bismarx-v1/GPS-Compass/_media/renders/GPS-Compass_assembly_plexi2.png

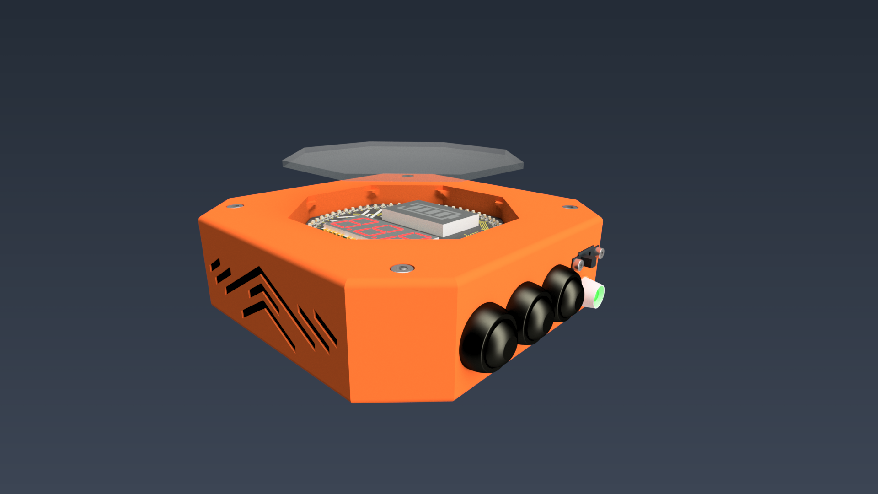
_media/renders/GPS-Compass_assembly_plexi2.png
