bismarx-v1/GPS-Compass/README.md

# GPS Compass
this compass points to a specific locations a user defines, it has two pointers, one for distance and another one for the specified locations
