bismarx-v1/GPS-Compass/_DMP/DMP - Popov.pptx

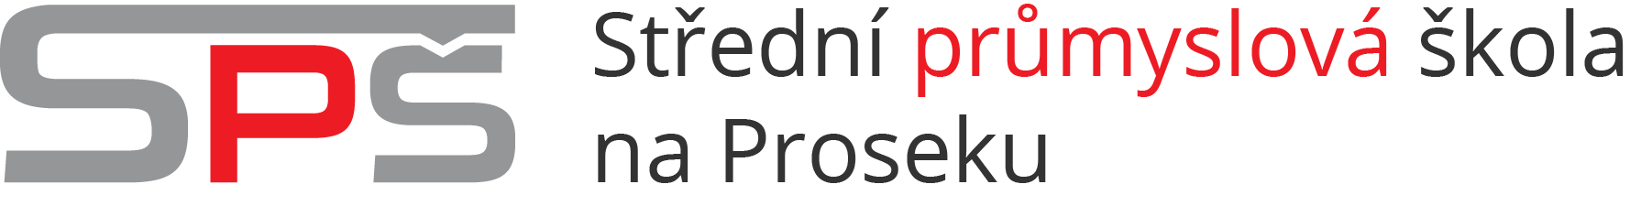
[picture p3: figure]
Obsah obrázku text, Písmo, snímek obrazovky, symbol Obsah vygenerovaný umělou inteligencí může být nesprávný.

NÁVRHY DLOUHODOBÉ MATURITNÍ PRÁCE

Savva Popov

## SEZNAM NÁVRHŮ

1. FINCA - Flight Integration and Navigation Control Architecture
2. GPS Tracker
3. Bearing pointer - Bound compasses
4. The Desire compass
5. SPGA – Self Playing Guitar and Amplifier
6. Protogen Visor
7. LIDAR Scanner

## 1. FINCA - Flight Integration and Navigation Control Architecture

- Flight Control Computer - letový řídicí počítač (Rozpracovaný návrh)
- Hlavní funkce:
- Stabilizace letu: Měření dát z gyroskopu, akcelerometru a podle toho upravuje výstupný signál na motorech
- Zpracovaní dat od pilota (Remote control)
- Komunikace s pilotem/ground station, posílání dát zpět – telemetrie

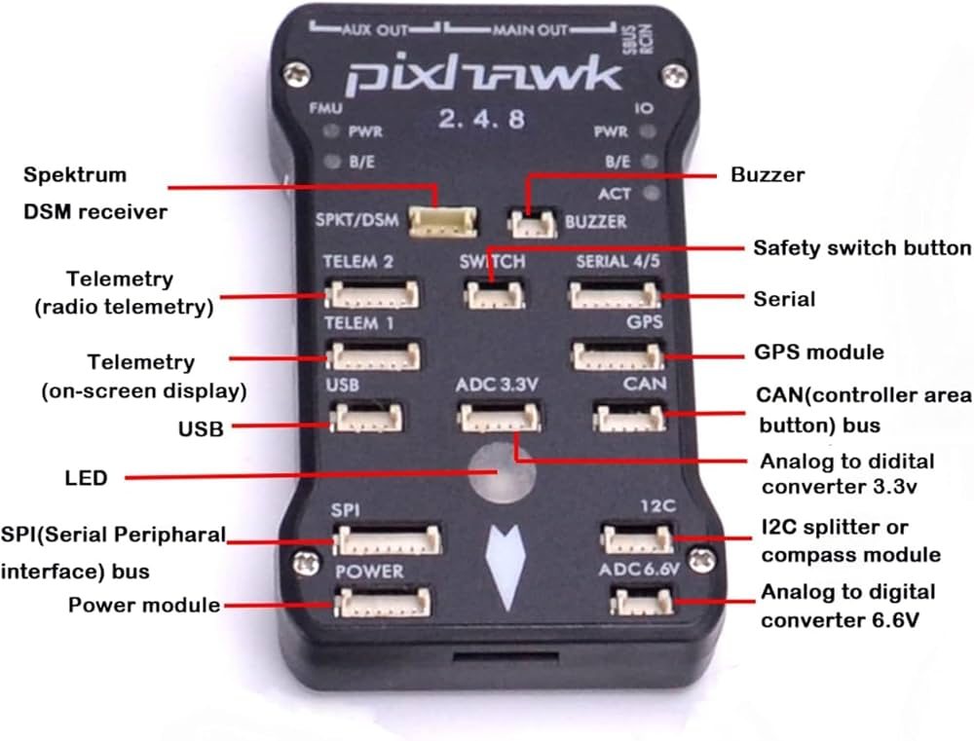
[picture p4: figure]
Technotrade Pixhawk 2.4.8 Drone Flight Controller PX4 32 Bit Autopilot Flight Control Board : Amazon.in: Industrial & Scientific
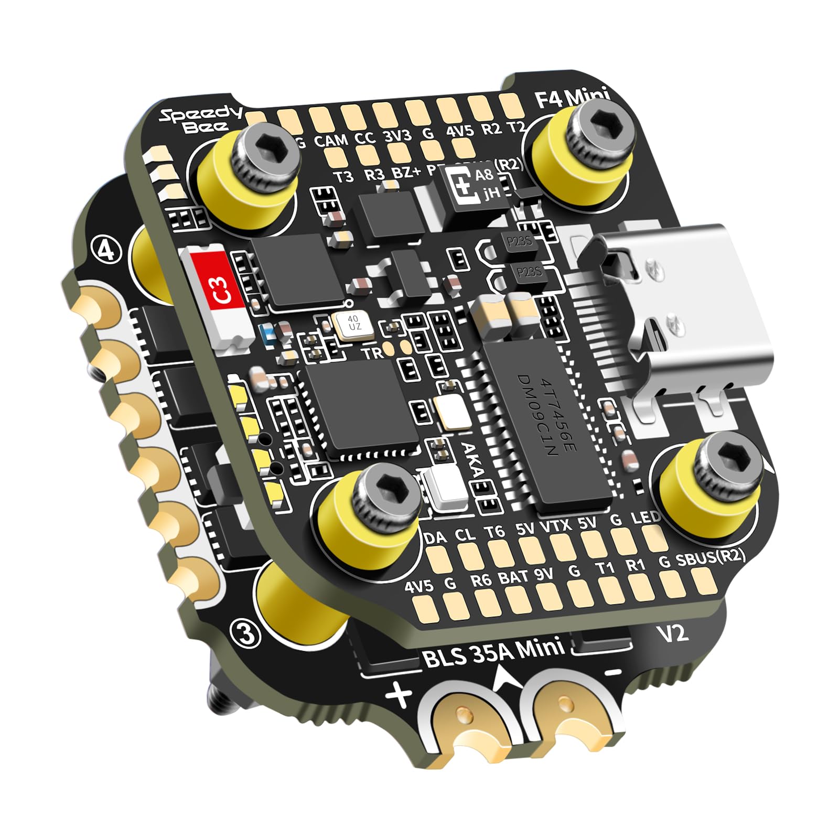
[picture p5: figure]
SpeedyBee F405 Mini Flight Controller Stack, 20x20mm, APP Control, Bluetooth Built-in, 35A 4-in-1 BLHeliS ESC Board, Compatible with DJI Air Unit FPV ...

Obtížnost:

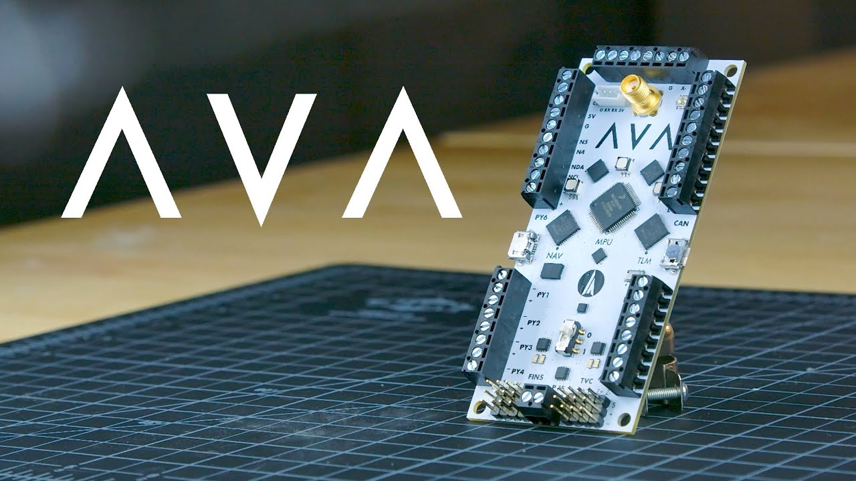
[picture p6: figure]
The AVA Flight Computer

## 2. GPS Tracker

- GPS Mapový sledovač
- Hlavní funkce:
- Živy output dát, zobrazení aktuální polohy na mapě
- Low power (vysoka výdržnost baterie)
- Voděodolnost a robustní krytí pro použiti ve venkovním prostředí
- Další možné funkce: Notifikace při opuštění oblasti, záznam trasy pohybu

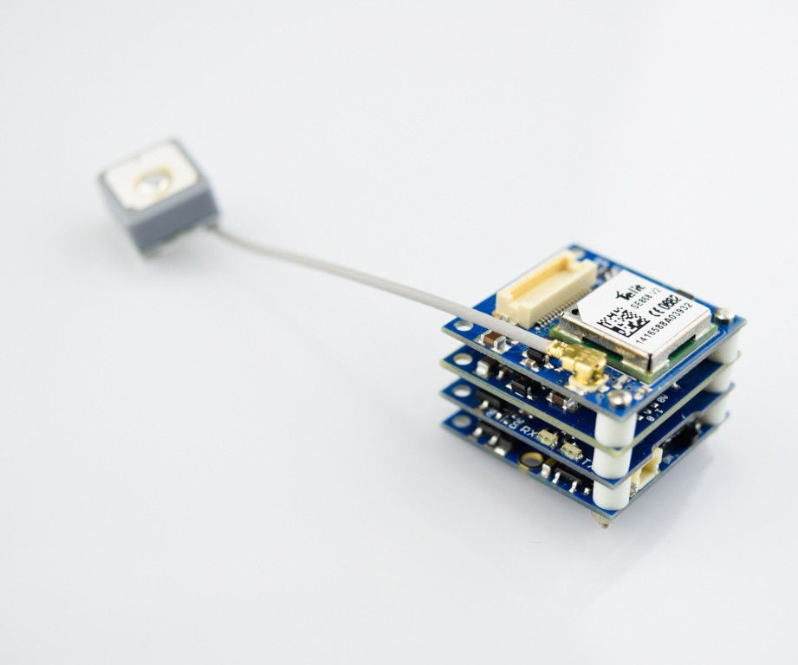
[picture p7: figure]
Tiny GPS Tracker : 8 Steps - Instructables
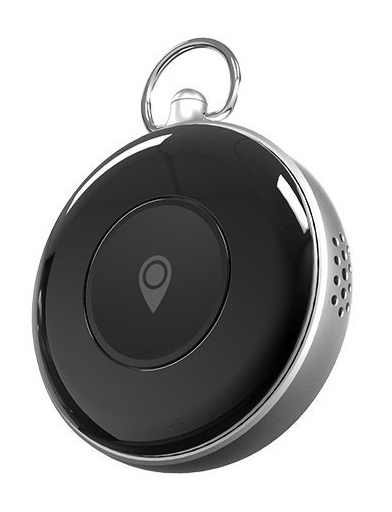
[picture p8: figure]
GPS Tracker S02 Black - sledovací zařízení mobilní | VARNET
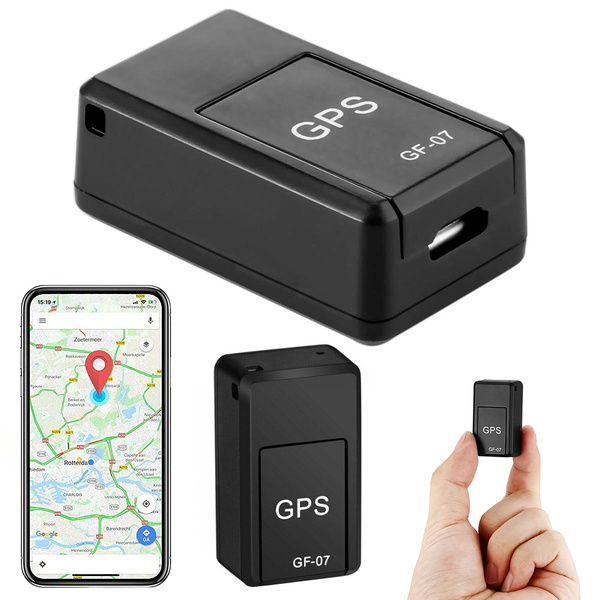
[picture p9: figure]
Mini locator gps tracker eavesdropping hidden sim | CATEGORIES \ Automotive \ Others | verk.store

Obtížnost:

## 3. Bearing pointer – Bound compasses

- Dvojice kompasu s GPS, které ukazují směr k sobě navzájem.
- Hlavní funkce:
- Low power
- Směrová navigace mezi dvěma body - GPS
- Možnosti komunikace: Cellular, Long-Range Radio, Internet connection

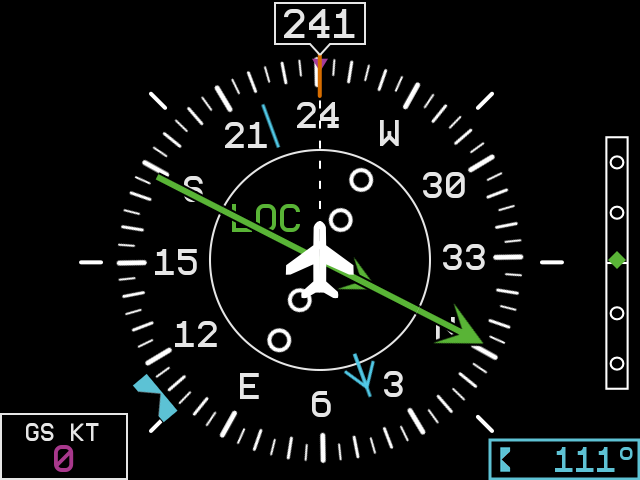
[picture p10: figure]
G5 User Guide (Archive) – AFM Simulation
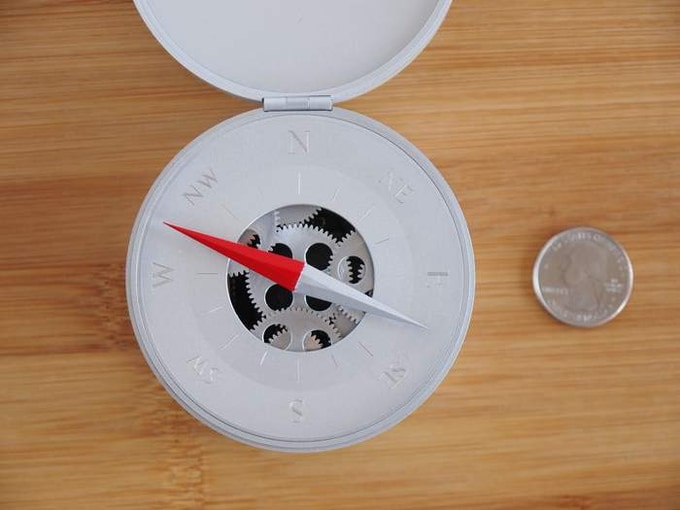
[picture p11: figure]

Obtížnost:

## 4. Pivní kompas - Desire Compass

- Kompas který ukazuje na to co chcete nejvíc
- Hlavní funkce:
- Low power
- GPS navigace
- Robustní konstrukce pro venkovní použiti
- Možnost přidáni databází „bodů“ např: Pražské hospody
- Vedlejší funkce: možnost mít propojeni s API online map – živé aktualizovaní a zadávání bodů

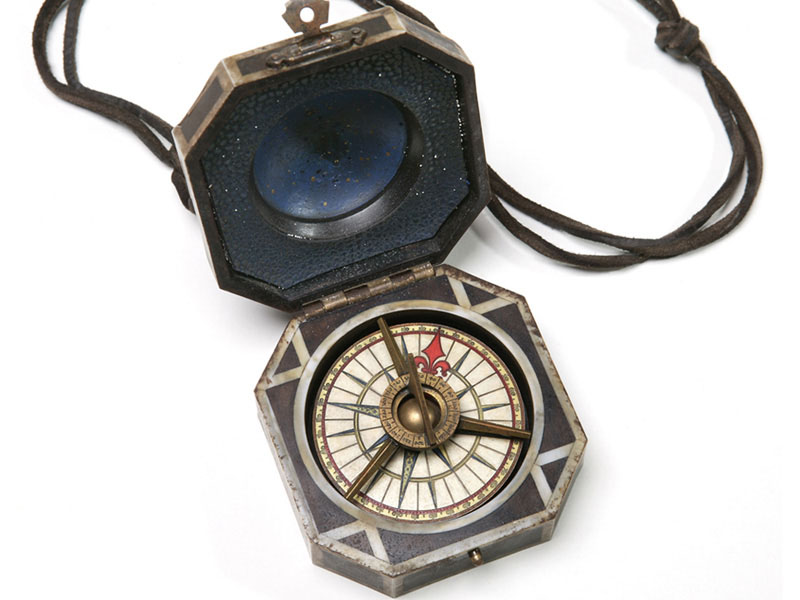
[picture p12: figure]
Jack Sparrow's compass | Pirates of the Caribbean Wiki | Fandom
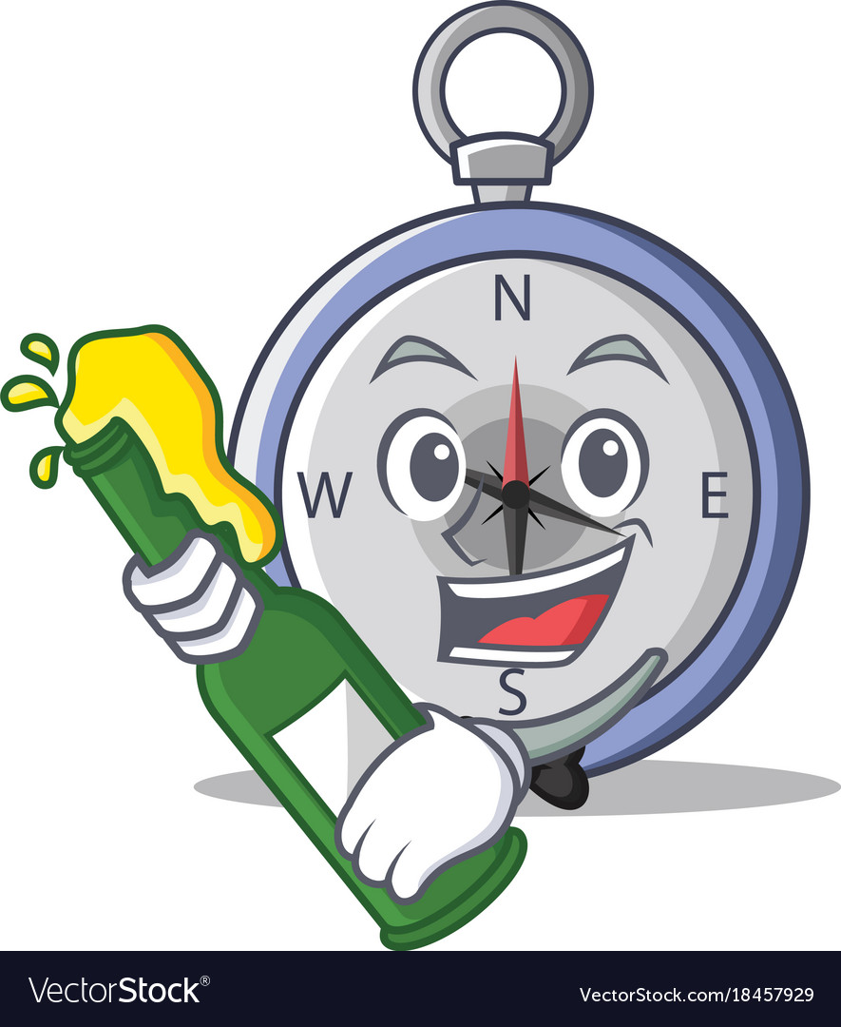
[picture p13: figure]
With beer compass character cartoon style Vector Image

Obtížnost:

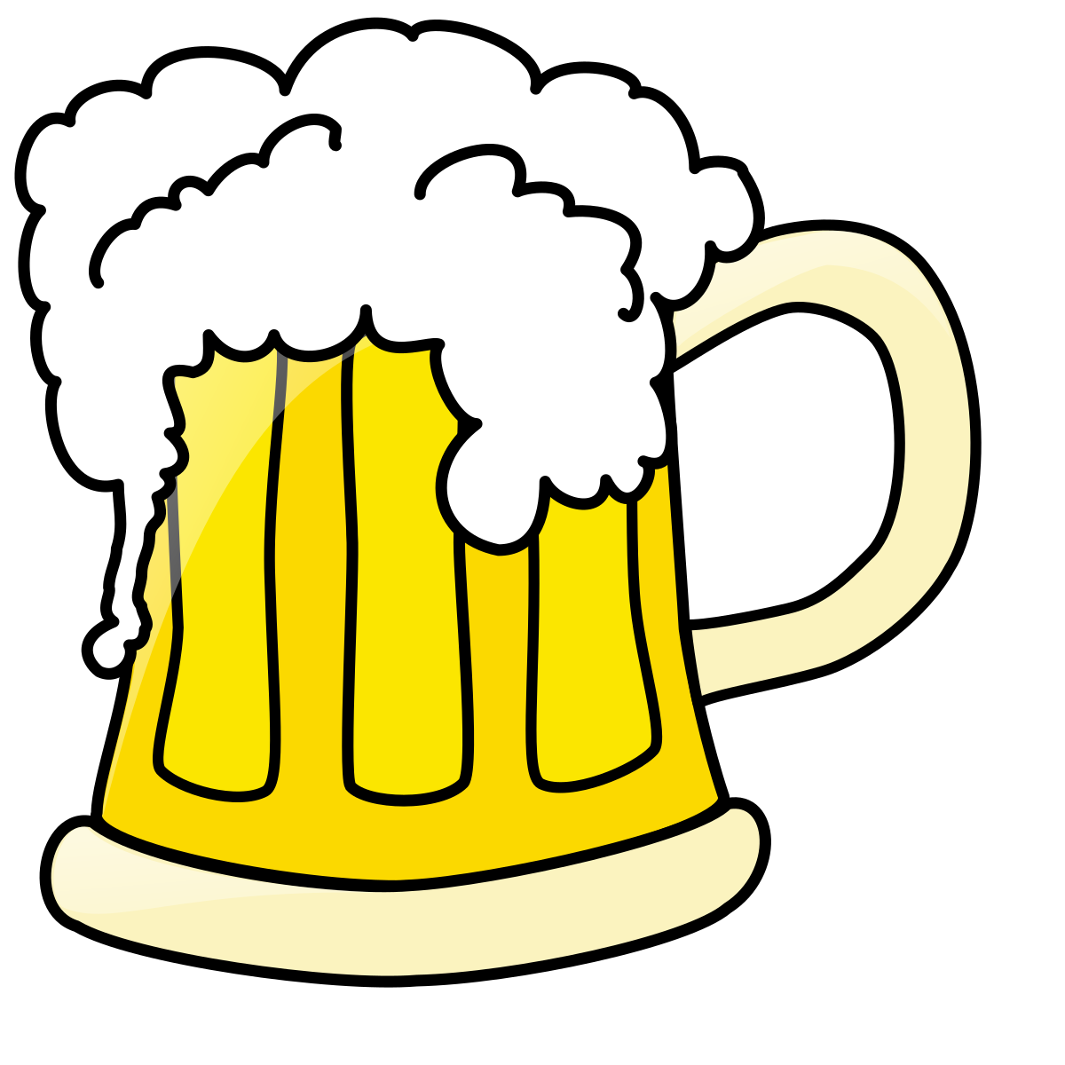
[picture p14: figure]
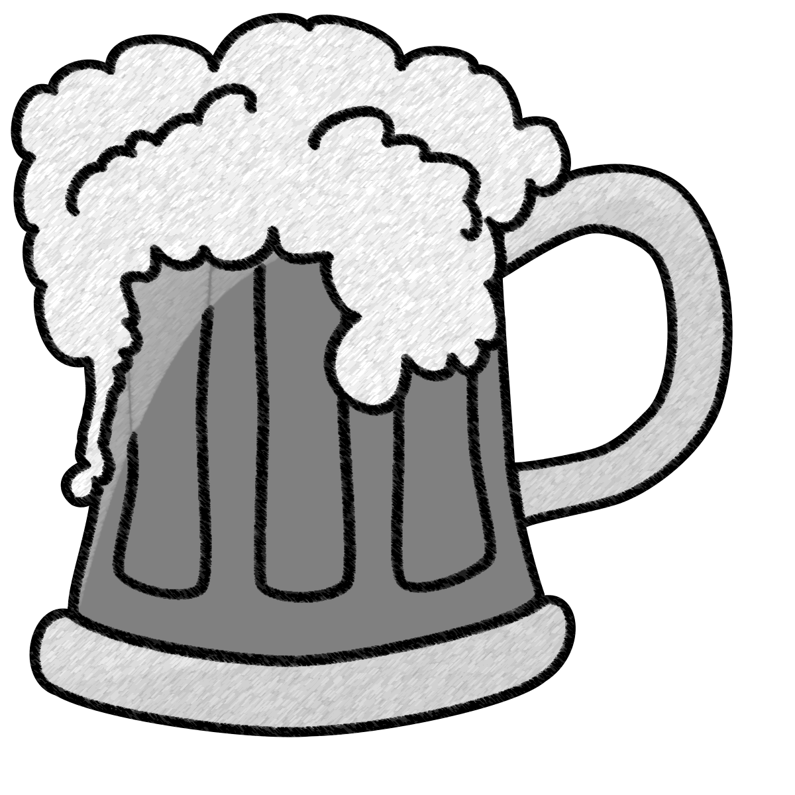
[picture p15: figure]

## 5. SPGA / SPG

- Samo hrající kytara (rozpracovaný návrh)
- Hlavní funkce:
- Ovládání 18ti pražců a 6ti strun
- Přehrávaní MIDI souborů
- Pražce: solenoidy, struny: servo-motory
- Zesilovač je vedlejší funkce která se může nacházet v stejné krabičce

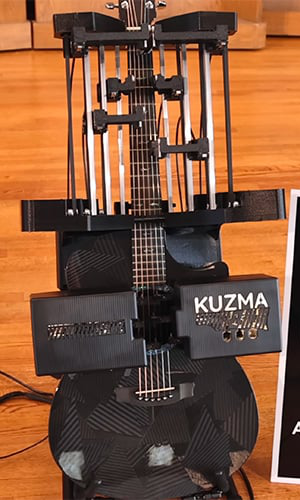
[picture p16: figure]
This Self-playing Guitar Proves Robots Will Never Replace Human Musicians
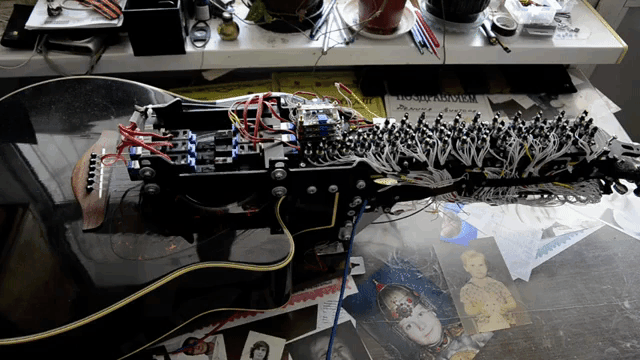
[picture p17: figure]
An Incredible Acoustic Guitar Self-Playing Robot

Obtížnost:

## 6. Protogen visor

- Dekorativní visor pro cosplay
- Hlavní funkce:
- Ovládaní několika RGB displejů
- Konstrukce s poloviční průhlednosti
- Vnitřní větrání
- Estetika je důležitým faktorem

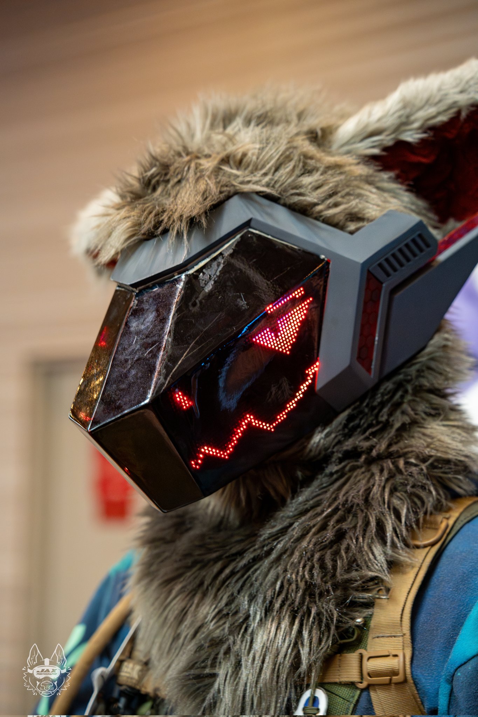
[picture p18: figure]
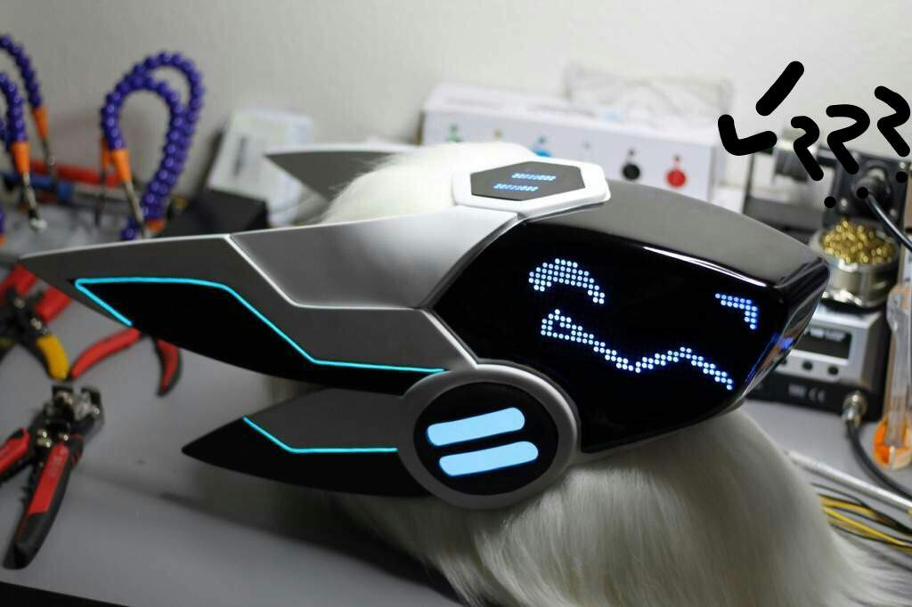
[picture p19: figure]
protogen fursuit visor - Hi Tech Services
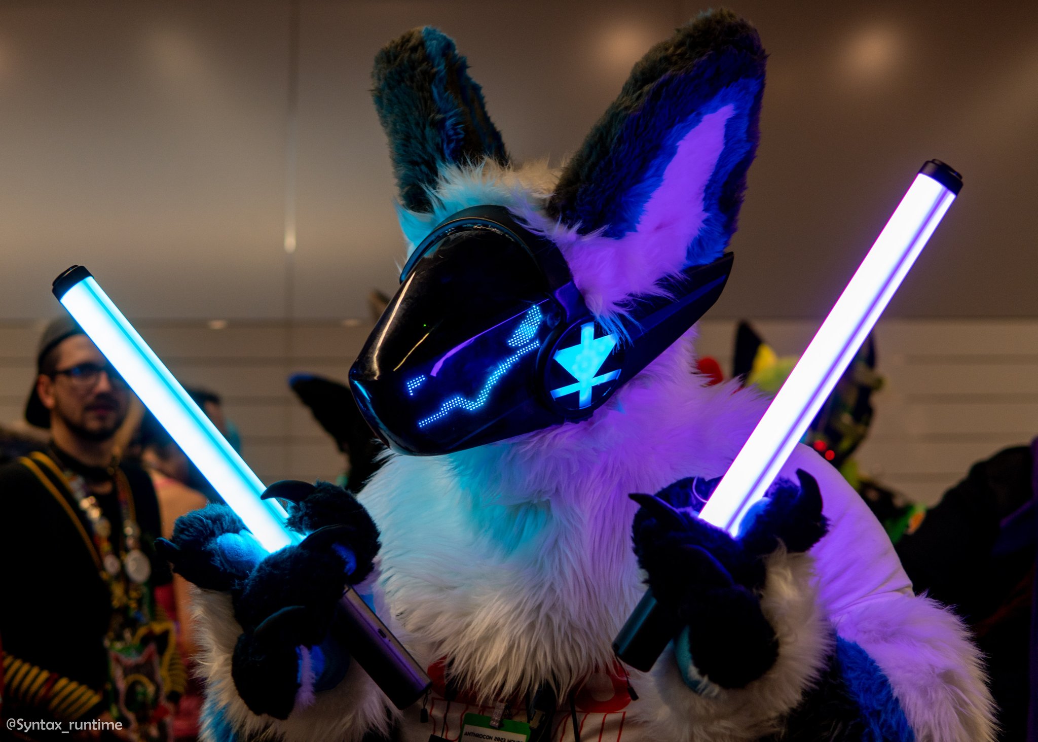
[picture p20: figure]

Obtížnost:

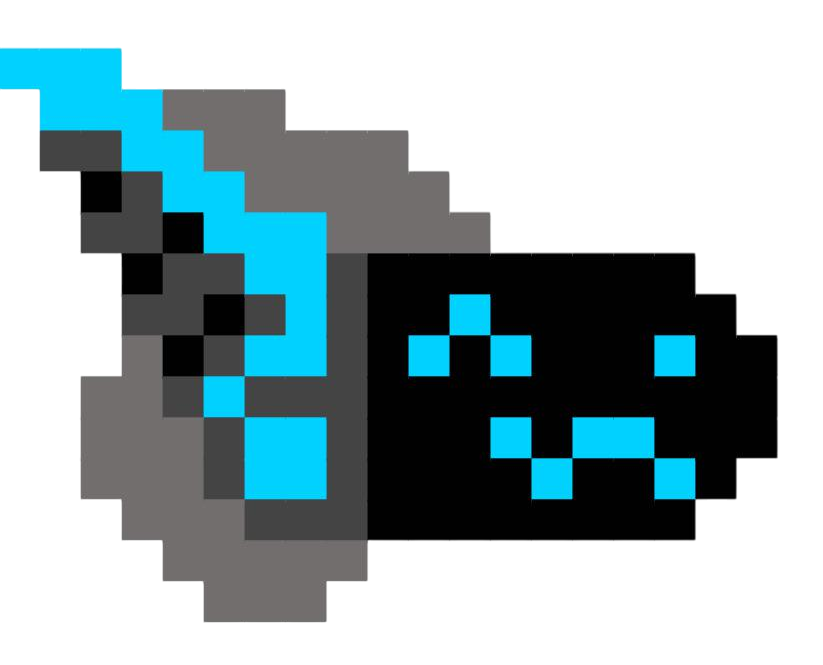
[picture p21: figure]
Obsah obrázku pixel, snímek obrazovky, Grafika Obsah generovaný pomocí AI může být nesprávný.
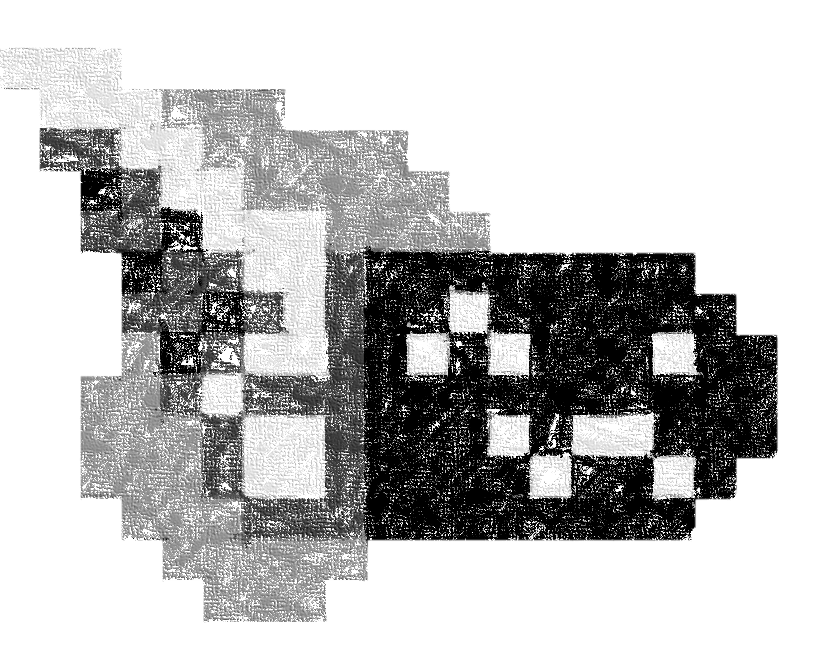
[picture p22: figure]
Obsah obrázku pixel, snímek obrazovky, Grafika Obsah generovaný pomocí AI může být nesprávný.

## 7. LIDAR

- Jednoduchý prostorový "skener" na principu LIDAR
- Hlavní funkce:
- Rotující laserový senzor
- Output dat v I2C formátů
- Vykreslení bodů

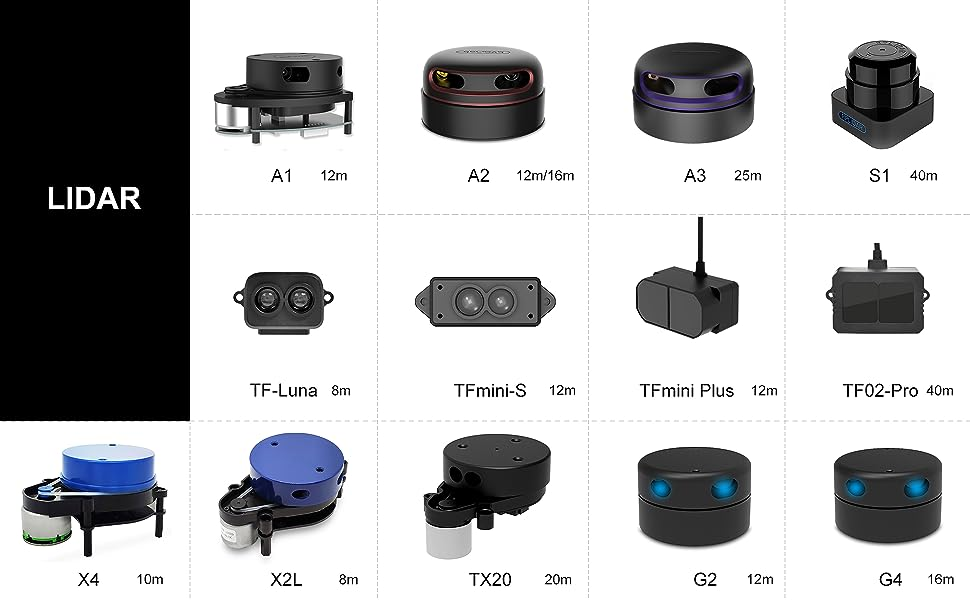
[picture p23: figure]
TF-Luna ToF LiDAR Module - 8 Meters Distance Sensor
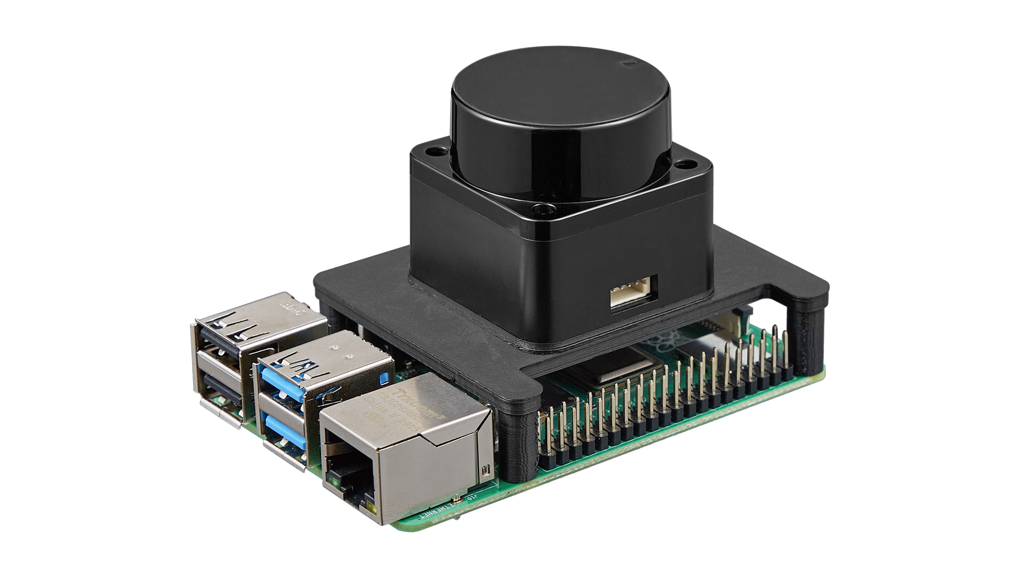
[picture p24: figure]
klasifikace: Vývojová sada for LiDAR_LD06, pro použití s: Raspberry Pi SBC Lidar Module with Bracket 54.010012, Okdo

Obtížnost:
