bismarx-v1/GPS-Compass/_DMP/DPS_dokumentace.docx

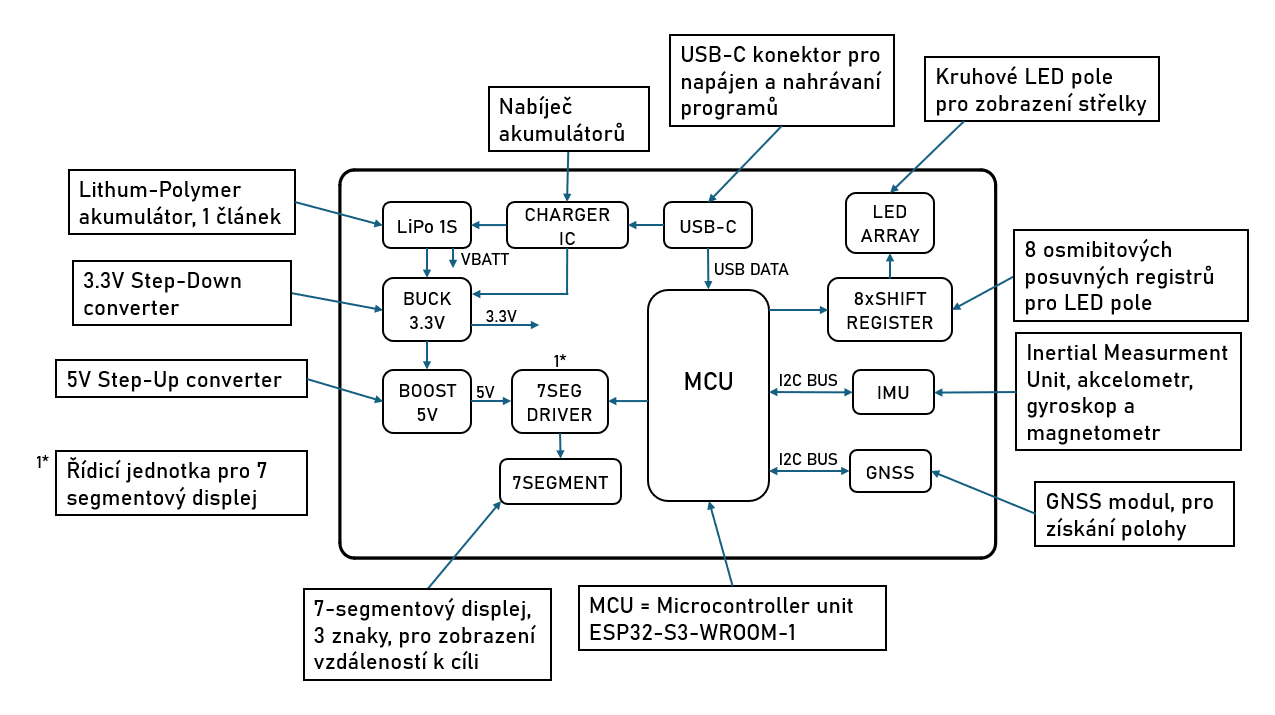
[picture p25: figure]
Obsah obrázku text, diagram, Plán, Písmo Obsah generovaný pomocí AI může být nesprávný.

GPS Compass

GPS Compass obsahuje 4 PCB, dělí se na: hlavní ovládací PCB, PCB s GNSS modul,
