bismarx-v1/GPS-Compass/_DMP/popovsa22_dmp_rev2.pptx

Obsah obrázku text, Písmo, snímek obrazovky, symbol Obsah vygenerovaný umělou inteligencí může být nesprávný.
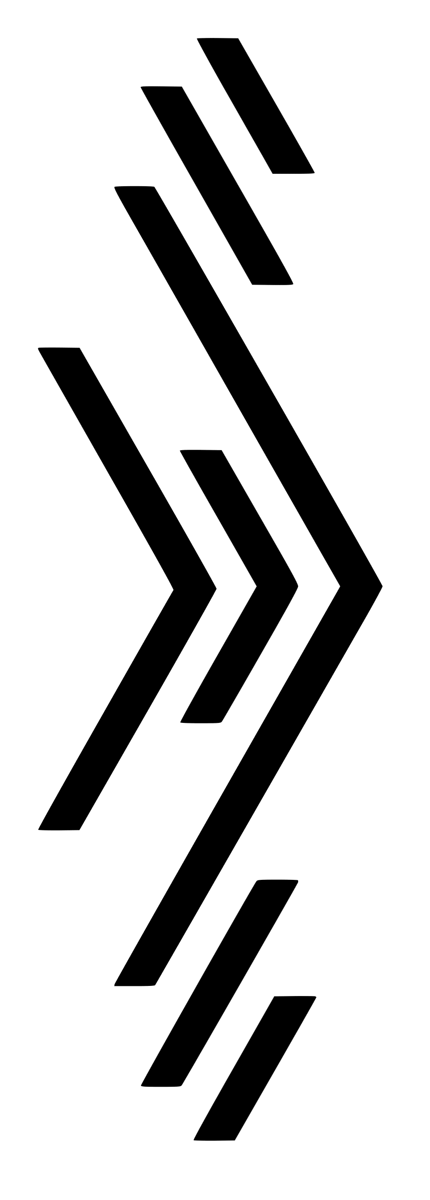
[picture p26: figure]

Souřadnicový Kompas
Průběžná realizace

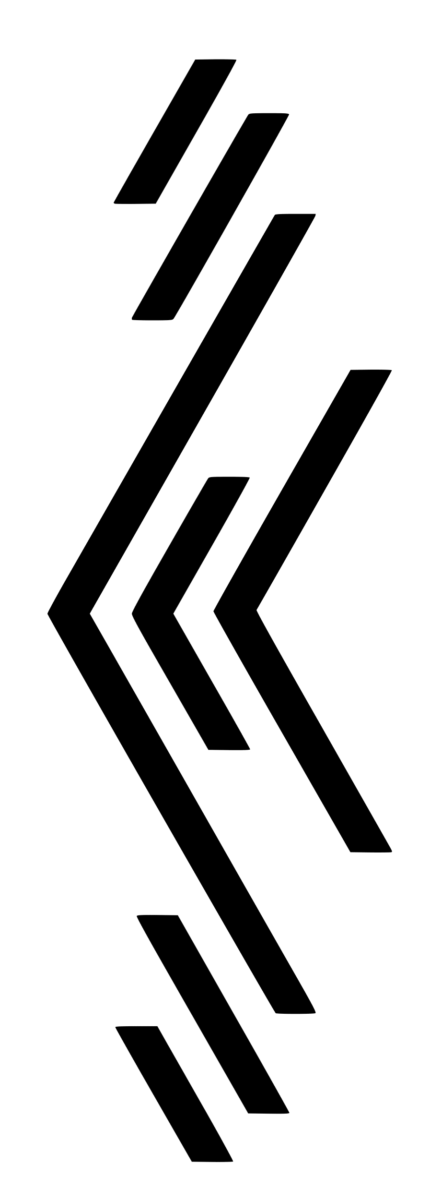
[picture p27: figure]
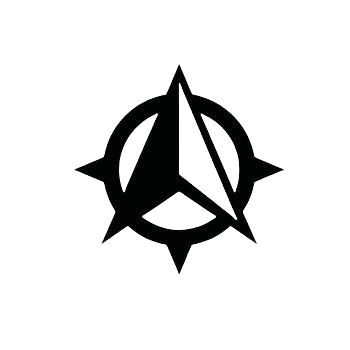
[picture p28: figure]
Obsah obrázku kresba, skica, umění, hvězda Obsah generovaný pomocí AI může být nesprávný.

Savva Popov
Vedoucí práce: Ing. Jaroslav Bušek Ph.D.

## KONSTRUKCE - REALIZACE

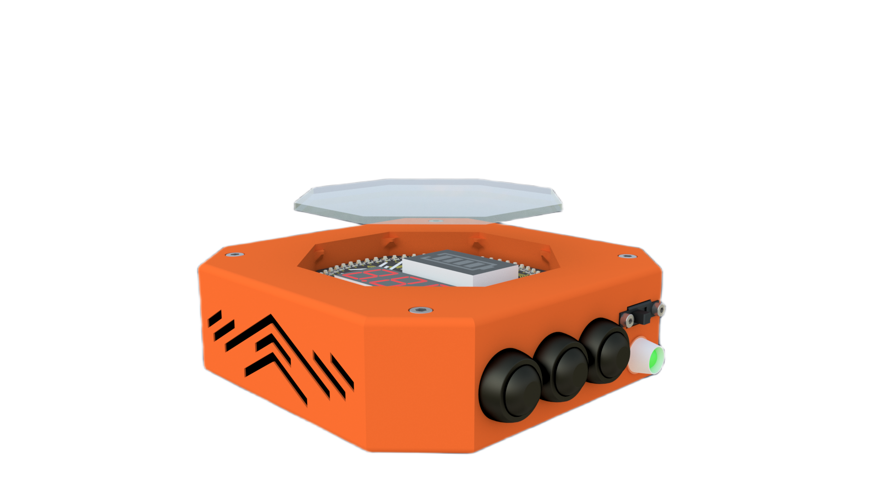
[picture p29: figure]
Obsah obrázku auto, oranžová Obsah generovaný pomocí AI může být nesprávný.

1

- Hotový 3D model
- Připravený filament
- Připravené venkovní materiály: USB-C záklopka, tlačítka, spínač, kontrolky
- Připravený spojovací materiál

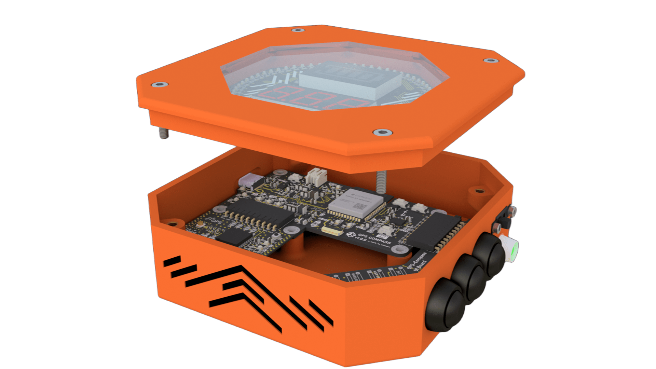
[picture p30: figure]
Obsah obrázku Autodíly, kolo, hračka, Autíčka/letadýlka Obsah generovaný pomocí AI může být nesprávný.
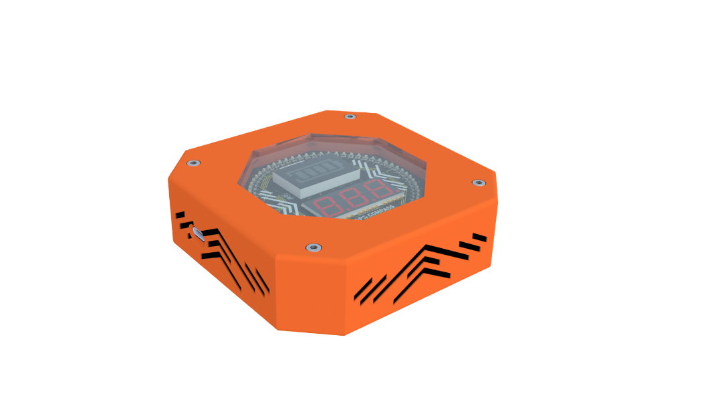
[picture p31: figure]
Obsah obrázku oranžová Obsah generovaný pomocí AI může být nesprávný.

## KONSTRUKCE - REALIZACE

2

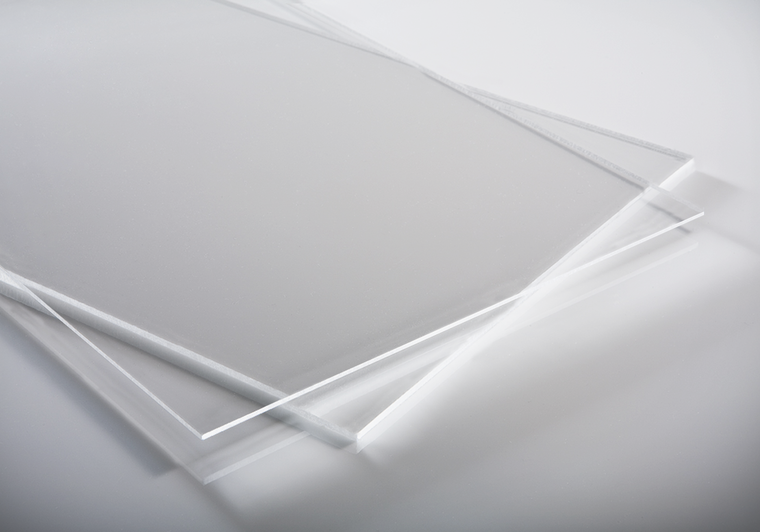
[picture p32: figure]
Plexisklo čiré 2 mm PLEXIGLAS® XT

JE POTŘEBA:
1. Objednat plexisklo
2. Vytisknout finální model
3. Zakomponovat QR kód na Webserver
4. Zjistit zda-li všechno sedí

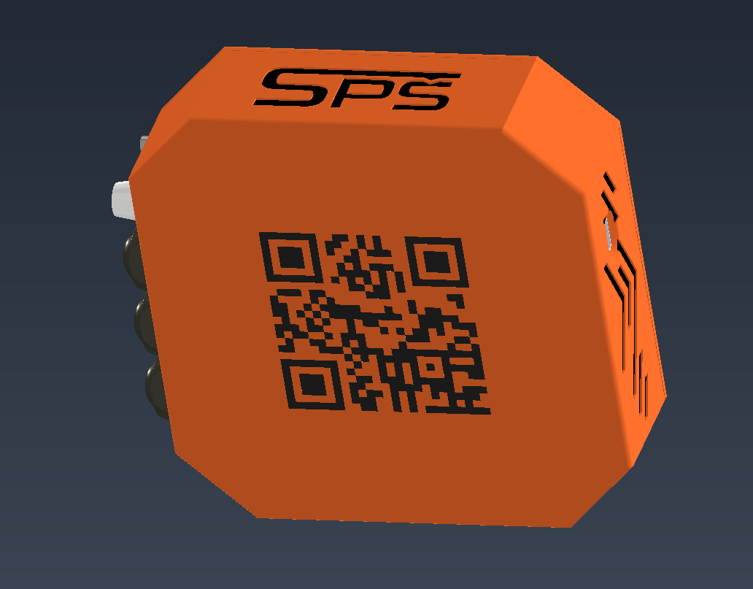
[picture p33: figure]
Obsah obrázku text, design Obsah generovaný pomocí AI může být nesprávný.

## PCB - REALIZACE

- Osazeny hlavní PCB (kromě IMU)
- Nabíjení funguje
- DC-DC zdroje jsou funkční (až na jednu výjimku)
- Blink na ESP funguje
- Osazeny UI PCB a Střelka PCB je v procesu osazení
- Všechny součástky dorazili (skoro)

3

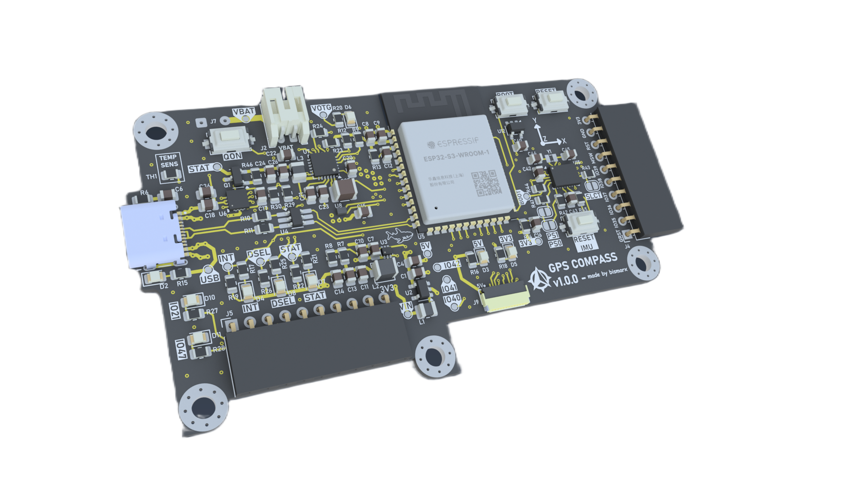
[picture p34: figure]
Obsah obrázku Elektronická součástka, Elektronické inženýrství, Obvodoví součástka, elektronika Obsah generovaný pomocí AI může být nesprávný.

## PCB - REALIZACE

PROBLÉMY:
1. DC-DC 3v3 zdroj brown-out
2. IMU a LNA na LCSC
3. Nejistota osazených součástek BGA/QFN pouzdra
4. Chyby v potisku
5. Akumulátor má konektor JST-XH

4

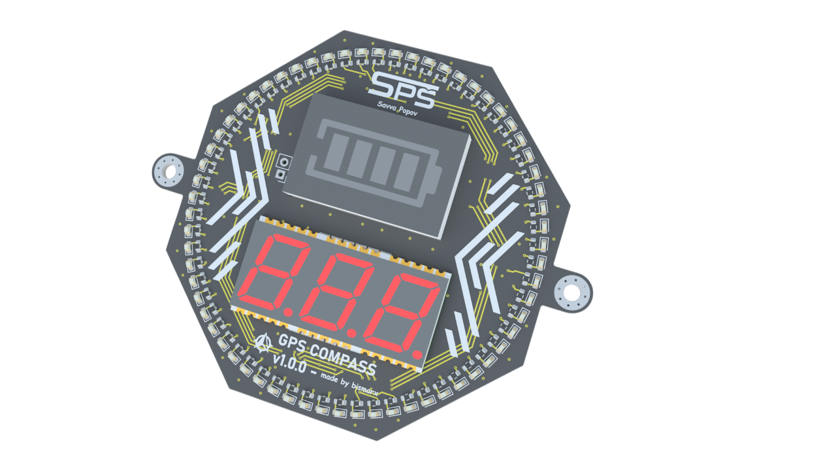
[picture p35: figure]
Obsah obrázku kruh, logo, emblém, Obchodní značka Obsah generovaný pomocí AI může být nesprávný.
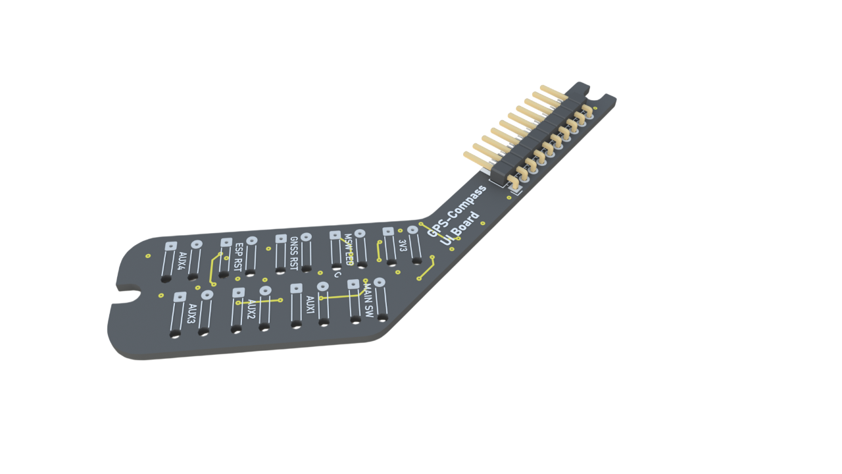
[picture p36: figure]
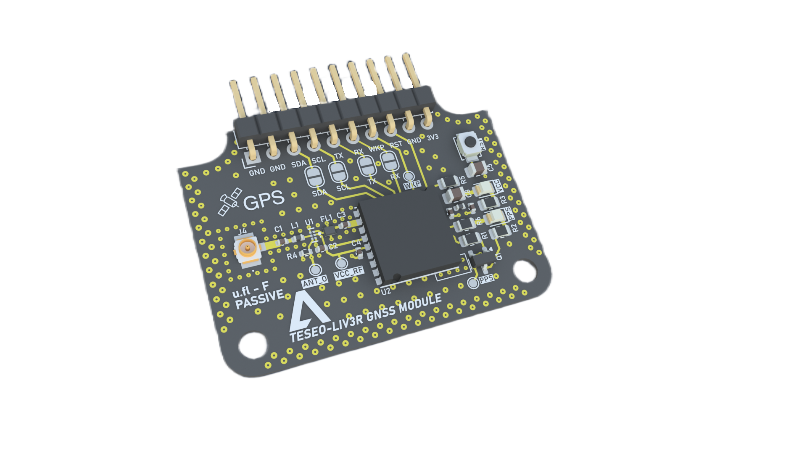
[picture p37: figure]
Obsah obrázku Elektronická součástka, Obvodoví součástka, Elektronické inženýrství, elektronika Obsah generovaný pomocí AI může být nesprávný.

## PROGRAM - REALIZACE

- Hotová web stránka
- Program pro kalkulace vzdáleností a úhlu natočení
- 7 funkční zobrazení vzdálenosti
POTŘEBA DODĚLAT:
1. Spoustu věcí
SSID: GPS-Compass
Pass: bismarx123

5

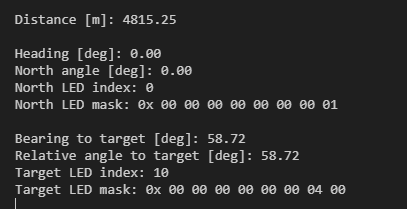
[picture p38: figure]
Obsah obrázku text, snímek obrazovky, Písmo Obsah generovaný pomocí AI může být nesprávný.
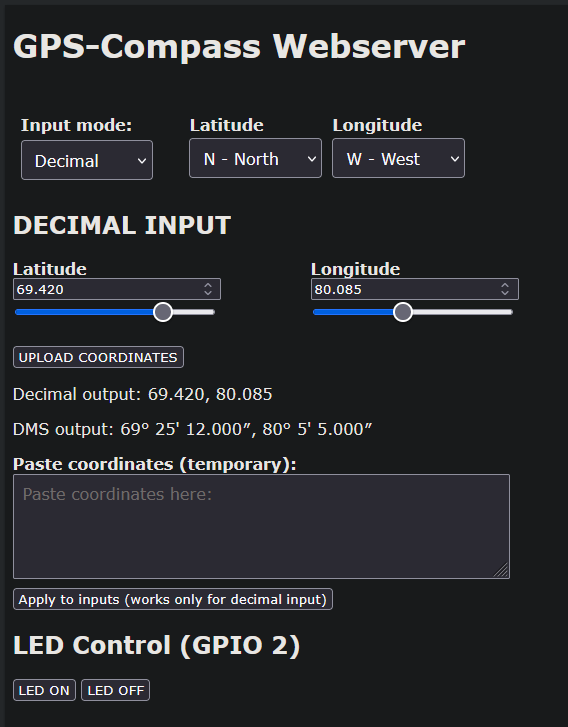
[picture p39: figure]
Obsah obrázku text, snímek obrazovky, software, Písmo Obsah generovaný pomocí AI může být nesprávný.
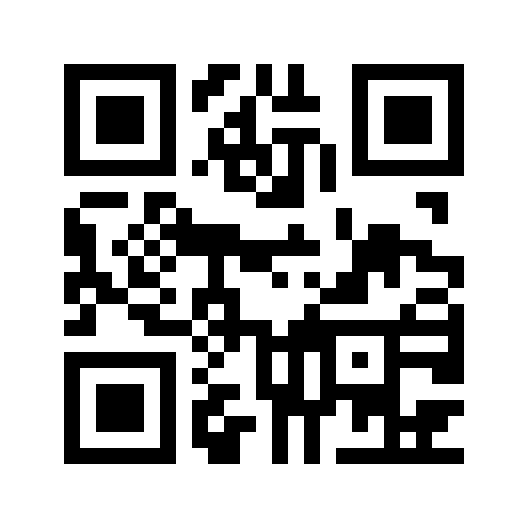
[picture p40: figure]
