bismarx-v1/GPS-Compass/docs/TESEO_docs/Teseo-Suite_SW_configuration.pdf

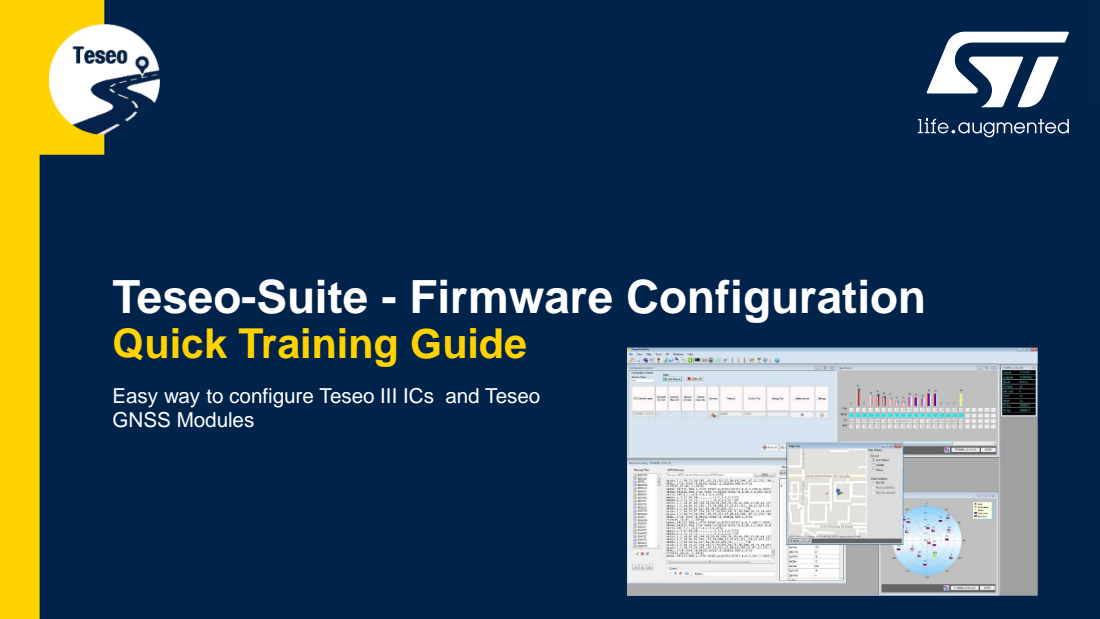
[picture p99: page 1]

Teseo-Suite - Firmware Configuration
Quick Training Guide

Easy way to configure Teseo III ICs and Teseo
GNSS Modules

# Contents

Introduction

Configuration Wizards

Advanced Configuration

Documents & related resources

1

4

3

2

# Contents

Introduction

Configuration Wizards

Advanced Configuration

Documents & related resources

1

4

3

2

### - Teseo-Suite is a powerful PC tool designed to manage, configure and evaluate the

performance of all features and functions ST's Teseo GNSS solutions.

### - Its configuration panel lets developers configure and evaluate all parameters of Teseo ICs and modules

### - Configuration panels can work on

- Connected devices during runtime using NMEA commands
- Off-line on a binary file stored on the PC

# Introduction

### - Each Teseo binary image or module firmware has a unique binary-ID (SW binary version); for each SW binary version, a specific xml-file-firmware-datamodel is available in Teseo-Suite

### - The Firmware-DataModel guarantees the correct view and field descriptions for each Teseo firmware solution (ICs and Modules)

# Firmware data-model

# Contents

Introduction

Configuration Wizards

Advanced Configuration

Documents & related resources

1

4

3

2

# Using the FW configuration wizards

### In the Teseo-Suite menu, select:

- Tools
- FW Configuration
- Wizards

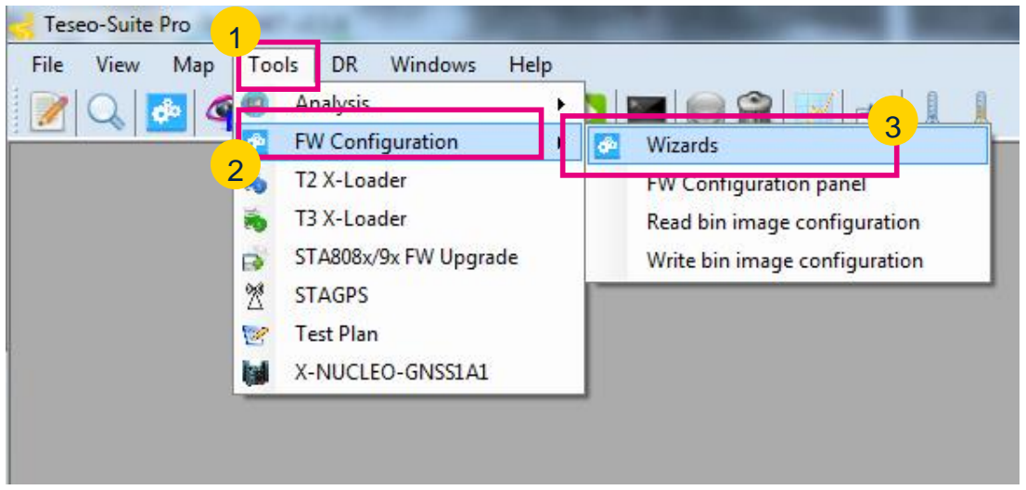
[picture p100: figure]

- When opening the Wizards, Teseo-Suite detects the connected device to load the SW binary version used to match the specific firmware-datamodel:
- If the SW binary version matches, all the device-configuration is read from the device and decoded to fill in all the parameter’s value
- If the SW binary version doesn’t match the xml file, an error message is displayed and the user must manually select an xml-file from the database

1

2

3

# FW wizard overview

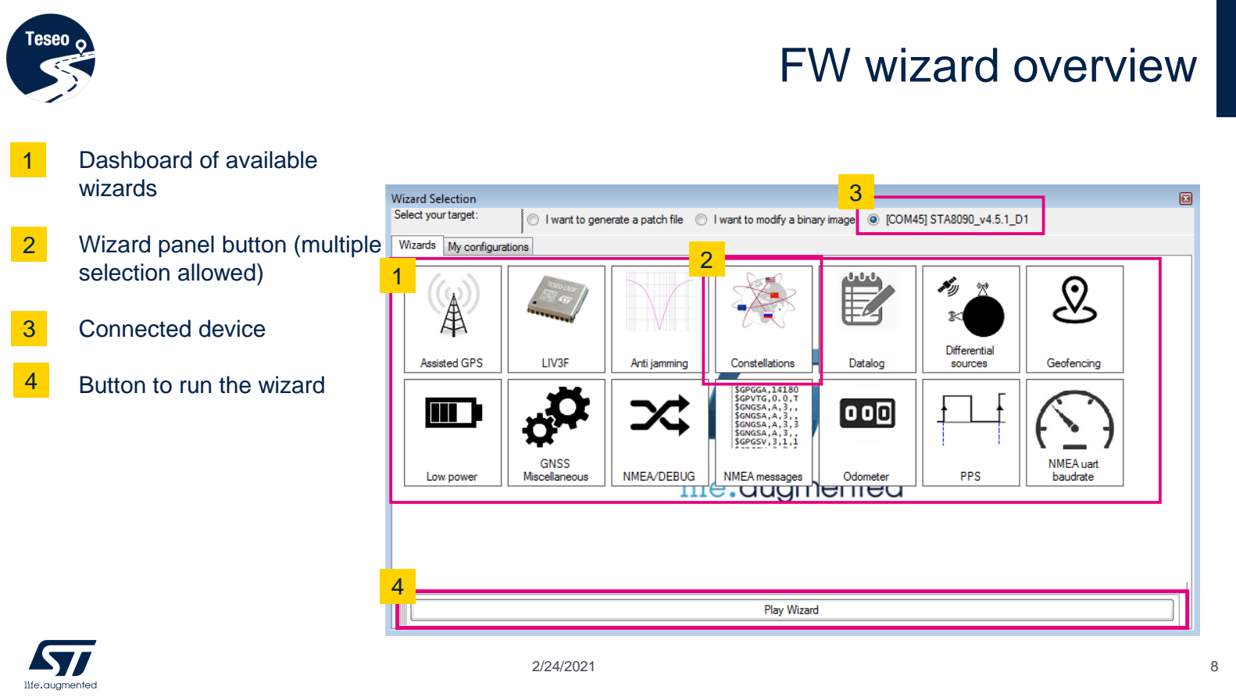
[picture p101: page 8]

Dashboard of available
wizards

Wizard panel button (multiple selection allowed)

Connected device

Button to run the wizard

2/24/2021 | 8

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
# FW wizard panels

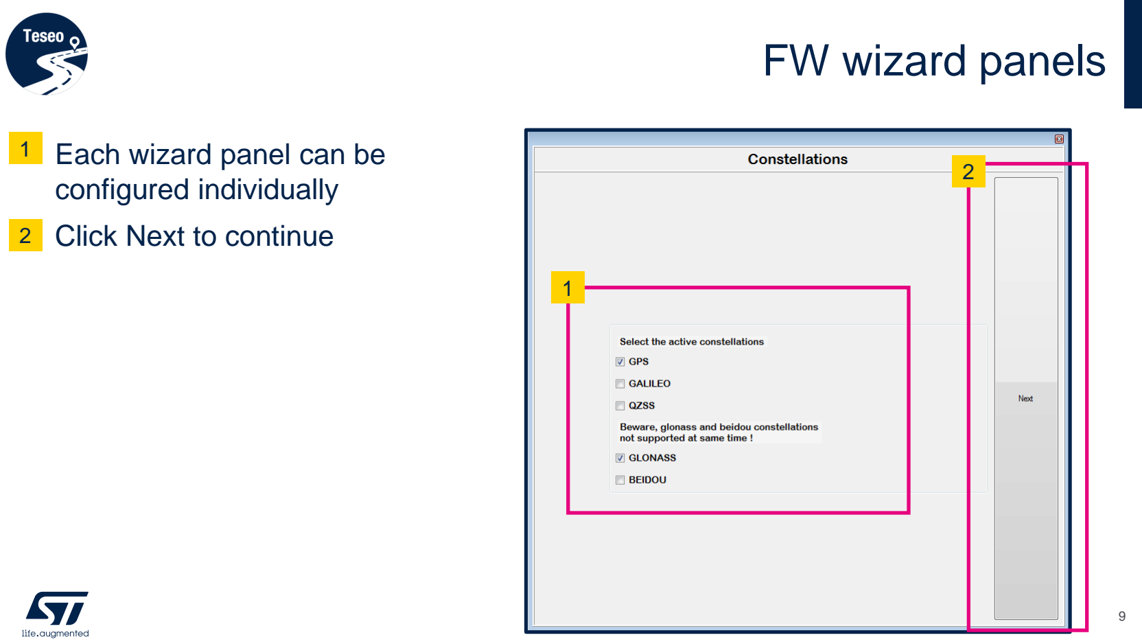
[picture p102: page 9]

### - Each wizard panel can be configured individually

### - Click Next to continue

1

2

1

2

# FW wizard configuration

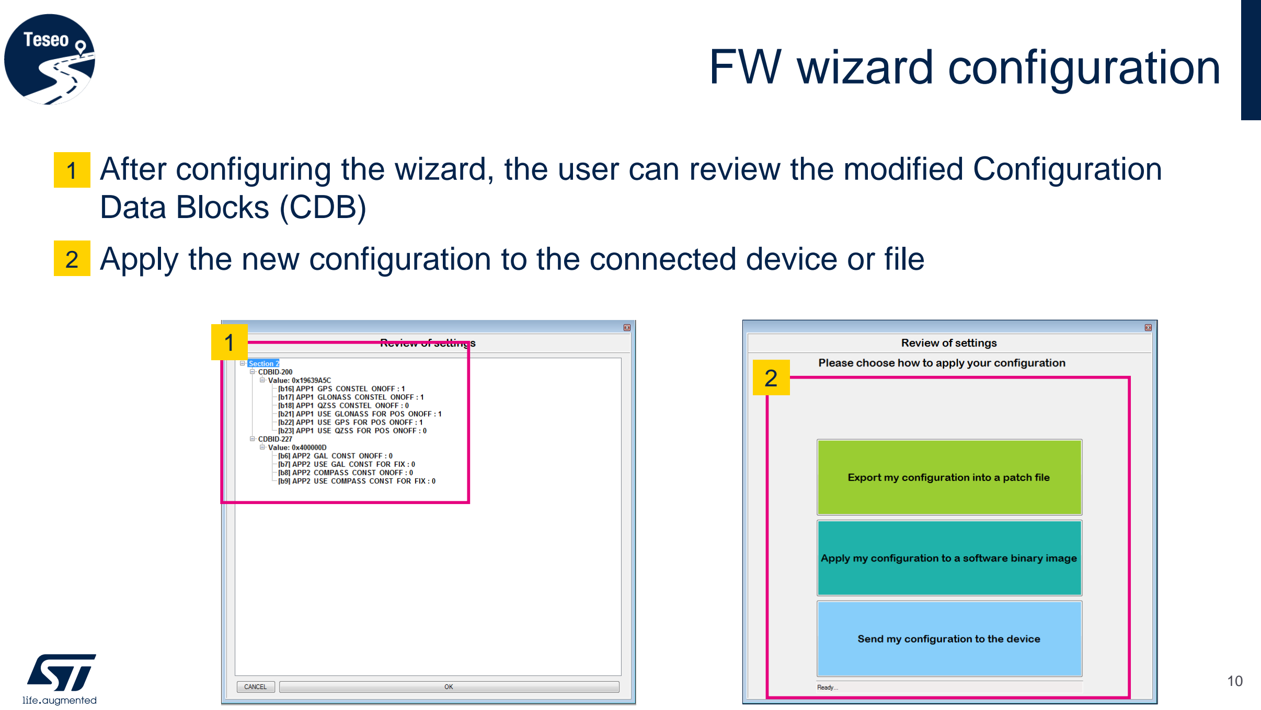
[picture p103: page 10]

### - After configuring the wizard, the user can review the modified Configuration Data Blocks (CDB)

### - Apply the new configuration to the connected device or file

1

2

1
2

# Contents

Introduction

Configuration Wizards

Advanced Configuration

Documents & related resources

1

4

3

2

# Using the FW configuration panel

### In the Teseo-Suite menu, select:

- Tools
- FW Configuration
- FW Configuration panel

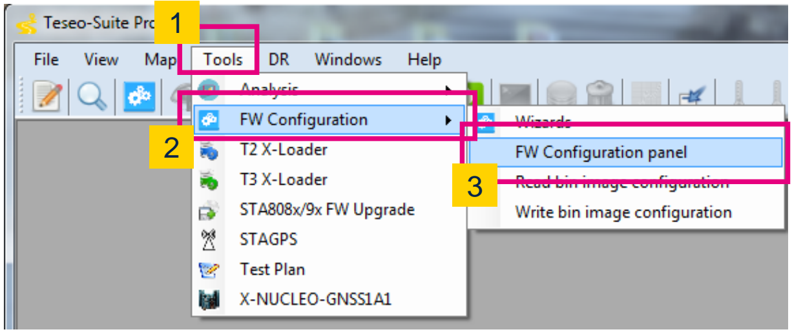
[picture p104: figure]

- When opening the FW Configuration panel, Teseo-Suite detects the connected device to load the SW binary version used to match the specific firmware-datamodel:
- If the SW binary version matches, all the device-configuration is read from the device and decoded to fill in all the parameter’s value
- If the SW binary version doesn’t match the xml file, an error message is displayed and the user must manually select an xml-file from the database

1

2

3

# FW configuration panel overview

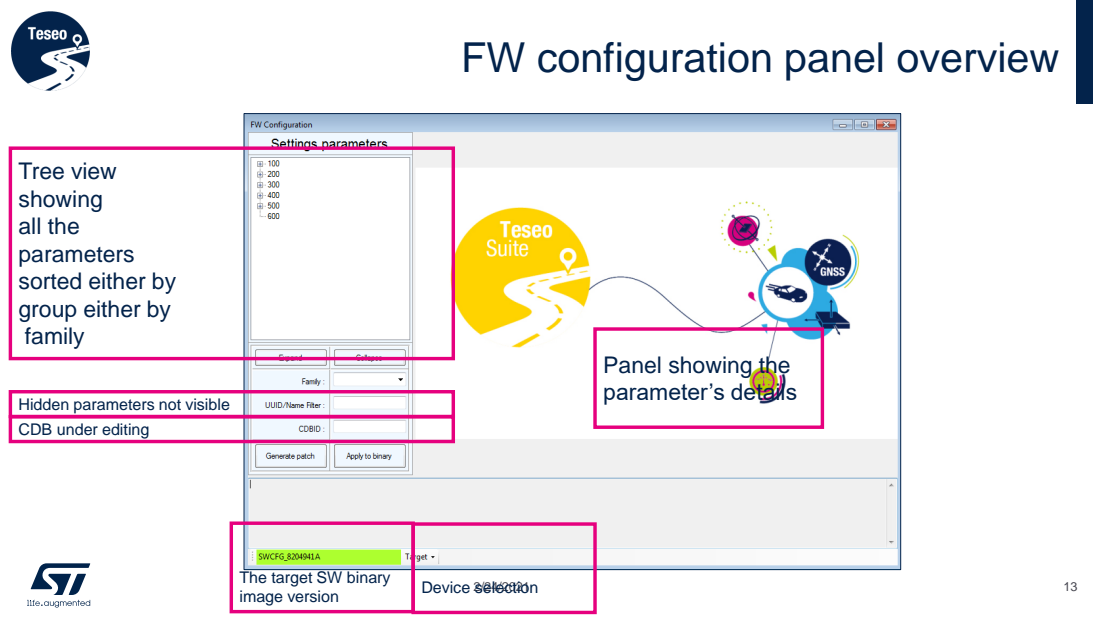
[picture p105: page 13]
image version; Device selection

Tree view
showing
all the
parameters
sorted either by
group either by
family

Panel showing the
parameter’s details

Hidden parameters not visible
CDB under editing

The target SW binary

# Modify the configuration [1/2]

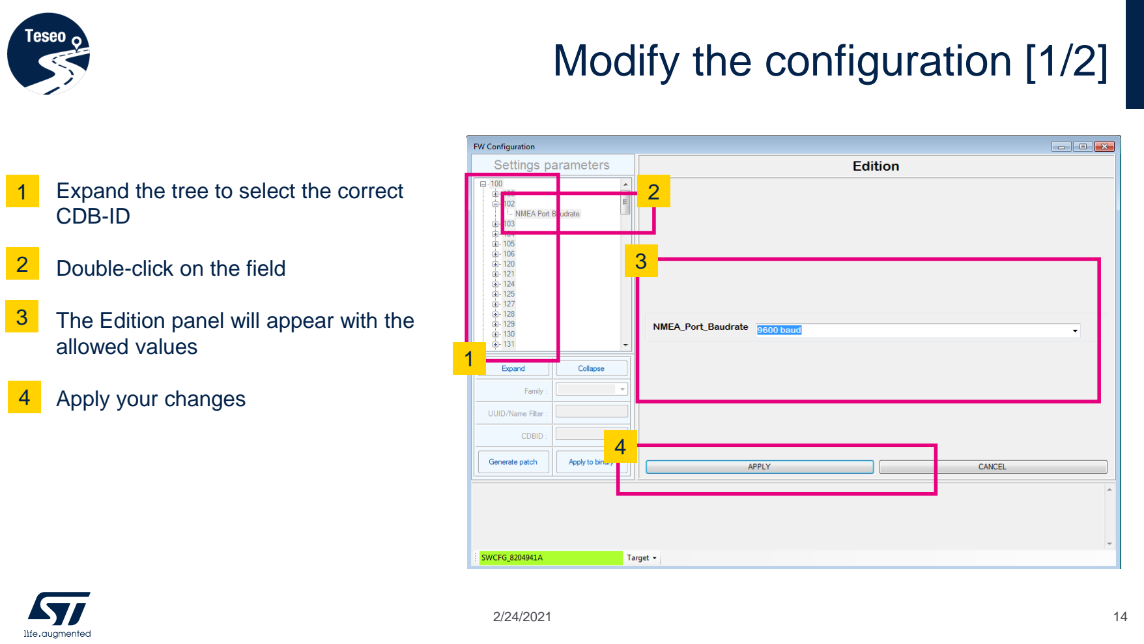
[picture p106: page 14]

Expand the tree to select the correct CDB-ID

Double-click on the field

The Edition panel will appear with the allowed values

Apply your changes

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
# Modify the configuration [2/2]

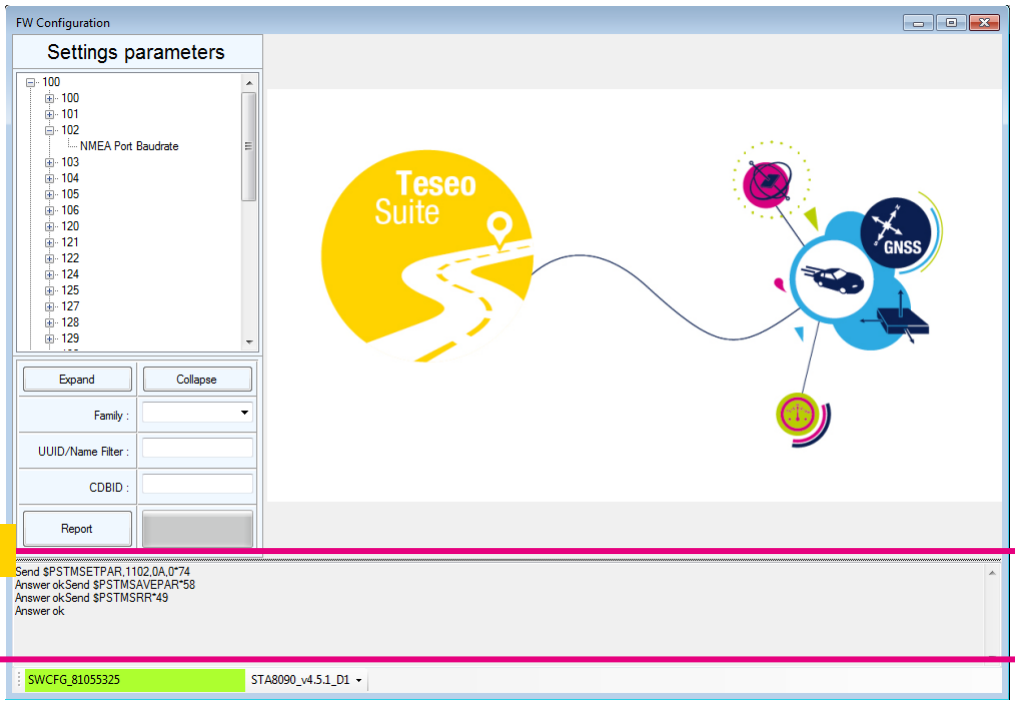
[picture p107: figure]

In the log panel, you can highlight the NMEA replies to the Teseo commands to modify the
configuration

1

1

# Contents

Introduction

Configuration Wizards

Advanced Configuration

Documents & related resources

1

4

3

2

- Teseo ICs: Webpage (http://www.st.com/content/st_com/en/products/positioning/gnss-ics.html?querycriteria=productId=SC2194)
- Product datasheets
- Teseo Modules: Webpage (https://www.st.com/content/st_com/en/products/positioning/gnss-modules.html)
- Product datasheets
- Teseo-Suite: Webpage (http://www.st.com/content/st_com/en/products/embedded-software/automotive-infotainment-and-telematics-software/teseo-suite.html)

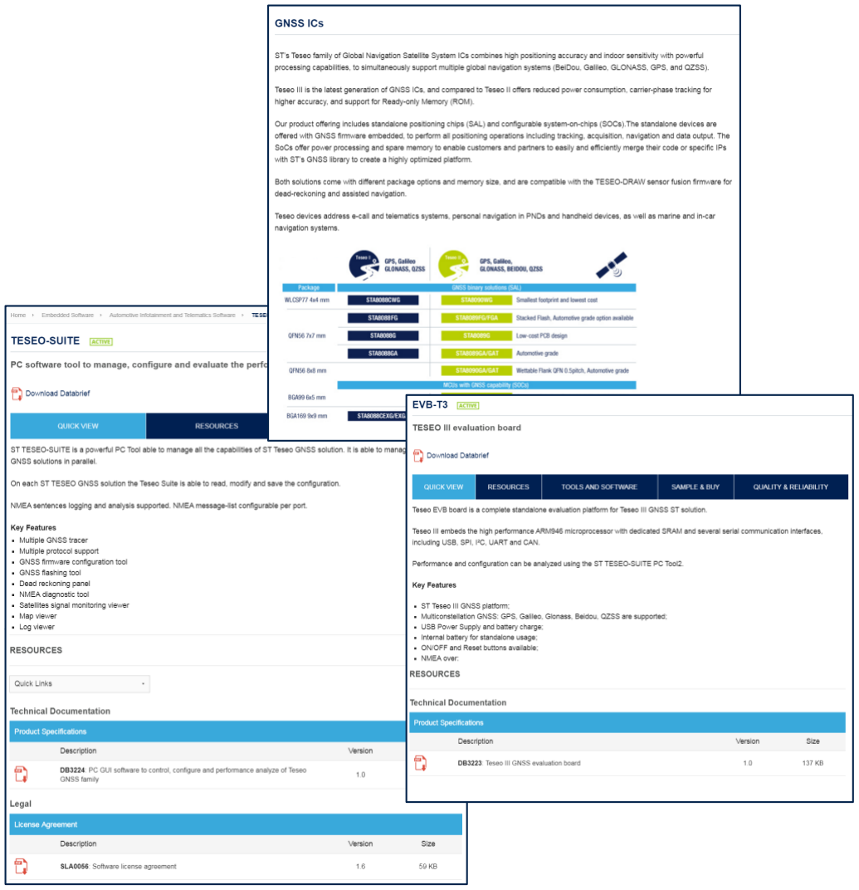
[picture p108: figure]

- Datasheet, user manual and training materials
- Install program
- Video training

# Documents & related resources

All documents are available on: www.st.com

# Join the ST GNSS community

### - Get involved in the ST GNSS community (https://community.st.com/community/gnss)

### - Share ideas

### - Ask questions

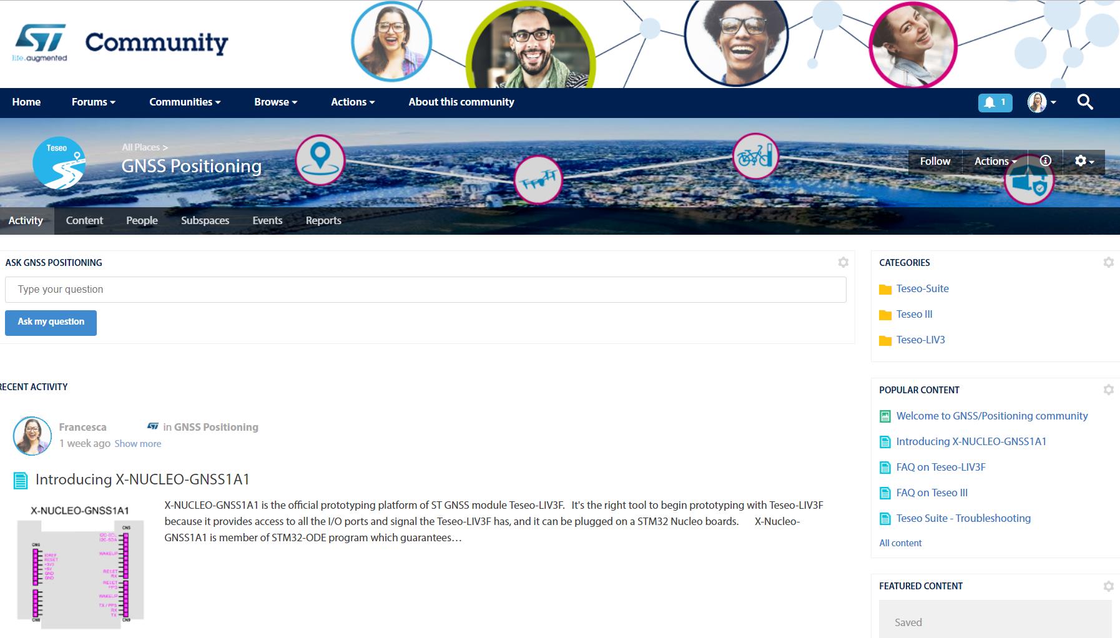
[picture p109: figure]

https://community.st.com/community/gnss
