bismarx-v1/GPS-Compass/docs/TESEO_docs/Teseo-Suite_SW_STM32.pdf

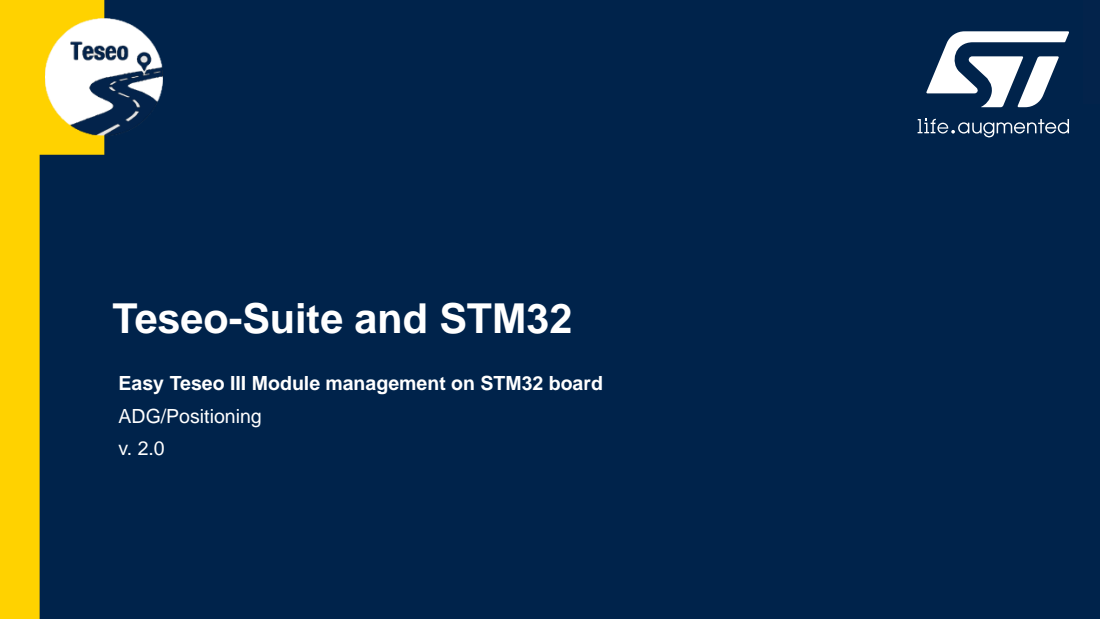
[picture p110: page 1]

Teseo-Suite and STM32

Easy Teseo III Module management on STM32 board
ADG/Positioning

### - Since version 5.2.3.3, Teseo-Suite fully manages the Teseo III module family through STM32F4 MCU (NUCLEO-F401RE)

### - Teseo-Suite contains STM32F4’s firmware to program STM32 device to:

- Stream NMEA coming from Teseo III module
- Upgrade the firmware on Teseo III module

# Teseo-Suite and STM32

# X-NUCLEO on Teseo-Suite

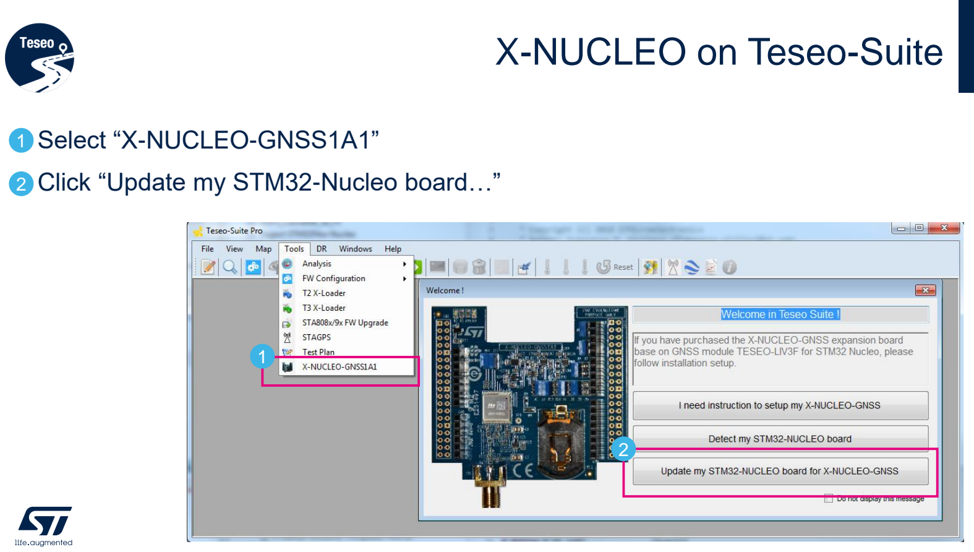
[picture p111: page 3]

### - Select “X-NUCLEO-GNSS1A1”

### - Click “Update my STM32-Nucleo board…”

1

2

1

2

### - Select the required STM32 firmware:

- xxx_FirmwareUpdateUART.bin: to perform a firmware update on Teseo III Module via the STM32.UART port
- xxx_FirmwareUpdateI2C.bin: to perform a firmware update on Teseo III Module via the STM32.I2C port
- xxx_I2CBridge.bin: to perform NMEA streaming coming from Teseo III Module via the STM32.I2C port
- xxx_UARTBridge.bin: to perform NMEA streaming coming from Teseo III Module via the STM32.UART port

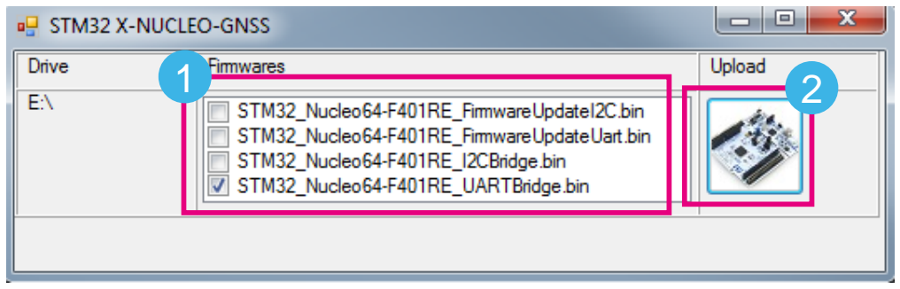
[picture p112: figure]

### - Install the STM32 firmware

# Select STM32 firmware

1

2

# Add a new device

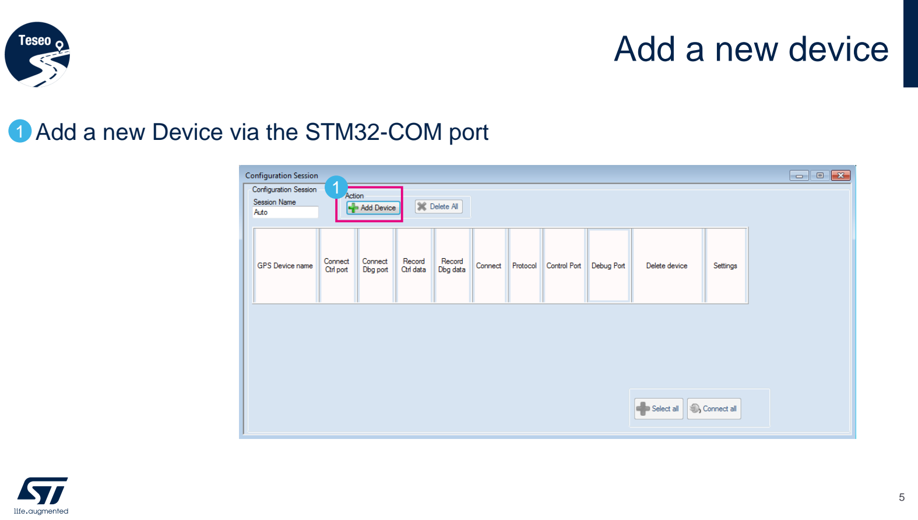
[picture p113: page 5]

### - Add a new Device via the STM32-COM port

1

1

# Configure the STM32-COM port

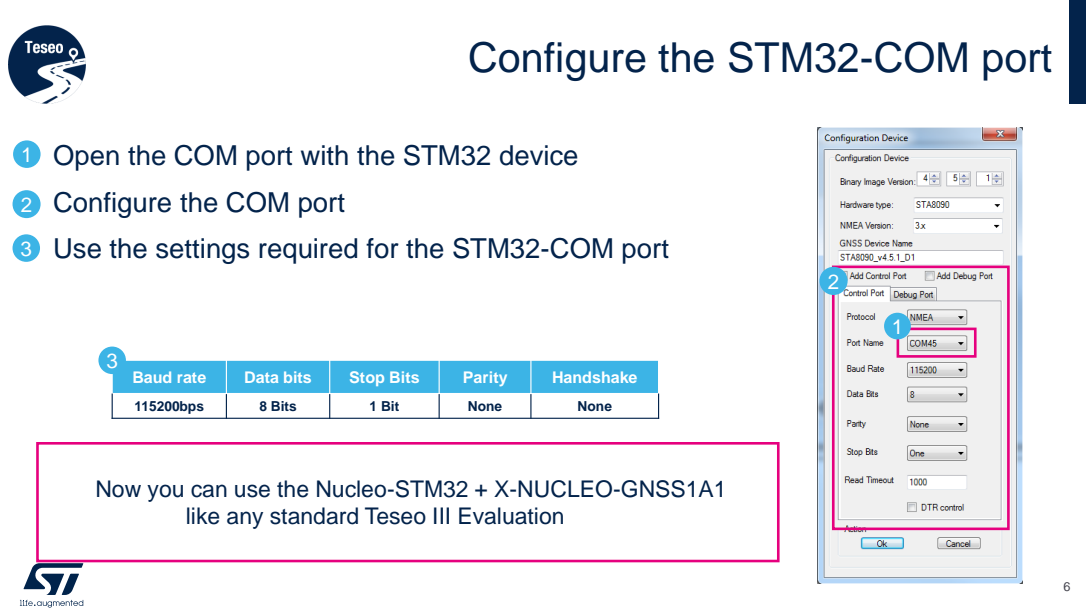
[picture p114: page 6]

• Open the COM port with the STM32 device
• Configure the COM port
• Use the settings required for the STM32-COM port

Baud rate | Data bits | Stop Bits | Parity | Handshake

115200bps | 8 Bits | 1 Bit | None | None

Now you can use the Nucleo-STM32 + X-NUCLEO-GNSS1A1

like any standard Teseo III Evaluation board

- Teseo-LIV3F: Webpage (http://www.st.com/content/st_com/en/products/positioning/gnss-modules/teseo-liv3f.html)
- Datasheet
- User Manuals
- X-Nucleo-GNSS1A1: Webpage (https://www.st.com/content/st_com/en/products/ecosystems/stm32-open-development-environment/stm32-nucleo-expansion-boards/stm32-ode-connect-hw/x-nucleo-gnss1a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)
- Datasheet
- Teseo-Suite: Webpage (http://www.st.com/content/st_com/en/products/embedded-software/automotive-infotainment-and-telematics-software/teseo-suite.html)
- Datasheet
- Install program

# Documents & related resources

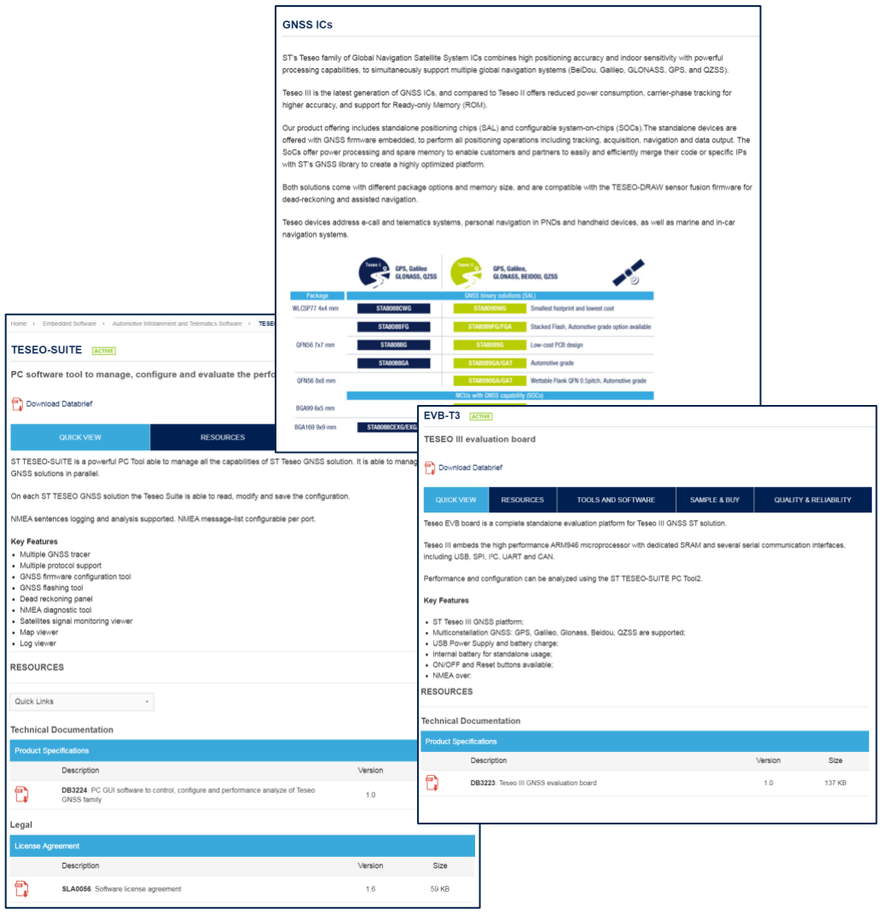
[picture p115: figure]

5/7/2020 | 7

All documents are available on: www.st.com
