bismarx-v1/GPS-Compass/docs/TESEO_docs/Teseo-Suite_SW_assisted_GNSS_tech.pdf

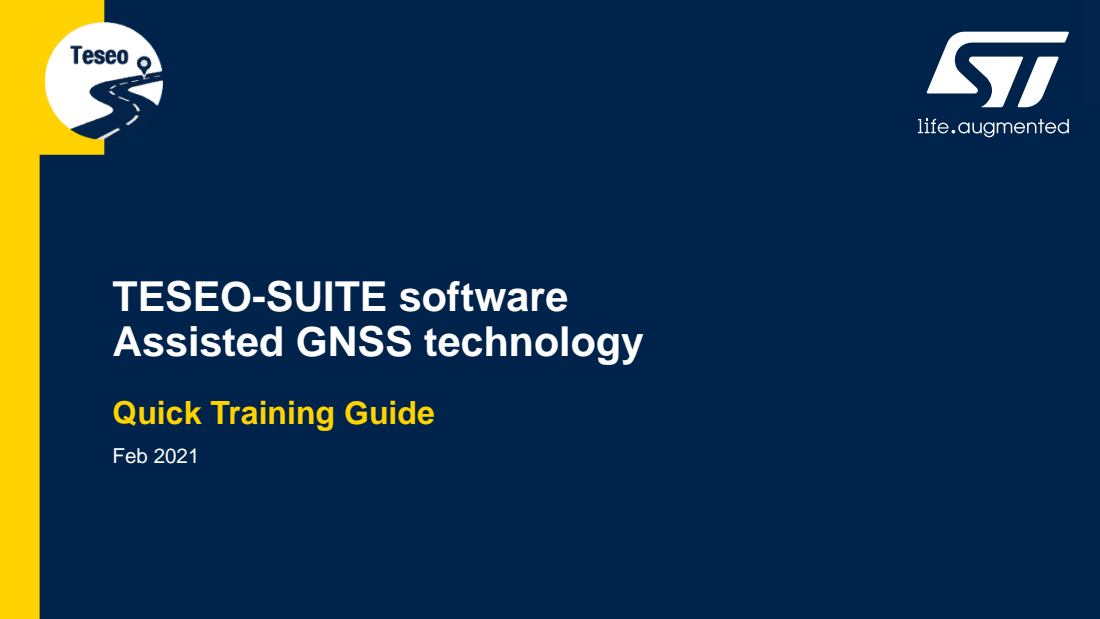
[picture p179: page 1]
Feb 2021

TESEO-SUITE software
Assisted GNSS technology

Quick Training Guide

# Contents

ST-AGNSS panel

Predictive AGNSS panel

Real-Time AGNSS panel

Documents & related resources

2

5

4

3

1 Introduction

# Contents

ST-AGNSS panel

Predictive AGNSS panel

Real-Time AGNSS panel

Documents & related resources

2

5

4

3

1 Introduction

### - Standard GNSS receivers only use data from satellites and require 30 to 32 seconds to evaluate the first position from the moment power is turned on (Time

To First Fix – TTFF).

### - Assisted-GNSS (AGNSS) is a technology which speeds-up the TTFF, thanks to extra data provided to the GNSS

### - Teseo III and Teseo modules support three Assisted GNSS technologies:

- Self-Trained Assisted GNSS
- Predictive Assisted GNSS
- Real-Time Assisted GNSS

# Introduction

# Assisted GNSS technology

Self-trained | Predicted | Real-time
ST-AGNSS predicts satellite data based on previous observation of satellite broadcasted data. | P-AGNSS predicts satellite data based on data downloaded by an assistance server | RT-AGNSS uses real-time satellite data downloaded by an assistance server
No internet connection needed | Internet connection NEEDED (10 ~ 16 KB data for every download based on constellations) | Internet connection NEEDED (16 KB data for every 4 hours based on constellations)
5 to 6 days prediction | 14-day prediction | Continuous /Real Time
TF ~ 1 - 4 s | TF ~ 1 - 4s | TF: 1 s

Management over proprietary NMEA commands Subject to agreement on service-level

# Contents

ST-AGNSS panel

Predictive AGNSS panel

Real-Time AGNSS panel

Documents & related resources

2

5

4

3

1 Introduction

# ST-AGNSS panel

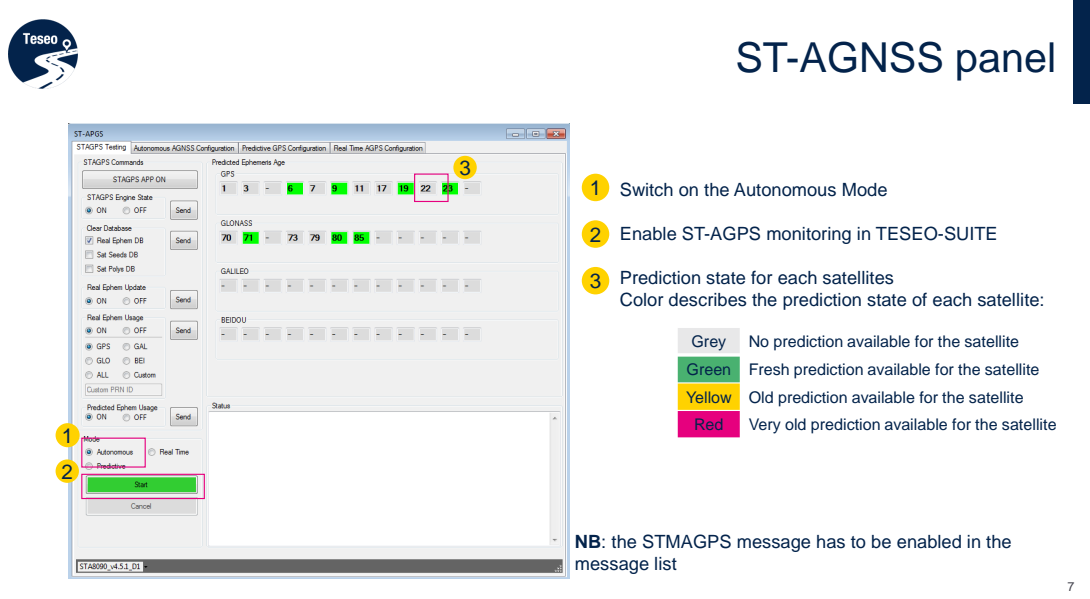
[picture p180: page 7]

1 Switch on the Autonomous Mode

Enable ST-AGPS monitoring in TESEO-SUITE

Prediction state for each satellites
Color describes the prediction state of each satellite:

Grey | No prediction available for the satellite
Green | Fresh prediction available for the satellite
Yellow | Old prediction available for the satellite
Red | Very old prediction available for the satellite

NB: the STMAGPS message has to be enabled in the
message list

# Contents

ST-AGNSS panel

Predictive AGNSS panel

Real-Time AGNSS panel

Documents & related resources

2

5

4

3

1 Introduction

# Predictive AGNSS configuration

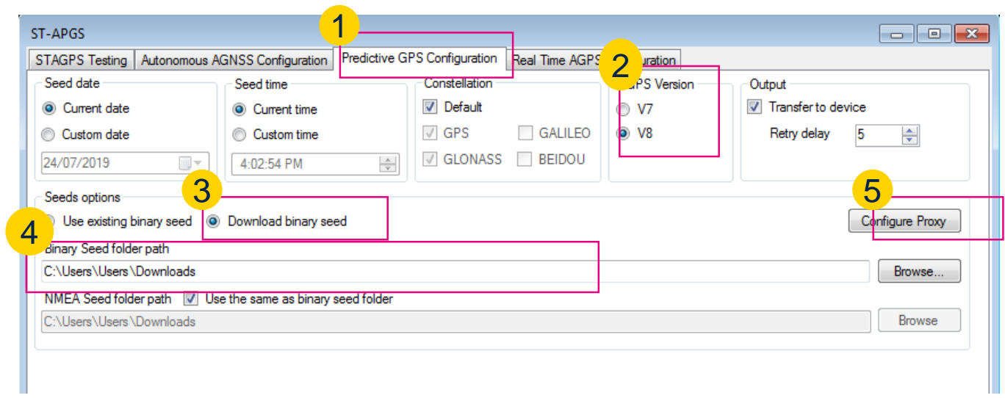
[picture p181: figure]

1 | Go to the Predictive Tab
| Switch on Version V8
| Switch on ‘Download binary seed’
| Define where to save the seed-file
| Configure the http-proxy if needed

2

3

4

5

# Predictive AGNSS running

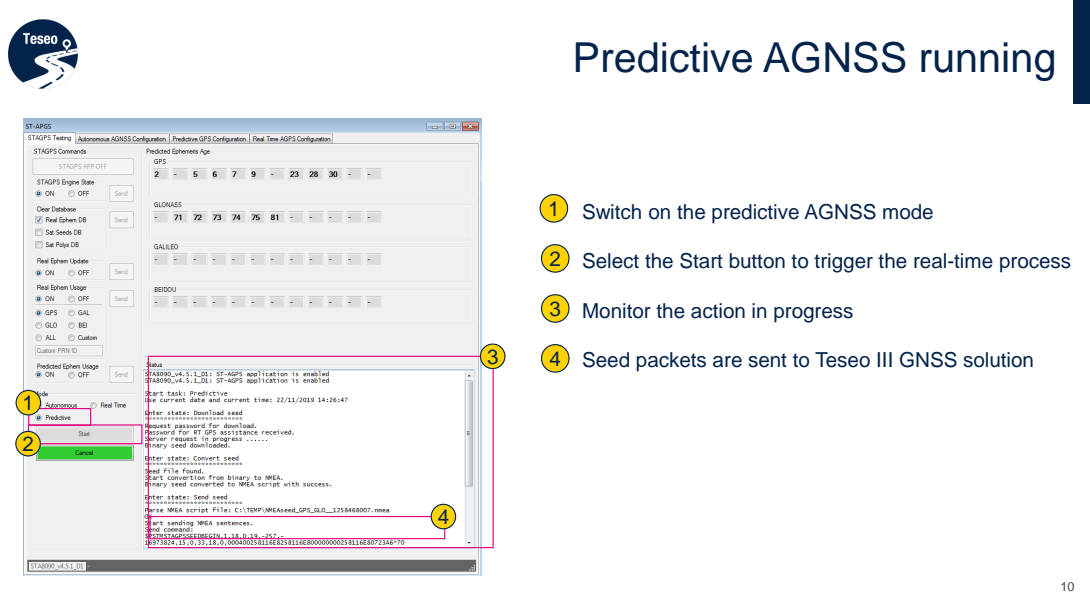
[picture p182: page 10]

1 Switch on the predictive AGNSS mode

Select the Start button to trigger the real-time process

Monitor the action in progress

Seed packets are sent to Teseo III GNSS solution

# Contents

ST-AGNSS panel

Predictive AGNSS panel

Real-Time AGNSS panel

Documents & related resources

2

5

4

3

1 Introduction

# Real-time AGNSS configuration

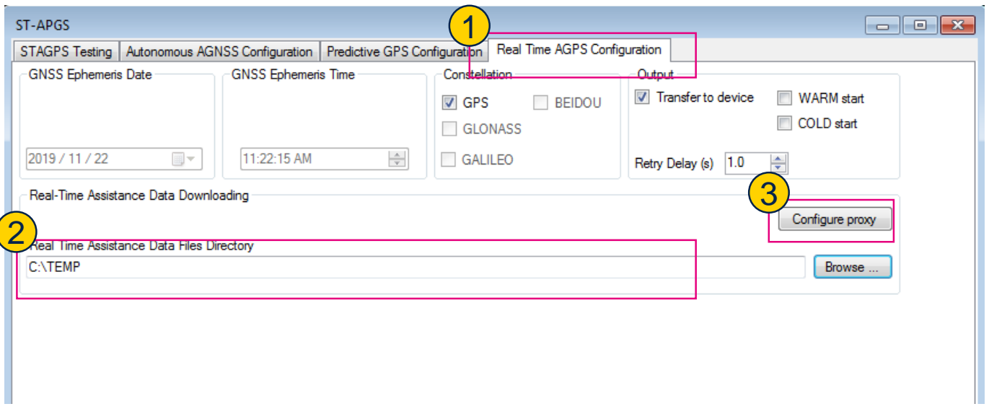
[picture p183: figure]

1 | Go to the Real-Time Tab
| Define where to save the RT-file
| Configure the http-proxy if needed

2

3

# Real-time AGNSS running

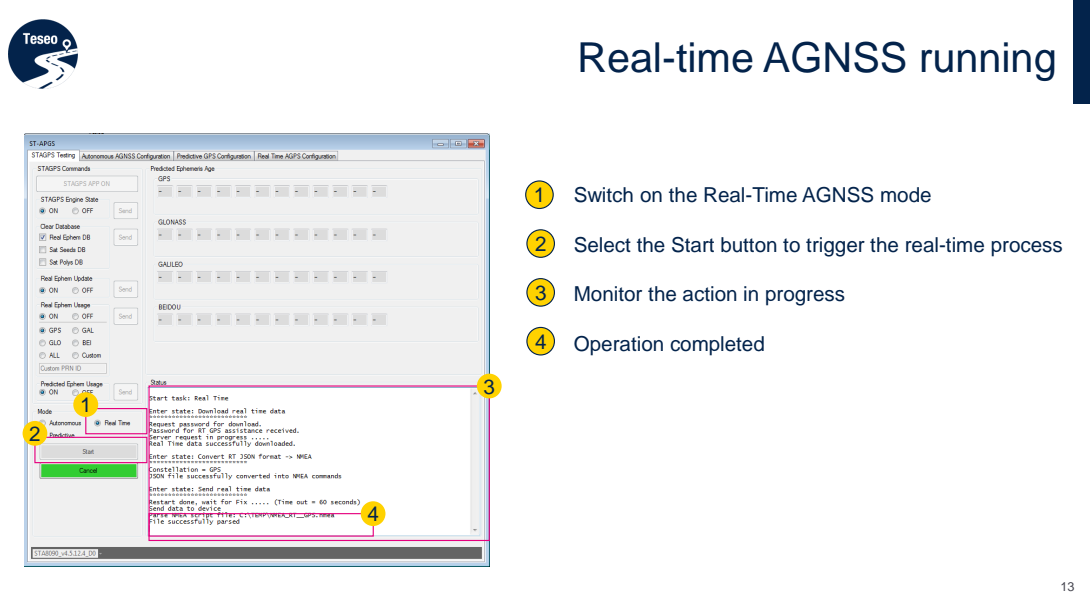
[picture p184: page 13]
Switch on the Real-Time AGNSS mode; Operation completed

Select the Start button to trigger the real-time process

Monitor the action in progress

# Contents

ST-AGNSS panel

Predictive AGNSS panel

Real-Time AGNSS panel

Documents & related resources

2

5

4

3

1 Introduction

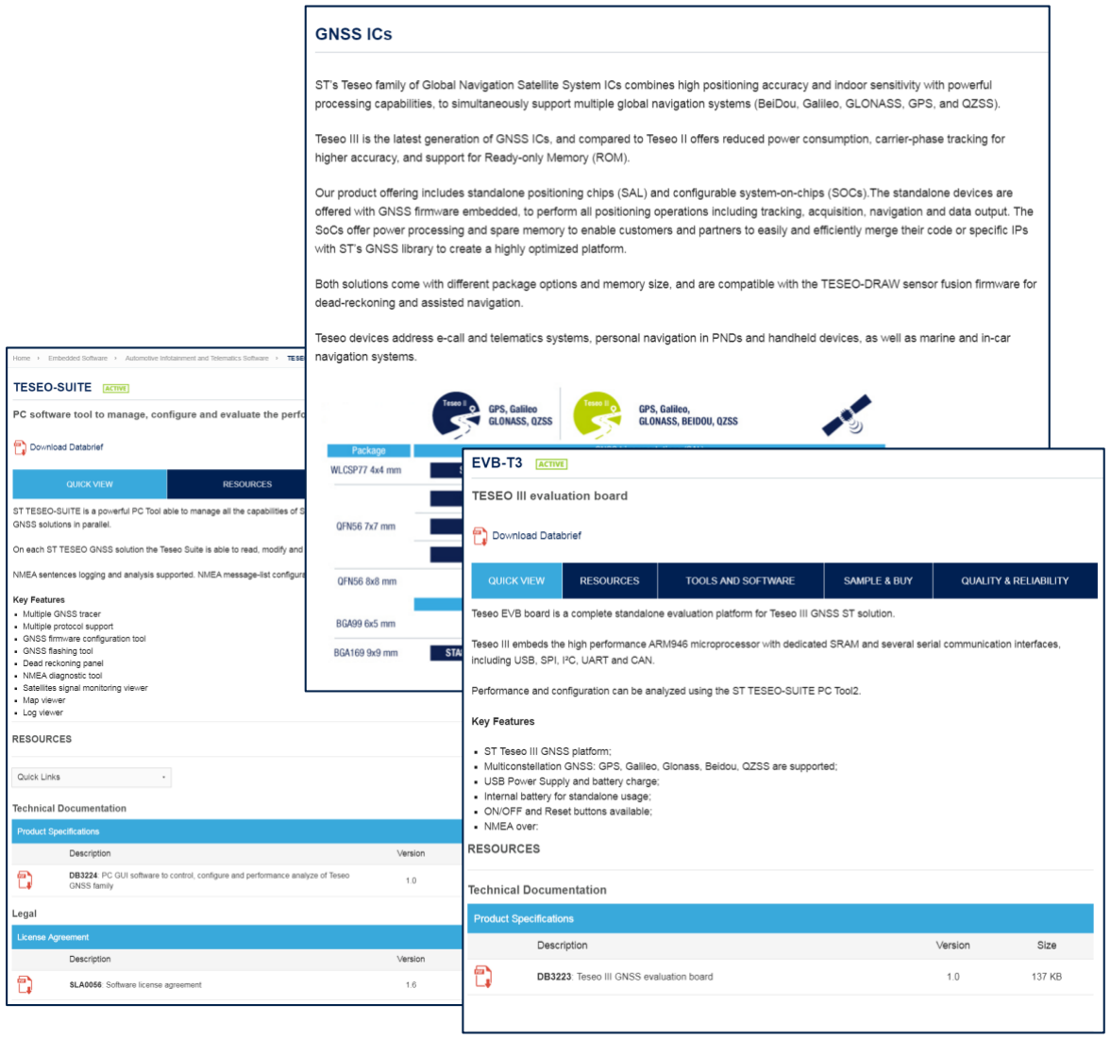
[picture p185: figure]

- Teseo III: Webpage (http://www.st.com/content/st_com/en/products/positioning/gnss-ics.html?querycriteria=productId=SC2194)
- Data-sheet of all PNs

### - Teseo Modules: Webpage (http://www.st.com/gnss-modules)

- Data-sheet of all PNs
- Teseo Suite: Webpage (http://www.st.com/content/st_com/en/products/embedded-software/automotive-infotainment-and-telematics-software/teseo-suite.html)
- Datasheet
- Install program

# Documents & related resources available on st.com

# Teseo suite – extra features

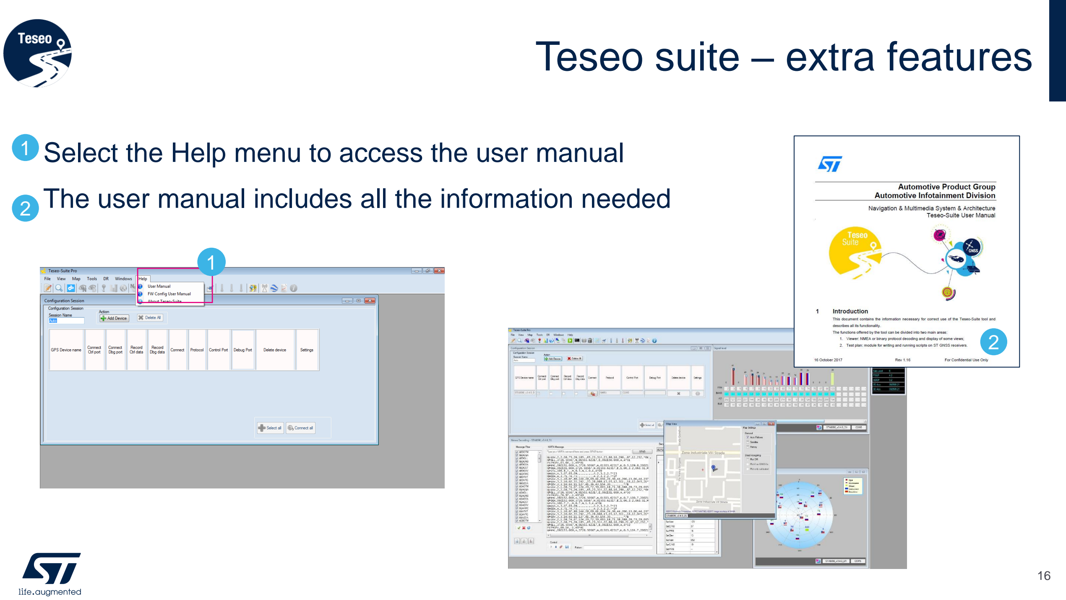
[picture p186: page 16]

### - Select the Help menu to access the user manual

### - The user manual includes all the information needed

1

2

2

1

### - Get started on your GNSS solution with ST’s Teseo III and Teseo Module using

TESEO-SUITE software to explore all the available features.

# GNSS solution development TESEO-SUITE

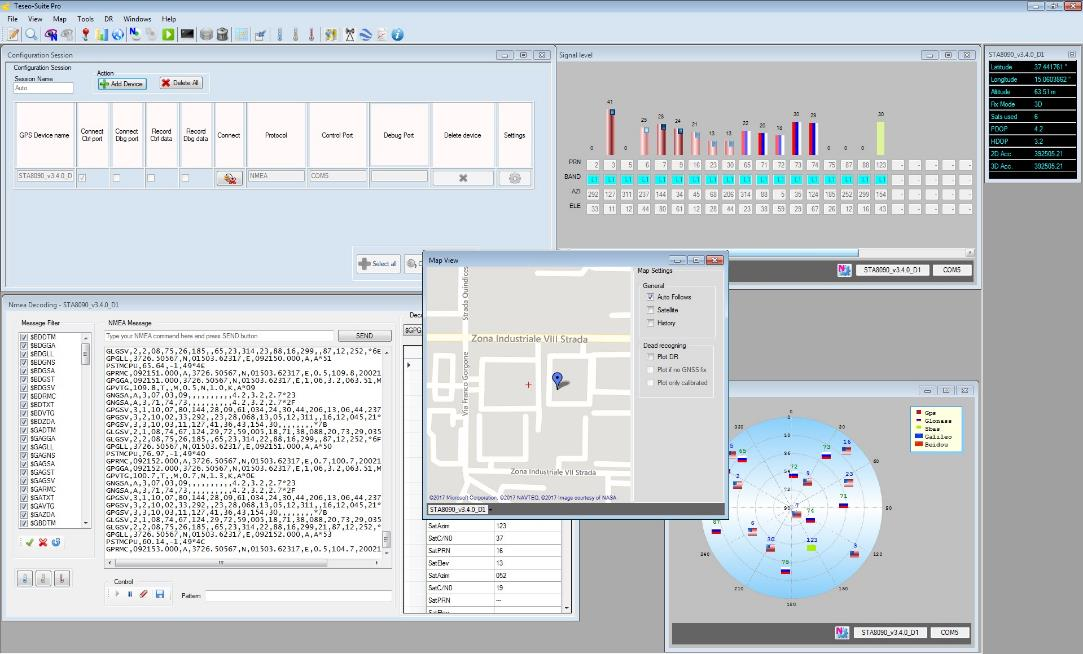
[picture p187: figure]
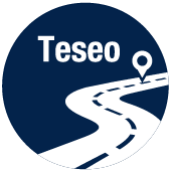
[picture p188: figure]

Teseo III ICs Teseo Modules
