bismarx-v1/GPS-Compass/docs/TESEO_docs/Teseo-Suite_SW_secret_features.pdf

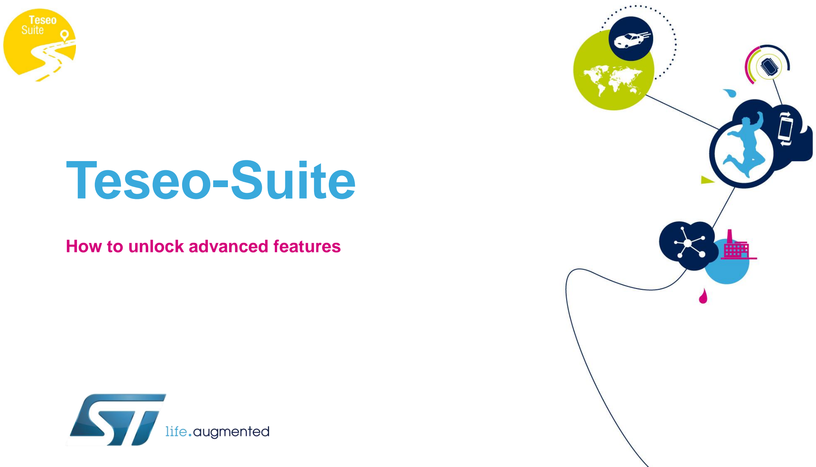
[picture p189: page 1]

# Teseo-Suite

How to unlock advanced features

# Introduction

- Teseo-Suite (https://www.st.com/content/st_com/en/products/embedded-software/automotive-infotainment-and-telematics-software/teseo-suite.html) (v. 5.2.3 and later) is provided as a single executable file (no more Light and Pro versions)
- Certain advanced features are locked
- To unlock the advanced features, send an email requesting the activation key to st-teseo-suite-support@st.com

2

1

# st step: Request full version 3

Go to the Help menu

Select the Activate Teseo-Suite Pro

Select Request full version

1

2

3

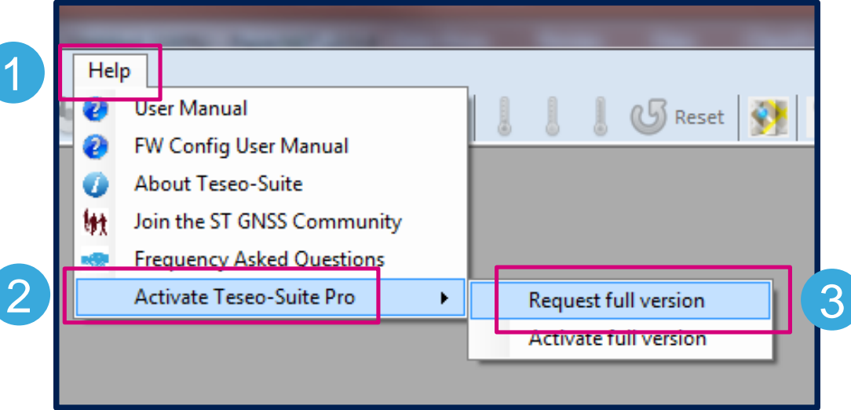
[picture p190: figure]

1

2

# nd step: Fill in the form 4

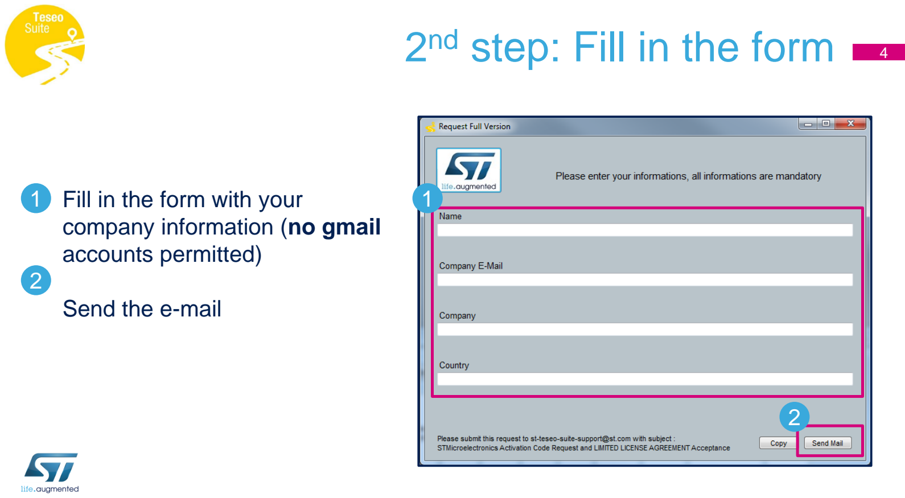
[picture p191: page 4]

Fill in the form with your company information (no gmail accounts permitted)

Send the e-mail

1

2

1

2

3

# rd step: Enter the key 5

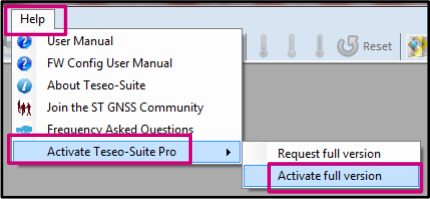
[picture p192: figure]

Go to the Help menu

Select the Activate Teseo-Suite Pro

Select Activate full version

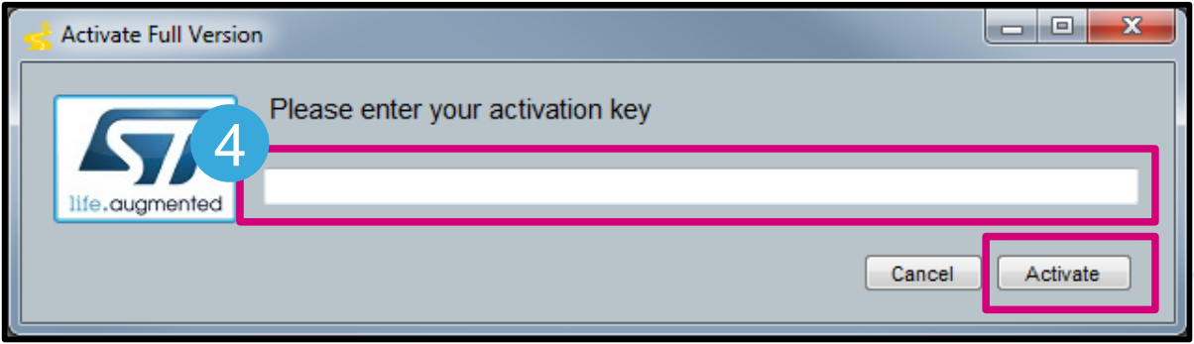
[picture p193: figure]

Enter the activation key

Click the Activate button

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
# Documents & related resources 6

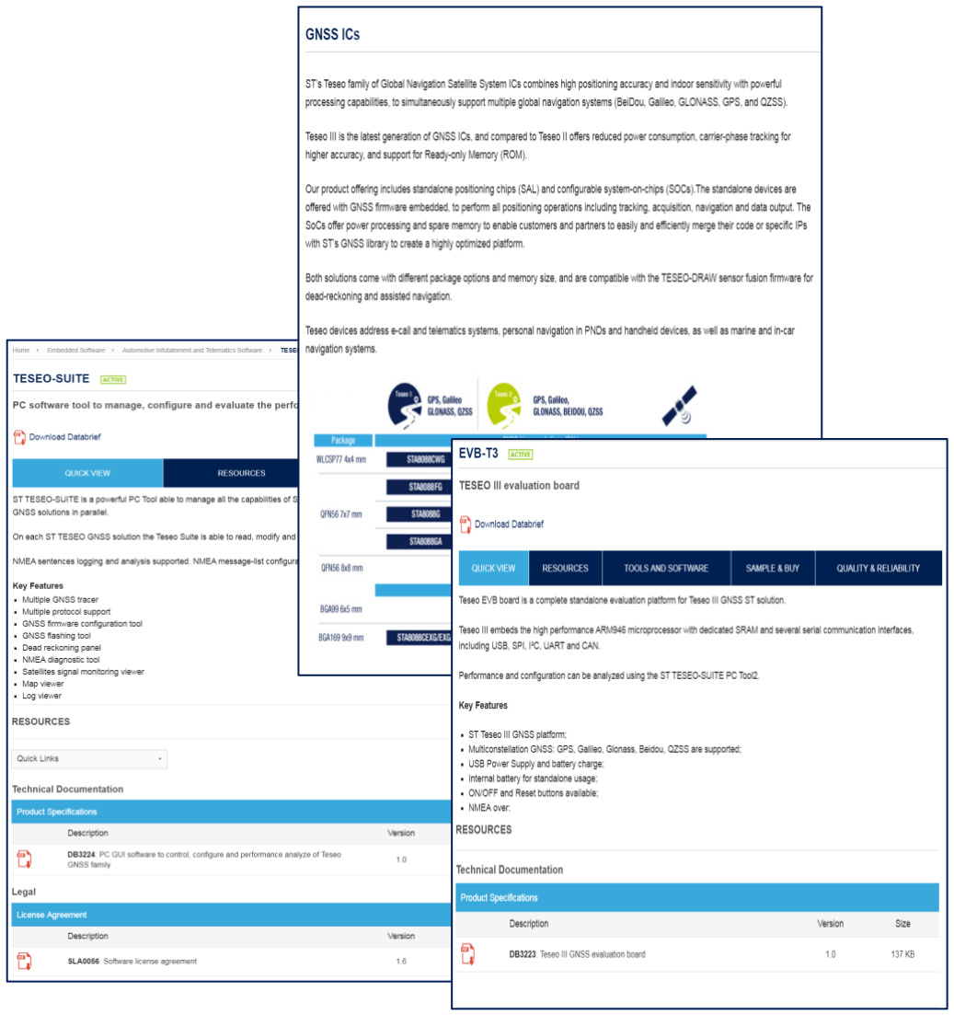
[picture p194: figure]

- Teseo II: Webpage (http://www.st.com/content/st_com/en/products/positioning/gnss-ics.html?querycriteria=productId=SC2194)
- Datasheets for all products
- Teseo III: Webpage (http://www.st.com/content/st_com/en/products/positioning/gnss-ics.html?querycriteria=productId=SC2194)
- Datasheets for all products
- Teseo Suite: Webpage (http://www.st.com/content/st_com/en/products/embedded-software/automotive-infotainment-and-telematics-software/teseo-suite.html)
- Datasheet
- Install program

All documents are available on: www.st.com
