bismarx-v1/GPS-Compass/_media/PCB_Renders/arrow_PCB_render.png

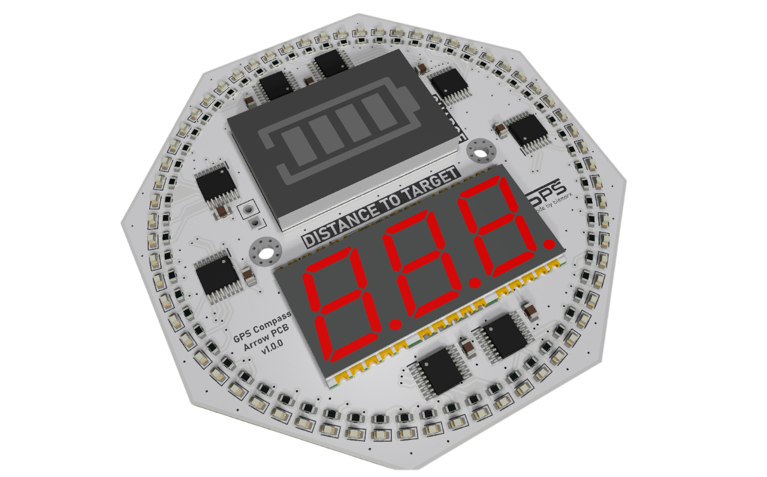
_media/PCB_Renders/arrow_PCB_render.png
