bismarx-v1/GPS-Compass/_media/PCB_Renders/GNSS_PCB_render.png

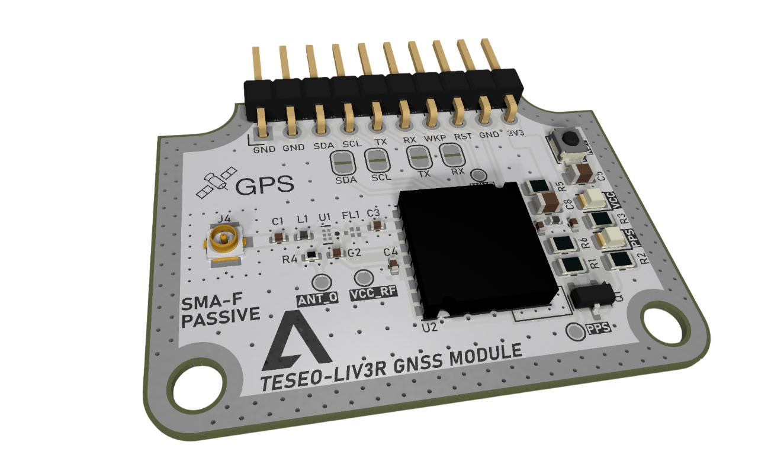
_media/PCB_Renders/GNSS_PCB_render.png
