bismarx-v1/GPS-Compass/_media/PCB_Renders/main_PCB_render.png

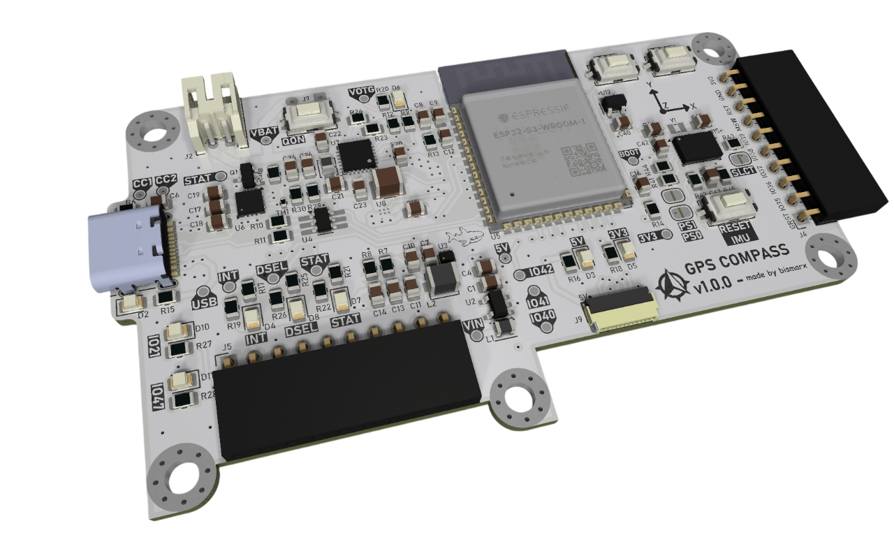
_media/PCB_Renders/main_PCB_render.png
