bismarx-v1/GPS-Compass/_media/PCB_Renders/UI_board_render.png

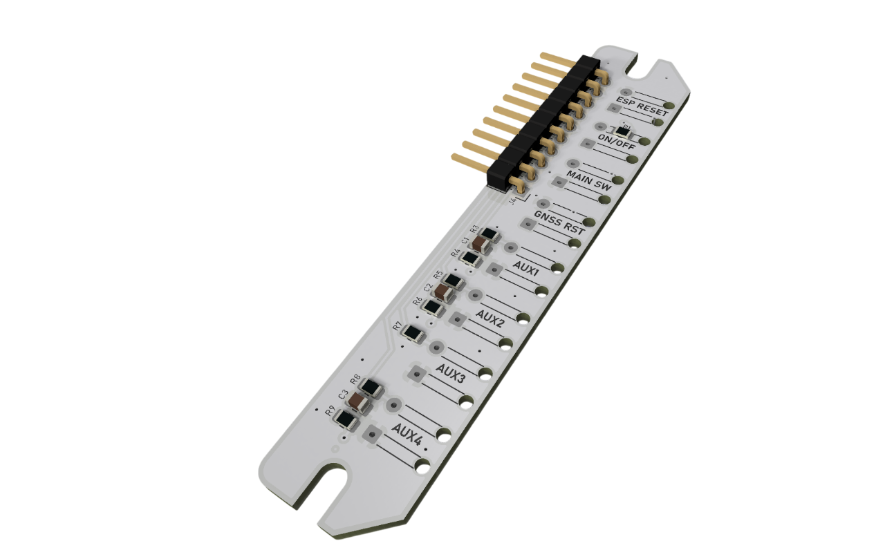
_media/PCB_Renders/UI_board_render.png
