bismarx-v1/GPS-Compass/_media/renders/arrow_pcb.png

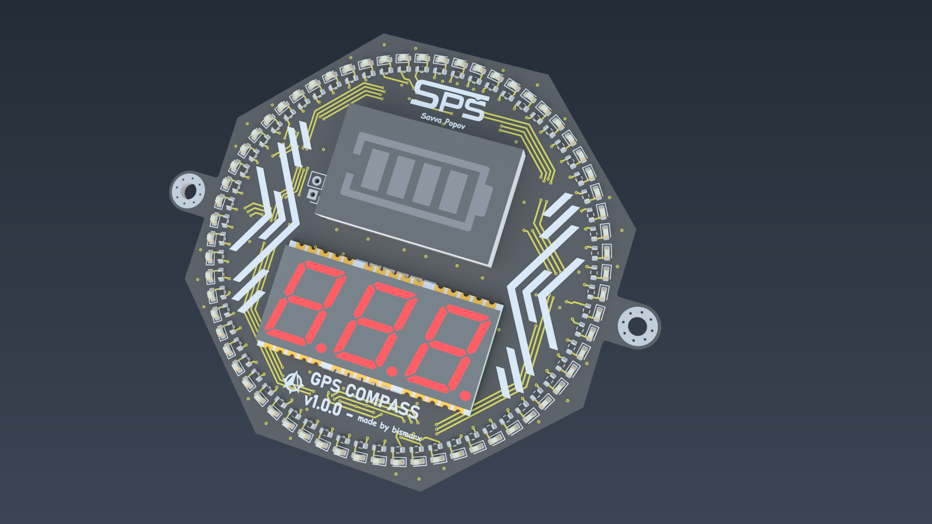
_media/renders/arrow_pcb.png
