bismarx-v1/GPS-Compass/_media/renders/GNSS_PCB.png

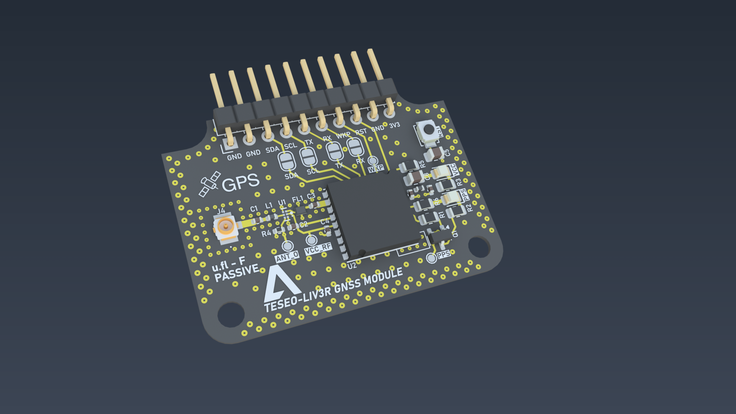
_media/renders/GNSS_PCB.png
