bismarx-v1/GPS-Compass/_media/renders/GPS-Compass_assemb_inner_sps_nobg.png

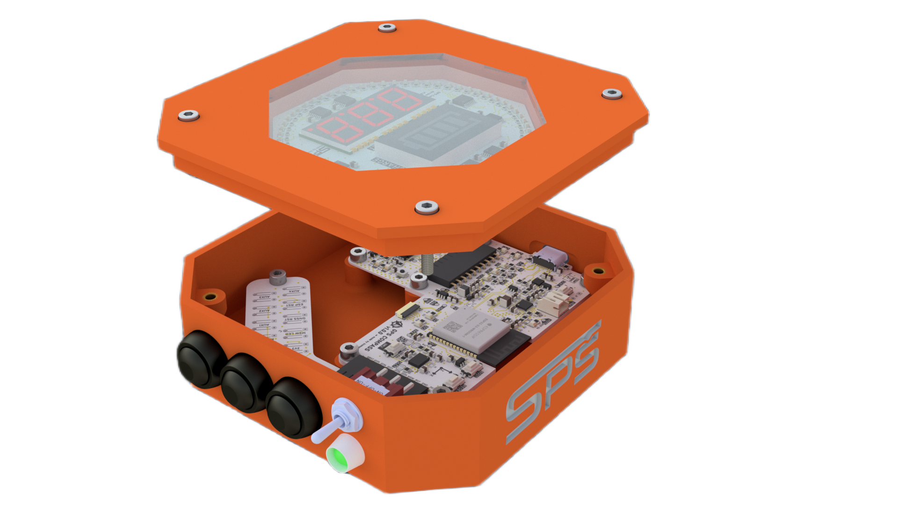
_media/renders/GPS-Compass_assemb_inner_sps_nobg.png
