bismarx-v1/GPS-Compass/_media/renders/GPS-Compass_main_pcbpng.png

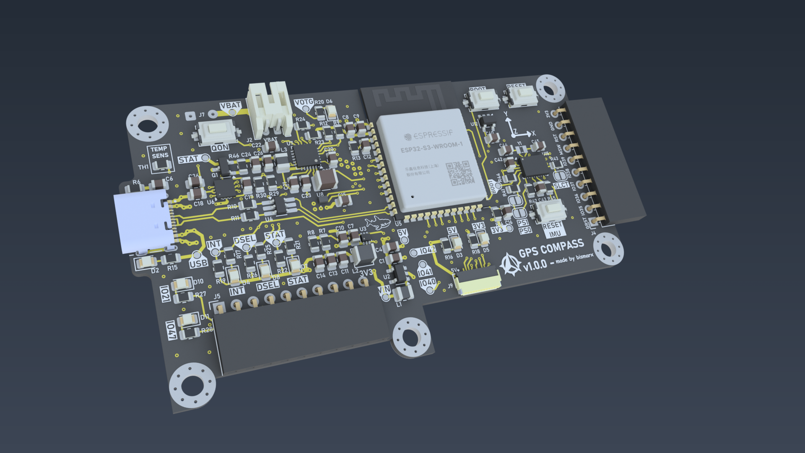
_media/renders/GPS-Compass_main_pcbpng.png
