bismarx-v1/GPS-Compass/_media/renders/GPS-Compass_navod.png

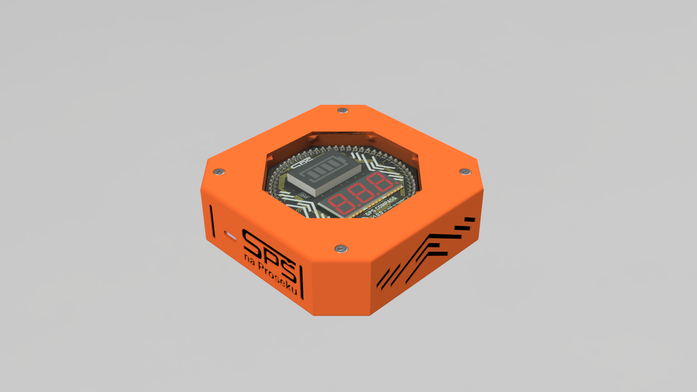
_media/renders/GPS-Compass_navod.png
