bismarx-v1/GPS-Compass/_media/renders/GPS-Compass_PCB_all.png

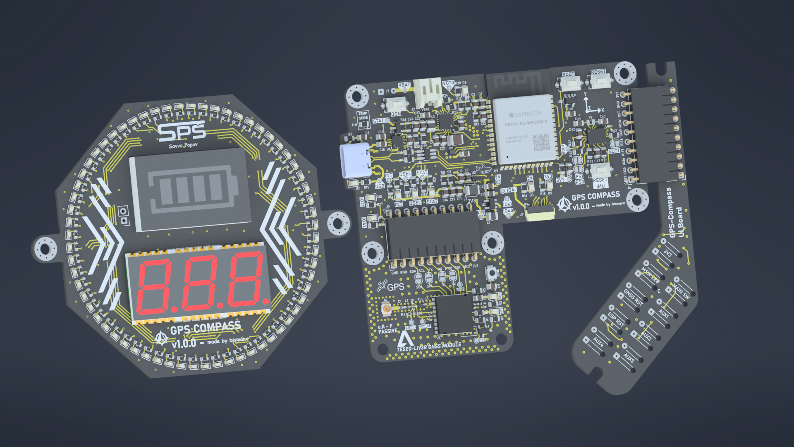
_media/renders/GPS-Compass_PCB_all.png
