bismarx-v1/GPS-Compass/_media/renders/GPS-Compass_PCB_all_nobg.png

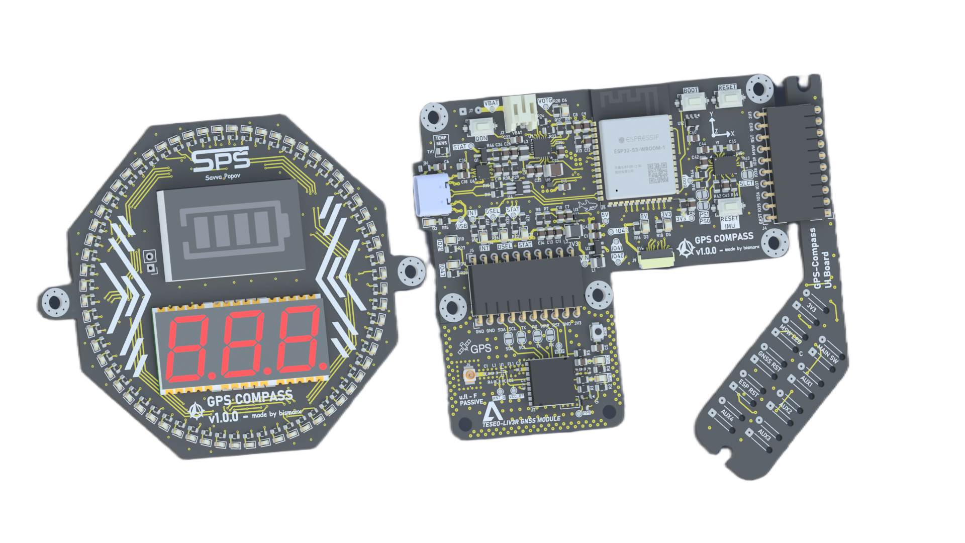
_media/renders/GPS-Compass_PCB_all_nobg.png
