bismarx-v1/GPS-Compass/_media/renders/GPS-Compass_UI.png

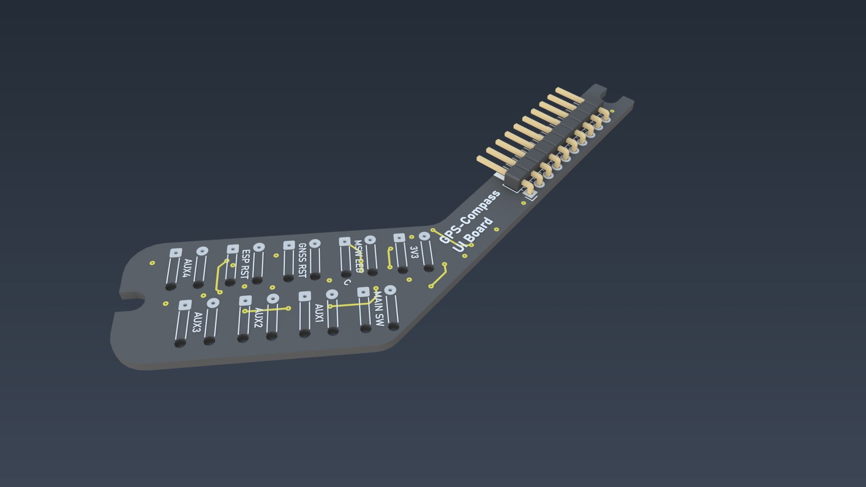
_media/renders/GPS-Compass_UI.png
