bismarx-v1/GPS-Compass/_media/renders/inside.png

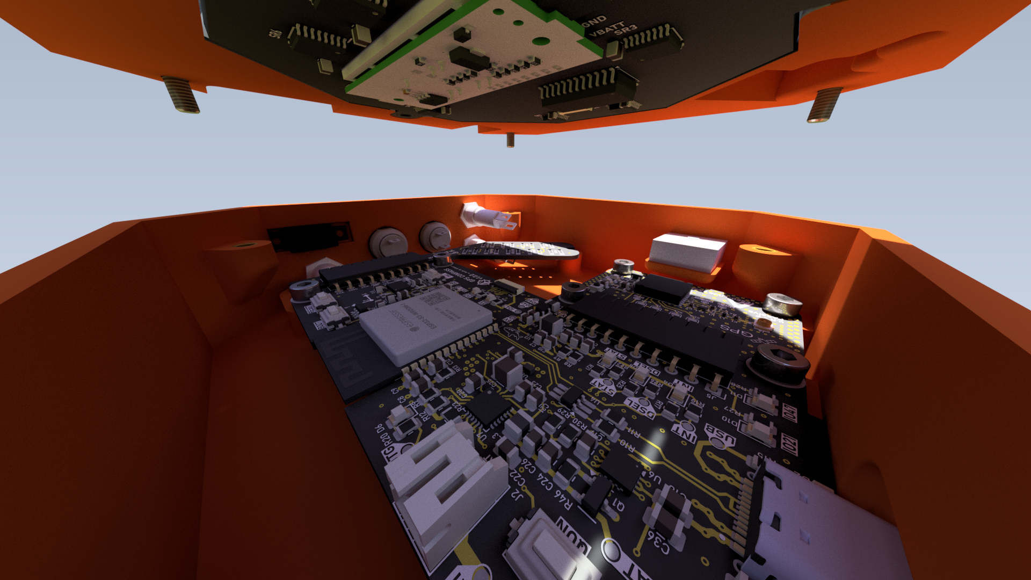
_media/renders/inside.png
