bismarx-v1/GPS-Compass/_media/renders/PCB_otherside.png

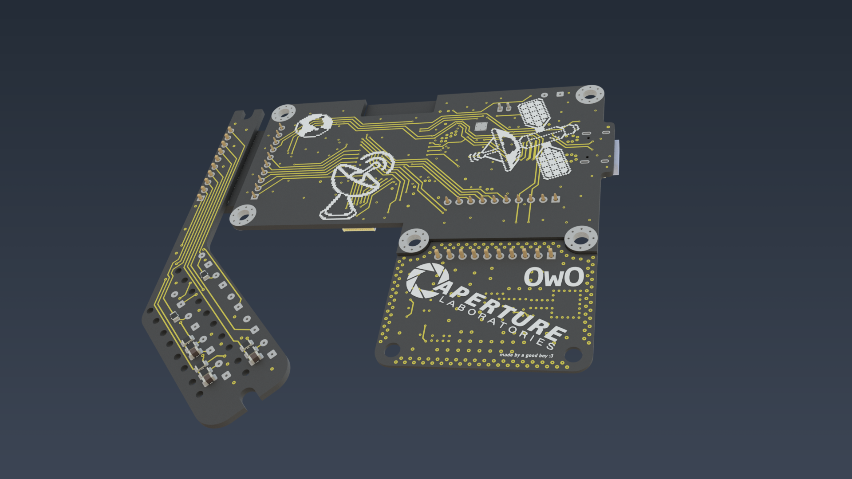
_media/renders/PCB_otherside.png
