bismarx-v1/GPS-Compass/_media/renders/PCBs.png

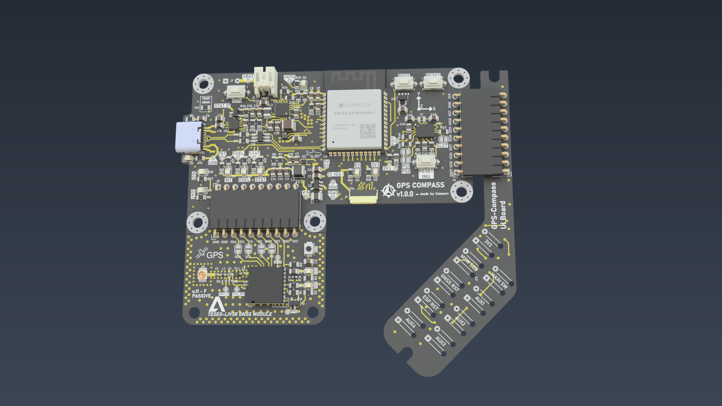
_media/renders/PCBs.png
