bismarx-v1/GPS-Compass/docs/teseo_docs/nmea_types.png

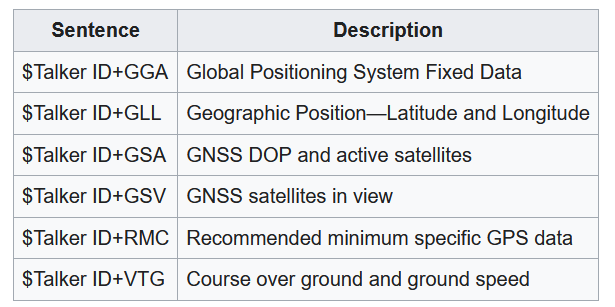
docs/teseo_docs/nmea_types.png
