bismarx-v1/GPS-Compass/docs/bom/GPS-Compass_GNSS_BOM.xlsx

Id | Designator | Footprint | Qty | Value | Link | Reserve
 | AE1 |  | 1 | Antenna | GNSS antenna (https://cz.mouser.com/ProductDetail/Quectel/YCGO005AA?qs=7D1LtPJG0i2jU0GyBGV%252BDQ%3D%3D)
 | C1,C3 | C_0402_1005Metric | 2 | 120p | 120pF, 100V, 0402, ceramic (https://cz.mouser.com/ProductDetail/Murata-Electronics/GCM1555C2A121JE02D?qs=ZcfC38r4Posmjmarb1xIkw%3D%3D)
 | C2 | C_0402_1005Metric | 1 | 1n | 1nF, 100V, 0402, ceramic (https://cz.mouser.com/ProductDetail/Murata-Electronics/GRM1555C2A102JE01J?qs=d0WKAl%252BL4KaQ0kf9CfZNPg%3D%3D)
 | C4,C6 | C_0402_1005Metric | 2 | 56n | 56nF, 16V, 0402, ceramic (https://cz.mouser.com/ProductDetail/Murata-Electronics/GRM155R71C563JA88D?qs=IPQhFcwEUOhUUKpBBiLlZQ%3D%3D)
 | C5,C8 | C_0805_2012Metric | 2 | 100n | 100nF, 16V, 0805, ceramic (https://cz.mouser.com/ProductDetail/YAGEO/AC0805KRX7R7BB104)
 | C7 | C_0402_1005Metric | 1 | 10n | 10nF, 50V, 0402, ceramic (https://cz.mouser.com/ProductDetail/TDK/CGA2B3X7R1H103K050BE?qs=nQSIdc08i%252BdRFt1oFHRWEA%3D%3D)
 | D1 | LED_0805_2012Metric | 1 | BLUE
 | D2 | LED_0805_2012Metric | 1 | GREEN
 | FL1 | FIL_B39162B4327P810 | 1 | B39162B4327P810 | SAW Filter (https://cz.mouser.com/ProductDetail/RF360/B39162B4327P810?qs=lGUynpphgXxwtn5A8O%2FIyg%3D%3D)
 | J3 | PinHeader_2.54mm:PinHeader_1x10_P2.54mm | 1 | 01x10 | TME
 | J4 | gps-compass_brd:636101112001 | 1 | 636101112001 | u.FL RF Conn (https://cz.mouser.com/ProductDetail/Wurth-Elektronik/636101112001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)
 | L1 | Inductor_SMD:L_0402_1005Metric | 1 | 5.6n | 5.6nH, 0402 (https://cz.mouser.com/ProductDetail/TDK/MLG1005S5N6ST000?qs=BanKw8U3RZanzbQ3uYkDLw%3D%3D)
 | L2 | Inductor_SMD:L_0402_1005Metric | 1 | 27nH | 27nH, 0402 (https://cz.mouser.com/ProductDetail/Murata-Electronics/LQG15HS27NJ02D?qs=ctz47l0uL1AbPpSO0oLF1A%3D%3D)
 | Q1 | Package_TO_SOT_SMD:SOT-23 | 1 | MMBT3904 | BJT NPN, 40V, 200mA (https://cz.mouser.com/ProductDetail/Diotec-Semiconductor/MMBT3904?qs=OlC7AqGiEDkK1MwiyUU6mg%3D%3D)
 | R1,R2,R3 | Resistor_SMD:R_0805_2012Metric | 3 | 1k | 1k. 0805 (https://cz.mouser.com/ProductDetail/YAGEO/RC0805FR-101KL?qs=g6xwsc4j%252B%2FpwhJCEiUGSOw%3D%3D)
 | R4 | Resistor_SMD:R_0402_1005Metric | 1 | 10k | 10k, 0402 (https://cz.mouser.com/ProductDetail/YAGEO/RT0402FRE1310KL?qs=8%252Br4Hz5Xir%2FZUB0dNArFaA%3D%3D)
 | R5,R6 | Resistor_SMD:R_0805_2012Metric | 2 | 10k | not needed
 | SW1 | Button_Switch_SMD:SW_SPST_B3U-1000P | 1 | GNSS_RST | shit tactile button
 | U1 | :AMP_BGA725L6E6327FTSA1 | 1 | BGA725L6E6327FTSA1 | LNA RF (https://cz.mouser.com/ProductDetail/Infineon-Technologies/BGA725L6E6327FTSA1?qs=4MqXaUMeF57lT69yR2PUGQ%3D%3D)
 | U2 | :ARRAY_LIV3R_STM | 1 | TESEO-LIV3R | TESEO-LIV3R, GNSS Module (https://cz.mouser.com/ProductDetail/STMicroelectronics/TESEO-LIV3R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)
