bismarx-v1/GPS-Compass/docs/bom/GPS-Compass_Main_BOM.xlsx

Id | Designator | Footprint | Qty | Value | Link | Reserve
1 | D5,D2,D4,D3,D6,D8,D7,D11,D10 | LED_0805_2012Metric | 9 | LED | LED
2 | C10,C4,C14,C13 | C_0805_2012Metric | 4 | 22u | 22uF, 16V, 0805, ceramic (https://cz.mouser.com/ProductDetail/Murata-Electronics/GRM21BR61C226ME44L?qs=H45D%252BQBid9ZSEksDj3jAIw%3D%3D)
3 | C20,C43 | C_0805_2012Metric | 2 | 1u | 1uF, 25V, 0805, ceramic (https://cz.mouser.com/ProductDetail/Samsung-Electro-Mechanics/CL21B105KAFNFNE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)
4 | C21 | C_0805_2012Metric | 1 | 47n | 47nF, 100V, 0805, ceramic (https://cz.mouser.com/ProductDetail/KEMET/C0805C473K1RAC7210?qs=Eba5AOZj%252BtuK8jL1PHDTHw%3D%3D)
5 | C23 | C_0805_2012Metric | 1 | 4.7u | 4.7uF, 16V, 0805, ceramic (https://cz.mouser.com/ProductDetail/Murata-Electronics/GRM21BR71C475KE51K?qs=GtmDRopnxzr%2F5bkS0ZUcHw%3D%3D)
6 | C25 | C_1210_3225Metric | 1 | 47u | 47uF, 10V, 1210, ceramic (https://cz.mouser.com/ProductDetail/Samsung-Electro-Mechanics/CL32B476MPJNNNE)
7 | C42,C6,C16,C9,C7,C40,C12,C18,C17,C15,C11,C1 | C_0805_2012Metric | 12 | 100n | 100nF, 16V, 0805, ceramic (https://cz.mouser.com/ProductDetail/YAGEO/AC0805KRX7R7BB104)
8 | C45,C44 | C_0805_2012Metric | 2 | 18p | 18pF, 50V, 0805, ceramic (https://cz.mouser.com/ProductDetail/Walsin/0805N180J500CT)
9 | C8,C22,C24,C26,C36 | C_0805_2012Metric | 5 | 10u | 10u, 16V, 0805, ceramic (https://cz.mouser.com/ProductDetail/Murata-Electronics/GRM21BZ71C106KE15K?qs=Ey7%2FXF42M3eyALzw2AAzwA%3D%3D)
10 | J2 | JST_PH_S2B-PH-K_1x02_P2.00mm_Horizontal | 1 | Conn_01x02_Pin | JST-PH, 2pin, TME (https://www.tme.eu/cz/details/s2b-ph-k-s/signalove-konektory-raster-2-00mm/jst/s2b-ph-k-s-lf-sn/)
11 | J4, J5 | PinSocket_1x10_P2.54mm_Horizontal | 2 | 01x10 | TME
12 | J6 | HRO_TYPE-C-31-M-12 | 1 | USB_TypeC | USB-C Conn (https://eu.mouser.com/ProductDetail/GCT/USB4105-GF-A-060?qs=QNEnbhJQKvY2mocwNJzgfA%3D%3D)
13 | J9 | GCT_FFC2B28-12-G | 1 | FFC2B28-12-G | FFC Conn (https://cz.mouser.com/ProductDetail/GCT/FFC2B28-12-G?qs=KUoIvG%2F9Ilb3Lmj8zxhxfA%3D%3D)
14 | L1,L3 | CM8V32768TA020125 | 2 | 2.2u | 2.2uH, 2.3A, 0907 (https://cz.mouser.com/ProductDetail/ABRACON/AOTA-B252010S2R2MT?qs=1Kr7Jg1SGW8H59B6i%252B4XUg%3D%3D)
15 | L2 | L_Vishay_IHLP-1212 | 1 | 1.5u | 1.5uH, 4.7A, 1212 (https://cz.mouser.com/ProductDetail/Vishay-Dale/IHLP1212BZEV1R5M5A?qs=BJlw7L4Cy7%2FLPKyjRWwgFw%3D%3D)
16 | Q1 | SOT-23-3 | 1 | SI2393DS | PMOS, 30V, 7.5A (https://cz.mouser.com/ProductDetail/Vishay-Semiconductors/SI2393DS-T1-GE3?qs=BJlw7L4Cy7%2FUF13oxTStOQ%3D%3D)
17 | R11,R10 | R_0805_2012Metric | 2 | 15R | 15R, 100mW, 0805 panasonic (https://cz.mouser.com/ProductDetail/Panasonic/ERJ-6RED15R0V?qs=KTDjhDDUMAl6Ra4%2FZLG24g%3D%3D)
18 | R14,R43,R19,R12,R9,R26,R44,R41,R45,R8,R42,R23,R46,R22,R13 | R_0805_2012Metric | 15 | 10k | 10k, 250mW, 0805, vishay (https://cz.mouser.com/ProductDetail/Vishay-Dale/RCC080510K0FKEA?qs=GedFDFLaBXGY93oge9hajw%3D%3D)
19 | R16,R15,R25,R21,R18,R20,R17 | R_0805_2012Metric | 7 | 2.2k | 2.2k, 125mW, 0805 (https://cz.mouser.com/ProductDetail/Panasonic/ERA-6AED222V?qs=MNPzkKEzRtSATzFNi%252BEAWg%3D%3D)
20 | R24 | R_0805_2012Metric | 1 | RLIM | 120R, 125mW, 0805 (https://cz.mouser.com/ProductDetail/Vishay-Draloric/RCA0805120RFKEA?qs=u16ybLDytRatdHAOvqt02A%3D%3D)
21 | R28,R27 | R_0805_2012Metric | 2 | 220R | 220R, 250mW, 0805 vishay (https://cz.mouser.com/ProductDetail/Vishay/RCC0805220RFKEA?qs=Imq1NPwxi74d31j49YrAMA%3D%3D)
22 | R29 | R_0805_2012Metric | 1 | 5.23k | 5.23k, 125mW, 0805 (https://cz.mouser.com/ProductDetail/Panasonic/ERA-6AEB5231V)
23 | R30 | R_0805_2012Metric | 1 | 30.1k | 30.1k, 100mW, 0805 (https://cz.mouser.com/ProductDetail/Vishay/CRCW060330K1FKEAC?qs=E3Y5ESvWgWOoj84V07u0VQ%3D%3D)
24 | R6 | R_0805_2012Metric | 1 | 100k | 100k, 250mW, 0805, vishay (https://cz.mouser.com/ProductDetail/Vishay-Dale/RCC0805100KFKEA?qs=GedFDFLaBXFnw%2FnoDVfk4A%3D%3D)
25 | R7 | R_0805_2012Metric | 1 | 45k | 45.3k, 125mW, 0805 vishay (https://cz.mouser.com/ProductDetail/Vishay-Dale/CRCW080545K3FKEA?qs=H9nSDuxQXAEd3s8xju4H0w%3D%3D)
26 | SW1,SW2,SW3,SW5 | SW_SPST_EVQPE1 | 4 | SPST | Push button (https://cz.mouser.com/ProductDetail/Panasonic/EVQ-PE104K?qs=wX5mvoJE4NGLiYsCBZAptQ%3D%3D)
27 | TH1 | R_0402_1005Metric | 1 | 10k NTC | NTC 10k, 0805 (https://cz.mouser.com/ProductDetail/Ohmite/TX08F103F3435ER?qs=vEM7xhTegWiti1BXKGM%2B2A%3D%3D)
28 | U12 | SOT-23-5 | 1 | 24CW1280T-I/OT | 24CW1280T-I/OT EEPROM (https://cz.mouser.com/ProductDetail/Microchip-Technology/24CW1280T-I-OT?qs=qSfuJ%2Bfl%2Fd6lIWZGGRvkYA%3D%3D)
29 | U15 | LGA-28_5.2x3.8mm_P0.5mm | 1 | BNO055 | BNO055, IMU (https://cz.mouser.com/ProductDetail/Bosch-Sensortec/BNO055?qs=QhAb4EtQfbV8Z2YmISucWw%3D%3D)
30 | U2 | SOT-23-5 | 1 | TPS613222ADBV | TPS613222ADBV, DC-DC 5V, BOOST (https://cz.mouser.com/ProductDetail/Texas-Instruments/TPS613222ADBVR?qs=W0yvOO0ixfE4d69WXsn8NQ%3D%3D)
31 | U3 | SOT-563 | 1 | TPS565242DRLR | TPS565242DRLR, DC-DC 3.3V (https://cz.mouser.com/ProductDetail/Texas-Instruments/TPS565242DRLR?qs=tlsG%2FOw5FFgHUuabKshykA%3D%3D)
32 | U4 | TSOT-23-6_HandSoldering | 1 | USBLC6-2SC6 | ESD PROT
33 | U5 | ESP32-S3-WROOM-1 | 1 | ESP32-S3-WROOM-1 | ESP32-WROOM-1-S3-N8 (https://cz.mouser.com/ProductDetail/Espressif-Systems/ESP32-S3-WROOM-1-N8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)
34 | U6 | WQFN-14-1EP_2.5x2.5mm_P0.5mm_EP1.45x1.45mm | 1 | FUSB302B11MPX | FUSB302B11MPX, USB-C configurator (https://cz.mouser.com/ProductDetail/onsemi-Fairchild/FUSB302B11MPX?qs=jFK2DQXLaBwFFZq6iARIyw%3D%3D)
35 | U7 | Texas_RTW_WQFN-24-1EP_4x4mm_P0.5mm_EP2.7x2.7mm_ThermalVias | 1 | BQ25895RTW | BQ25895MRTWR, 1-LiPo, charger (https://cz.mouser.com/ProductDetail/Texas-Instruments/BQ25895MRTWR?qs=uNh9J9Y3wTe%2F%252BmcQbu7CLA%3D%3D)
36 | U8 | KTS1605EUB1TR | 1 | KTS1605EUB-1-TR | LOAD switch (https://cz.mouser.com/ProductDetail/Kinetic-Technologies/KTS1605EUB-1-TR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)
37 | Y1 | CM8V32768TA020125 | 1 | 32.768k | Crystal oscillator, 32.768kHz (https://cz.mouser.com/ProductDetail/Micro-Crystal/CM8V-T1A-32.768kHz-12.5pF-20PPM-TA-QC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)
