bismarx-v1/GPS-Compass/docs/bom/GPS-Compass_Arrow_BOM.xlsx

Id | Designator | Footprint | Qty | Value | Link | Reserve
1 | C1,C2,C3,C4,C5,C6,C7,C8,C10 | C_0805_2012Metric | 9 | 100n | 100nF, 16V, 0805, ceramic (https://cz.mouser.com/ProductDetail/YAGEO/AC0805KRX7R7BB104)
2 | C9 | C_0805_2012Metric | 1 | 10u | 10u, 16V, 0805, ceramic (https://cz.mouser.com/ProductDetail/Murata-Electronics/GRM21BZ71C106KE15K?qs=Ey7%2FXF42M3eyALzw2AAzwA%3D%3D)
3 | D1,D2,D3,D4,D5,D6,D7,D8,D9,D10,D11,D12,D13,D14,D15,D16,D17,D18,D19,D20,D21,D22,D23,D24,D25,D26,D27,D28,D29,D30,D31,D32,D33,D34,D35,D36,D37,D38,D39,D40,D41,D42,D43,D44,D45,D46,D47,D48,D49,D50,D51,D52,D53,D54,D55,D56,D57,D58,D59,D60,D61,D62,D63,D64 | LED_0603_1608Metric | 64 | LED_Small | TME
4 | IC1,IC2,IC3,IC4,IC5,IC6,IC7,IC8 | SOP65P640X120-16N | 8 | 74VHC9595FT | 74VHC9595FT,Shift-Register (https://cz.mouser.com/ProductDetail/Toshiba/74VHC9595FT?qs=u16ybLDytRbzC5Ojd9v%252B6Q%3D%3D)
5 | J1 | R_0805_2012Metric | 1 | FFC2B28-12-G | FFC Conn, 12-Pin (https://cz.mouser.com/ProductDetail/GCT/FFC2B28-12-G?qs=KUoIvG%2F9Ilb3Lmj8zxhxfA%3D%3D)
6 | J2 | R_0805_2012Metric | 1 | INDICATOR | LASKAKIT/DRATEK
7 | R1,R2,R3,R4,R5,R6,R7,R8,R9,R10,R11,R12,R13,R14,R15,R16,R17,R18,R19,R20,R21,R22,R23,R24,R25,R26,R27,R28,R29,R30,R31,R32,R33,R34,R35,R36,R37,R38,R39,R40,R41,R42,R43,R44,R45,R46,R47,R48,R49,R50,R51,R52,R53,R54,R55,R56,R57,R58,R59,R60,R61,R62,R63,R64 | R_0603_1608Metric | 64 | 220R | TME
8 | R65 | R_0805_2012Metric | 1 | 10k | 10k, 250mW, 0805, vishay (https://cz.mouser.com/ProductDetail/Vishay-Dale/RCC080510K0FKEA?qs=GedFDFLaBXGY93oge9hajw%3D%3D)
9 | U1 | OSK3056A-LR | 1 | OSK3056A-LR | 3 digit, display (https://www.tme.eu/cz/en/details/osk3056a-lr/7-segment-led-displays/optosupply)
10 | U2 | SOP-24_7.5x15.4mm_P1.27mm | 1 | MAX7219 | LASKAKIT/DRATEK
 |  |  |  |  |  |  | ~
