bismarx-v1/GPS-Compass/docs/bom/GPS-Compass_Arrow_MOUSER.xls

Mfr Part Number (Input) | Manufacturer Part Number | Mouser Part Number | Manufacturer Name | Description | Quantity 1 | Unit Price 1 | Quantity 2 | Unit Price 2 | Quantity 3 | Unit Price 3 | Quantity 4 | Unit Price 4 | Quantity 5 | Unit Price 5 | Order Quantity | Order Unit Price | Min./Mult. | Availability | Lead Time in Days | Lifecycle | NCNR | RoHS | Pb Free | Package Type | Datasheet URL | Product Image | Design Risk
 |  | 757-74VHC9595FT |  |  | 15
