bismarx-v1/GPS-Compass/docs/bom/GPS-Compass_GNSS_MOUSER.xls

Mfr Part Number (Input) | Manufacturer Part Number | Mouser Part Number | Manufacturer Name | Description | Quantity 1 | Unit Price 1 | Quantity 2 | Unit Price 2 | Quantity 3 | Unit Price 3 | Quantity 4 | Unit Price 4 | Quantity 5 | Unit Price 5 | Order Quantity | Order Unit Price | Min./Mult. | Availability | Lead Time in Days | Lifecycle | NCNR | RoHS | Pb Free | Package Type | Datasheet URL | Product Image | Design Risk
 |  | 277-YCGO005AA |  |  | 1
 |  | 81-GCM1555C2A121JE2D |  |  | 10
 |  | 81-GRM1555C2A102JE1J |  |  | 10
 |  | 81-GRM155R71C563JA8D |  |  | 10
 |  | 810-CGA2B3X7R1H103KB |  |  | 10
 |  | 871-B39162B4327P810 |  |  | 4
 |  | 710-636101112001 |  |  | 5
 |  | 810-MLG1005S5N6ST000 |  |  | 10
 |  | 81-LQG15HS27NJ02D |  |  | 10
 |  | 637-MMBT3904 |  |  | 10
 |  | 603-RC0805FR-101KL |  |  | 10
 |  | 603-RT0402FRE1310KL |  |  | 10
 |  | 726-BGA725L6E6327FTS |  |  | 5
