bismarx-v1/GPS-Compass/docs/bom/GPS-Compass_Main_MOUSER.xls

Mfr Part Number (Input) | Manufacturer Part Number | Mouser Part Number | Manufacturer Name | Description | Quantity 1 | Unit Price 1 | Quantity 2 | Unit Price 2 | Quantity 3 | Unit Price 3 | Quantity 4 | Unit Price 4 | Quantity 5 | Unit Price 5 | Order Quantity | Order Unit Price | Min./Mult. | Availability | Lead Time in Days | Lifecycle | NCNR | RoHS | Pb Free | Package Type | Datasheet URL | Product Image | Design Risk
 |  | 81-GRM21BR61C226ME4L |  |  | 10
 |  | 187-CL21B105KAFNFNE |  |  | 10
 |  | 80-C0805C473K1RACLR |  |  | 10
 |  | 81-GRM21BR71C475KE1K |  |  | 10
 |  | 187-CL32B476MPJNNNE |  |  | 10
 |  | 603-AC805KRX7R7BB104 |  |  | 100
 |  | 791-0805N180J500CT |  |  | 10
 |  | 81-GRM21BZ71C106KE5K |  |  | 10
 |  | 640-FFC2B28-12-G |  |  | 10
 |  | 815-AOTB252010S2R2MT |  |  | 10
 |  | 667-ERJ-6RED15R0V |  |  | 10
 |  | 71-CRCW0805-10K-E3 |  |  | 100
 |  | 667-ERA-6AED222V |  |  | 20
 |  | 594-RCA0805120RFKEA |  |  | 10
 |  | 71-CRCW0805-220-E3 |  |  | 100
 |  | 667-ERA-6AEB5231V |  |  | 10
 |  | 71-CRCW060330K1FKEAC |  |  | 10
 |  | 71-RCC0805100KFKEA |  |  | 10
 |  | 71-CRCW0805-45.3K-E3 |  |  | 10
 |  | 588-TX08F103F3435ER |  |  | 10
 |  | 595-TPS613222ADBVR |  |  | 10
 |  | 512-FUSB302B11MPX |  |  | 3
 |  | 595-BQ25895MRTWR |  |  | 3
 |  | 389-KTS1605EUB1TR |  |  | 10
 |  | 428-201494-MC01 |  |  | 5
