bismarx-v1/GPS-Compass/(list of files, cad)

Other CAD files:
_mechanical/GPS-Compass_assembly/drawings/GPS-Compass_manual_usb.dwg
_mechanical/GPS-Compass_assembly/drawings/GPS-Compass_manual_buttons.dwg
_mechanical/GPS-Compass_assembly/drawings/GPS-Compass_manua_exportl.dwg
_mechanical/GPS-Compass_assembly/drawings/GPS-Compass_plexi.dwg
_mechanical/GPS-Compass_assembly/GPS-Compass_top.ipt
_mechanical/GPS-Compass_assembly/OldVersions/GPS-Compass_top.0028.ipt
_mechanical/GPS-Compass_assembly/parts/Copper Shell LED Indicator Light KL0624/Copper Shell LED Indicator Light KL0624/Copper Shell LED Indicator Light KL0624.ipt
_mechanical/GPS-Compass_assembly/parts/Copper Shell LED Indicator Light KL0624/Copper Shell LED Indicator Light KL0624/OldVersions/Copper Shell LED Indicator Light KL0624.0002.ipt
_mechanical/GPS-Compass_assembly/parts/OldVersions/led_part.0002.ipt
_mechanical/GPS-Compass_assembly/parts/OldVersions/led_part_blue.0003.ipt
_mechanical/GPS-Compass_assembly/parts/antena/antena/OldVersions/antena.0002.ipt
_mechanical/GPS-Compass_assembly/parts/antena/antena/antena.ipt
_mechanical/GPS-Compass_assembly/parts/ic184-thread/ic184-thread/OldVersions/button_white.0002.ipt
_mechanical/GPS-Compass_assembly/parts/ic184-thread/ic184-thread/OldVersions/ic184-thread.0003.ipt
_mechanical/GPS-Compass_assembly/parts/ic184-thread/ic184-thread/button_white.ipt
_mechanical/GPS-Compass_assembly/parts/ic184-thread/ic184-thread/ic184-thread.ipt
_mechanical/GPS-Compass_assembly/parts/led_part.ipt
_mechanical/GPS-Compass_assembly/parts/led_part_blue.ipt
