bismarx-v1/GPS-Compass/docs/TESEO_docs/Teseo-Suite_SW_guide.pdf

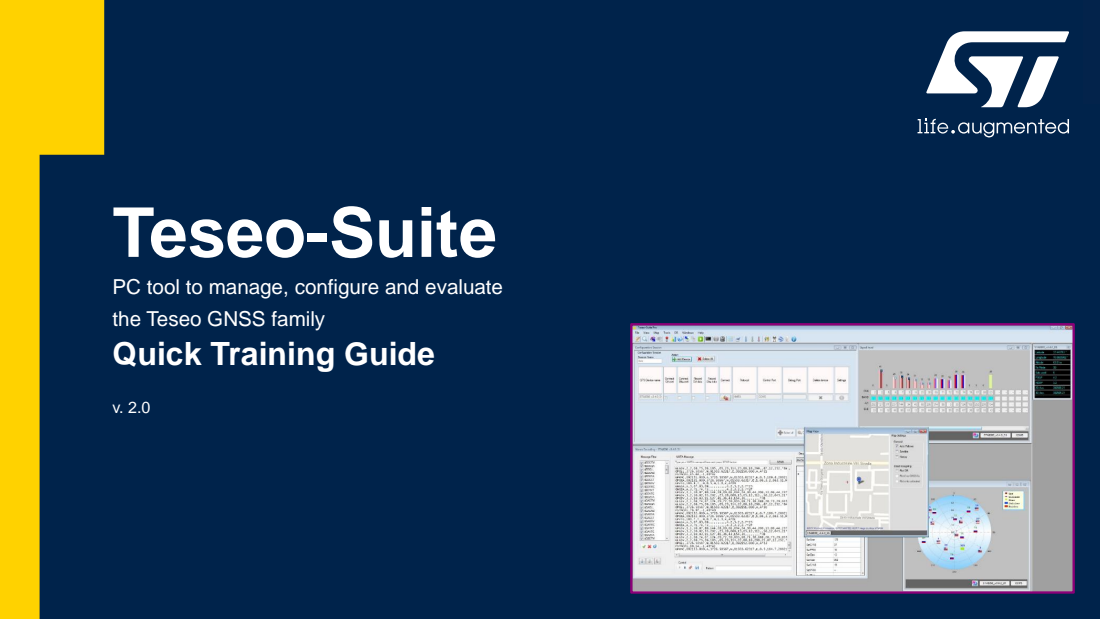
[picture p219: page 1]
Teseo-Suite

PC tool to manage, configure and evaluate
the Teseo GNSS family
Quick Training Guide

# Quick start guide - Contents

Introduction

Basic commands

Advanced features

Documents & related resources

1

4

3

2

# Quick start guide - Introduction

1 Introduction

2

3

4

Basic commands

Advanced features

Documents & related resources

# Install Teseo Suite

### Teseo-Suite is a powerful PC Tool able to manage the ST Teseo II and Teseo III

GNSS solutions.

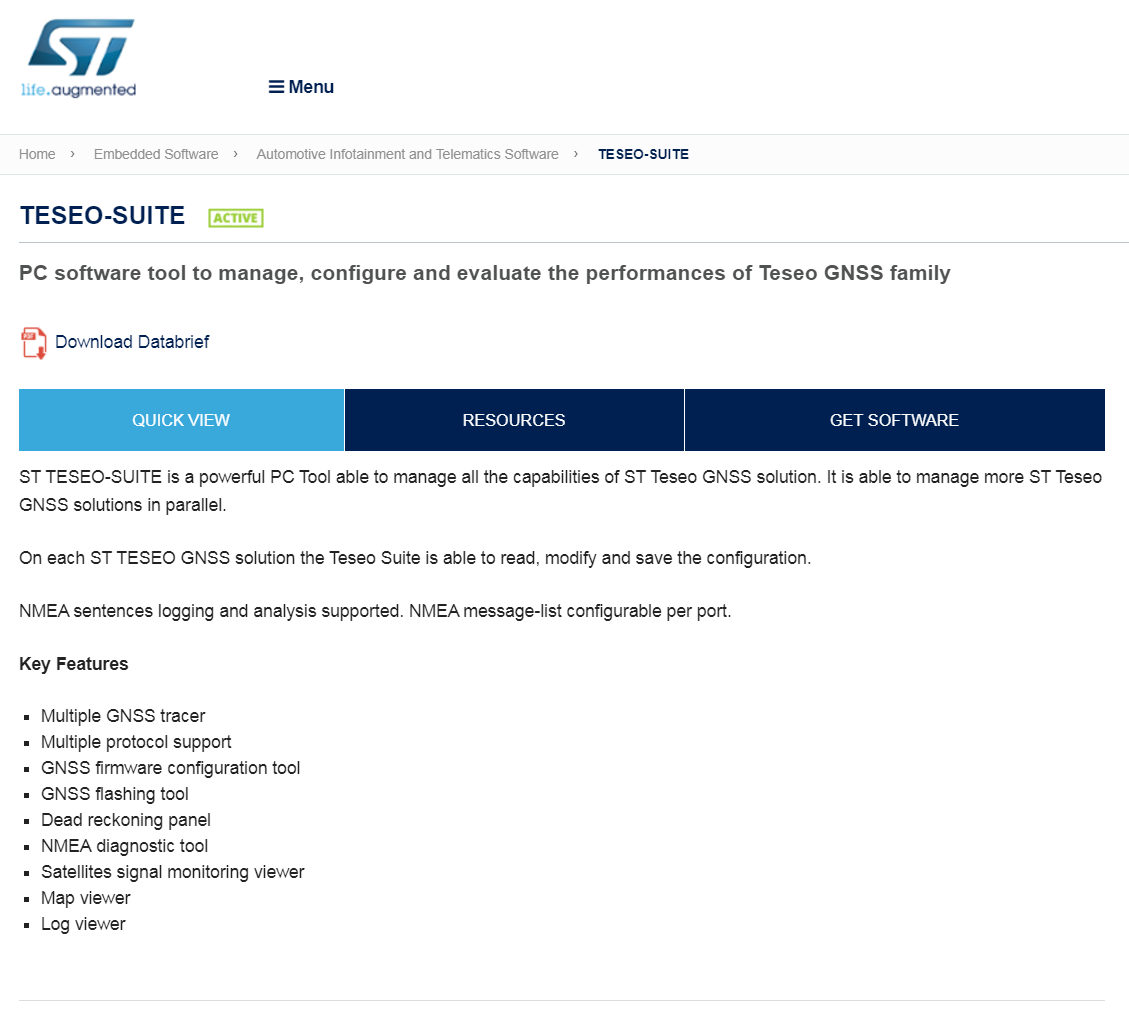
[picture p220: figure]

### Download and install the Teseo Suite

Teseo Suite is provided on www.st.com with locked-features.

Unlock-key can be requested to st-teseo-suite-support@st.com

### ST’s Teseo III, Teseo Module and Teseo V GNSS solutions can be connected to a PC using the USB port through the USB-To-UART bridge

### You need to install the VCP Driver. It can be downloaded here:

- SiliconLabs www.silabs.com

or

- FTDIChip www.fdtichip.com

# Install VCP driver

# Start application

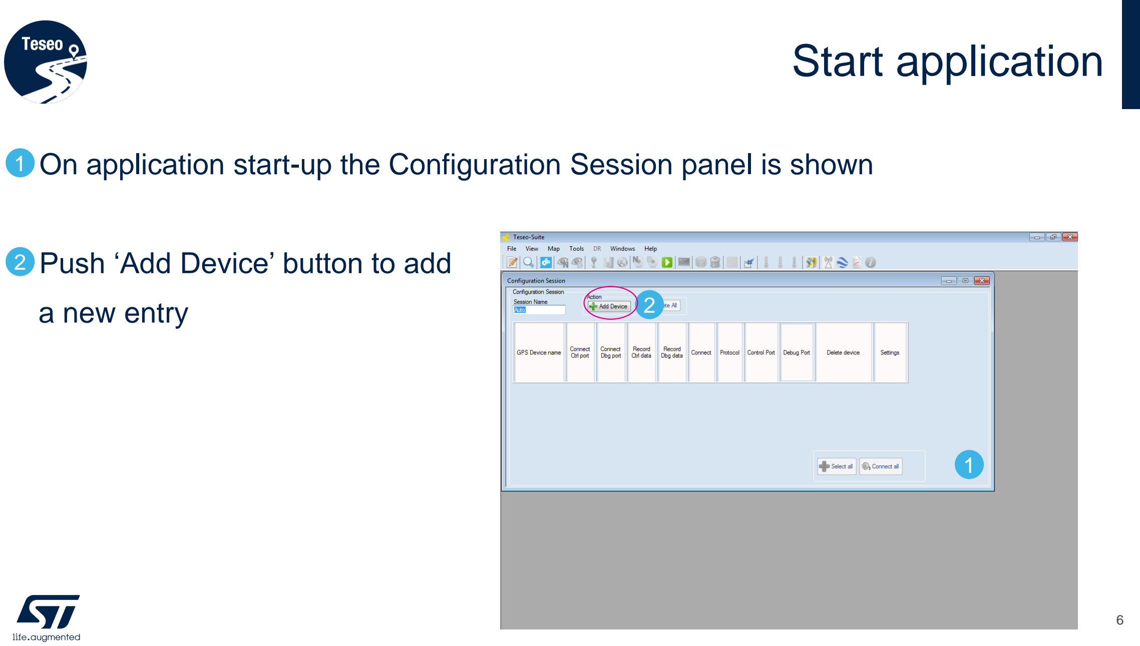
[picture p221: page 6]

### - On application start-up the Configuration Session panel is shown

### - Push ‘Add Device’ button to add

### a new entry

1

1

2

2

# Configuration device

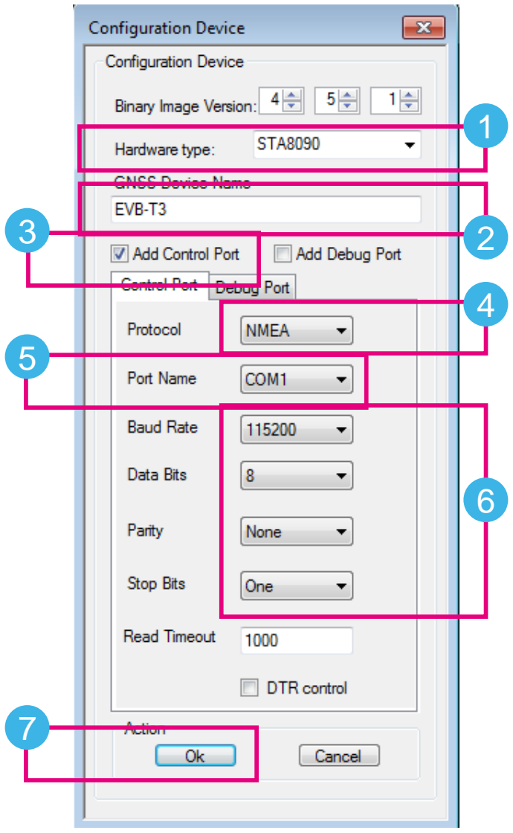
[picture p222: figure]

1

2

3

4

5

6

Set the Hardware type: STA8090

Set the GNSS Device Name: EVB-T3

Enable Add Control Port

Set the Protocol: NMEA

Set the Port Name: according to the discovered on the PC

Configure the port as following table:

Click-on the Ok button

Baud rate | Data Bits | Stop Bits | Parity | Handshake
115200 bps | 8 Bits | 1 Bit | none | none

7

### - In the Configuration Session panel a new entry (row) is shown

### - Enable Connect Ctrl port

### - Click-on the Connect all button

# Connect the device

1

2

3

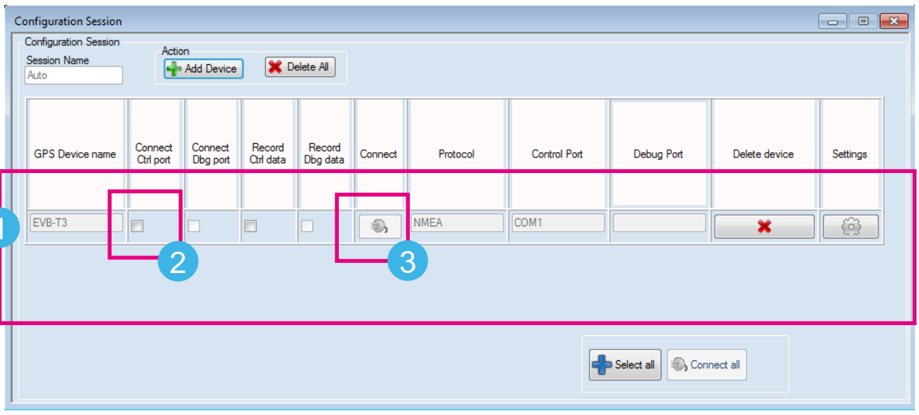
[picture p223: figure]

1

# Inspect device

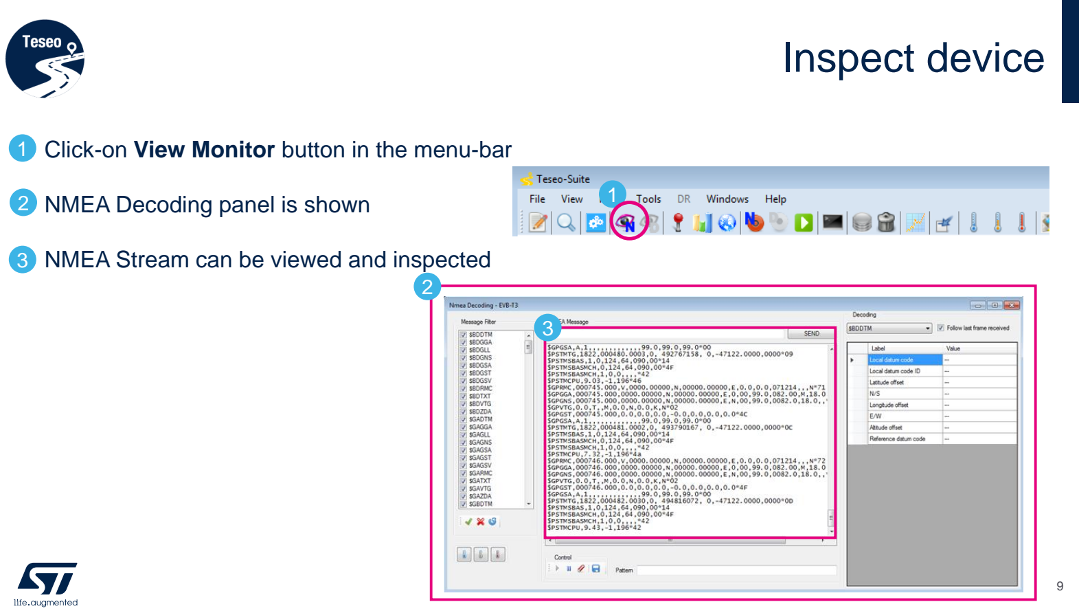
[picture p224: page 9]

2

3

Click-on View Monitor button in the menu-bar

NMEA Decoding panel is shown

NMEA Stream can be viewed and inspected

1

1

2

3

### - In the Configuration Session panel entry (row)

### - Click-on the Disconnect button

# Disconnect the device

1

2

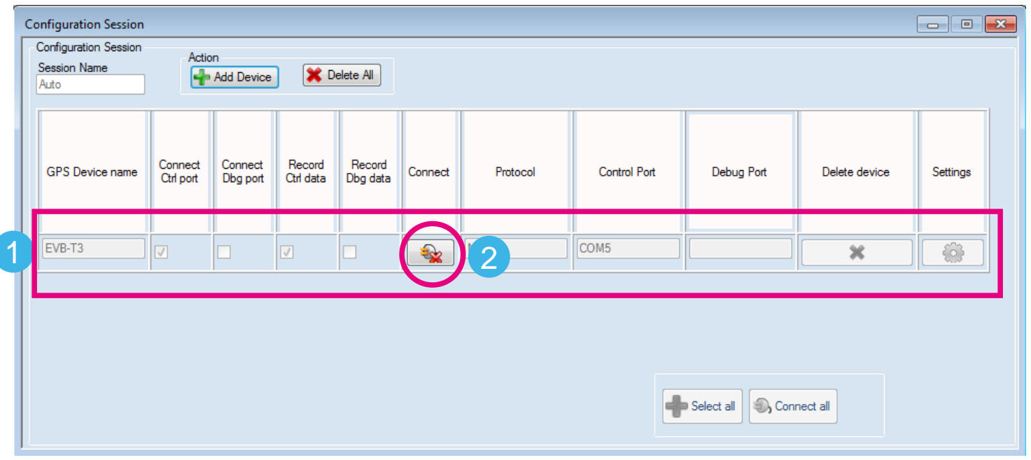
[picture p225: figure]

# Quick start guide - Contents

Basic commands

1

2

3
4 Documents & related resources Advanced features

Introduction

# Basic commands - Contents

1

2

3

4

Send Commands

Map View

Signal Level

Filter the message list

5

6

Recod a NMEA Log

Play a NMEA Log

# Send commands

2

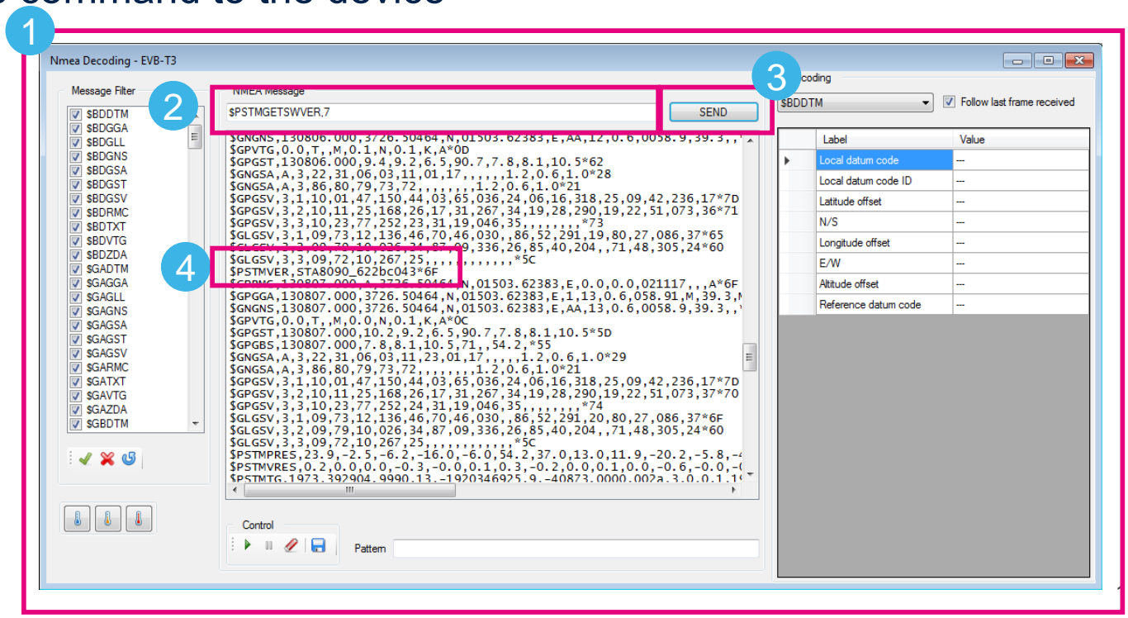
[picture p226: figure]

3

4

1 In the ‘Nmea Decoding’ panel

Write the ‘command’ in the text-edit entry

Click-on the ‘Send’ button to raise the command to the device

Inspect the replay message in the

NMEA Stream

# Filter the message list

1 In the ‘Nmea Decoding’ panel

Select the messages you want

Refresh the new message-list into the device

2

3

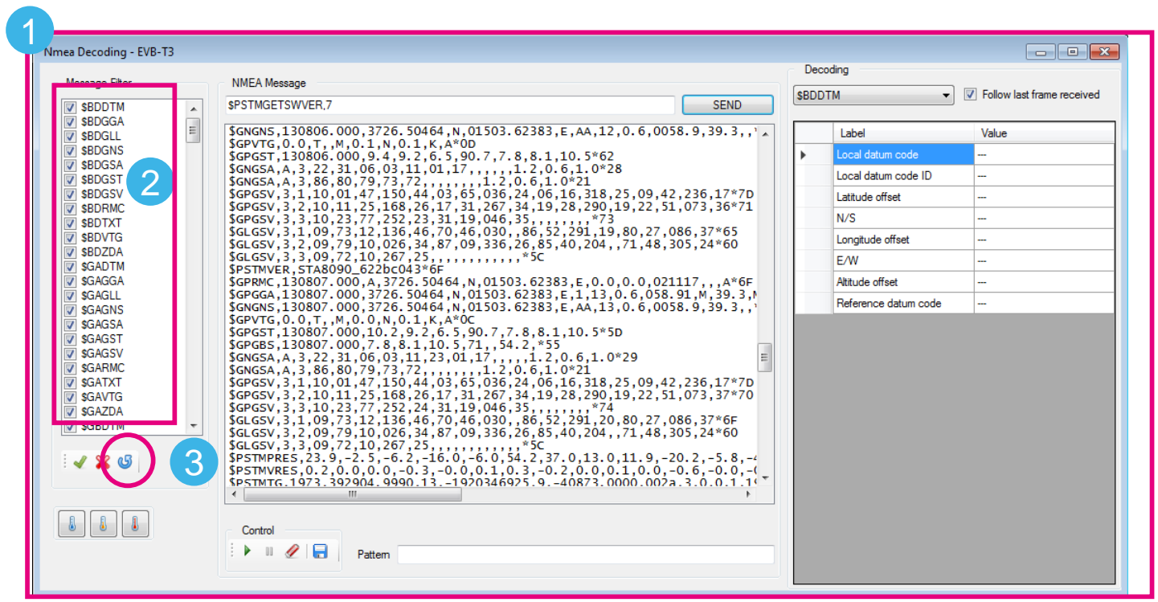
[picture p227: figure]

# Map view

1 Click-on ‘Map View’ button in the menu

2 Inspect the position in the ‘Map View’ panel

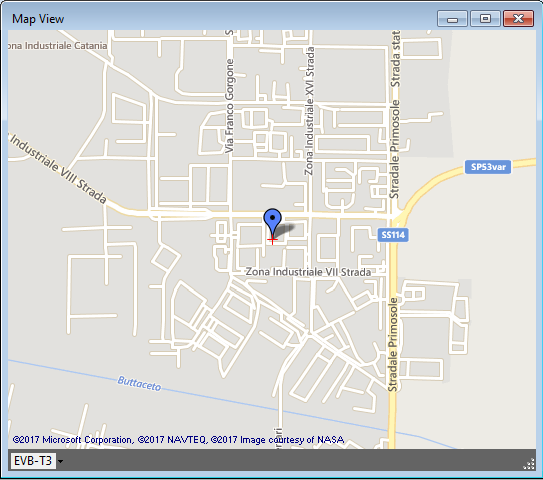
[picture p228: figure]

2

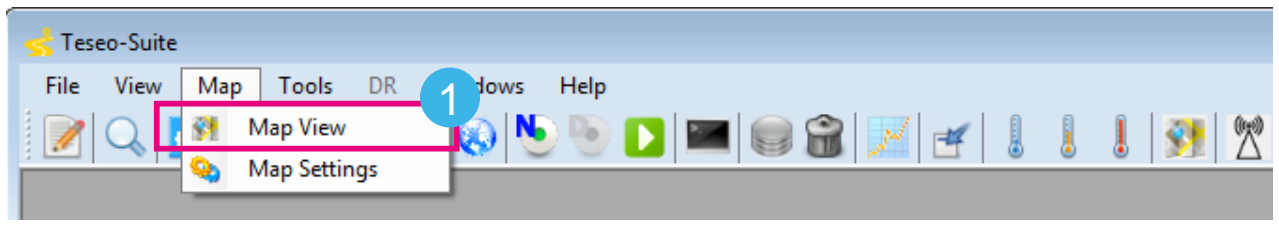
[picture p229: figure]

# Signal levels

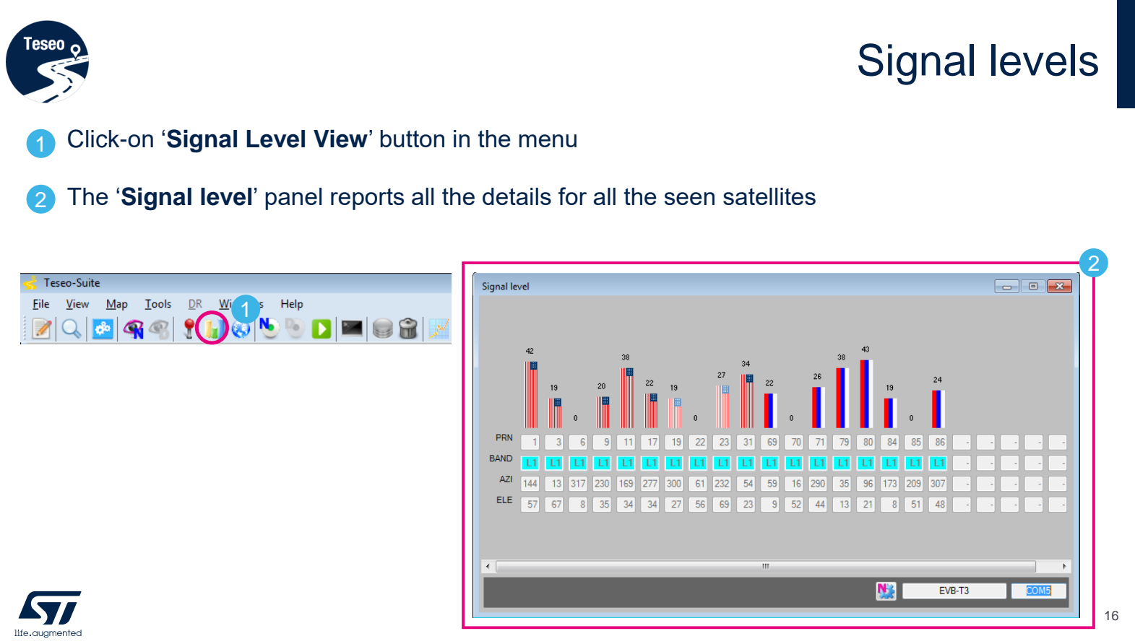
[picture p230: page 16]

1 Click-on ‘Signal Level View’ button in the menu

The ‘Signal level’ panel reports all the details for all the seen satellites

1

2

2

# Record a NMEA log session

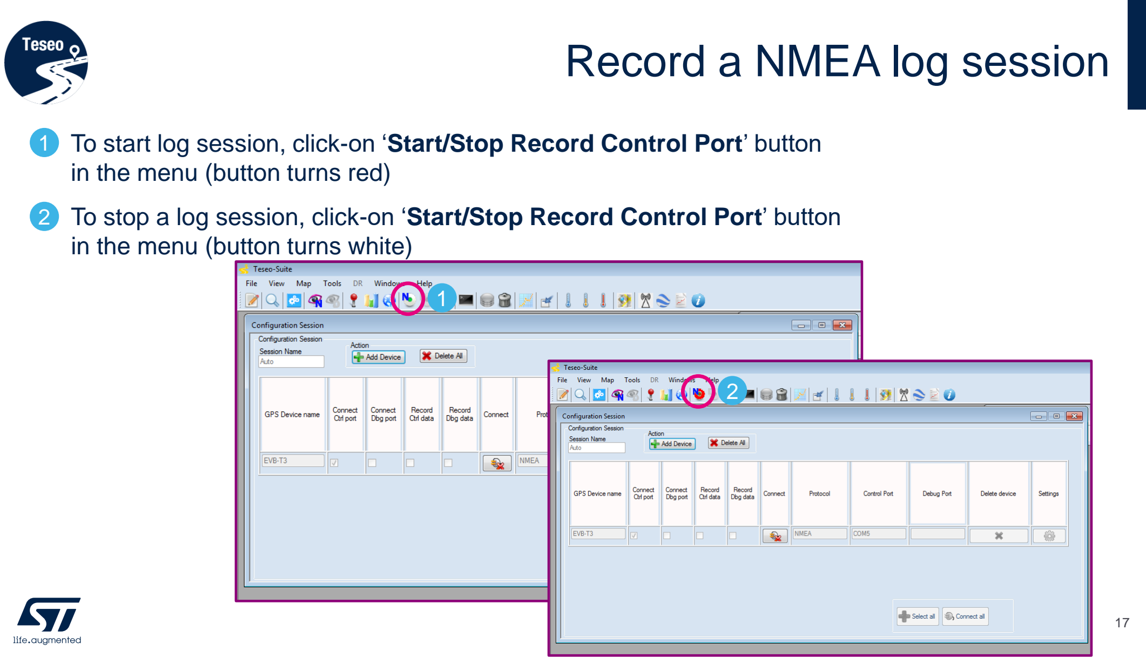
[picture p231: page 17]

1 To start log session, click-on ‘Start/Stop Record Control Port’ button in the menu (button turns red)

2 To stop a log session, click-on ‘Start/Stop Record Control Port’ button in the menu (button turns white)

1

2

# Play a NMEA log session [1/4]

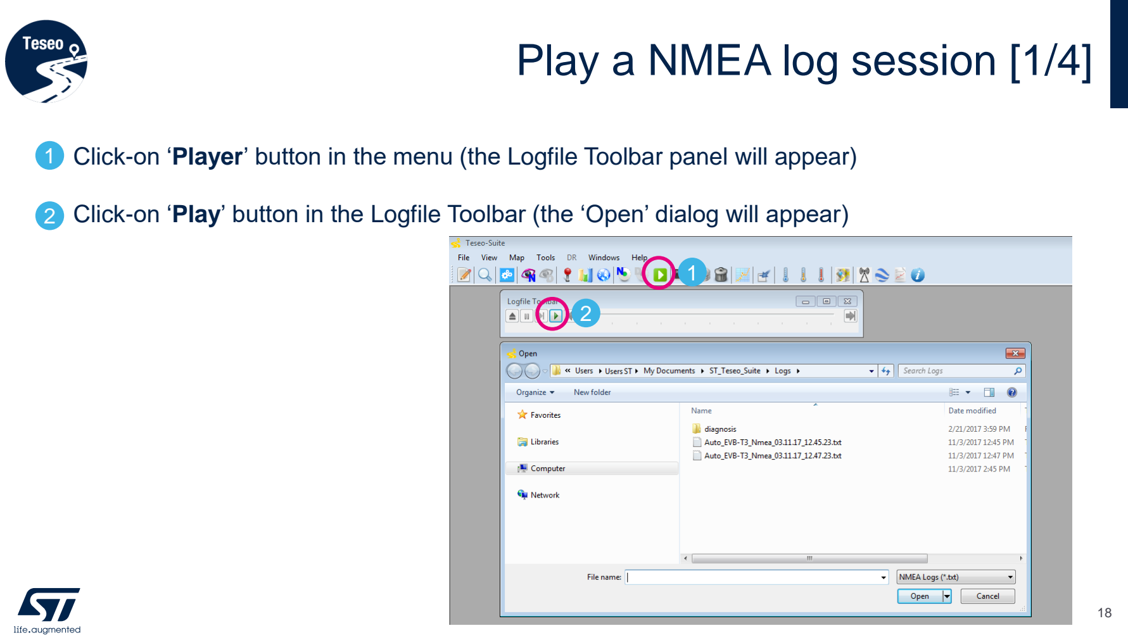
[picture p232: page 18]

1 Click-on ‘Player’ button in the menu (the Logfile Toolbar panel will appear)

2 Click-on ‘Play’ button in the Logfile Toolbar (the ‘Open’ dialog will appear)

1

2

# Play a NMEA log session [2/4]

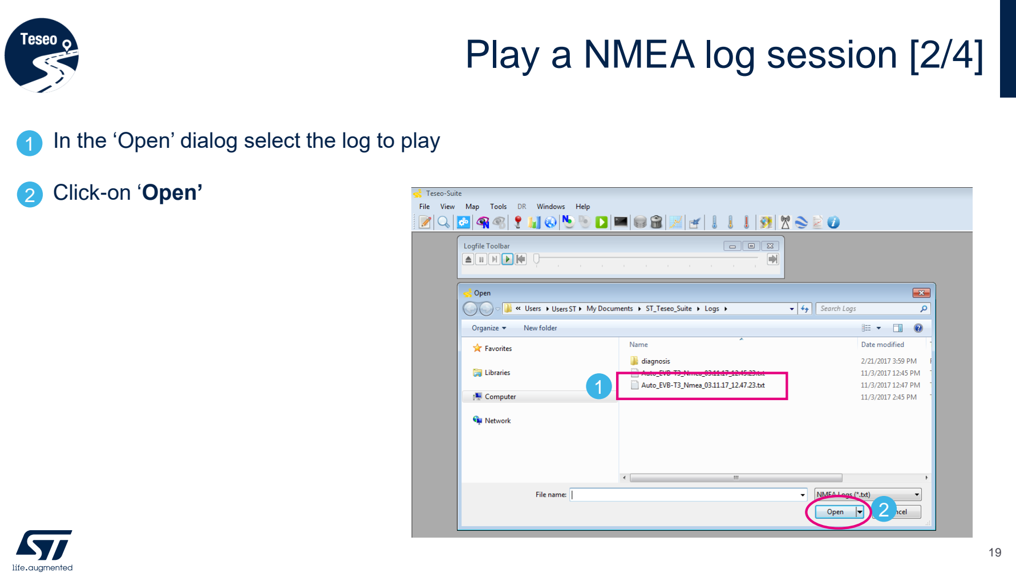
[picture p233: page 19]

1 In the ‘Open’ dialog select the log to play

2 Click-on ‘Open’

1

2

# Play a NMEA log session [3/4]

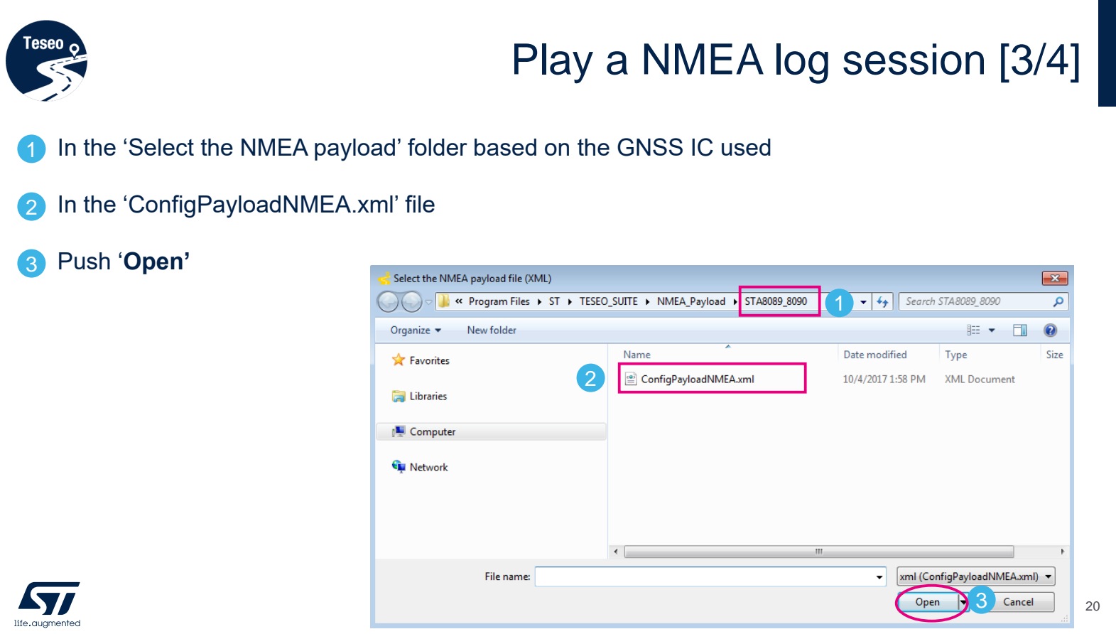
[picture p234: page 20]

2

3

2

1

1 In the ‘Select the NMEA payload’ folder based on the GNSS IC used

In the ‘ConfigPayloadNMEA.xml’ file

Push ‘Open’

# Play a NMEA log session [4/4]

1 In the Logfile Toolbar panel all the buttons are enabled and you can start, stop, rewind the log as a standard tape

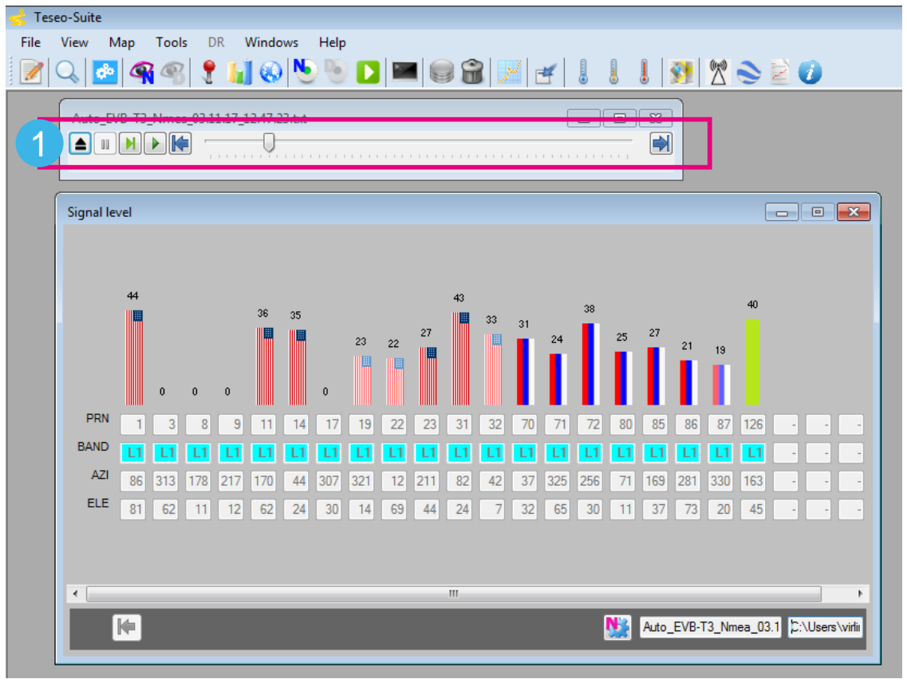
[picture p235: figure]

# Quick start guide - Contents

Advanced Features

Introduction

Basic commands

Documents & related resources

1

3

2

4

# Advanced features - Contents

1 | Update Boot and GNSSLib
2 | Update GNSSLib only
3 | Firmware configuration

# Update bootloader and gnsslib

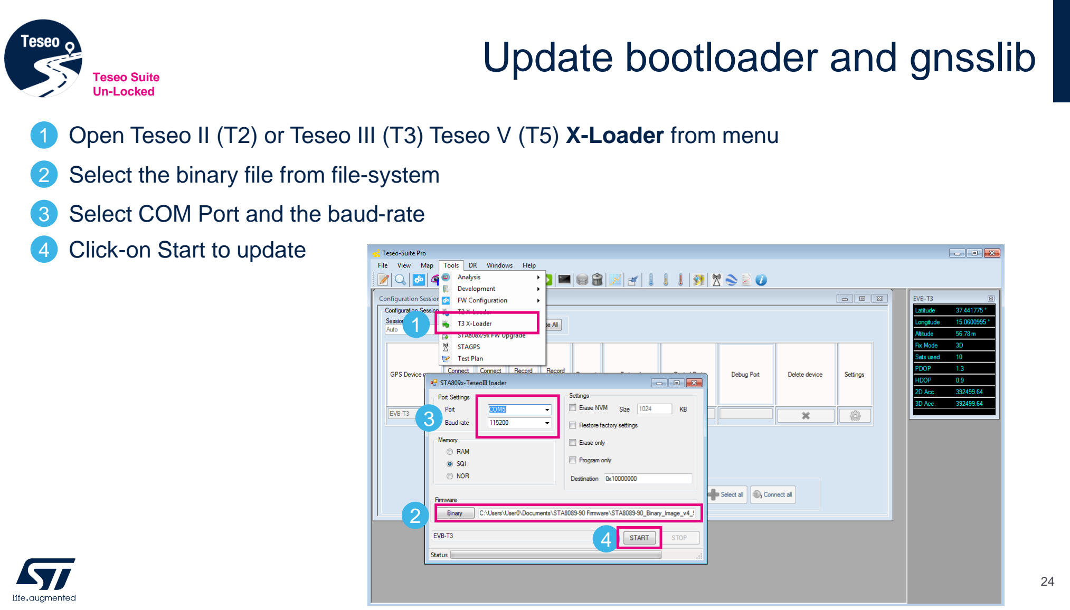
[picture p236: page 24]

Teseo Suite
Un-Locked

1

1 Open Teseo II (T2) or Teseo III (T3) Teseo V (T5) X-Loader from menu

2 Select the binary file from file-system

2

3 Select COM Port and the baud-rate

3

4 Click-on Start to update

4

# Update gnss-lib

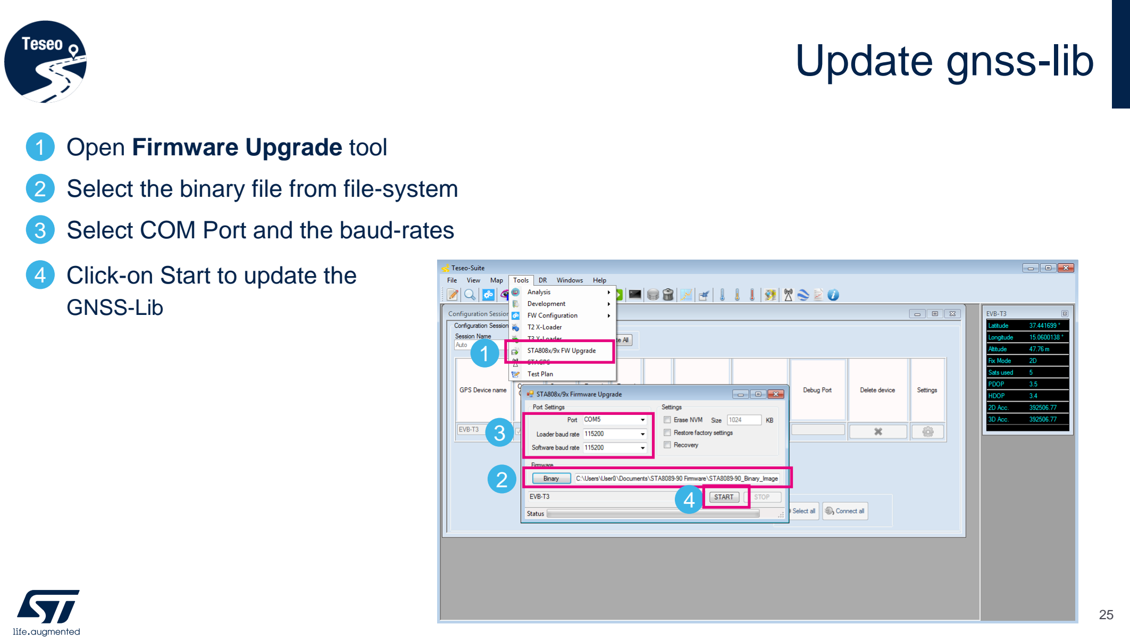
[picture p237: page 25]

1

1 Open Firmware Upgrade tool

2 Select the binary file from file-system

2

3 Select COM Port and the baud-rates

3

4 Click-on Start to update the

4

GNSS-Lib

# Firmware configuration [1/2]

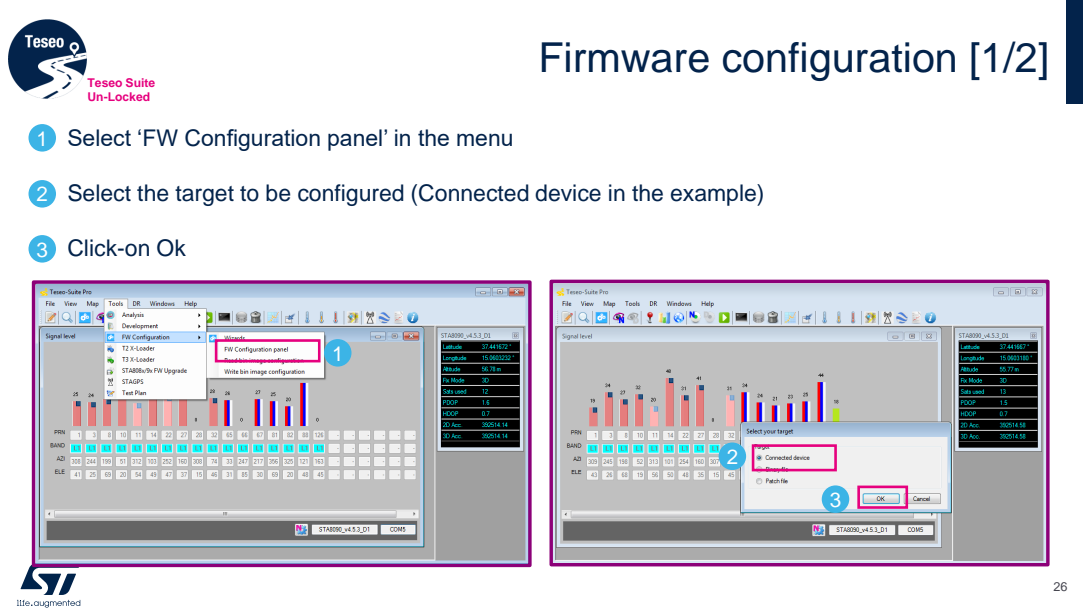
[picture p238: page 26]

Teseo Suite
Un-Locked
1 Select ‘FW Configuration panel’ in the menu

Select the target to be configured (Connected device in the example)

Click-on Ok

# Firmware configuration [2/2]

1 Expand the CDB-ID number under configuration

2 Select the specified field under configuration

3 Enable the field and/or set the right value (Galileo constellation is enabled in the example)
4 Apply the change to the device

Teseo Suite
Un-Locked

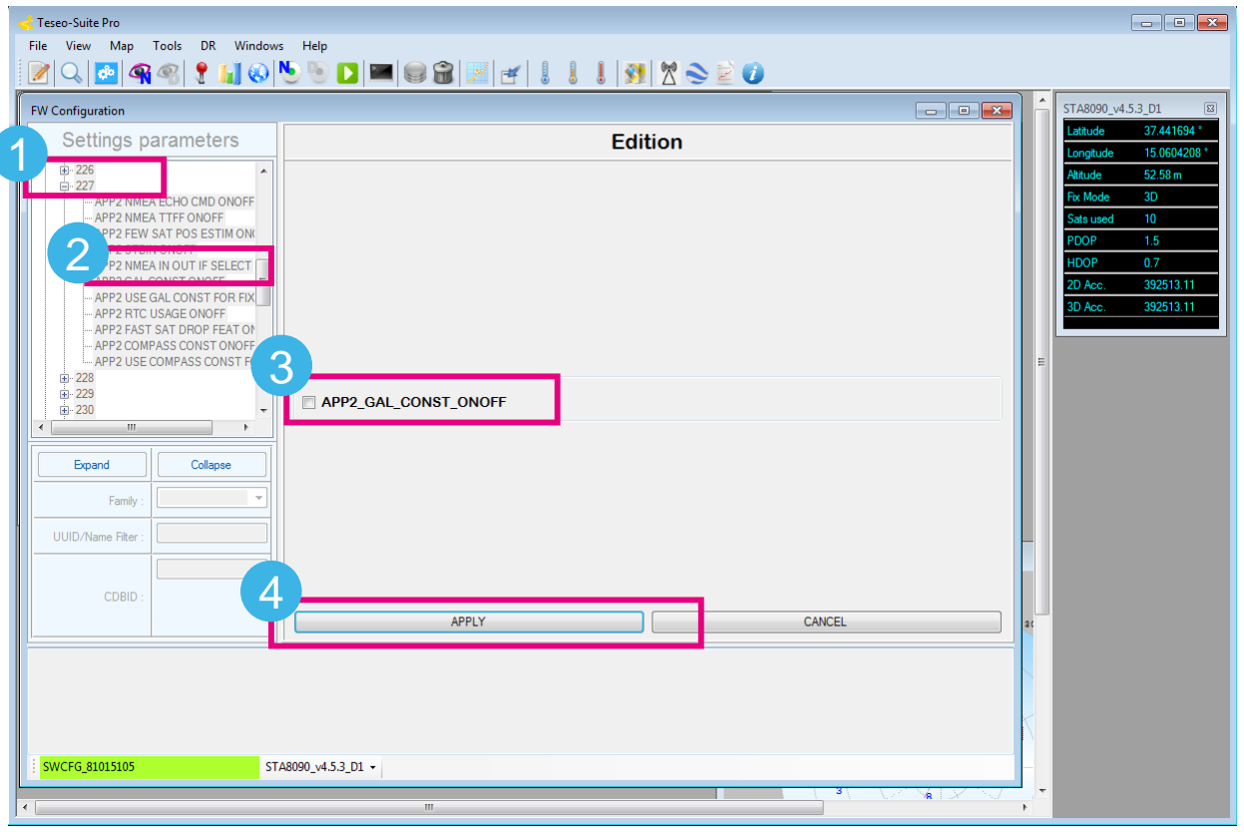
[picture p239: figure]

# Quick start guide - Contents

Documents & related resources

1 | Introduction
2 | Basic commands
3 | Advanced features

4

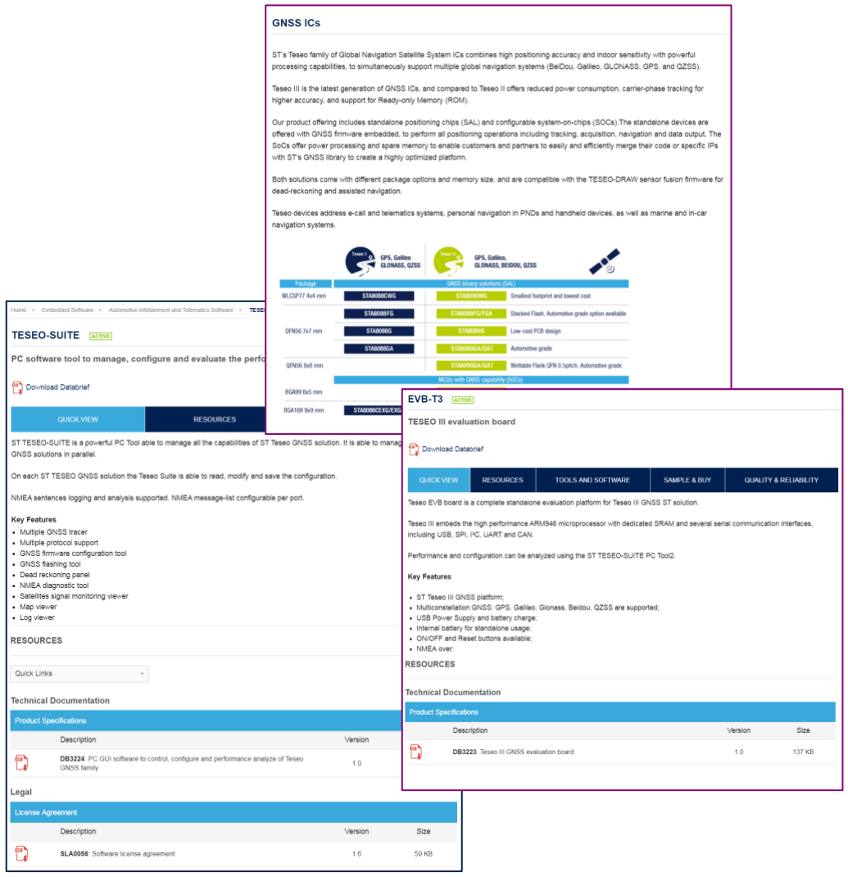
[picture p240: figure]

### - Teseo Modules: Webpage (https://www.st.com/gnssmodules)

- Data-sheet of all PNs;
- Teseo III: Webpage (http://www.st.com/content/st_com/en/products/positioning/gnss-ics.html?querycriteria=productId=SC2194)
- Data-sheet of all PNs;
- Teseo Suite: Webpage (http://www.st.com/content/st_com/en/products/embedded-software/automotive-infotainment-and-telematics-software/teseo-suite.html)
- Datasheet
- Install program

# Documents & related resources

All documents are available on: www.st.com

# Teseo Suite – Extra features

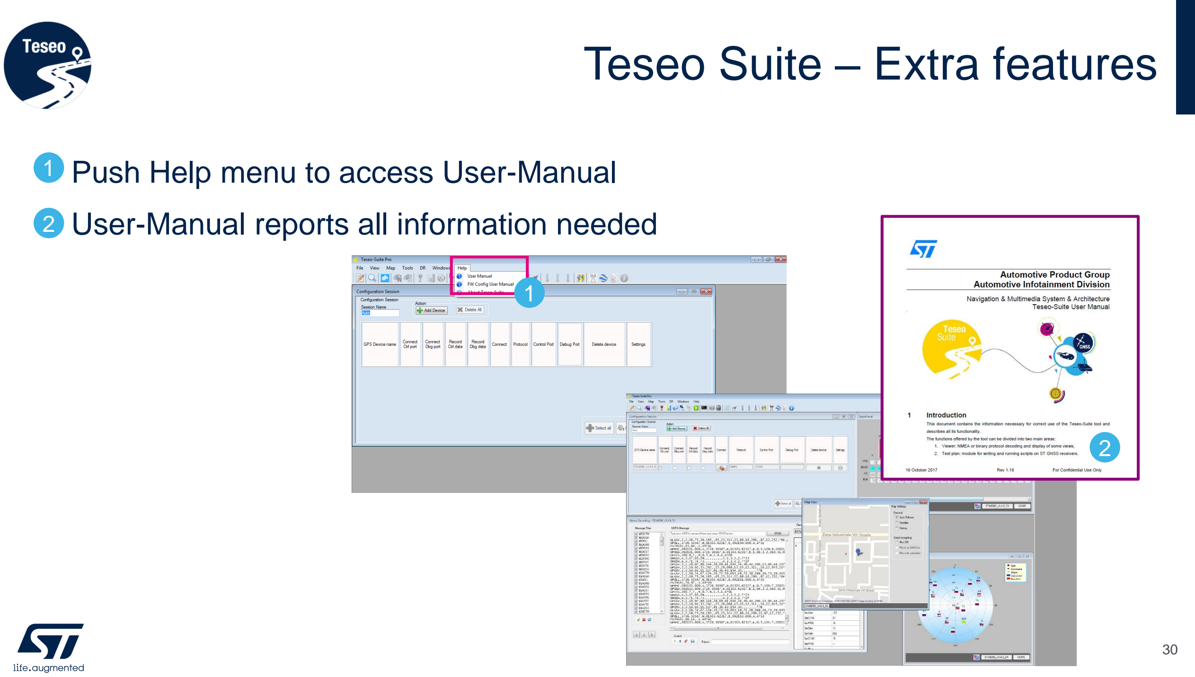
[picture p241: page 30]

### - Push Help menu to access User-Manual

### - User-Manual reports all information needed

1

2

2

1

### - Now you can develop your GNSS solution with ST Teseo III, ST Teseo Module and ST Teseo V using Teseo-Suite to explore all the available features

# Enjoy GNSS solution development with Teseo-Suite

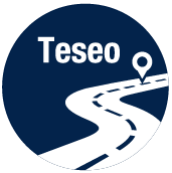
[picture p242: figure]
