bismarx-v1/GPS-Compass/docs/TESEO_docs/Teseo-Suite_SW_test_guide.pdf

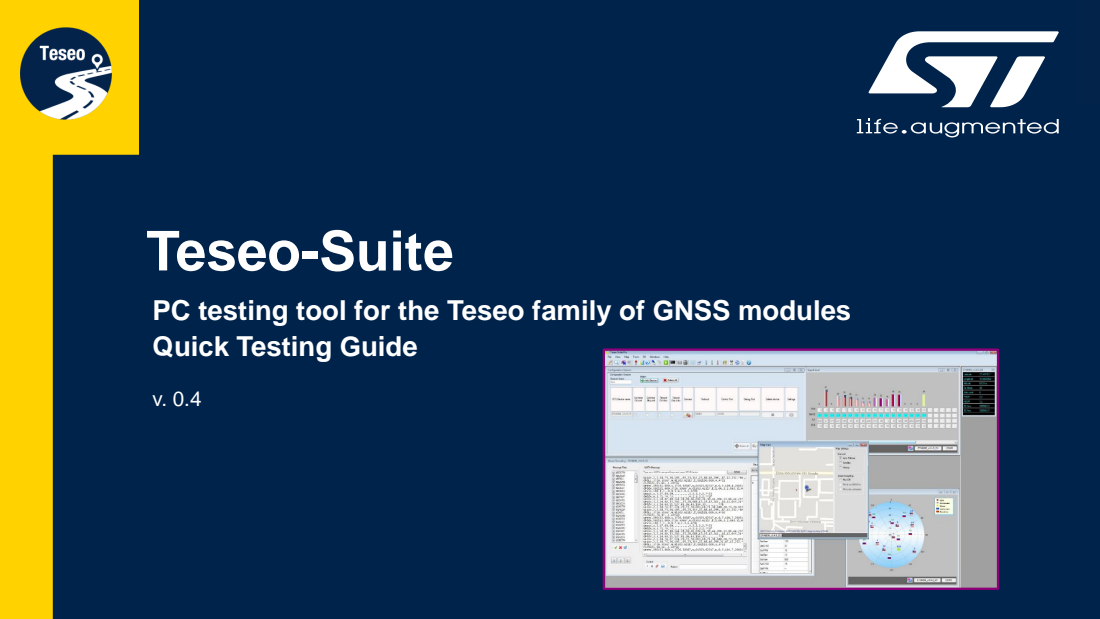
[picture p243: page 1]
Teseo-Suite

PC testing tool for the Teseo family of GNSS modules
Quick Testing Guide

## Quick testing guide - contents

Introduction

A quick test script – step by step

Advanced scripts

Documents & related resources

1

4

3

2

## Quick testing guide - introduction

Introduction

A quick test script – step by step

Advanced scripts

Documents & related resources

1

4

3

2

- Teseo-Suite is a valuable tool to test and evaluate the features of Teseo GNSS modules
- It has an internal scripting language which allows automatizing test scripts for Teseo GNSS receivers
- Let’s see how it can help evaluate Teseo GNSS solutions

## Teseo Suite as test program

- Connects your Teseo platform (see more) (http://www.st.com/resource/en/product_presentation/teseosuite-presentation.pdf)

## Connects the Teseo platform

1

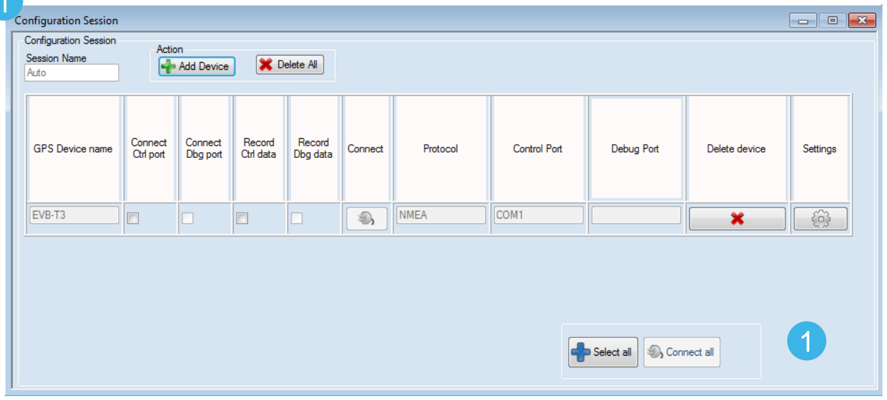
[picture p244: figure]

1

## Open test plan panel

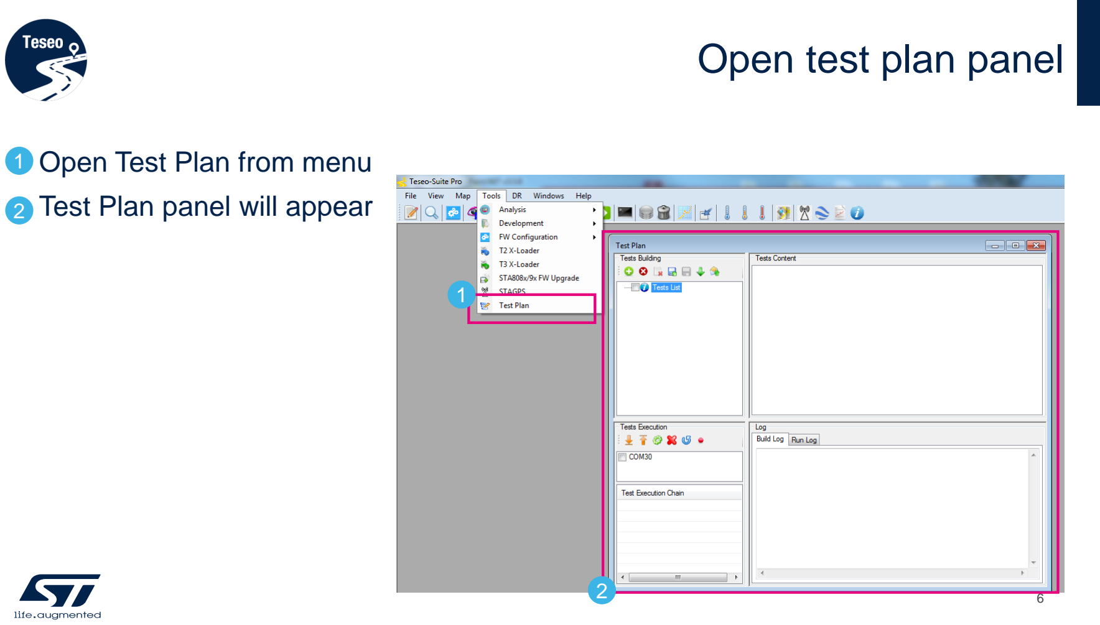
[picture p245: page 6]

- Open Test Plan from menu
- Test Plan panel will appear

1

2

1

## Test plan panel description

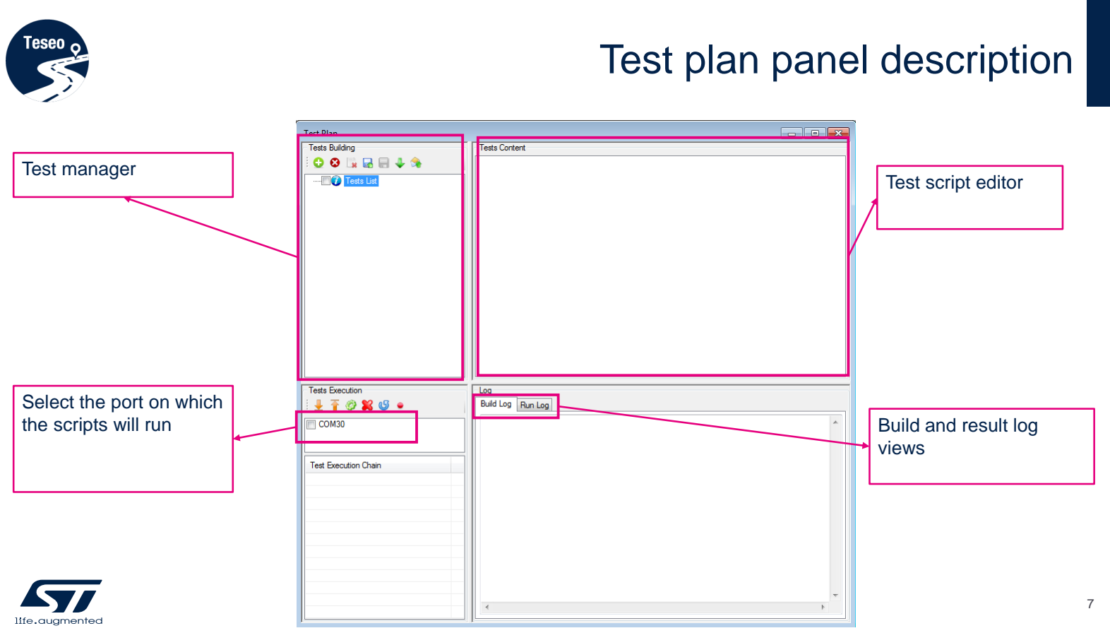
[picture p246: page 7]

Select the port on which
the scripts will run | Build and result log
| views

Test script editor Test manager

## Quick testing guide - introduction

3

4

Advanced scripts

Documents & related resources

2 | A quick test script – step by step
1 | Introduction

## A quick test script – step by step

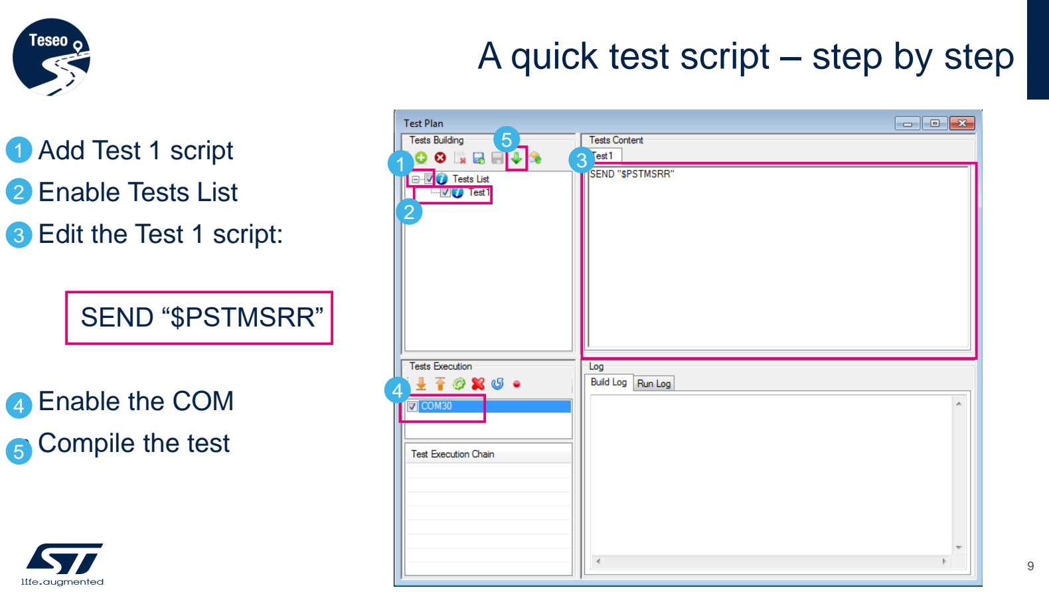
[picture p247: page 9]

- Add Test 1 script
- Enable Tests List
- Edit the Test 1 script:

SEND “$PSTMSRR”

- Enable the COM
- Compile the test

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
## A quick test script – step by step

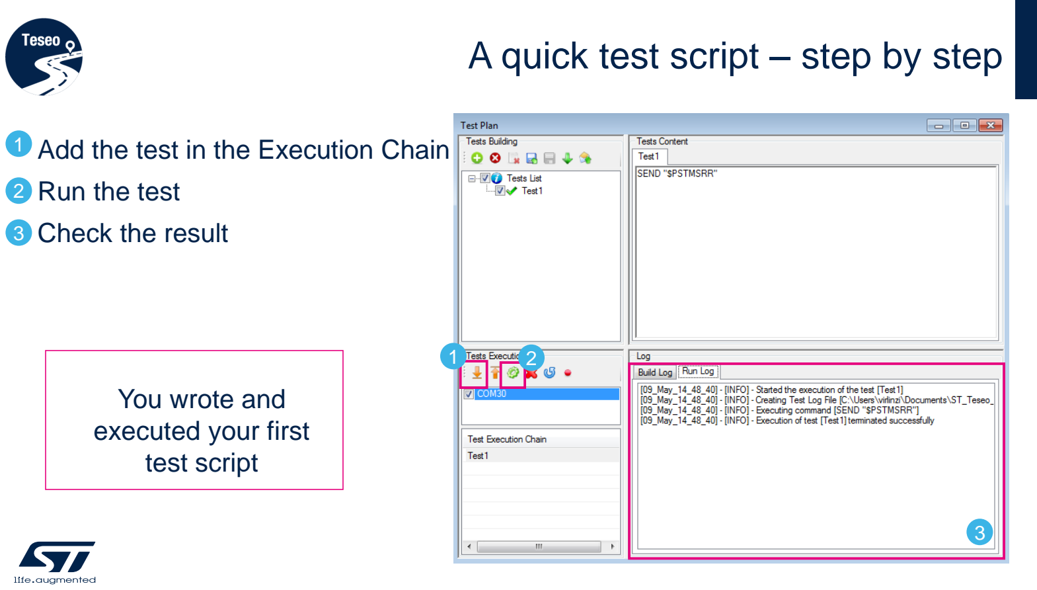
[picture p248: page 10]

- Add the test in the Execution Chain
- Run the test
- Check the result

1

2

3

1

3

2
You wrote and
executed your first
test script

## Quick testing guide – advanced scripts

4 | Documents & related resources
1 | Introduction
3 | Advanced scripts
2 | A quick test script – step by step

## SEND keyword

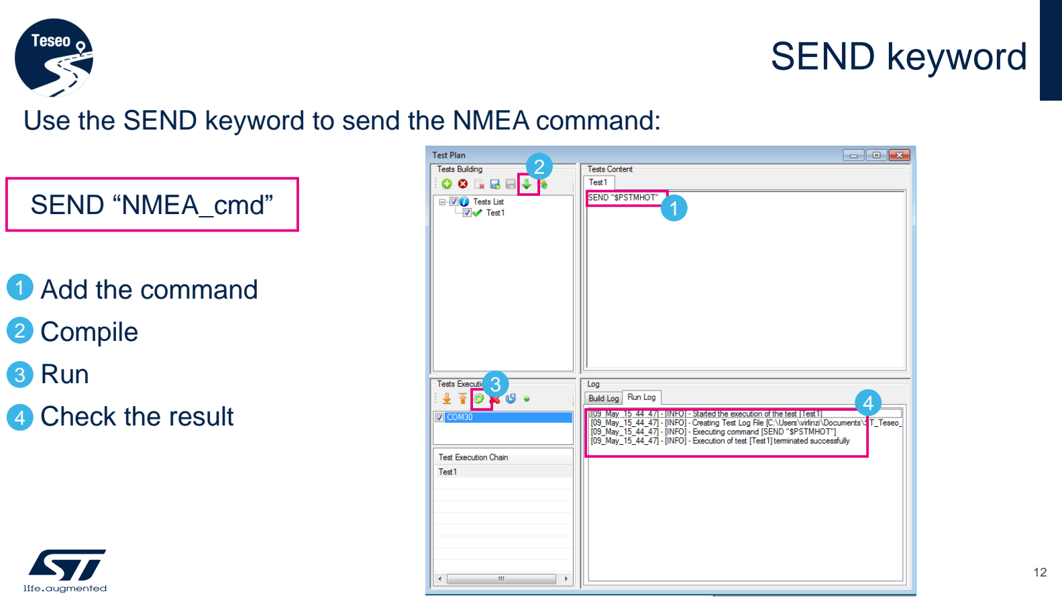
[picture p249: page 12]

Use the SEND keyword to send the NMEA command:

SEND “NMEA_cmd”

- Add the command
- Compile
- Run
- Check the result

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
## DELAY keyword

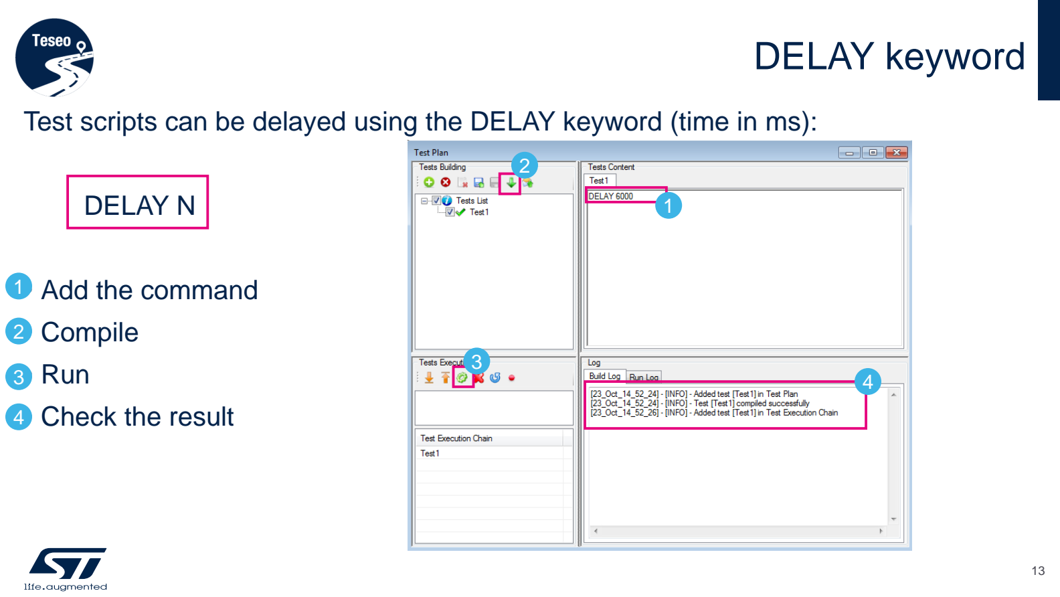
[picture p250: page 13]

Test scripts can be delayed using the DELAY keyword (time in ms):

DELAY N

- Add the command
- Compile
- Run
- Check the result

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
## WAITFIX keyword

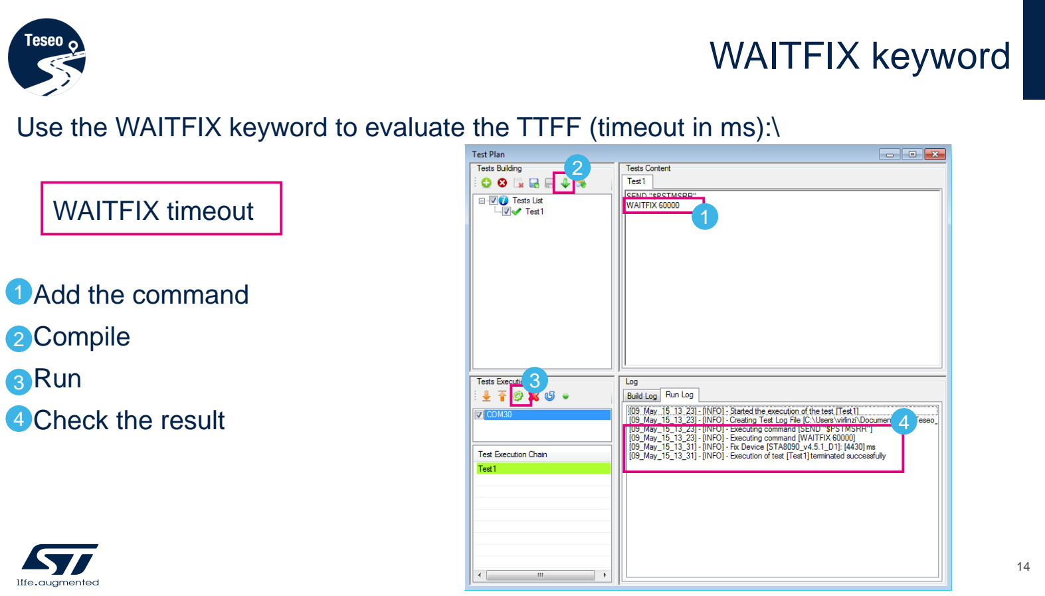
[picture p251: page 14]

Use the WAITFIX keyword to evaluate the TTFF (timeout in ms):\

WAITFIX timeout

- Add the command
- Compile
- Run
- Check the result

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
## LOOP/ENDLOOP keywords

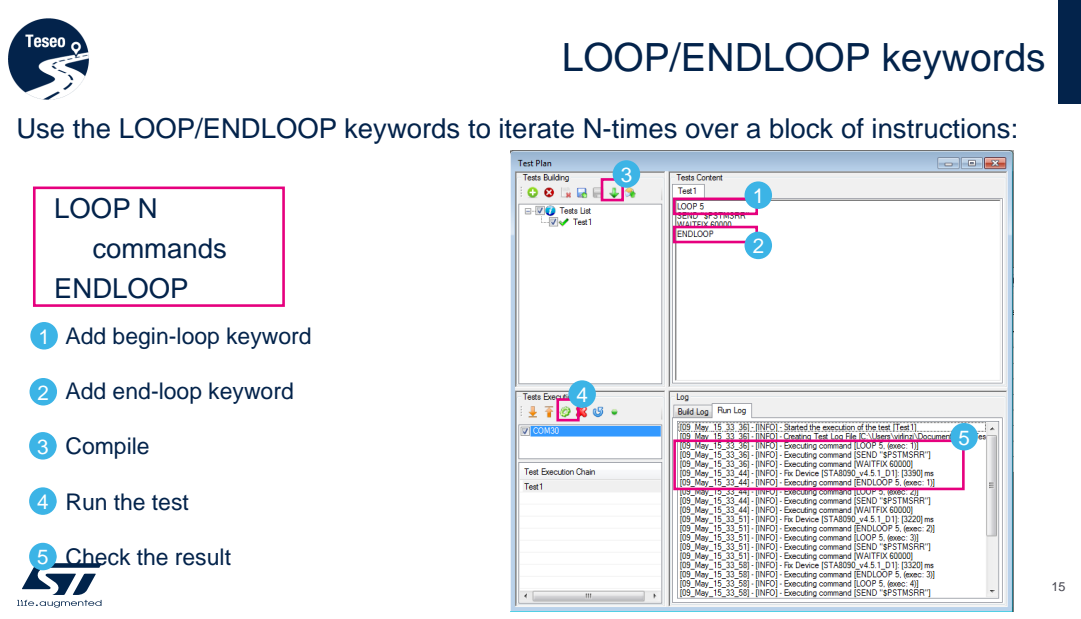
[picture p252: page 15]
LOOP N; commands; ENDLOOP; • Compile

Use the LOOP/ENDLOOP keywords to iterate N-times over a block of instructions:

• Add begin-loop keyword

• Add end-loop keyword

• Run the test

• Check the result

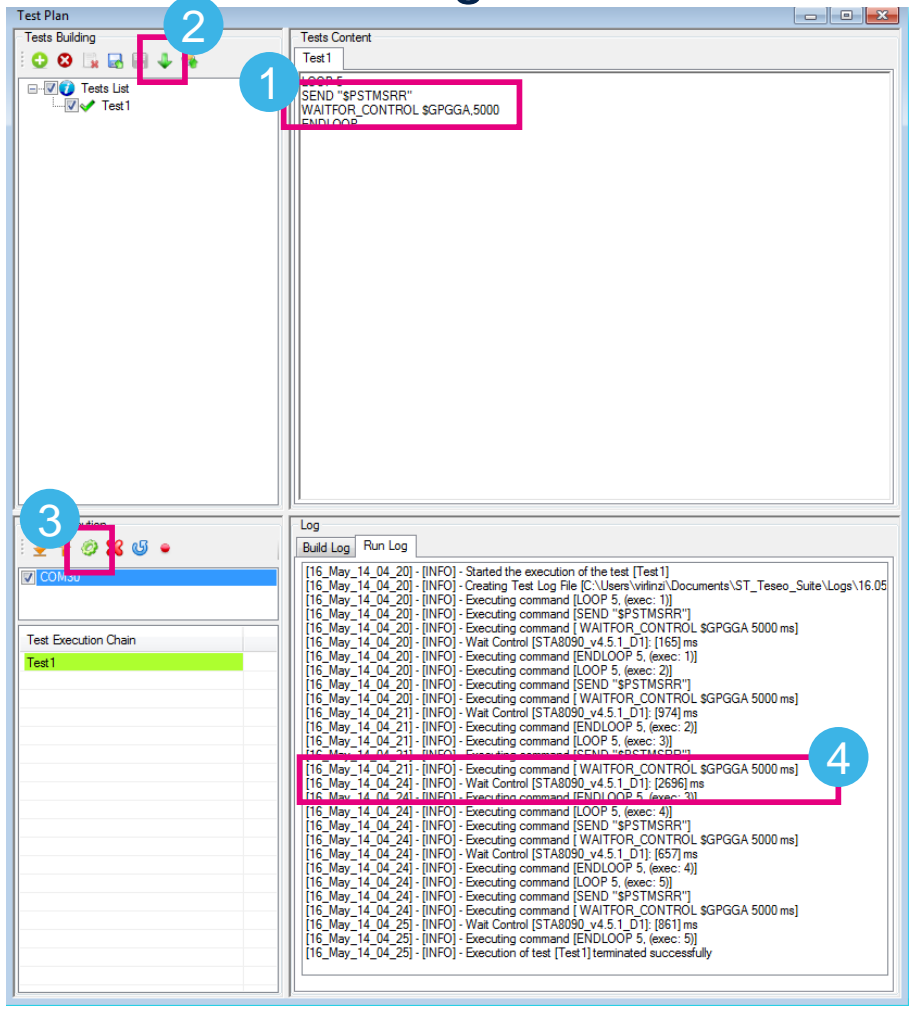
[picture p253: figure]

Usethe WAITFOR_CONTROL keyword to wait for a NMEA message

WAITFOR _CONTROL NMEA_msg, timeout

## WAITFOR_CONTROL keyword

1

2

3

- Add WAITFOR_CONTROL keyword
- Compile
- Run the test

4• Check the result

## Teseo suite – extra features

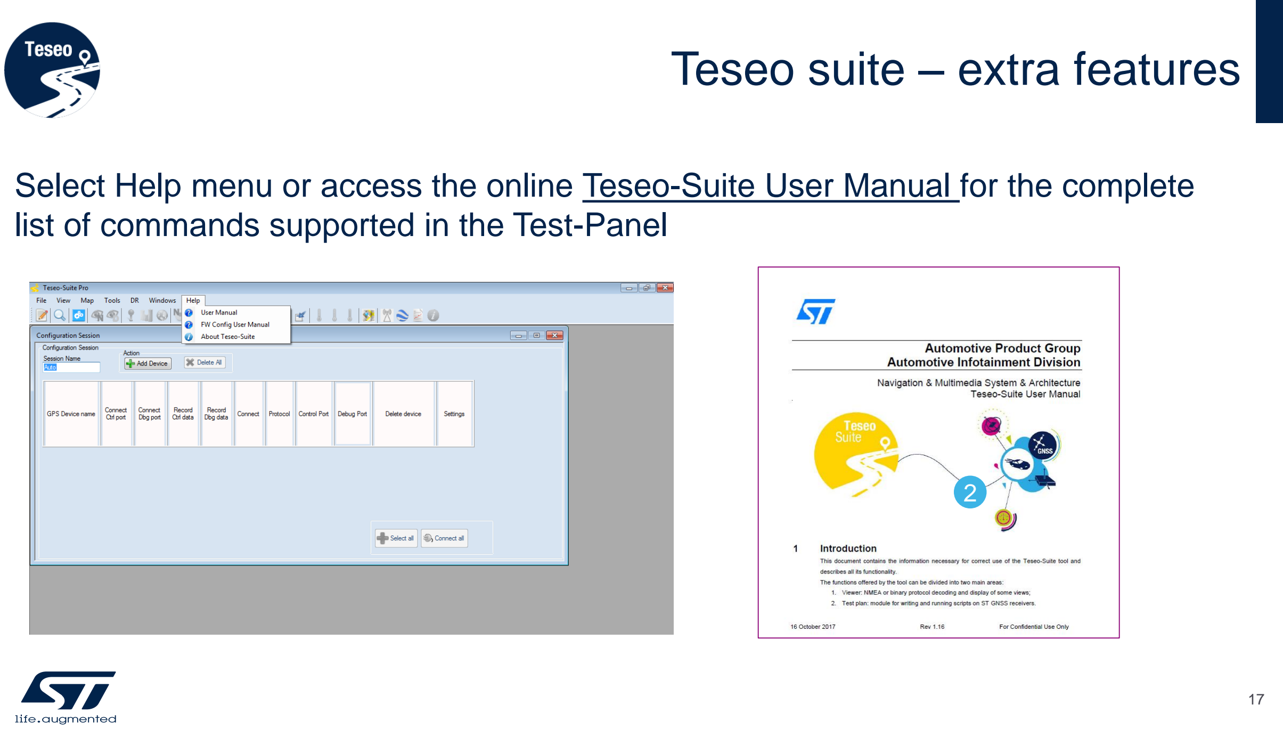
[picture p254: page 17]

Select Help menu or access the online Teseo-Suite User Manual (https://www.st.com/resource/en/user_manual/dm00509546.pdf) for the complete list of commands supported in the Test-Panel

2

## Quick testing guide - contents

Documents & related resources

1 | Introduction
3 | Advanced scripts

4

2 A quick test – step by step

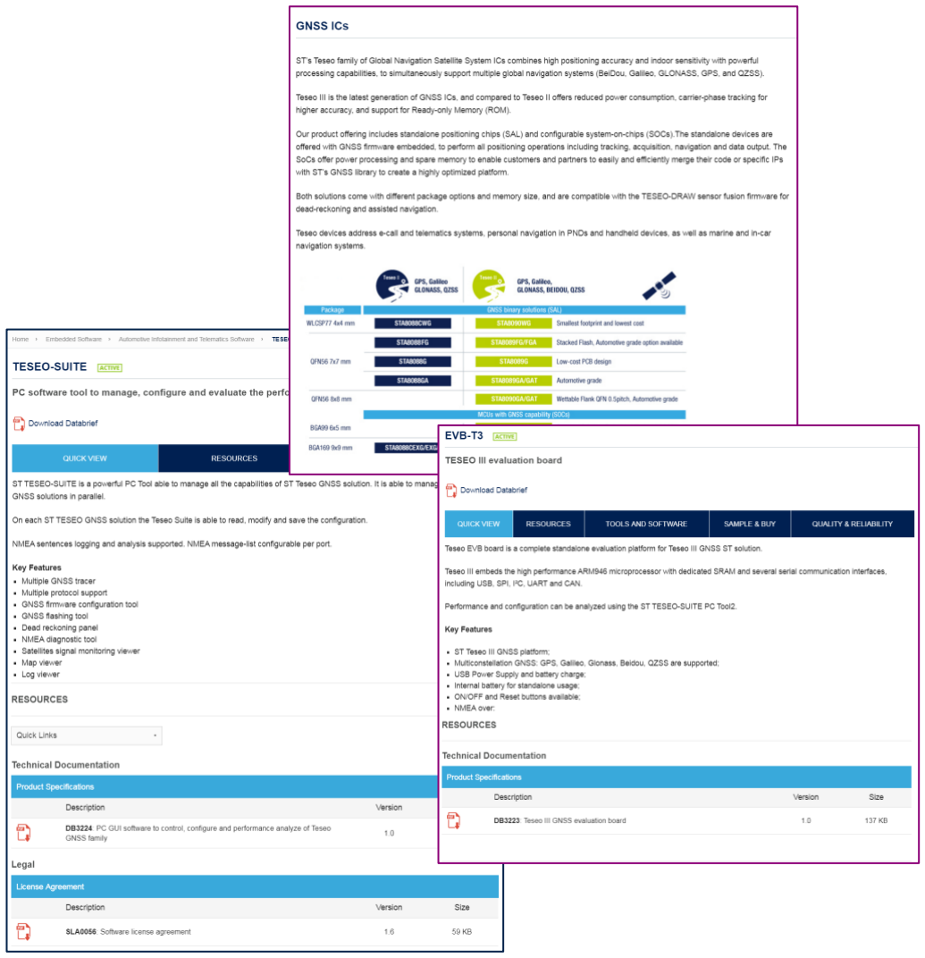
[picture p255: figure]

- Teseo III: Webpage (http://www.st.com/content/st_com/en/products/positioning/gnss-ics.html?querycriteria=productId=SC2194)
- Data-sheet of all PNs;
- Teseo modules: Webpage (https://www.st.com/content/st_com/en/products/positioning/gnss-modules.html)
- Data-sheet of all PNs;
- Teseo Suite: Webpage (http://www.st.com/content/st_com/en/products/embedded-software/automotive-infotainment-and-telematics-software/teseo-suite.html)
- Datasheet
- Install program

## Documents & related resources

All documents are available on: www.st.com

- Now you can develop your GNSS solution with ST Teseo II, ST Teseo III and ST Teseo Modules using the Teseo-Suite PC software tool to explore all the available features.

## Enjoy developing your GNSS solution using Teseo-Suite
