bismarx-v1/GPS-Compass/_mechanical/GPS-Compass_assembly/drawings/GPS-Compass_manual.png

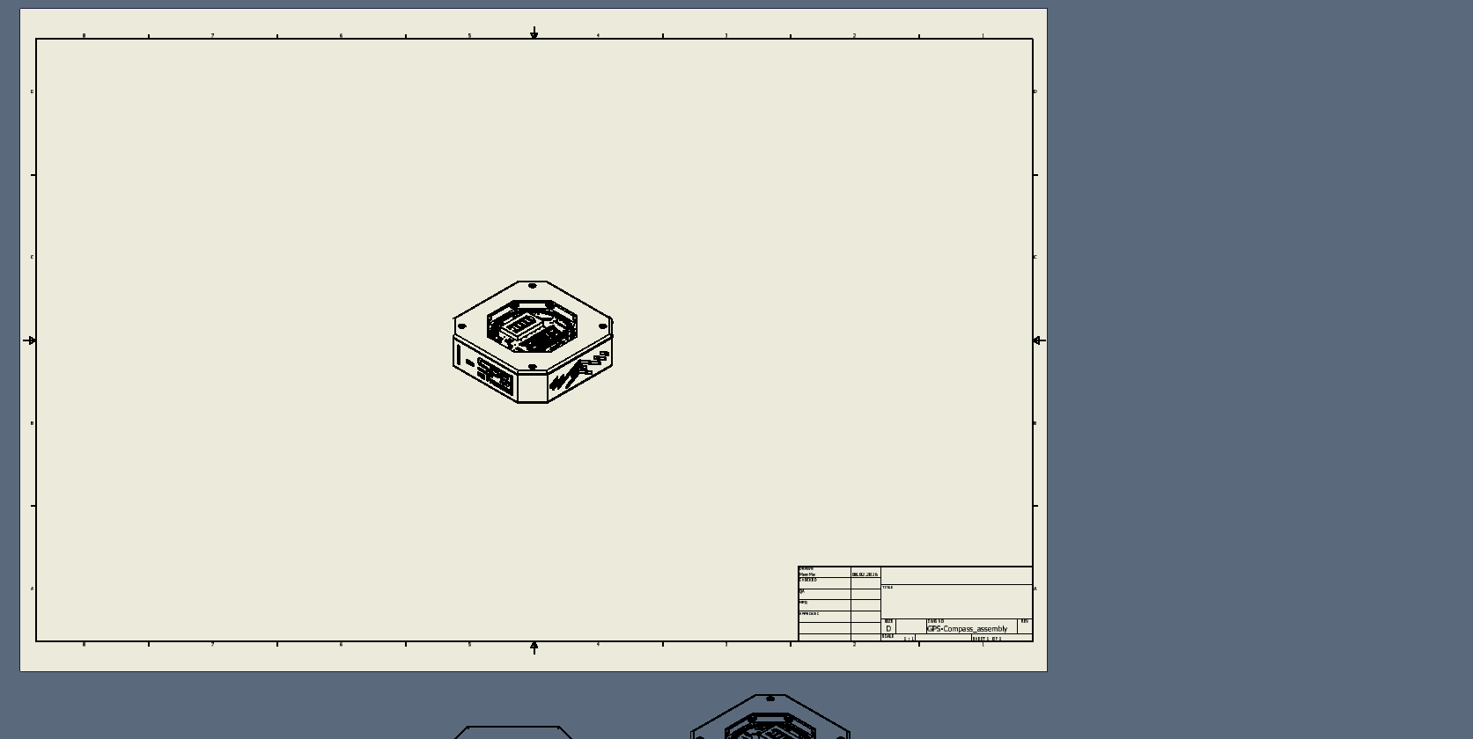
_mechanical/GPS-Compass_assembly/drawings/GPS-Compass_manual.png
