bismarx-v1/GPS-Compass/_media/PCB_Renders/assembly_PCB_render.png

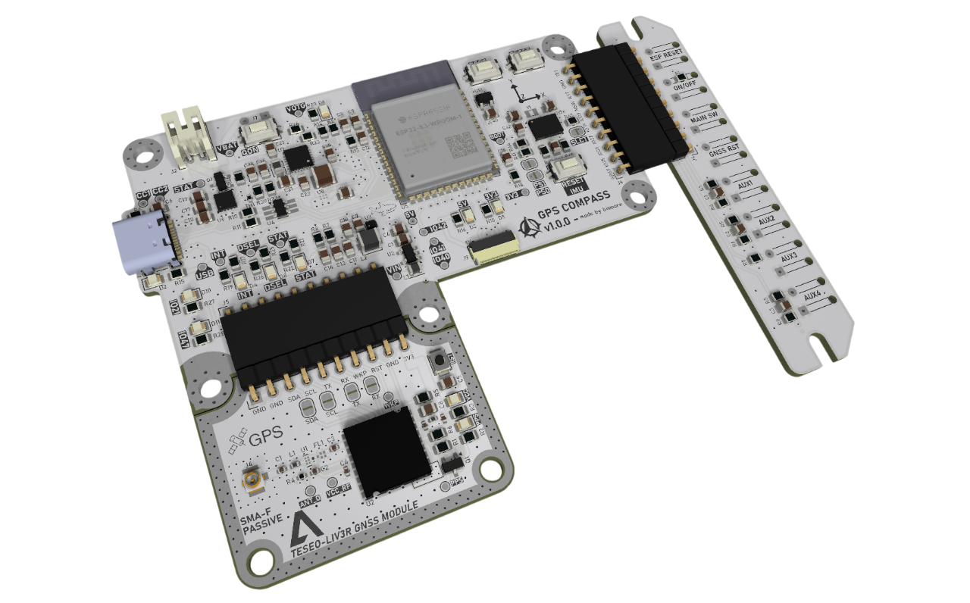
_media/PCB_Renders/assembly_PCB_render.png
