bismarx-v1/GPS-Compass/_media/renders/GPS-Compass_assembly_black_arrows.png

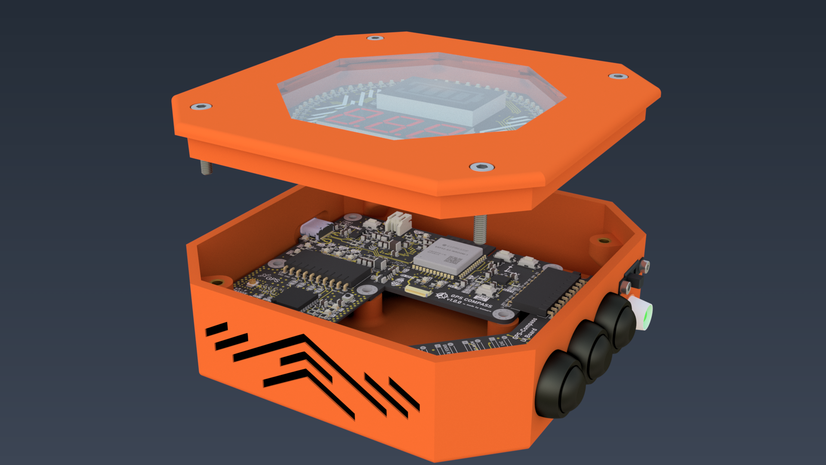
_media/renders/GPS-Compass_assembly_black_arrows.png
