bismarx-v1/GPS-Compass/_media/renders/GPS-Compass_assembly_fianl2.png

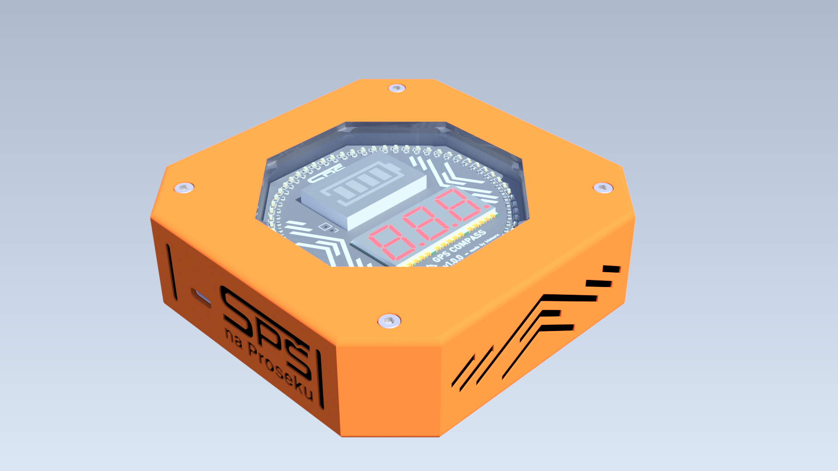
_media/renders/GPS-Compass_assembly_fianl2.png
