bismarx-v1/GPS-Compass/_media/renders/GPS-Compass_assembly_finall1.png

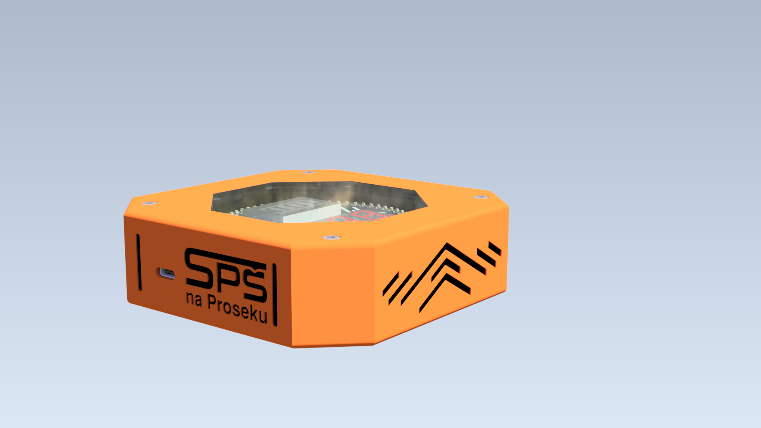
_media/renders/GPS-Compass_assembly_finall1.png
