bismarx-v1/GPS-Compass/_media/renders/GPS-Compass_assembly_inner_render.png

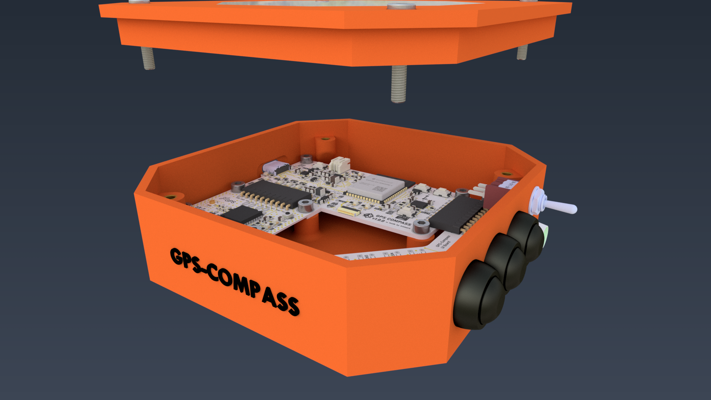
_media/renders/GPS-Compass_assembly_inner_render.png
