bismarx-v1/GPS-Compass/_media/renders/GPS-Compass_assembly_inner_zoomed_out.png

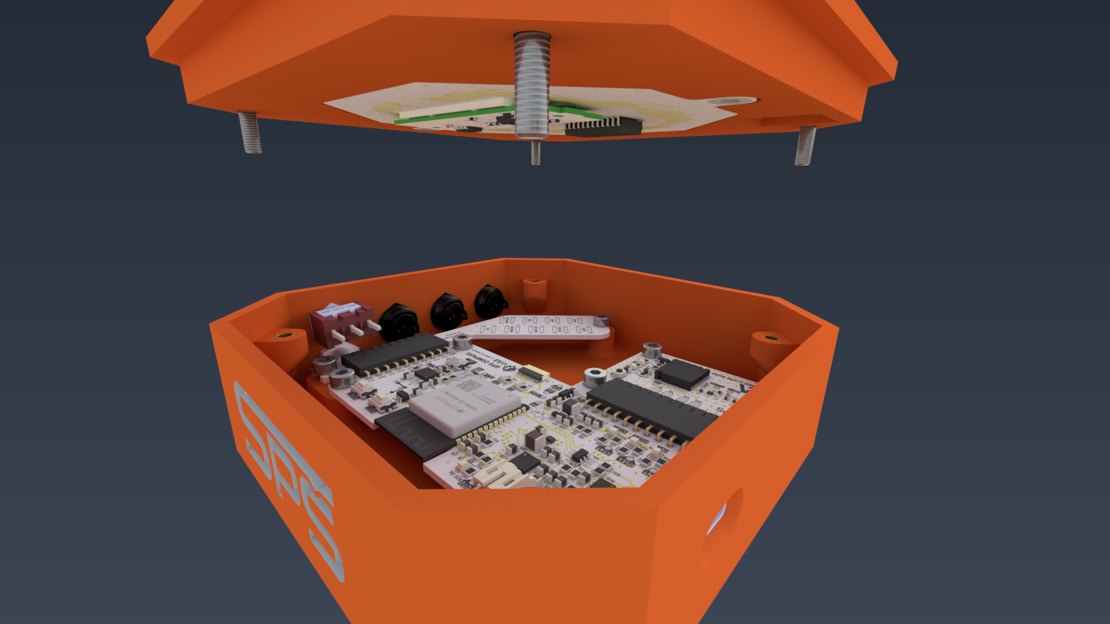
_media/renders/GPS-Compass_assembly_inner_zoomed_out.png
