bismarx-v1/GPS-Compass/_media/renders/GPS-Compass_assembly_navod2.png

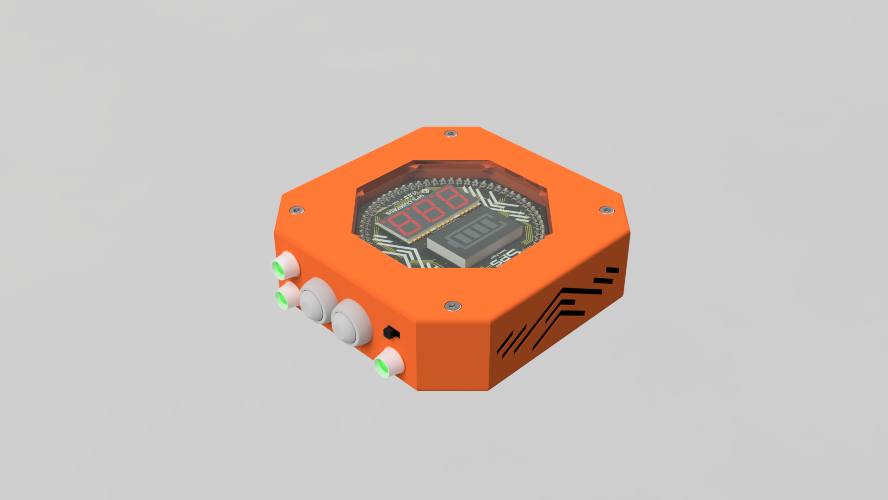
_media/renders/GPS-Compass_assembly_navod2.png
