bismarx-v1/GPS-Compass/_media/renders/GPS-Compass_assembly_plexi_nobg.png

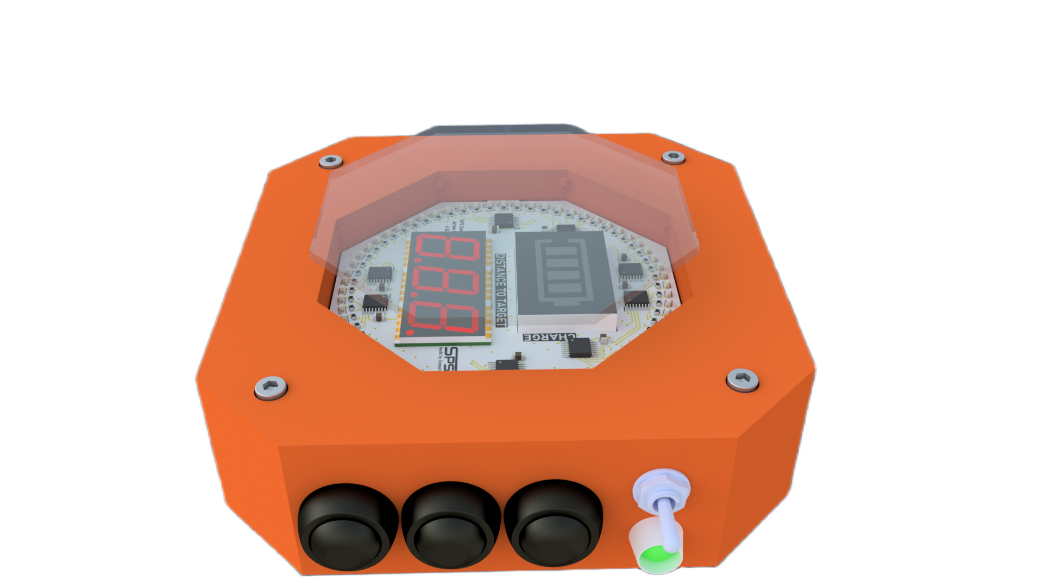
_media/renders/GPS-Compass_assembly_plexi_nobg.png
