bismarx-v1/GPS-Compass/_media/renders/GPS-Compass_assemblyplexi.png

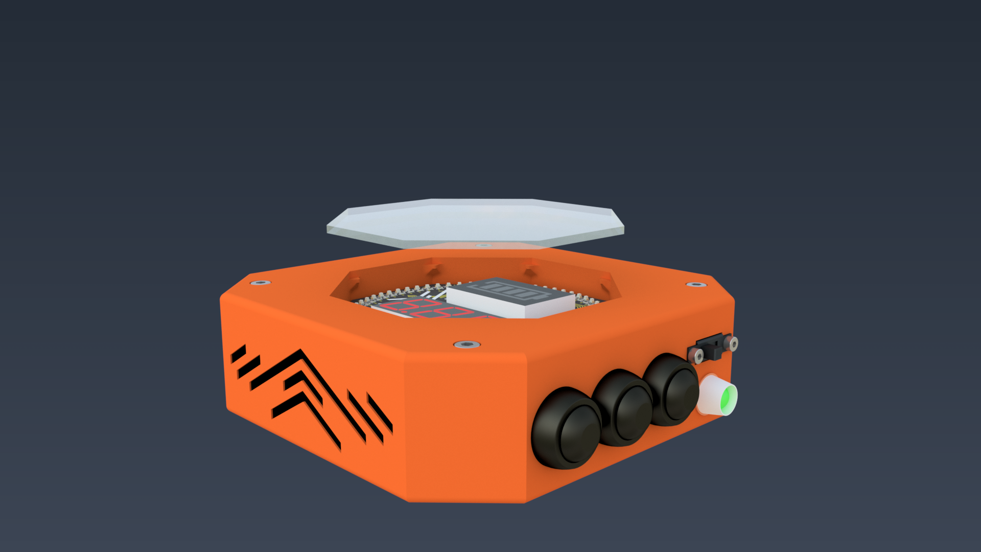
_media/renders/GPS-Compass_assemblyplexi.png
