bismarx-v1/GPS-Compass/docs/schematics/GPS-Compass_Arrow_schematic.pdf

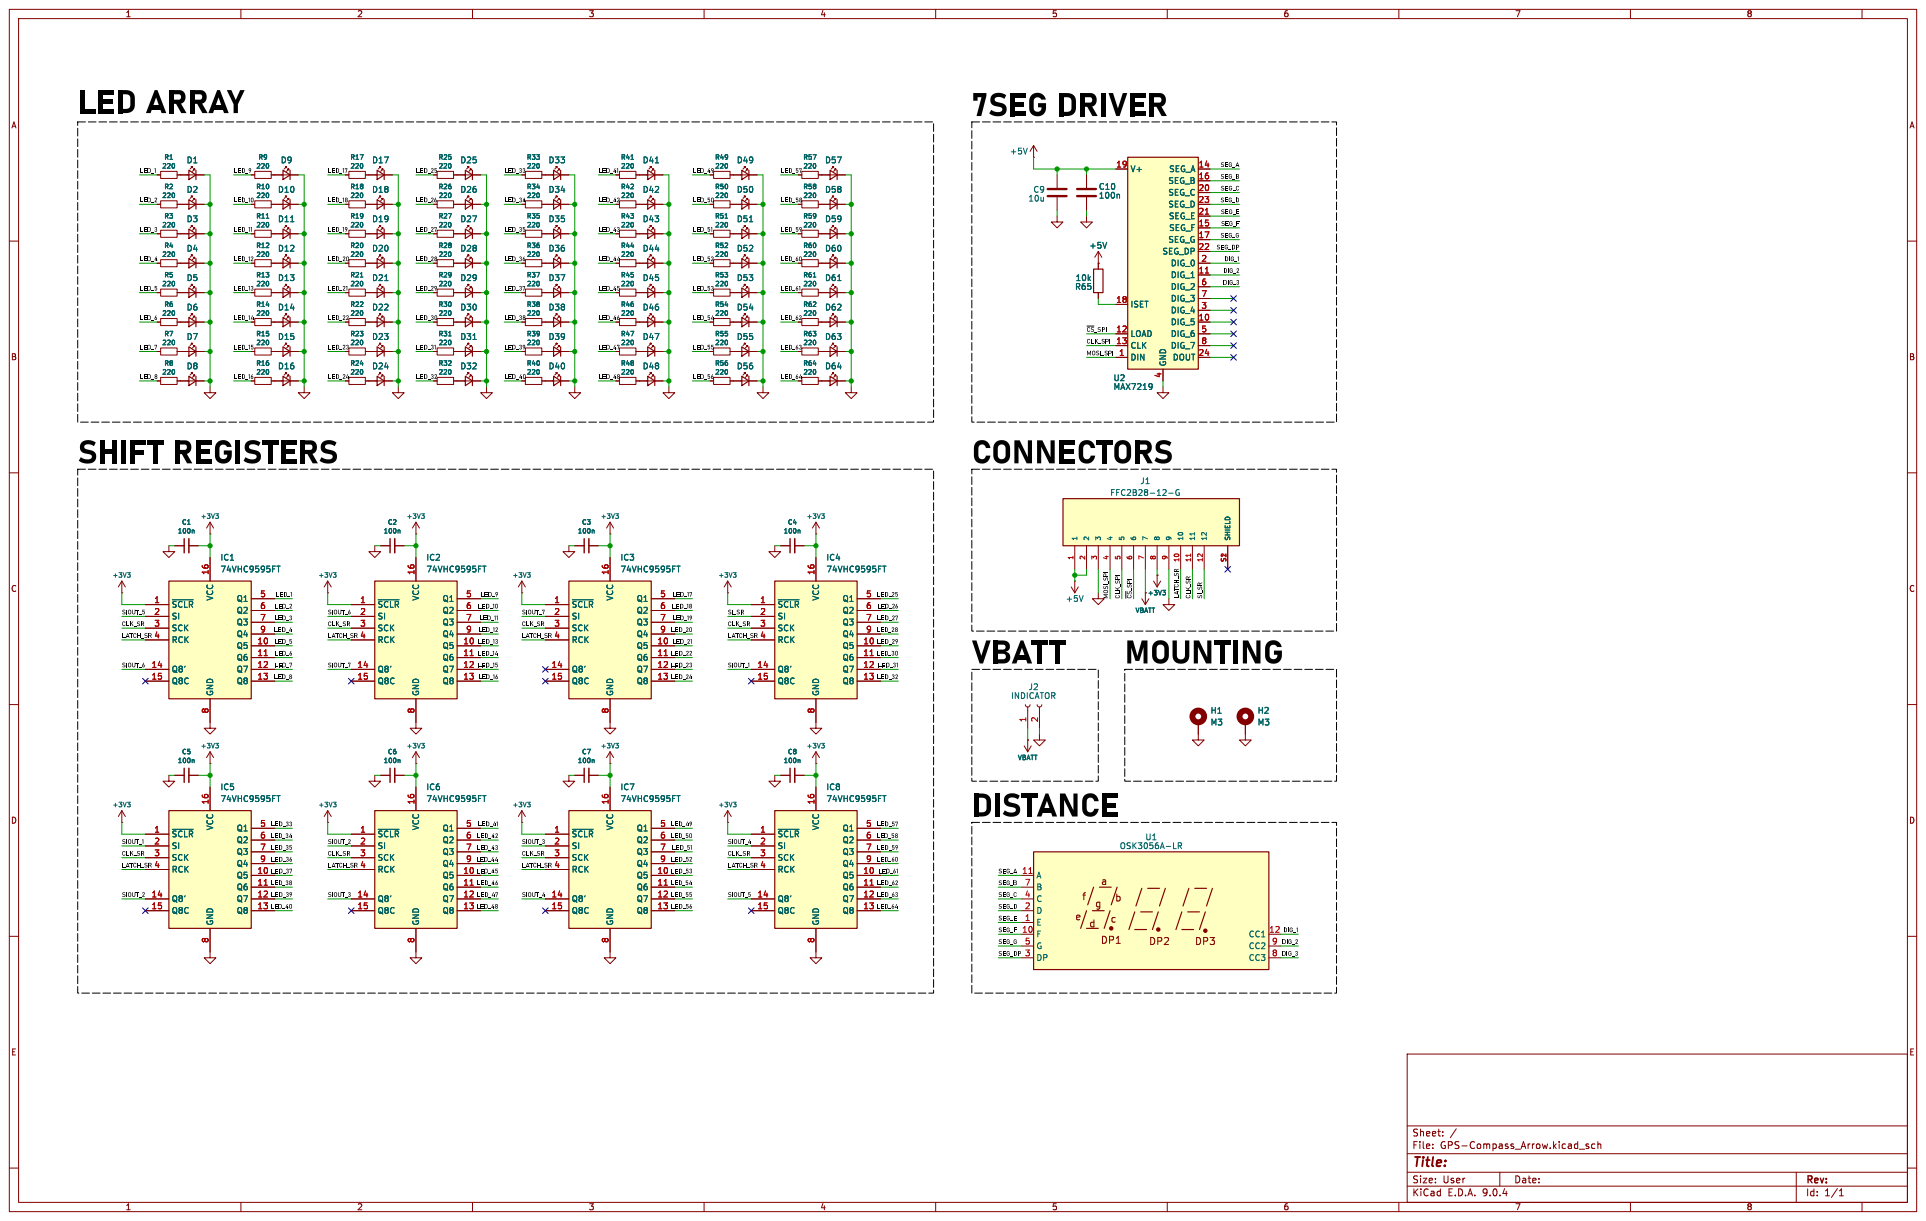
[picture p268: page 1]

Id: 1/1 Title: File: GPS-Compass_Arrow.kicad_sch Sheet: /
