bismarx-v1/GPS-Compass/docs/schematics/GPS-Compass_schematic.pdf

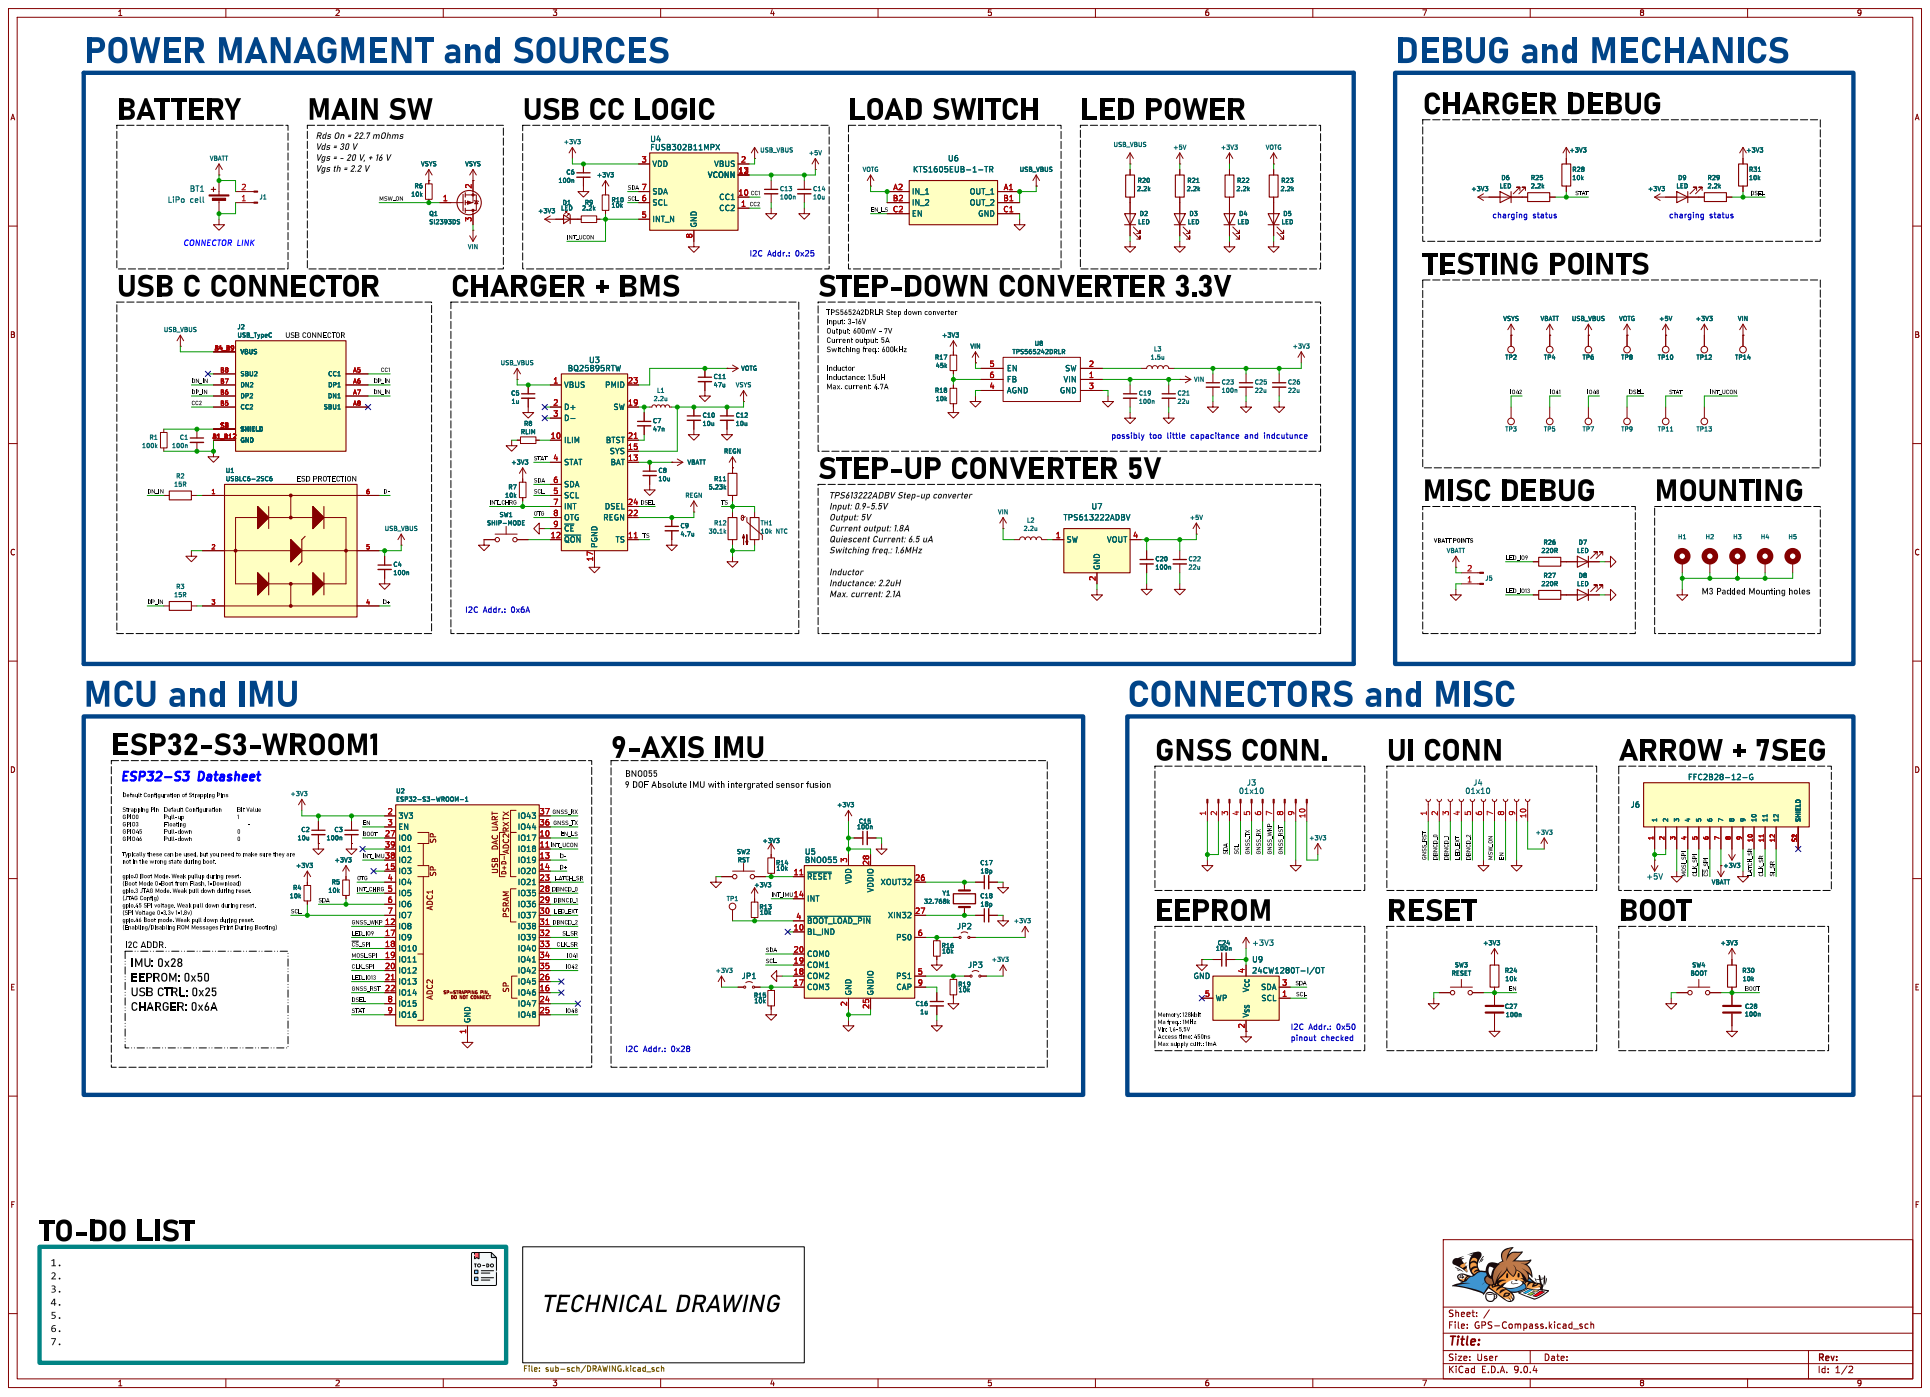
[picture p269: page 1]

TPS565242DRLRStep down converter
Input: 3-16V Output: 600mV- 7V Current output: 5A

VBUS 1 D+ 2 D- 3
10k+3V3 SW1 SHIP-MODE R8 RLIM
ILIM 10 STAT 4 SDA 6 SCL 5

TPS613222ADBVStep-up converter
Input: 0.9-5.5V Output: 5V Current output: 1.8A Quiescent Current: 6.5 uA

9 DOFAbsolute IMU with intergrated sensor fusion

Typically these can be used, but you need to make sure they are
not in the wrong state during boot. gpio.0Boot Mode.Weakpullup during reset. (Boot Mode 0=Boot from Flash, 1=Download) gpio.3 JTAGMode.Weakpull down during reset. (JTAGConfig) gpio.45 SPI voltage. Weakpull down during reset. (SPIVoltage 0=3.3v1=1.8v) gpio.46 Boot mode. Weakpull down during reset. (Enabling/Disabling ROMMessages Print During Booting) IMU:0x28

pinout checked Memory: 128kbit Ma freq.: 1MHz Vin: 1.6-5.5V

Access time: 450ns Max supply curr.: 1mA

Id: 1/2 Title: File: GPS-Compass.kicad_sch
