bismarx-v1/GPS-Compass/docs/schematics/GPS-Compass_UI_schematic.pdf

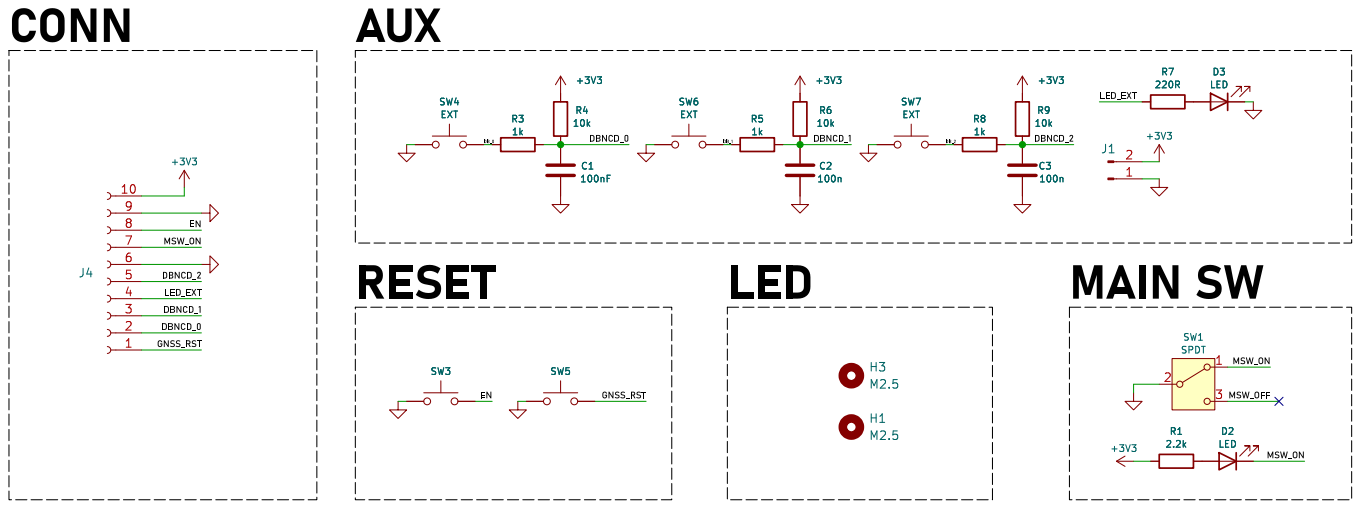
[picture p270: page 1]

Id: 1/1 Title: File: GPS-Compass_UI.kicad_sch Sheet: /
