bismarx-v1/GPS-Compass/docs/schematics/GPS-Compass_GNSS_schematic.pdf

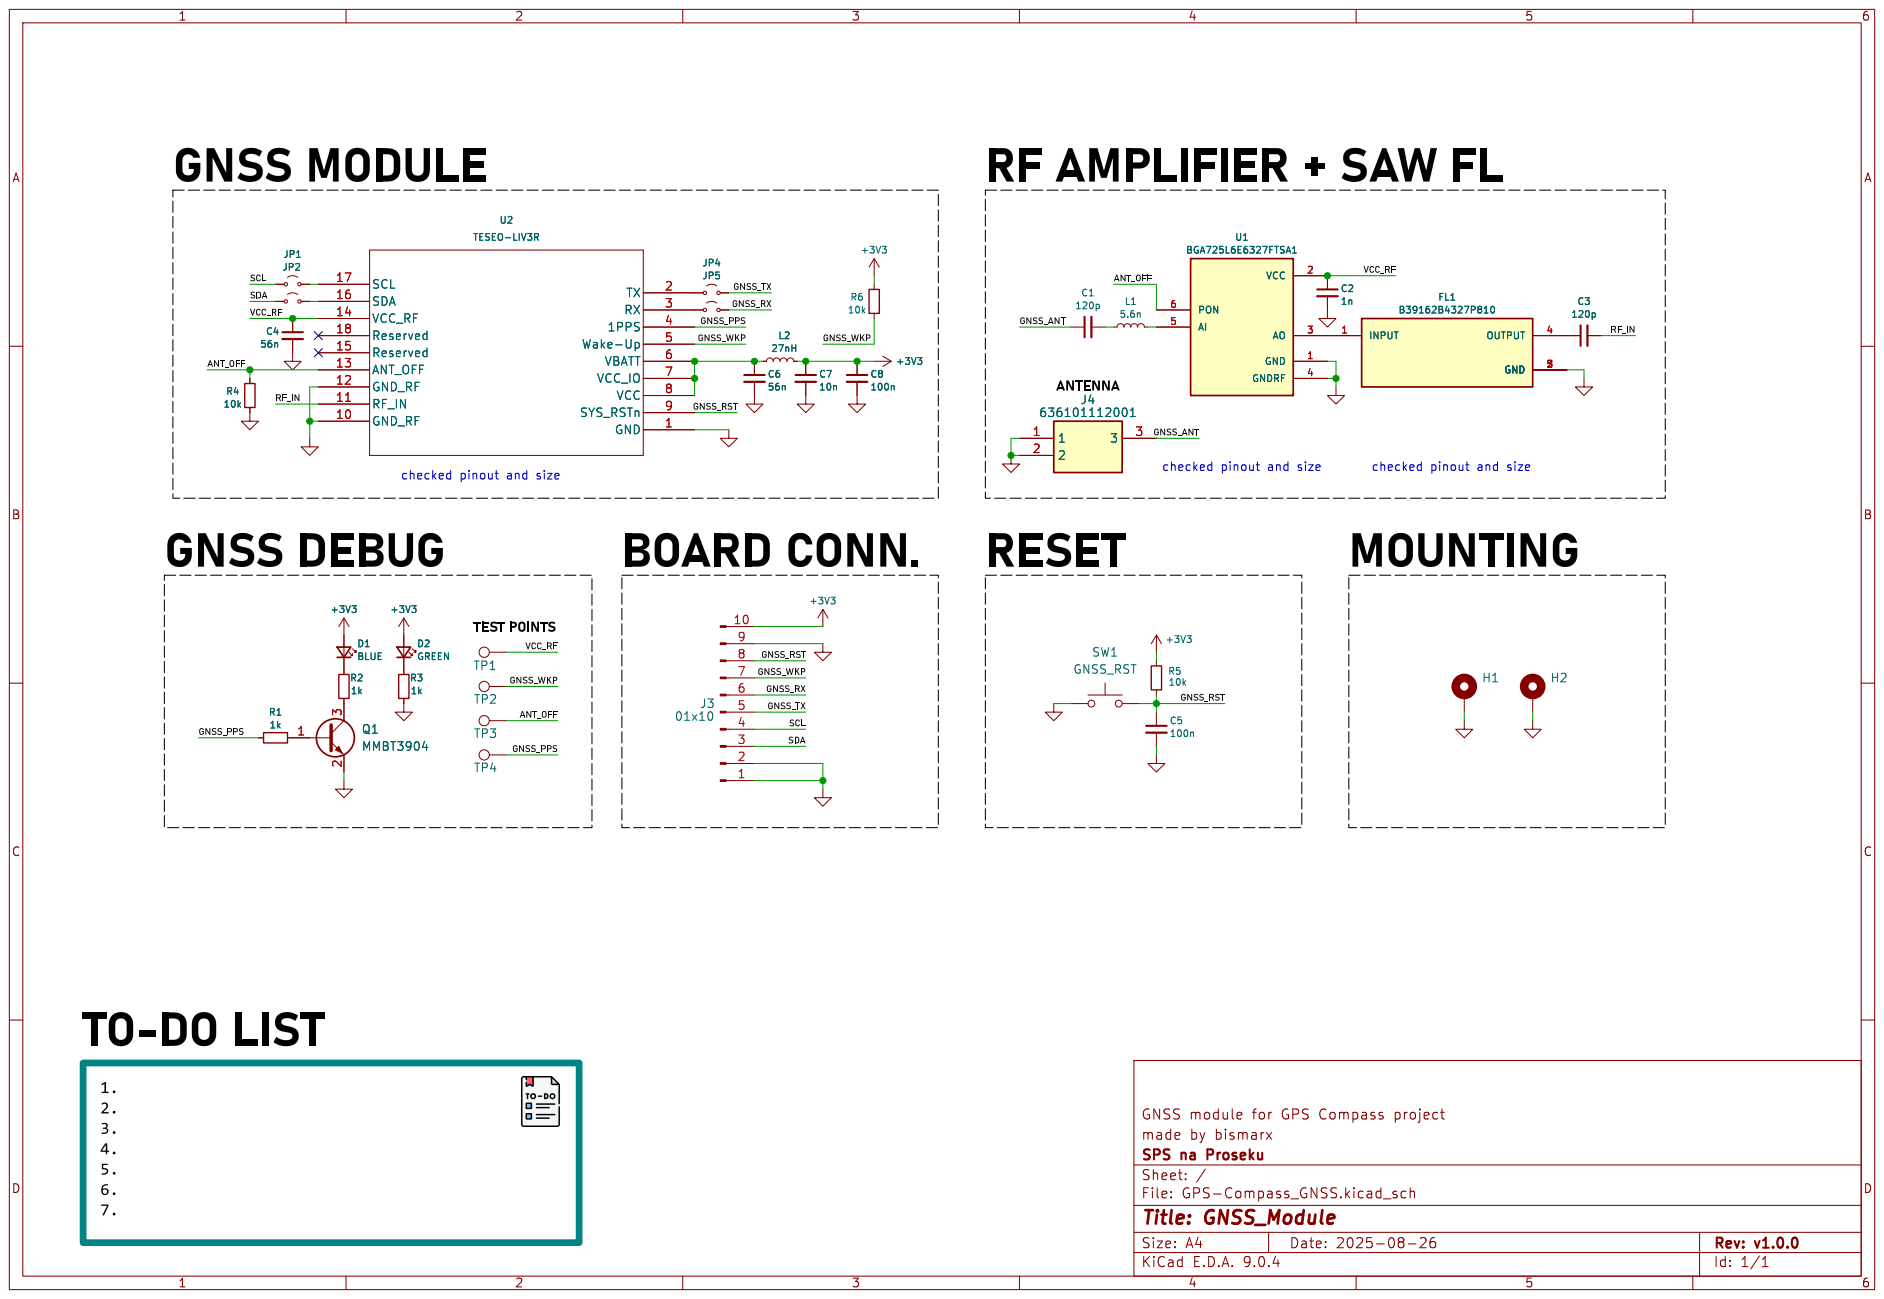
[picture p271: page 1]
