bismarx-v1/GPS-Compass/_mechanical/GPS-Compass_assembly/drawings/GPS-Compass_assembly.pdf

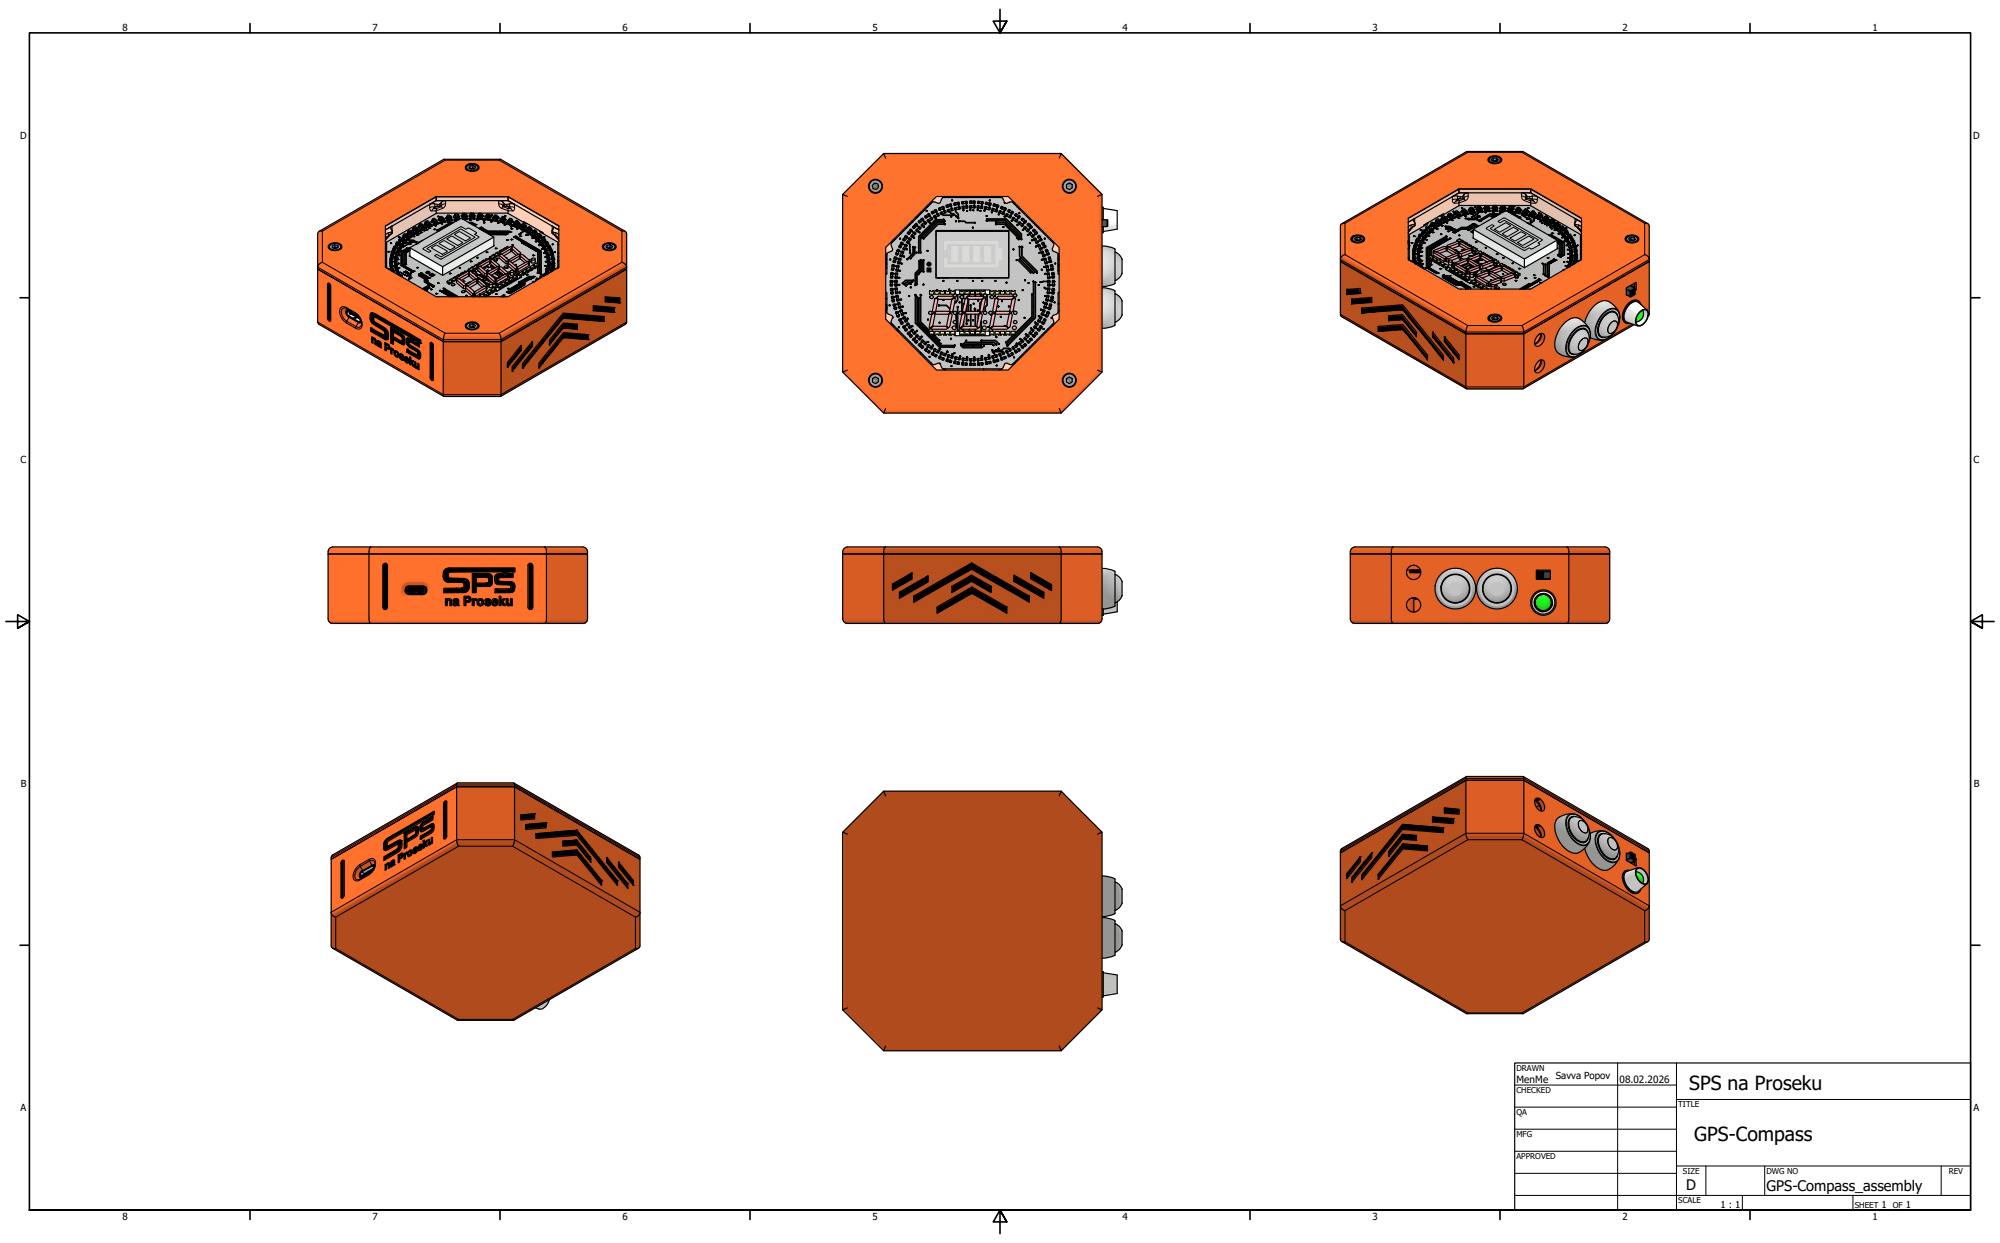
[picture p272: page 1]
SHEET 1 OF 1; DWG NO; Savva Popov

SPS na Proseku
