bismarx-v1/GPS-Compass/(list of files, drawings)

Other design files:
docs/test_circuits/SR_with_latch_example.circ
