bismarx-v1/GPS-Compass/_electrical/GPS-Compass/GPS-Compass.kicad_pcb

## KiCad design _electrical/GPS-Compass/GPS-Compass.kicad_pcb (2026-08-27)

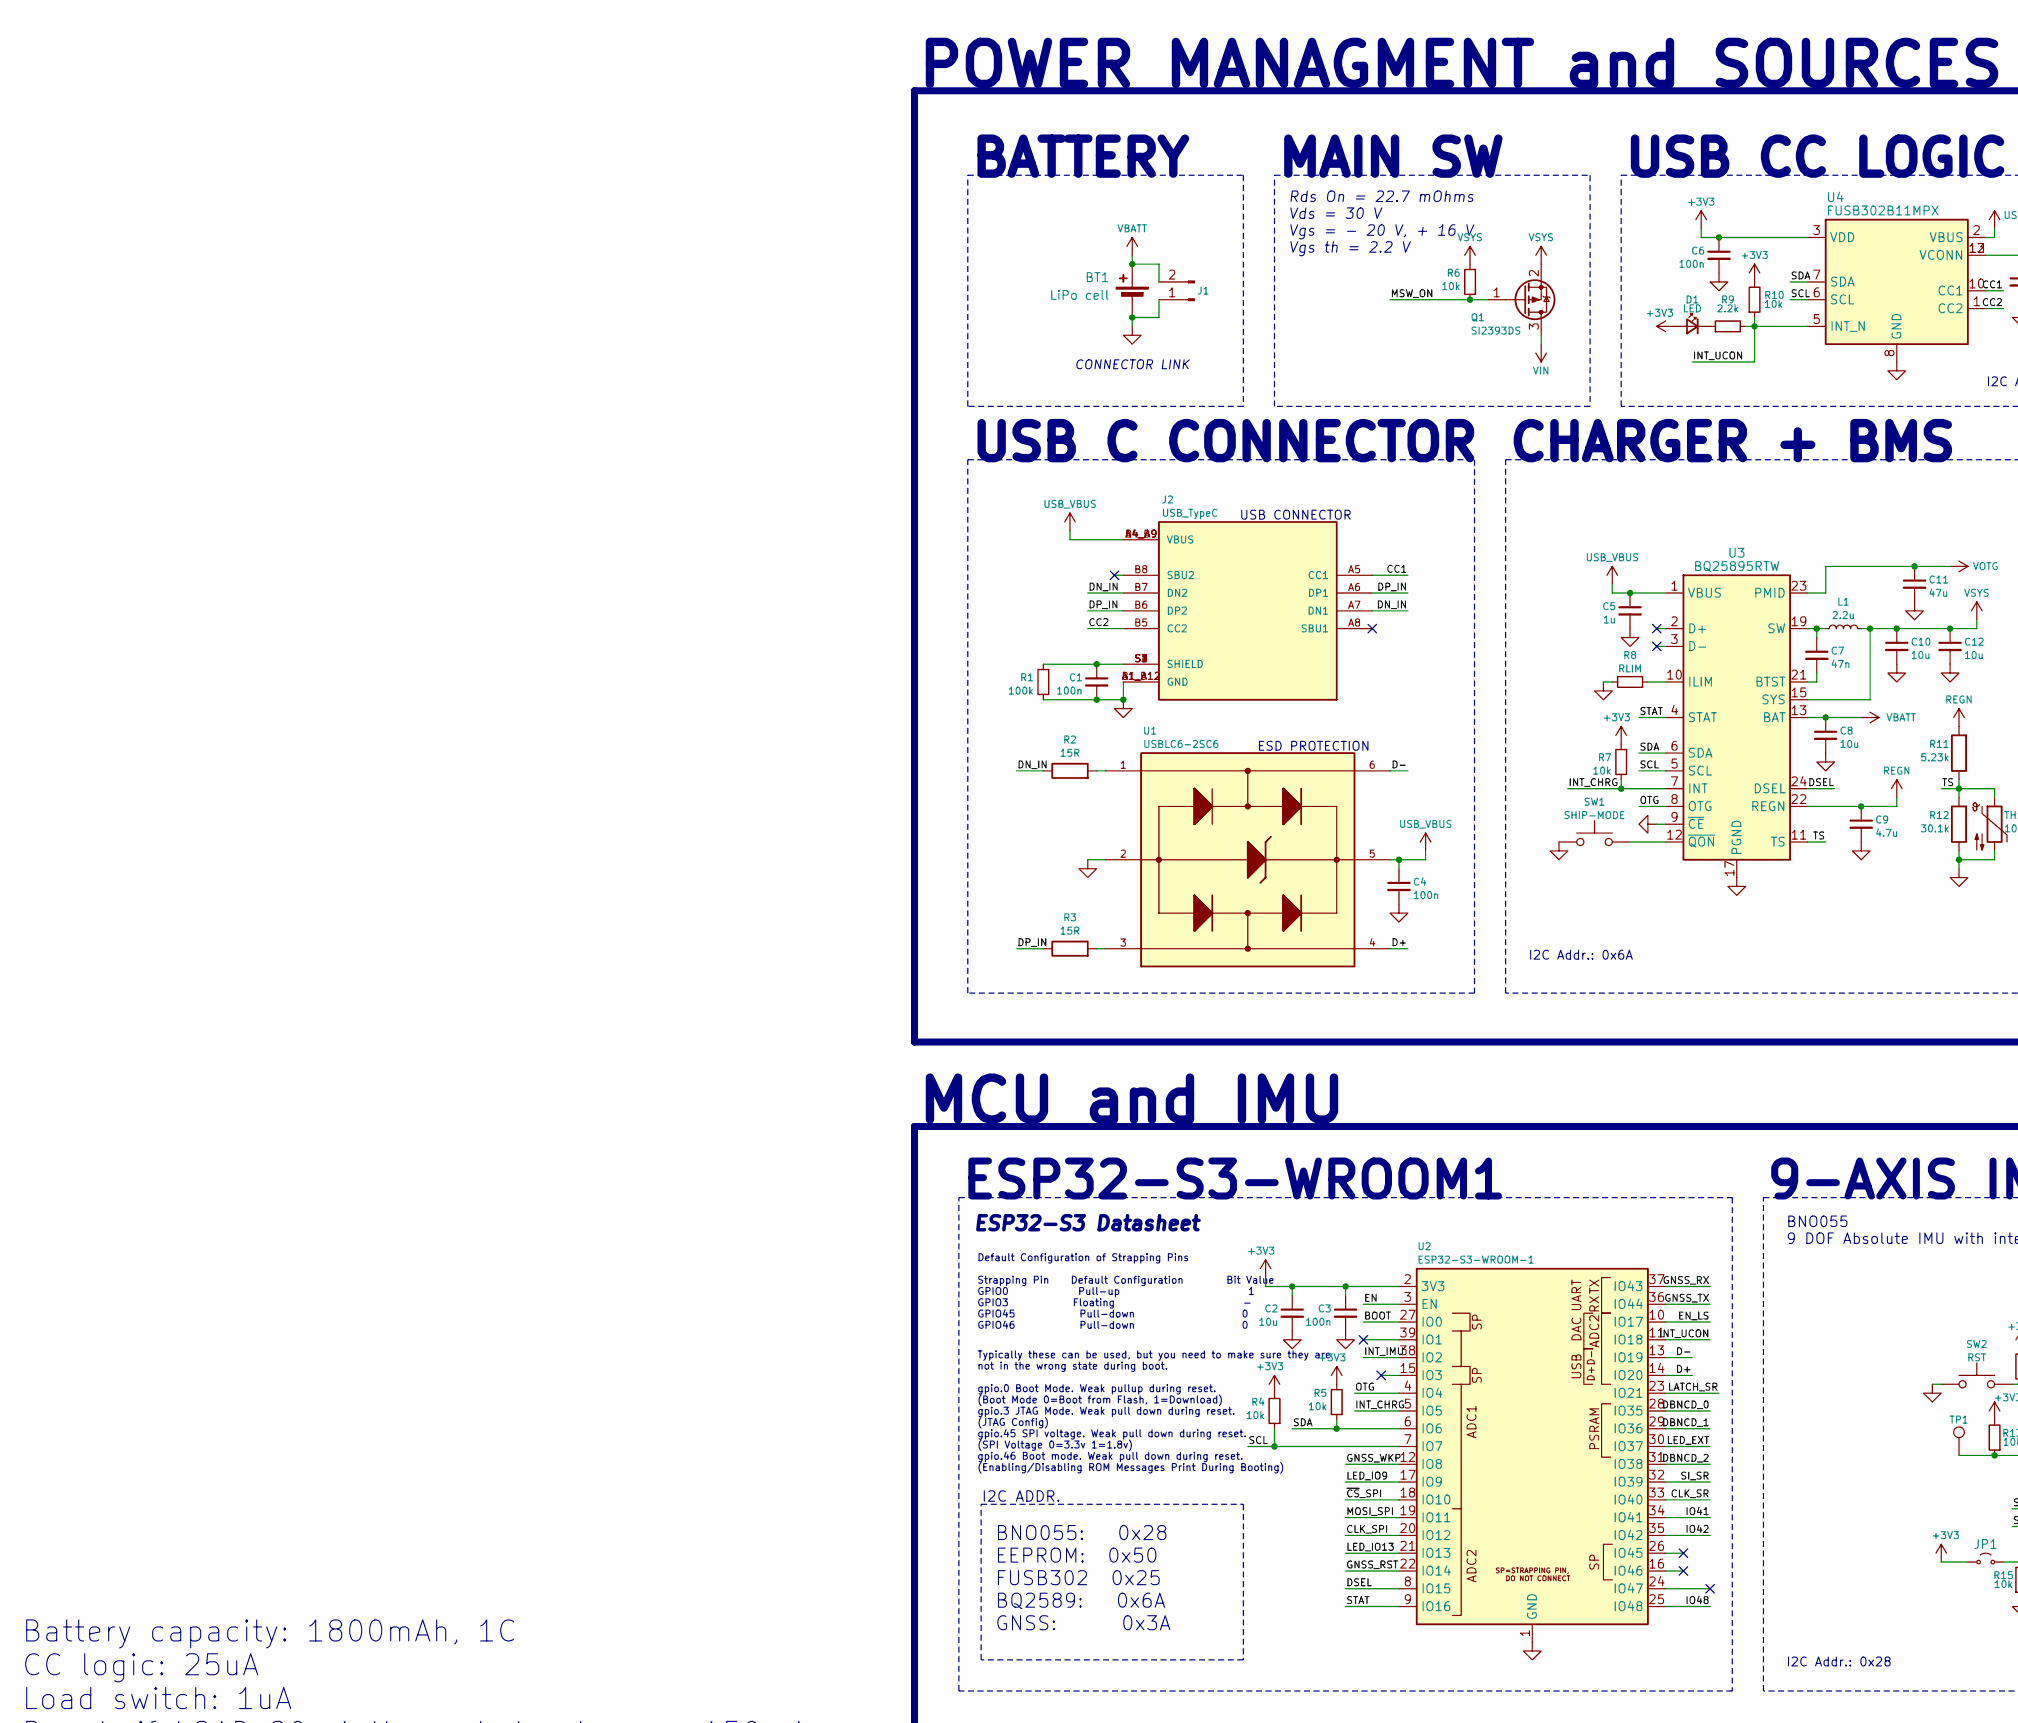
[picture p273: schematic GPS-Compass.kicad_sch, part in row 1, column 1]

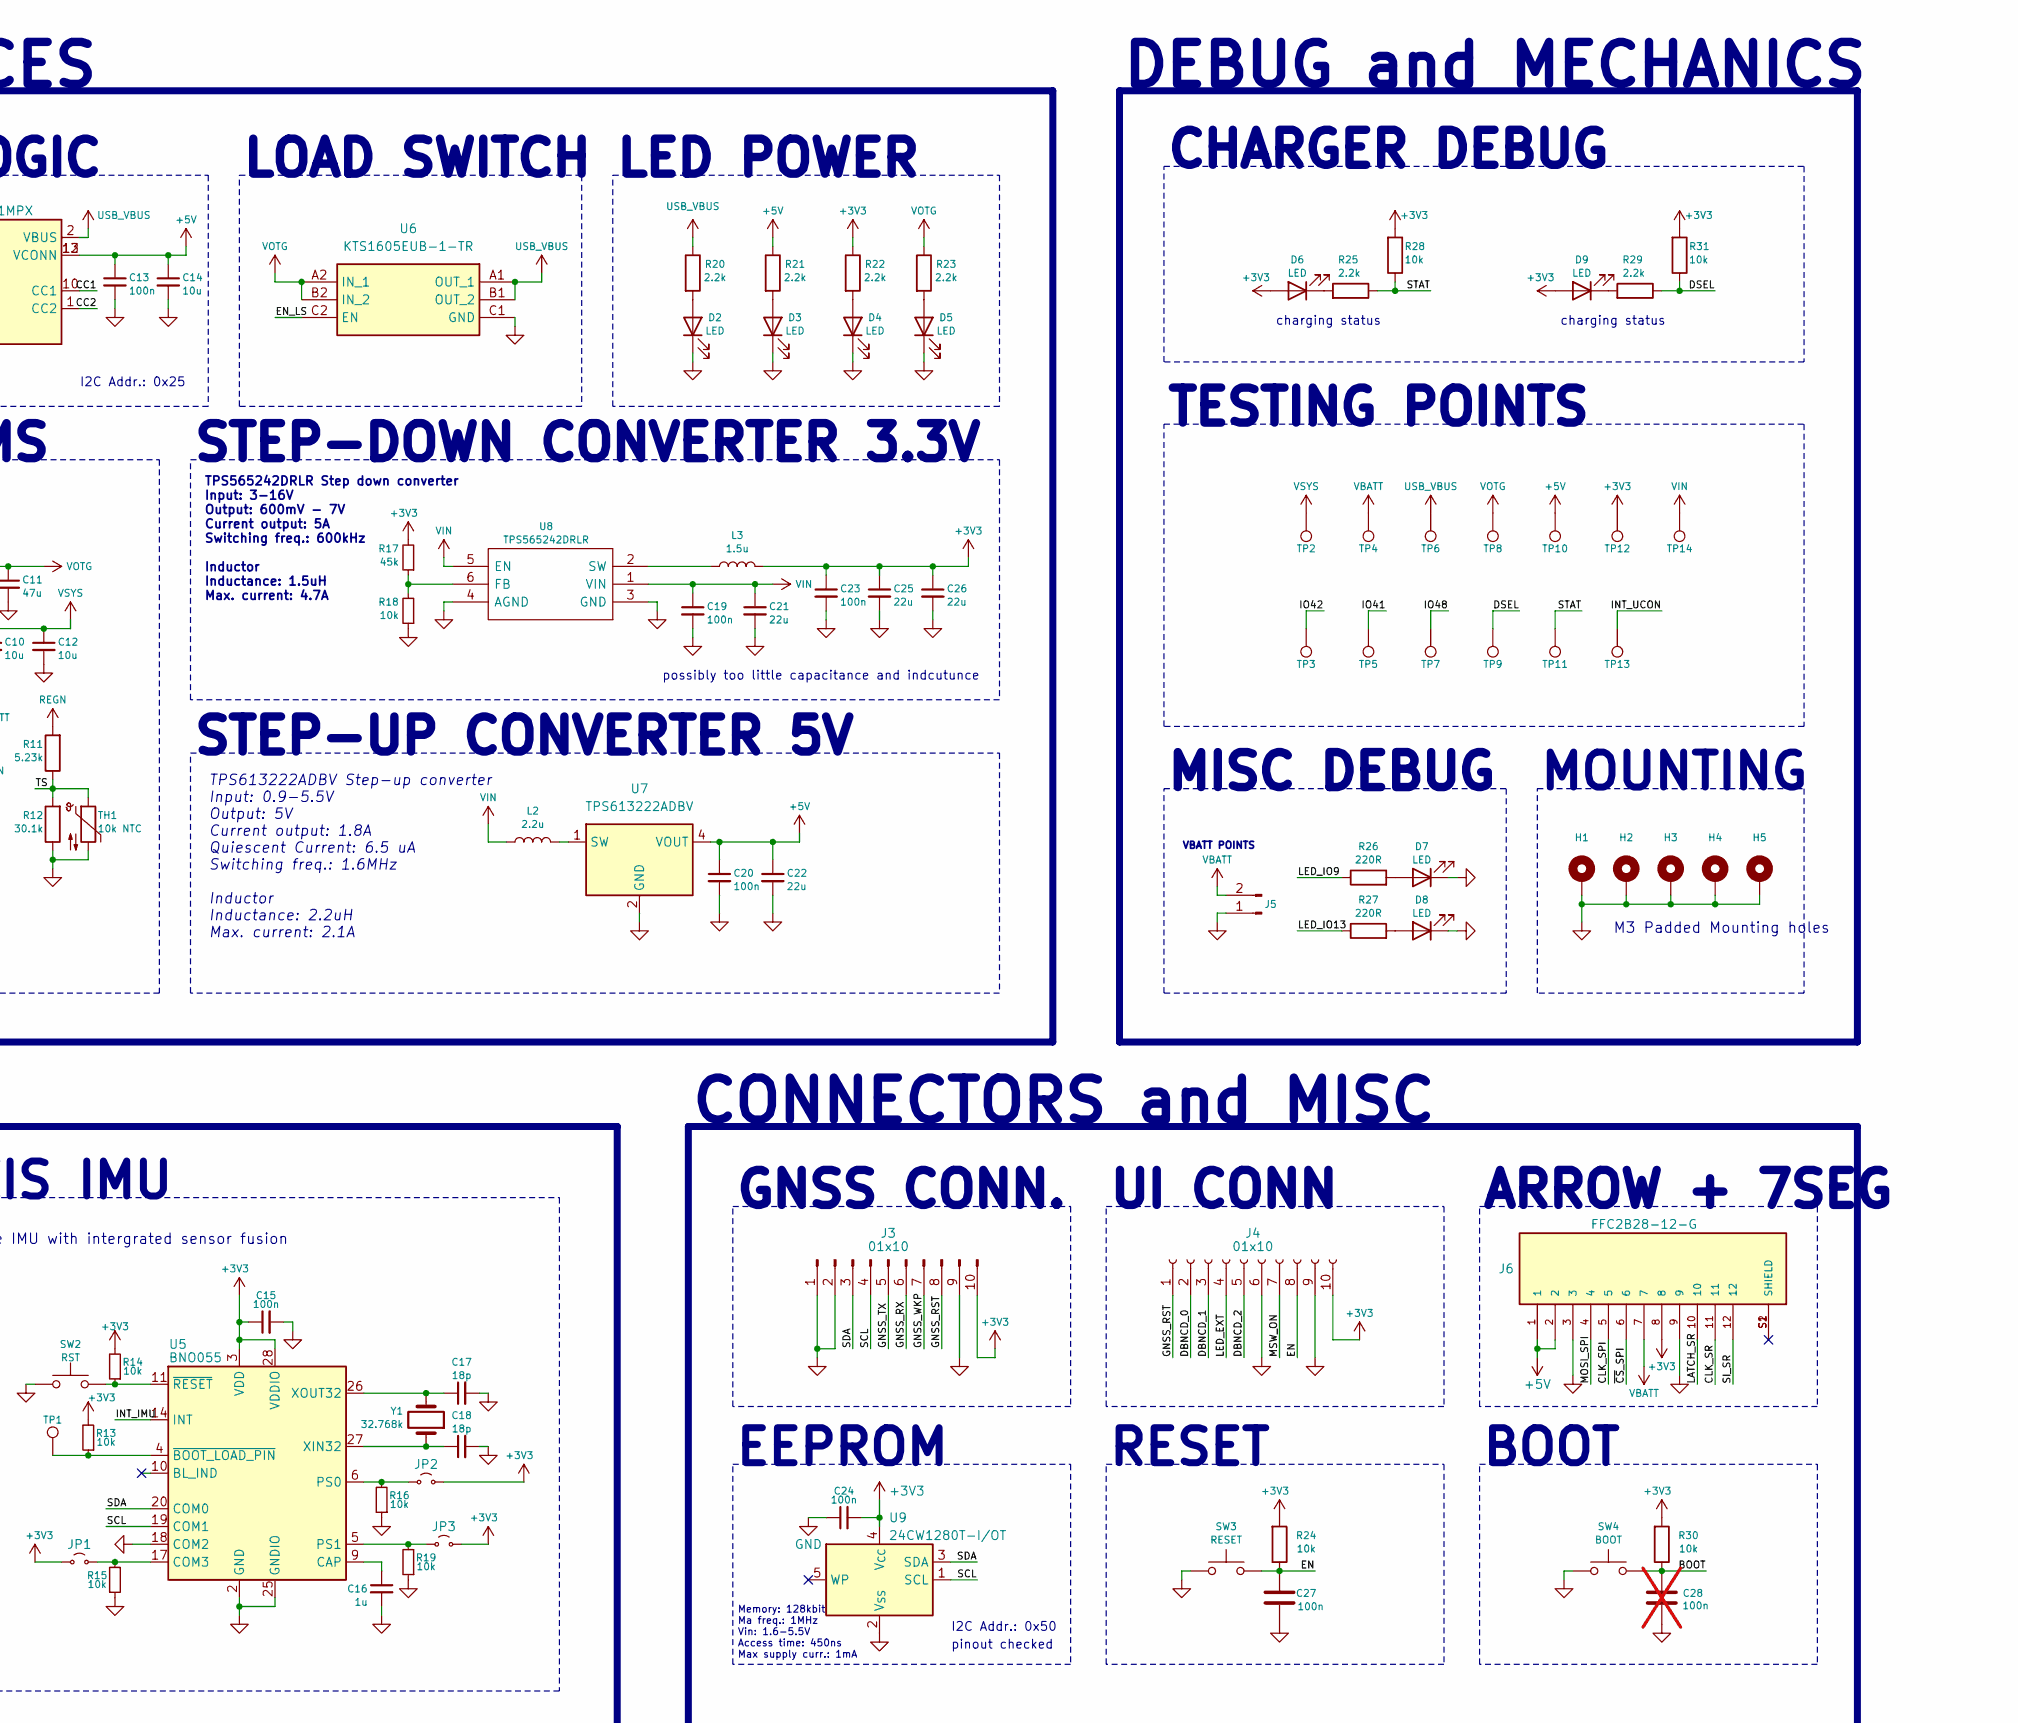
[picture p274: schematic GPS-Compass.kicad_sch, part in row 1, column 2]

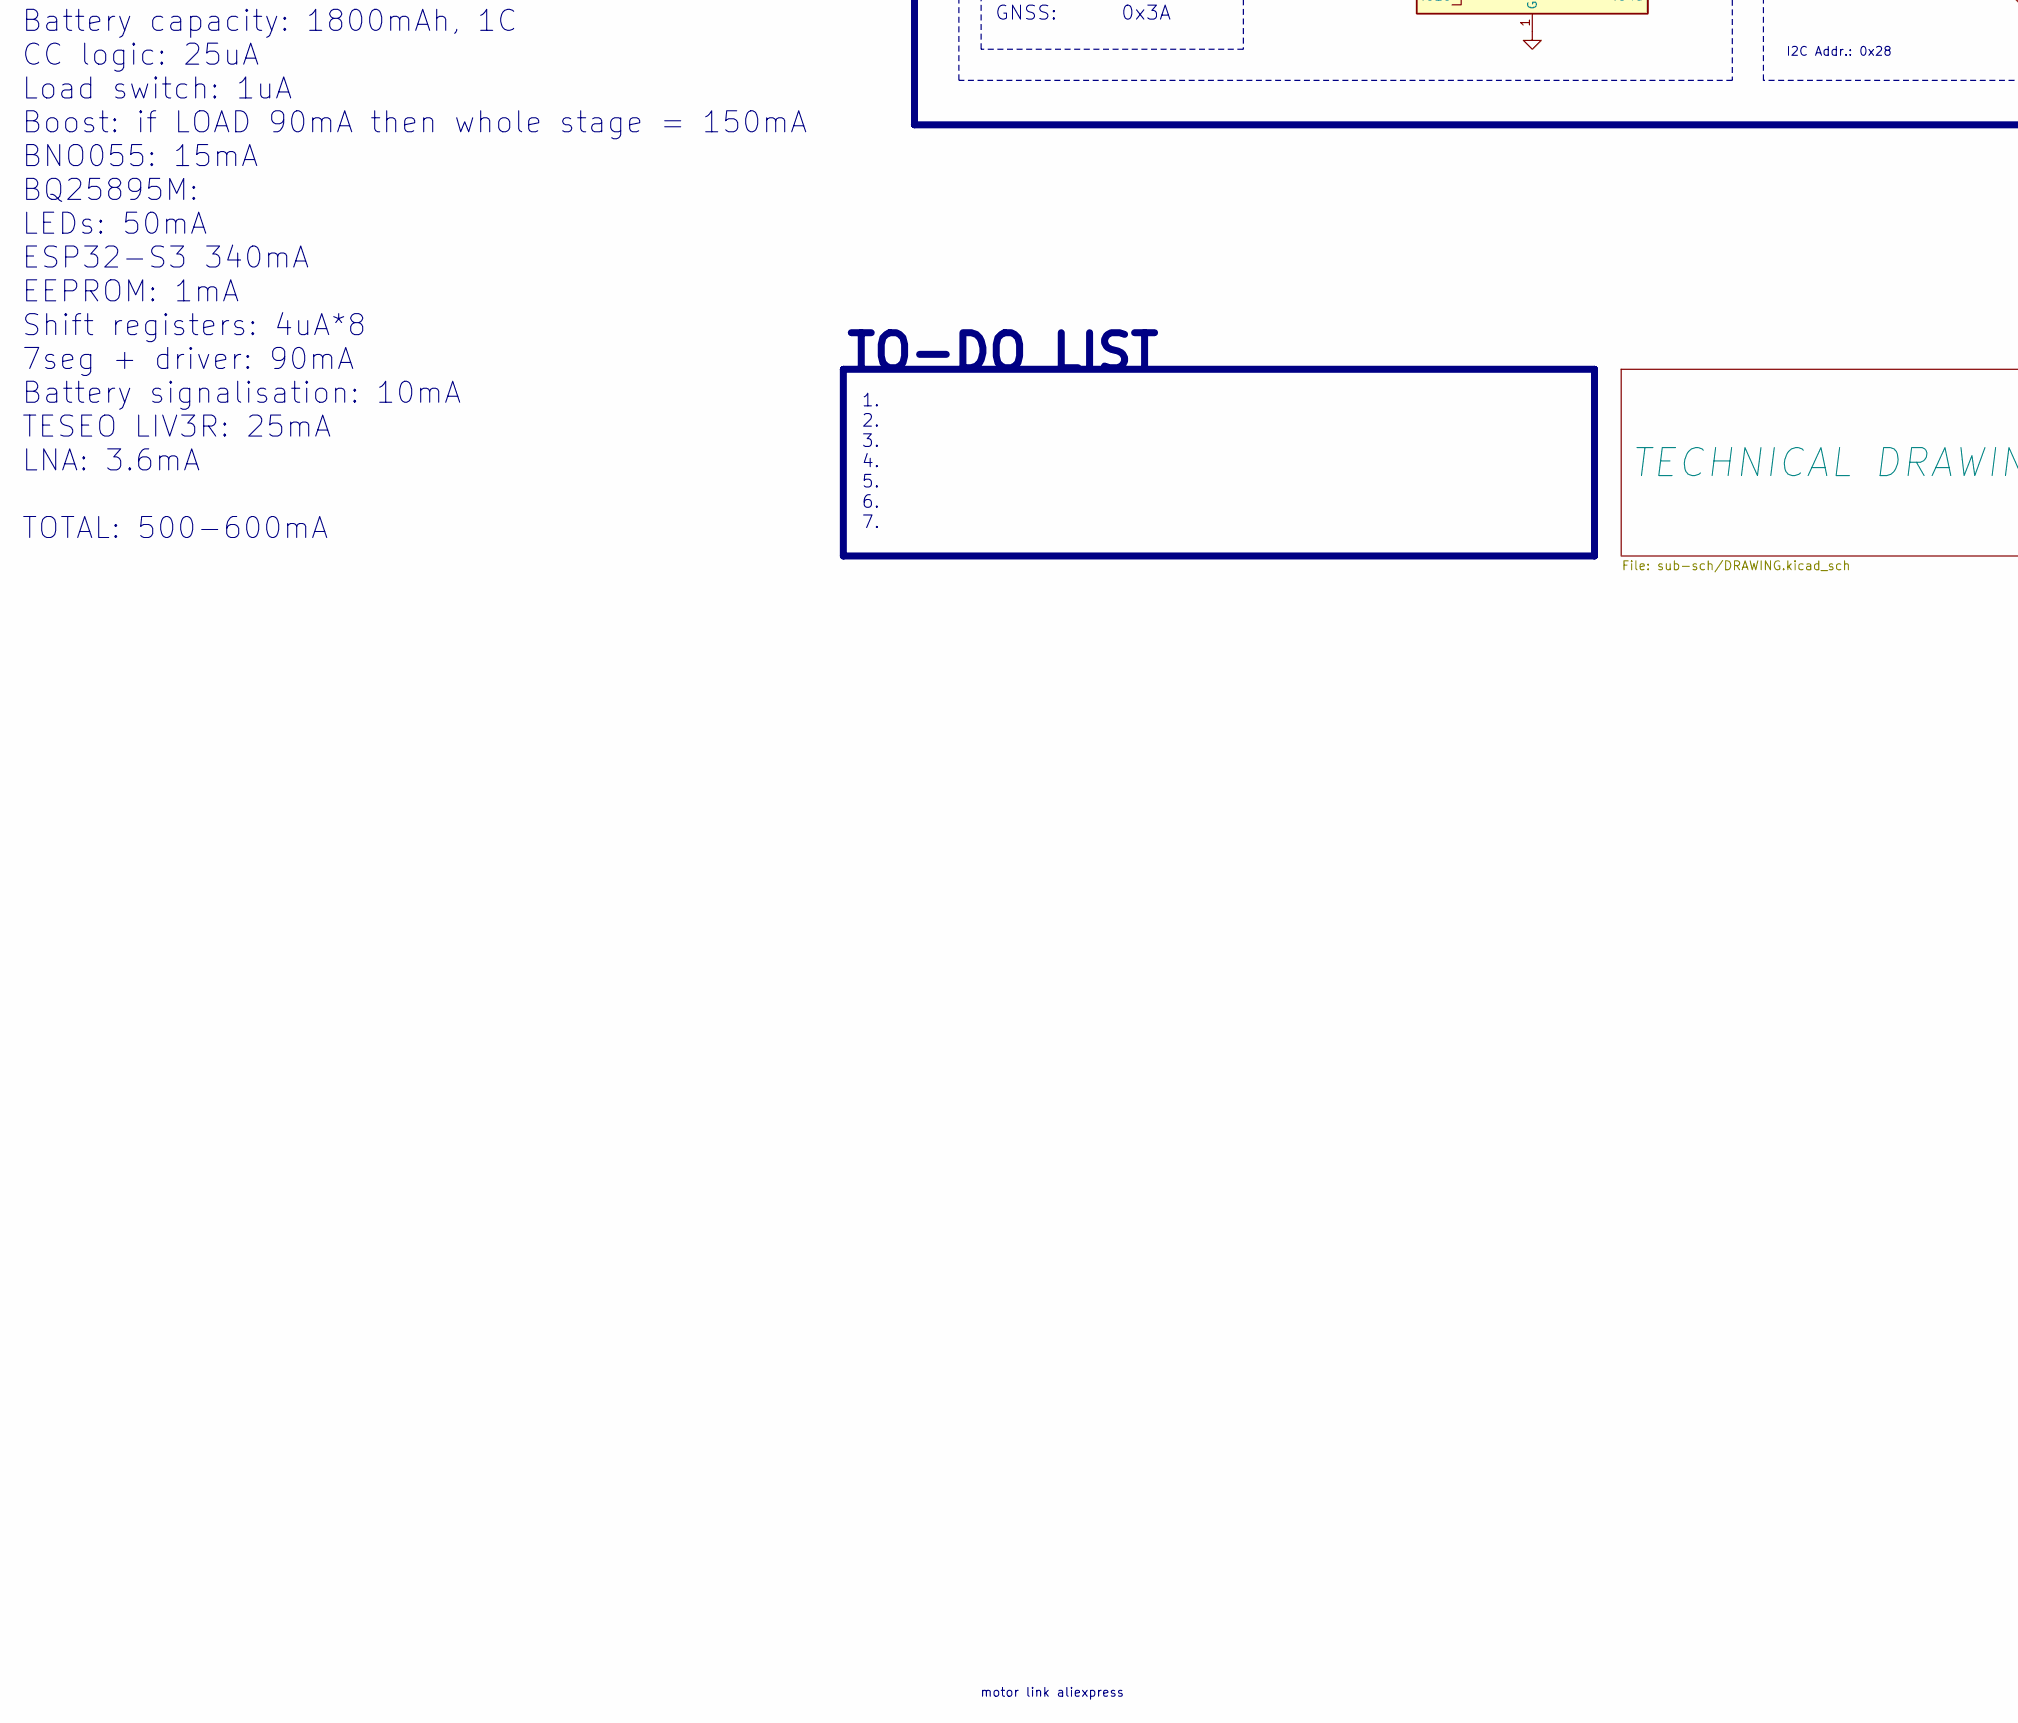
[picture p275: schematic GPS-Compass.kicad_sch, part in row 2, column 1]

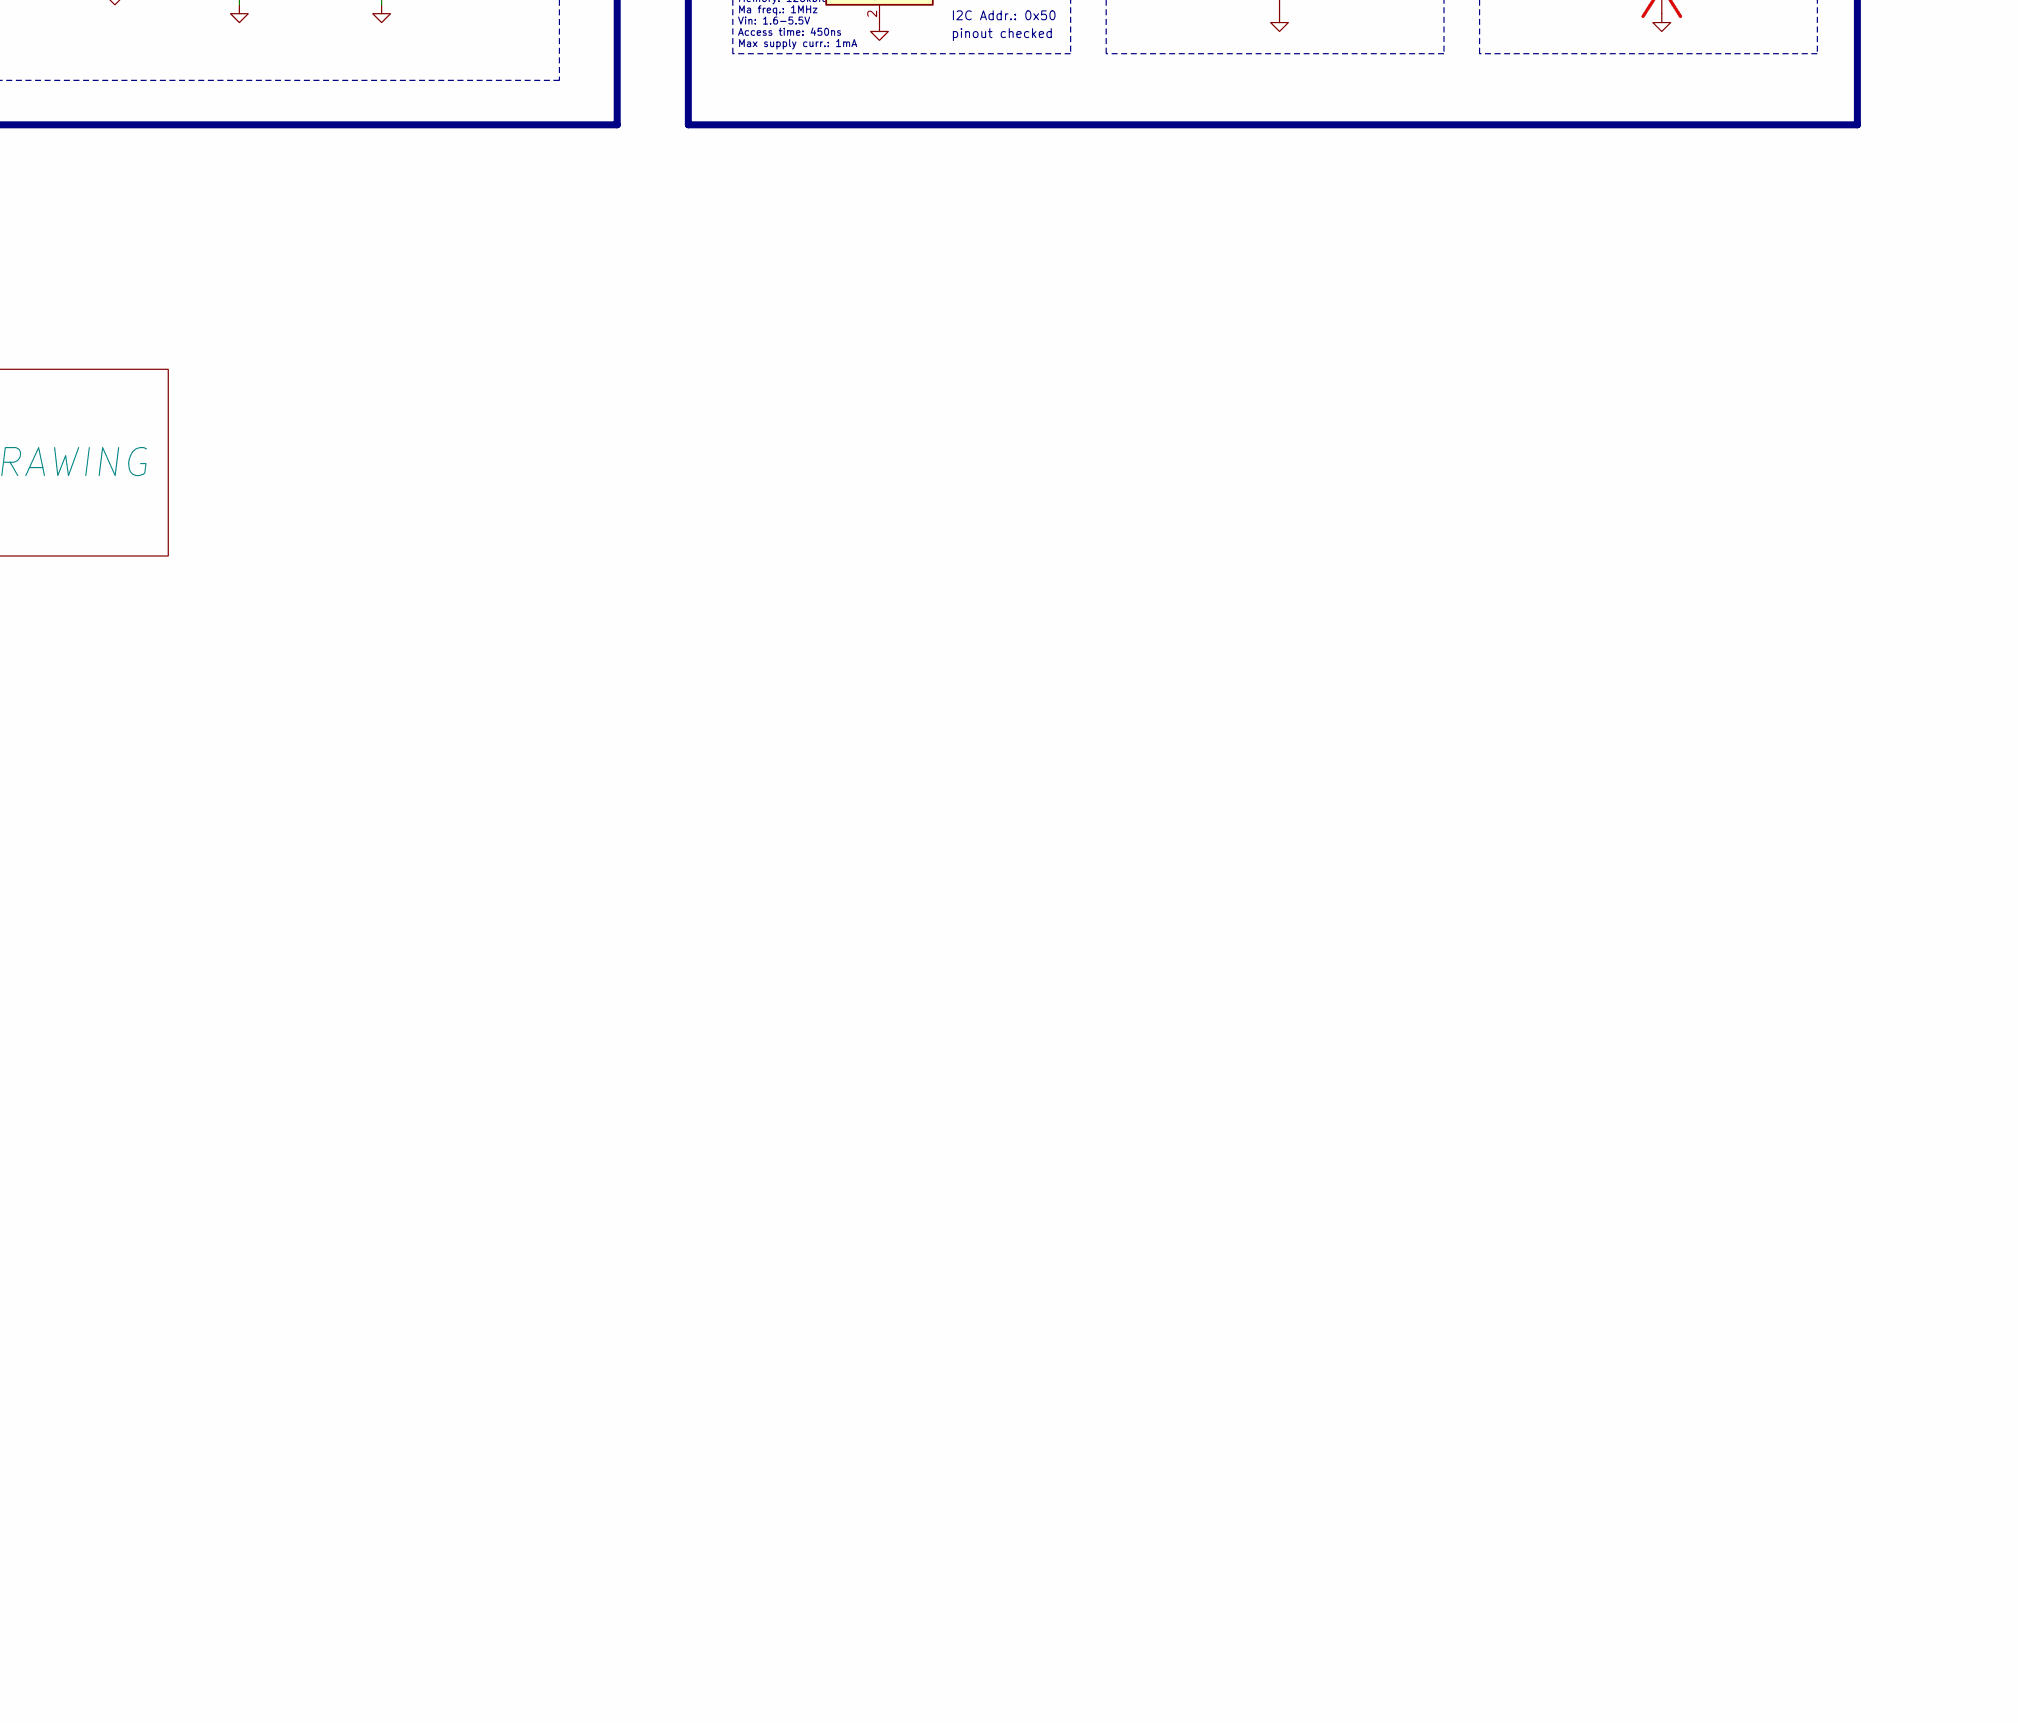
[picture p276: schematic GPS-Compass.kicad_sch, part in row 2, column 2]

Parts:
BT1: LiPo cell
C1, C3, C4, C6, C13, C15, C19, C20, C23, C24, C27: 100n; C_0805_2012Metric
C2, C8, C10, C12, C14: 10u; C_0805_2012Metric
C5, C16: 1u; C_0805_2012Metric
C7: 47n; C_0805_2012Metric
C9: 4.7u; C_0805_2012Metric
C11: 47u; C_1210_3225Metric
C17, C18: 18p; C_0805_2012Metric
C21, C22, C25, C26: 22u; C_0805_2012Metric
C28: 100n; C_0805_2012Metric; not fitted
D1, D2, D3, D4, D5, D6, D7, D8, D9: LED; LED_0805_2012Metric
H1, H2, H3, H4, H5: Mounting Hole M3; MountingHole_3.2mm_M3_Pad_Via
J1: Conn_01x02_Pin; JST_PH_S2B-PH-K_1x02_P2.00mm_Horizontal
J2: USB_TypeC; HRO_TYPE-C-31-M-12; PARTREV 2020.12.08
J3, J4: 01x10; PinSocket_1x10_P2.54mm_Horizontal
J5: Conn_01x02_Pin; SolderWire-0.1sqmm_1x02_P3.6mm_D0.4mm_OD1mm
J6: FFC2B28-12-G; GCT_FFC2B28-12-G; PARTREV A
JP1, JP2, JP3: Jumper_2_Small_Open; SolderJumper-2_P1.3mm_Open_RoundedPad1.0x1.5mm
L1, L2: 2.2u; L_1008_2520Metric
L3: 1.5u; L_Vishay_IHLP-1212
Q1: SI2393DS; SOT-23-3
R1: 100k; R_0805_2012Metric
R2, R3: 15R; R_0805_2012Metric
R4, R5, R6, R7, R10, R13, R14, R15, R16, R18, R19, R24, R30: 10k; R_0805_2012Metric
R8: RLIM; R_0805_2012Metric
R9: 2.2k; R_0805_2012Metric
R11: 5.23k; R_0805_2012Metric; LCSC C17633
R12: 30.1k; R_0805_2012Metric; LCSC C17633
R17: 45k; R_0805_2012Metric
R20, R21, R22, R23, R25, R29: 2.2k; R_0805_2012Metric; LCSC C17633
R26, R27: 220R; R_0805_2012Metric; LCSC C17633
R28, R31: 10k; R_0805_2012Metric; LCSC C17633
SW1: SHIP-MODE; SW_SPST_EVQPE1
SW2: RST; SW_SPST_EVQPE1
SW3: RESET; SW_SPST_EVQPE1
SW4: BOOT; SW_SPST_EVQPE1
TH1: 10k NTC; R_0805_2012Metric
TP1, TP2, TP3, TP4, TP5, TP6, TP7, TP8, TP9, TP10, TP11, TP12, TP13, TP14: TestPoint; TestPoint_Pad_D1.0mm
U1: USBLC6-2SC6; TSOT-23-6_HandSoldering
U2: ESP32-S3-WROOM-1
U3: BQ25895RTW; Texas_RTW_WQFN-24-1EP_4x4mm_P0.5mm_EP2.7x2.7mm_ThermalVias
U4: FUSB302B11MPX; WQFN-14-1EP_2.5x2.5mm_P0.5mm_EP1.45x1.45mm
U5: BNO055; LGA-28_5.2x3.8mm_P0.5mm
U6: KTS1605EUB-1-TR; KTS1605EUB1TR; Manufacturer_Part_Number KTS1605EUB-1-TR
U7: TPS613222ADBV; SOT-23-5
U8: TPS565242DRLR; SOT-563; Manufacturer_Part_Number TPS565242DRLR; Mouser Part Number 595-TPS565242DRLR
U9: 24CW1280T-I/OT; SOT-23-5
Y1: 32.768k; CM8V32768TA020125

Connections:
+3V3: C2.1, C3.1, C6.1, C15.1, C23.1, C24.2, C25.1, C26.1, D1.2 (A), D6.2 (A), D9.2 (A), J3.10, J4.10, J6.8, JP1.2 (B), JP2.2 (B), JP3.2 (B), L3.2, R4.2, R5.2, R7.1, R10.2, R13.2, R14.2, R17.2, R22.1, R24.2, R28.2, R30.2, R31.2, TP12.1, U2.2 (3V3), U4.3 (VDD), U4.4 (VDD), U5.3 (VDD), U5.28 (VDDIO), U9.4 (V_{CC})
+5V: C13.1, C14.1, C20.1, C22.1, J6.1, J6.2, R21.1, TP10.1, U4.12 (VCONN), U4.13 (VCONN), U7.4 (VOUT)
/BOOT: C28.2, R30.1, SW4.2, U2.27 (IO0)
/CC1: J2.A5 (CC1), U4.10 (CC1), U4.11 (CC1)
/CC2: J2.B5 (CC2), U4.1 (CC2), U4.14 (CC2)
/CLK_SPI: J6.5, U2.20 (IO12)
/CLK_SR: J6.11, U2.33 (IO40)
/D+: U1.4, U2.14 (IO20)
/D-: U1.6, U2.13 (IO19)
/DBNCD_0: J4.2, U2.28 (IO35)
/DBNCD_1: J4.3, U2.29 (IO36)
/DBNCD_2: J4.5, U2.31 (IO38)
/DN_IN: J2.A7 (DN1), J2.B7 (DN2), R2.1
/DP_IN: J2.A6 (DP1), J2.B6 (DP2), R3.1
/DSEL: R29.1, R31.1, TP9.1, U2.8 (IO15), U3.24 (DSEL)
/EN: C27.2, J4.8, R24.1, SW3.2, U2.3 (EN)
/EN_LS: U2.10 (IO17), U6.C2 (EN)
/GNSS_RST: J3.8, J4.1, U2.22 (IO14)
/GNSS_RX: J3.6, U2.37 (IO43)
/GNSS_TX: J3.5, U2.36 (IO44)
/GNSS_WKP: J3.7, U2.12 (IO8)
/INT_CHRG: R7.2, U2.5 (IO5), U3.7 (INT)
/INT_IMU: U2.38 (IO2), U5.14 (INT)
/INT_UCON: R9.2, R10.1, TP13.1, U2.11 (IO18), U4.5 (INT_N)
/IO41: TP5.1, U2.34 (IO41)
/IO42: TP3.1, U2.35 (IO42)
/IO48: TP7.1, U2.25 (IO48)
/LATCH_SR: J6.10, U2.23 (IO21)
/LED_EXT: J4.4, U2.30 (IO37)
/LED_IO9: R26.1, U2.17 (IO9)
/LED_IO13: R27.1, U2.21 (IO13)
/MOSI_SPI: J6.4, U2.19 (IO11)
/MSW_ON: J4.7, Q1.1 (G), R6.1
/OTG: U2.4 (IO4), U3.8 (OTG)
/SCL: J3.4, R4.1, U2.7 (IO7), U3.5 (SCL), U4.6 (SCL), U5.19 (COM1), U9.1 (SCL)
/SDA: J3.3, R5.1, U2.6 (IO6), U3.6 (SDA), U4.7 (SDA), U5.20 (COM0), U9.3 (SDA)
/SI_SR: J6.12, U2.32 (IO39)
/STAT: R25.1, R28.1, TP11.1, U2.9 (IO16), U3.4 (STAT)
/TS: R11.1, R12.2, TH1.1, U3.11 (TS)
/~CS_SPI: J6.6, U2.18 (IO10)
GND: BT1.2 (-), C1.2, C2.2, C3.2, C4.2, C5.2, C6.2, C8.2, C9.2, C10.2, C11.2, C12.2, C13.2, C14.2, C15.2, C16.2, C17.2, C18.2, C19.2, C20.2, C21.2, C22.2, C23.2, C24.1, C25.2, C26.2, C27.1, C28.1, D2.1 (K), D3.1 (K), D4.1 (K), D5.1 (K), D7.1 (K), D8.1 (K), H1.1, H2.1, H3.1, H4.1, H5.1, J1.1, J2.A1_B12 (GND), J2.B1_A12 (GND), J3.1, J3.2, J3.9, J4.6, J4.9, J5.1, J6.3, J6.9, R1.2, R8.2, R12.1, R15.1, R16.1, R18.1, R19.1, SW1.1, SW2.1, SW3.1, SW4.1, TH1.2, U1.2, U2.1 (GND), U2.40 (GND), U2.41 (GND), U3.9 (~CE), U3.17 (PGND), U3.18 (PGND), U3.25 (PGND), U4.8 (GND), U4.9 (GND), U4.15 (GND), U5.2 (GND), U5.18 (COM2), U5.25 (GNDIO), U6.C1 (GND), U7.2 (GND), U8.3 (GND), U8.4 (AGND), U9.2 (V_{SS})
unnamed: C1.1, J2.S1 (SHIELD), J2.S2 (SHIELD), J2.S3 (SHIELD), J2.S4 (SHIELD), R1.1
unnamed: C7.1, L1.1, U3.19 (SW), U3.20 (SW)
unnamed: D1.1 (K), R9.1
unnamed: D2.2 (A), R20.2
unnamed: D3.2 (A), R21.2
unnamed: D4.2 (A), R22.2
unnamed: D5.2 (A), R23.2
unnamed: D6.1 (K), R25.2
unnamed: D7.2 (A), R26.2
unnamed: D8.2 (A), R27.2
unnamed: D9.1 (K), R29.2
unnamed: JP1.1 (A), R15.2, U5.17 (COM3)
unnamed: JP2.1 (A), R16.2, U5.6 (PS0)
unnamed: JP3.1 (A), R19.2, U5.5 (PS1)
unnamed: R2.2, U1.1
unnamed: R3.2, U1.3
unnamed: C7.2, U3.21 (BTST)
unnamed: R8.1, U3.10 (ILIM)
unnamed: SW1.2, U3.12 (~QON)
unnamed: C16.1, U5.9 (CAP)
unnamed: C18.1, U5.27 (XIN32), Y1.1
unnamed: C17.1, U5.26 (XOUT32), Y1.2
unnamed: R13.1, TP1.1, U5.4 (~BOOT_LOAD_PIN)
unnamed: R14.1, SW2.2, U5.11 (~RESET)
unnamed: L2.2, U7.1 (SW)
unnamed: R17.1, R18.2, U8.6 (FB)
unnamed: L3.1, U8.2 (SW)
REGN: C9.1, R11.2, U3.22 (REGN)
USB_VBUS: C4.1, C5.1, J2.A4_B9 (VBUS), J2.B4_A9 (VBUS), R20.1, TP6.1, U1.5, U3.1 (VBUS), U4.2 (VBUS), U6.A1 (OUT_1), U6.B1 (OUT_2)
VBATT: BT1.1 (+), C8.1, J1.2, J5.2, J6.7, TP4.1, U3.13 (BAT), U3.14 (BAT)
VIN: C19.1, C21.1, L2.1, Q1.3 (D), TP14.1, U8.1 (VIN), U8.5 (EN)
VOTG: C11.1, R23.1, TP8.1, U3.23 (PMID), U6.A2 (IN_1), U6.B2 (IN_2)
VSYS: C10.1, C12.1, L1.2, Q1.2 (S), R6.2, TP2.1, U3.15 (SYS), U3.16 (SYS)

Notes on the sheet:
9-AXIS IMU
ESD PROTECTION
ARROW + 7SEG
VBATT POINTS
MOUNTING
TPS613222ADBV Step-up converter Input: 0.9-5.5V Output: 5V Current output: 1.8A Quiescent Current: 6.5 uA Switching freq.: 1.6MHz Inductor Inductance: 2.2uH Max. current: 2.1A
M3 Padded Mounting holes
Battery capacity: 1800mAh, 1C CC logic: 25uA Load switch: 1uA Boost: if LOAD 90mA then whole stage = 150mA BNO055: 15mA BQ25895M: LEDs: 50mA ESP32-S3 340mA EEPROM: 1mA Shift registers: 4uA*8 7seg + driver: 90mA Battery signalisation: 10mA TESEO LIV3R: 25mA LNA: 3.6mA TOTAL: 500-600mA
motor link aliexpress
I2C ADDR.
ESP32-S3-WROOM1
EEPROM
USB CONNECTOR
TO-DO LIST
I2C Addr.: 0x28
MAIN SW
MISC DEBUG
LED POWER
1. 2. 3. 4. 5. 6. 7.
Default Configuration of Strapping Pins Strapping Pin Default Configuration Bit Value GPIO0 Pull-up 1 GPIO3 Floating - GPIO45 Pull-down 0 GPIO46 Pull-down 0
CONNECTORS and MISC
BNO055 9 DOF Absolute IMU with intergrated sensor fusion
pinout checked
CONNECTOR LINK
USB CC LOGIC
DEBUG and MECHANICS
BATTERY
UI CONN
STEP-UP CONVERTER 5V
I2C Addr.: 0x6A
MCU and IMU
charging status
STEP-DOWN CONVERTER 3.3V
ESP32-S3 Datasheet
LOAD SWITCH
TPS565242DRLR Step down converter Input: 3-16V Output: 600mV - 7V Current output: 5A Switching freq.: 600kHz Inductor Inductance: 1.5uH Max. current: 4.7A
CHARGER DEBUG
possibly too little capacitance and indcutunce
BNO055: 0x28 EEPROM: 0x50 FUSB302 0x25 BQ2589: 0x6A GNSS: 0x3A
TESTING POINTS
I2C Addr.: 0x25
Memory: 128kbit Ma freq.: 1MHz Vin: 1.6-5.5V Access time: 450ns Max supply curr.: 1mA
RESET
POWER MANAGMENT and SOURCES
GNSS CONN.
BOOT
Typically these can be used, but you need to make sure they are not in the wrong state during boot. gpio.0 Boot Mode. Weak pullup during reset. (Boot Mode 0=Boot from Flash, 1=Download) gpio.3 JTAG Mode. Weak pull down during reset. (JTAG Config) gpio.45 SPI voltage. Weak pull down during reset. (S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
CHARGER + BMS
I2C Addr.: 0x50
Rds On = 22.7 mOhms Vds = 30 V Vgs = - 20 V, + 16 V Vgs th = 2.2 V
USB C CONNECTOR

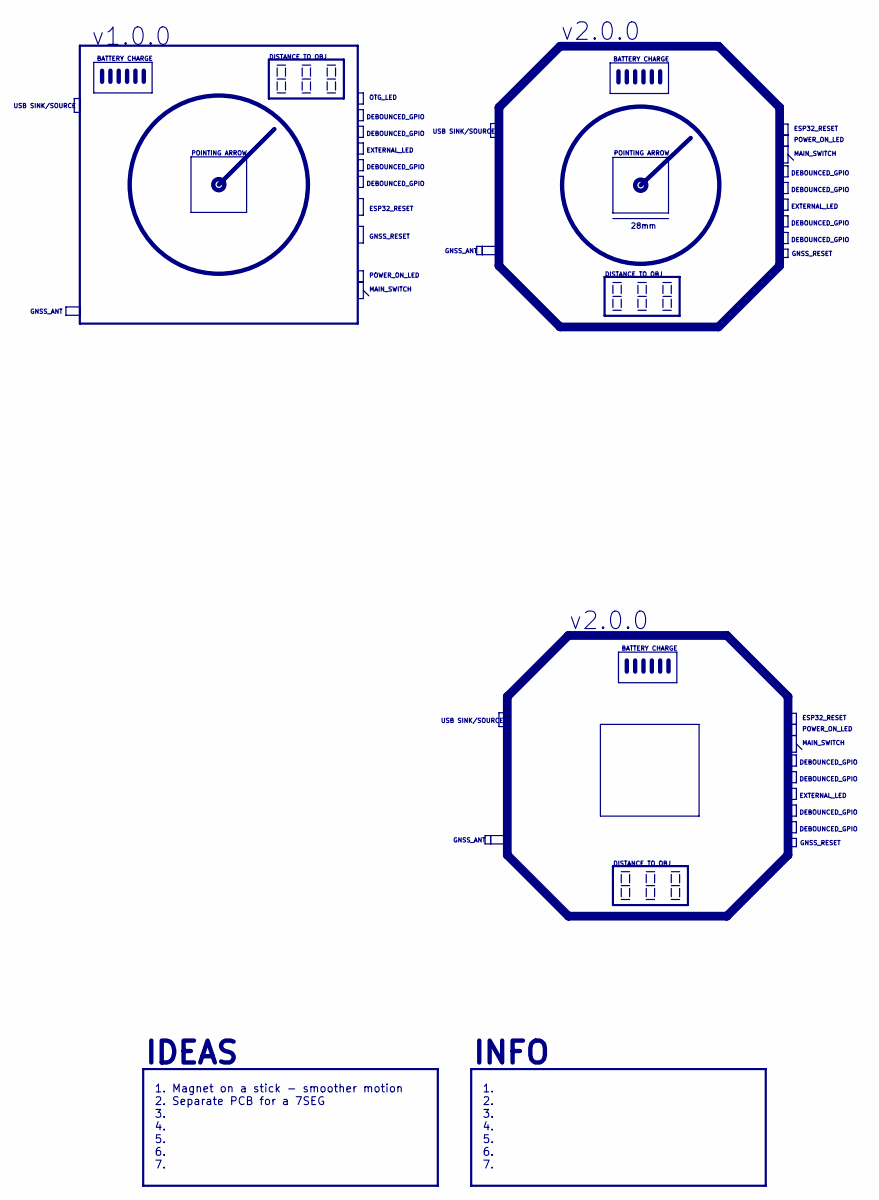
[picture p277: schematic DRAWING.kicad_sch]

Notes on the sheet:
DEBOUNCED_GPIO
28mm
USB SINK/SOURCE
EXTERNAL_LED
ESP32_RESET
IDEAS
1. 2. 3. 4. 5. 6. 7.
POINTING ARROW
GNSS_ANT
MAIN_SWITCH
DISTANCE TO OBJ
v2.0.0
v1.0.0
POWER_ON_LED
OTG_LED
BATTERY CHARGE
GNSS_RESET
INFO
1. Magnet on a stick - smoother motion 2. Separate PCB for a 7SEG 3. 4. 5. 6. 7.

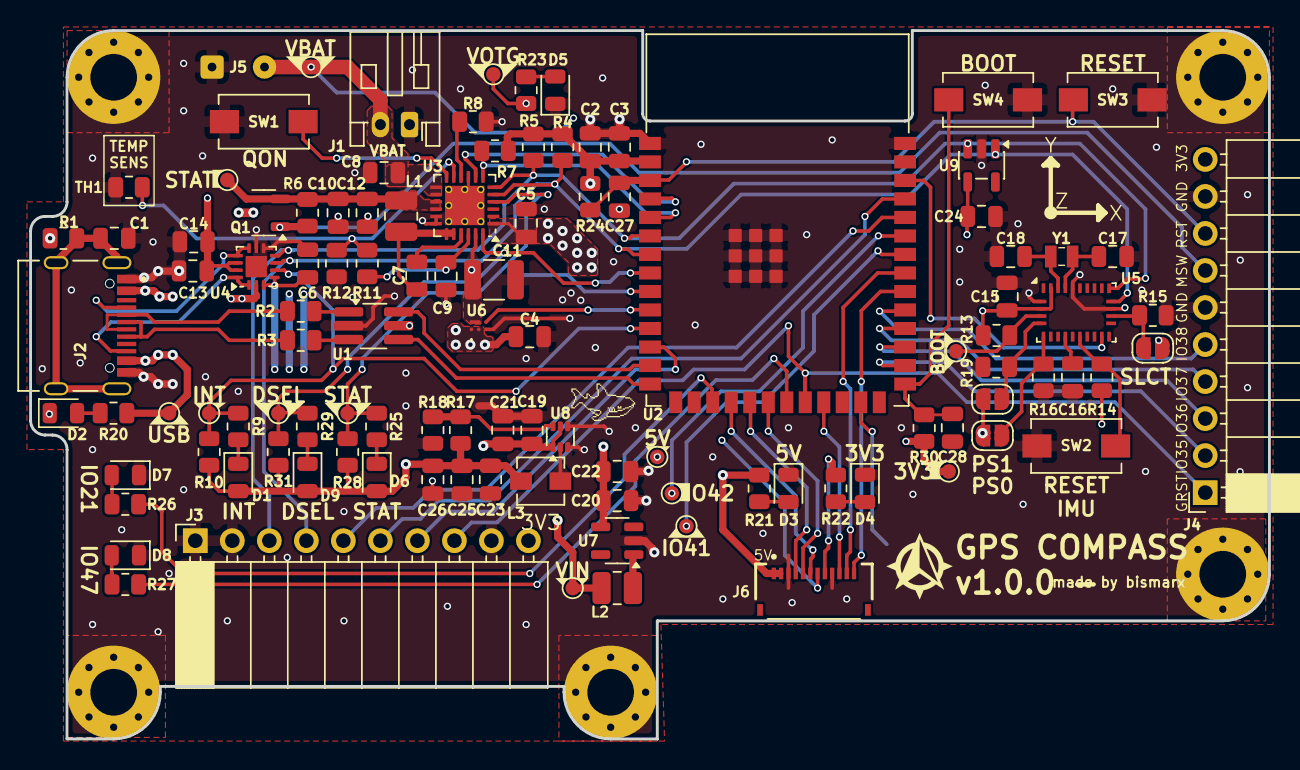
[picture p278: board _electrical/GPS-Compass/GPS-Compass.kicad_pcb from above]

Board: 4 copper layers, 85.0 x 48.6 mm, 115 parts (1 on the bottom side), 74 nets.
