bismarx-v1/GPS-Compass/_electrical/GPS-Compass_UI/GPS-Compass_UI.kicad_pcb

## KiCad design _electrical/GPS-Compass_UI/GPS-Compass_UI.kicad_pcb (2026-08-19)

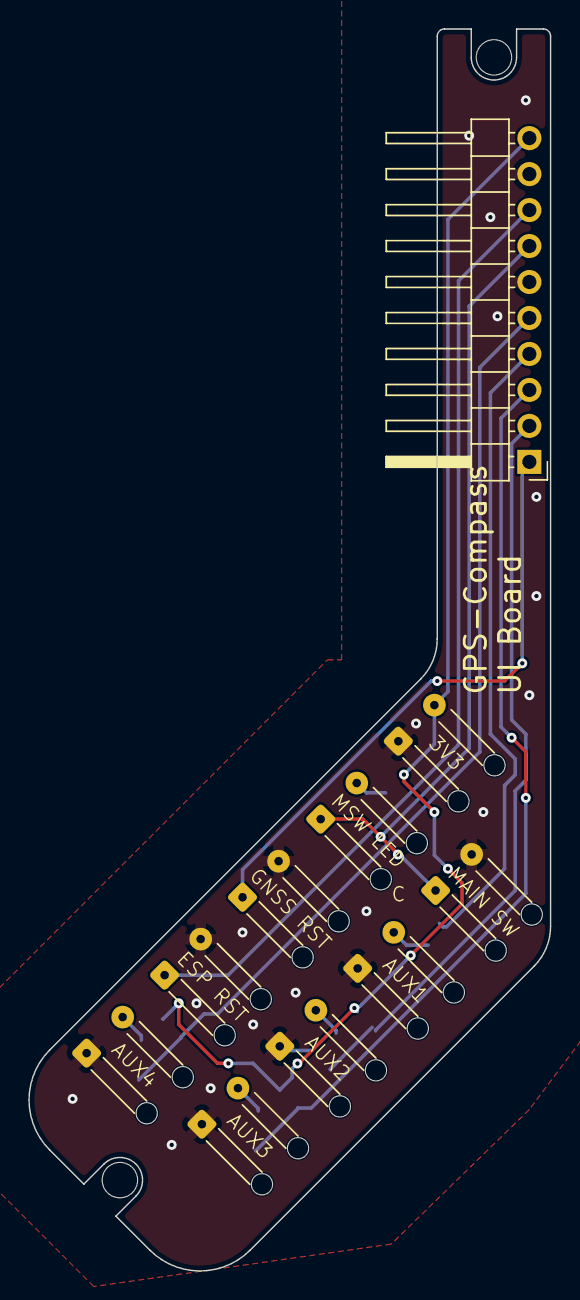
[picture p279: board GPS-Compass_UI.kicad_pcb from above]

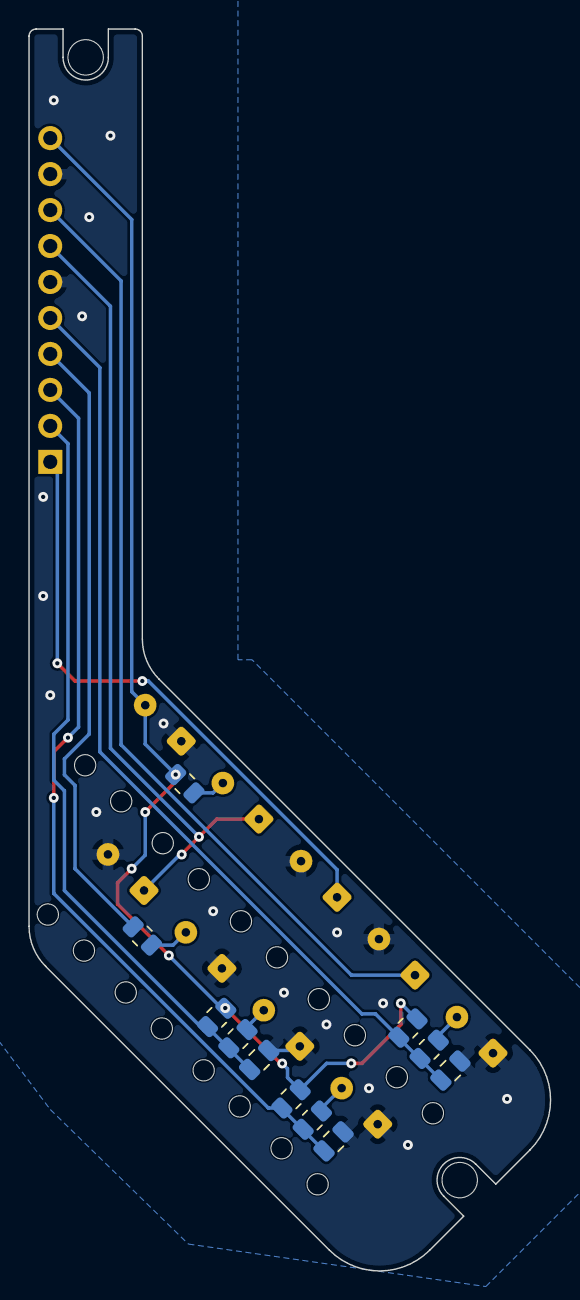
[picture p280: board GPS-Compass_UI.kicad_pcb from below]

Board: 2 copper layers, 36.8 x 87.7 mm, 23 parts (11 on the bottom side), 14 nets.

Parts:
C1: 100nF; C_0805_2012Metric
C2, C3: 100n; C_0805_2012Metric
D2, D3: LED; SolderWire-0.1sqmm_1x02_P3.6mm_D0.4mm_OD1mm_Relief
H1, H3: M2.5; MountingHole_2.5mm
J1: Conn_01x02_Pin; SolderWire-0.1sqmm_1x02_P3.6mm_D0.4mm_OD1mm_Relief
J4: Conn_01x10_Socket; PinHeader_1x10_P2.54mm_Horizontal
R1: 2.2k; R_0805_2012Metric
R3, R5, R8: 1k; R_0805_2012Metric
R4, R6, R9: 10k; R_0805_2012Metric
R7: 220R; R_0805_2012Metric
SW1: SPDT; SolderWire-0.1sqmm_1x02_P3.6mm_D0.4mm_OD1mm_Relief
SW3, SW5: RESET; SolderWire-0.1sqmm_1x02_P3.6mm_D0.4mm_OD1mm_Relief
SW4, SW6, SW7: EXT; SolderWire-0.1sqmm_1x02_P3.6mm_D0.4mm_OD1mm_Relief

Connections:
+3V3: J1.2, J4.10, R1.1, R4.2, R6.2, R9.2
/DBNCD_0: C1.2, J4.2, R3.2, R4.1
/DBNCD_1: C2.2, J4.3, R5.2, R6.1
/DBNCD_2: C3.2, J4.5, R8.2, R9.1
/DB_0: R3.1, SW4.2
/DB_1: R5.1, SW6.2
/DB_2: R8.1, SW7.2
/EN: J4.8, SW3.1
/GNSS_RST: J4.1, SW5.1
/LED_EXT: J4.4, R7.1
/MSW_ON: D2.1 (K), J4.7, SW1.1 (A)
GND: C1.1, C2.1, C3.1, D3.1 (K), J1.1, J4.6, J4.9, SW1.2 (B), SW3.2, SW4.1, SW5.2, SW6.1, SW7.1
unnamed: D2.2 (A), R1.2
unnamed: D3.2 (A), R7.2
