bismarx-v1/GPS-Compass/GPS-Compass/GPS-Compass.kicad_pcb

## KiCad design GPS-Compass/GPS-Compass.kicad_pcb (2025-09-27)

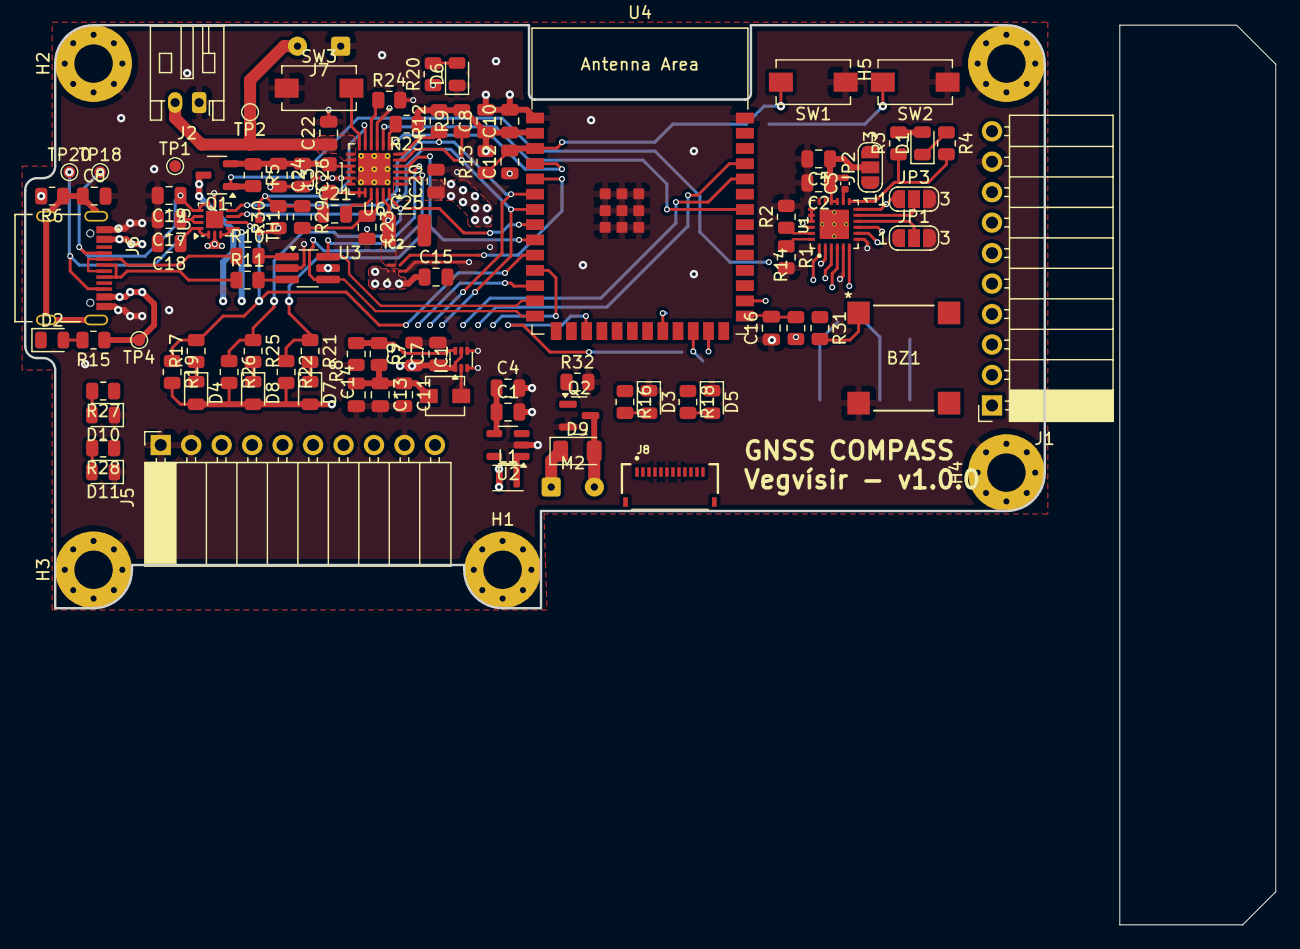
[picture p281: board GPS-Compass/GPS-Compass.kicad_pcb from above]

Board: 4 copper layers, 85.0 x 48.6 mm, 108 parts (1 on the bottom side), 79 nets.

Parts:
BZ1: Buzzer; AST0827MW-03BTRQ_MAL
C1, C2, C6, C7, C10, C11, C12, C15, C16, C17: 100n; C_0805_2012Metric
C3: 10n; C_0402_1005Metric
C4, C9, C13, C14: 22u; C_0805_2012Metric
C5, C8, C22, C24, C26: 10u; C_0805_2012Metric
C18, C19: 330p; C_0805_2012Metric
C20: 1u; C_0805_2012Metric
C21: 47n; C_0805_2012Metric
C23: 4.7u; C_0805_2012Metric
C25: 47u; C_1210_3225Metric
D1, D2, D3, D4, D5, D6, D7, D8, D10, D11: LED; LED_0805_2012Metric
D9: Schottky; D_1206_3216Metric
H1, H2, H3, H4, H5: Mounting Hole M3; MountingHole_3.2mm_M3_Pad_Via
IC1: TPS565242DRLR; SOT-563
IC2: KTS1605EUB-1-TR; KTS1605EUB1TR
J1: Conn_01x10_Socket; PinSocket_1x10_P2.54mm_Horizontal
J2: Conn_01x02_Pin; JST_PH_S2B-PH-K_1x02_P2.00mm_Horizontal
J3: Motor_conn; JST_XH_S4B-XH-SM4-TB_1x04-1MP_P2.50mm_Horizontal
J5: 01x10; PinSocket_1x10_P2.54mm_Horizontal
J6: USB_TypeC; HRO_TYPE-C-31-M-12
J7: Conn_01x02_Pin; SolderWire-0.1sqmm_1x02_P3.6mm_D0.4mm_OD1mm
J8: FFC2B28-12-G; GCT_FFC2B28-12-G
JP1, JP2, JP3: Jumper; SolderJumper-3_P1.3mm_Open_RoundedPad1.0x1.5mm_NumberLabels
L1: 2,2u; L_Murata_DFE201610P
L2: 1.5u; L_Vishay_IHLP-1212
L3: 2.2uH; L_Walsin_WLFM201609x
M2: Motor_DC; SolderWire-0.1sqmm_1x02_P3.6mm_D0.4mm_OD1mm
Q1: SI2393DS; SOT-23-3
Q2: DMG3406L; SOT-23
R1, R2: R(SET); R_0805_2012Metric
R3, R5, R8, R9, R12, R13, R14, R19, R22, R23, R26, R32: 10k; R_0805_2012Metric
R4, R17: 2.2K; R_0805_2012Metric
R6: 100k; R_0805_2012Metric
R7: 45k; R_0805_2012Metric
R10, R11: 15R; R_0805_2012Metric
R15, R16, R18, R20, R21, R25: 2.2k; R_0805_2012Metric
R24: RLIM; R_0805_2012Metric
R27, R28: 220R; R_0805_2012Metric
R29: 5.23k; R_0805_2012Metric
R30: 30.1k; R_0805_2012Metric
R31: 0R; R_0805_2012Metric
SW1: RESET; SW_SPST_EVQPE1
SW2: BOOT; SW_SPST_EVQPE1
SW3: SHIP-MODE; SW_SPST_EVQPE1
TH1: 10k NTC; R_0402_1005Metric
TP1, TP2, TP4, TP18, TP20: TestPoint; TestPoint_Pad_D1.0mm
U1: DRV8834RGER; DRIVER_DRV8834RGER
U2: TPS613222ADBV; SOT-23-5
U3: USBLC6-2SC6; TSOT-23-6_HandSoldering
U4: ESP32-S3-WROOM-1
U5: FUSB302B11MPX; WQFN-14-1EP_2.5x2.5mm_P0.5mm_EP1.45x1.45mm
U6: BQ25895RTW; Texas_RTW_WQFN-24-1EP_4x4mm_P0.5mm_EP2.7x2.7mm_ThermalVias

Connections:
+3V3: C8.1, C10.1, C11.1, C13.1, C14.1, C17.1, D1.2 (A), D4.2 (A), D7.2 (A), D8.2 (A), D9.1 (K), J1.10, J5.10, JP1.1 (A), JP2.1 (A), JP3.1 (A), L2.2, M2.1 (+), R3.2, R7.2, R9.2, R12.2, R13.2, R14.2, R18.1, R19.2, R22.2, R23.1, R26.2, U1.12 (CONFIG), U1.22 (NSLEEP), U4.2 (3V3), U5.3 (VDD), U5.4 (VDD), U5.12 (VCONN), U5.13 (VCONN)
+5V: C1.1, C4.1, J8.10, J8.11, J8.12, JP2.3 (B), R16.1, U2.4 (VOUT)
/BOOT: C16.2, R14.1, SW2.2, U4.27 (IO0)
/CC1: C19.1, J6.A5 (CC1), TP18.1, U5.10 (CC1), U5.11 (CC1)
/CC2: C18.1, J6.B5 (CC2), TP20.1, U5.1 (CC2), U5.14 (CC2)
/CLK: J8.7, U4.38 (IO2)
/D+: U3.4, U4.14 (IO20), U6.2 (D+)
/D-: U3.6, U4.13 (IO19), U6.3 (D-)
/DBNCD_0: J1.2, U4.29 (IO36)
/DBNCD_1: J1.3, U4.30 (IO37)
/DBNCD_2: J1.6, U4.32 (IO39)
/DBNCD_3: J1.7, U4.33 (IO40)
/DIR: U1.9 (DIR/BPHASE), U4.25 (IO48)
/DN_IN: J6.A7 (DN1), J6.B7 (DN2), R10.1
/DP_IN: J6.A6 (DP1), J6.B6 (DP2), R11.1
/DSEL: R25.1, R26.1, U4.8 (IO15), U6.24 (DSEL)
/EN: C12.2, J1.8, R13.1, SW1.2, U4.3 (EN)
/EN_LS: IC2.C2 (EN), U4.5 (IO5)
/GNSS_RST: J1.1, J5.8, U4.17 (IO9)
/GNSS_RX: J5.6, U4.37 (IO43)
/GNSS_TX: J5.5, U4.36 (IO44)
/GNSS_WKP: J5.7, U4.11 (IO18)
/INT_CHRG: R23.2, U4.4 (IO4), U6.7 (INT)
/INT_UCON: R17.2, R19.1, U4.10 (IO17), U5.5 (INT_N)
/LED_EXT: J1.4, U4.31 (IO38)
/LED_IO13: R28.1, U4.21 (IO13)
/LED_IO21: R27.1, U4.23 (IO21)
/M0: JP1.2 (C), U1.10 (M0/APHASE)
/M1: JP3.2 (C), U1.11 (M1)
/MOSI: J8.9, U4.35 (IO42)
/MSW_ON: J1.5, Q1.1 (G), R5.2
/NFAULT: R3.1, R4.2, U1.13 (NFAULT), U4.28 (IO35)
/OTG: U4.34 (IO41), U6.8 (OTG)
/PWM_BZ: R31.1, U4.12 (IO8)
/PWM_HPTCS: Q2.1 (G), R32.1, U4.22 (IO14)
/SCL: J5.4, R9.1, U4.7 (IO7), U5.6 (SCL), U6.5 (SCL)
/SDA: J5.3, R12.1, U4.6 (IO6), U5.7 (SDA), U6.6 (SDA)
/STAT: R21.1, R22.1, U4.9 (IO16), U6.4 (STAT)
/STEP: U1.8 (STEP/BENBL), U4.24 (IO47)
/TS: R29.1, R30.2, TH1.1, U6.11 (TS)
/~CS: J8.5, U4.39 (IO1)
GND: BZ1.2 (-), C1.2, C2.2, C4.2, C5.2, C6.2, C7.2, C8.2, C9.2, C10.2, C11.2, C12.1, C13.2, C14.2, C15.2, C16.1, C17.2, C18.2, C19.2, C20.2, C22.2, C23.2, C24.2, C25.2, C26.2, D2.1 (K), D3.1 (K), D5.1 (K), D6.1 (K), D10.1 (K), D11.1 (K), H1.1, H2.1, H3.1, H4.1, H5.1, IC1.3 (GND), IC1.4 (AGND), IC2.C1 (GND), J1.9, J2.1, J5.1, J5.2, J5.9, J6.A1_B12 (GND), J6.B1_A12 (GND), J7.1, J8.4, J8.6, J8.8, JP1.3 (B), JP3.3 (B), Q2.2 (S), R1.2, R2.2, R6.2, R8.1, R24.2, R30.1, R32.2, SW1.1, SW2.1, SW3.1, TH1.2, U1.2 (AISEN), U1.5 (BISEN), U1.7 (NENBL/AENBL), U1.18 (GND), U1.25 (GND), U1.25.1 (GND), U1.25.2 (GND), U1.25.3 (GND), U1.25.4 (GND), U1.25.5 (GND), U2.2 (GND), U3.2, U4.1 (GND), U4.40 (GND), U4.41 (GND), U5.8 (GND), U5.9 (GND), U5.15 (GND), U6.9 (~CE), U6.17 (PGND), U6.18 (PGND), U6.25 (PGND)
unnamed: BZ1.1 (+), R31.2
unnamed: C6.1, J6.S1 (SHIELD), J6.S2 (SHIELD), J6.S3 (SHIELD), J6.S4 (SHIELD), R6.1
unnamed: C21.1, L3.1, U6.19 (SW), U6.20 (SW)
unnamed: D1.1 (K), R4.1
unnamed: D2.2 (A), R15.2
unnamed: D3.2 (A), R16.2
unnamed: D4.1 (K), R17.1
unnamed: D5.2 (A), R18.2
unnamed: D6.2 (A), R20.2
unnamed: D7.1 (K), R21.2
unnamed: D8.1 (K), R25.2
unnamed: D9.2 (A), M2.2 (-), Q2.3 (D)
unnamed: D10.2 (A), R27.2
unnamed: D11.2 (A), R28.2
unnamed: IC1.6 (FB), R7.1, R8.2
unnamed: IC1.2 (SW), L2.1
unnamed: J3.1, U1.4 (BOUT2)
unnamed: J3.2, U1.6 (BOUT1)
unnamed: J3.3, U1.3 (AOUT2)
unnamed: J3.4, U1.1 (AOUT1)
unnamed: R10.2, U3.1
unnamed: R11.2, U3.3
unnamed: R1.1, U1.24 (ADECAY)
unnamed: R2.1, U1.23 (BDECAY)
unnamed: C3.1, U1.14 (VCP)
unnamed: L1.2, U2.1 (SW)
unnamed: C21.2, U6.21 (BTST)
unnamed: R24.1, U6.10 (ILIM)
unnamed: SW3.2, U6.12 (~QON)
REGN: C23.1, R29.2, U6.22 (REGN)
USB_VBUS: C15.1, C20.1, IC2.A1 (OUT_1), IC2.B1 (OUT_2), J6.A4_B9 (VBUS), J6.B4_A9 (VBUS), R15.1, TP4.1, U3.5, U5.2 (VBUS), U6.1 (VBUS)
VBATT: C22.1, J2.2, J7.2, TP2.1, U6.13 (BAT), U6.14 (BAT)
VIN: C7.1, C9.1, IC1.1 (VIN), IC1.5 (EN), L1.1, Q1.3 (D)
VM: C2.1, C3.2, C5.1, JP2.2 (C), U1.15 (VM), U1.16 (VM)
VOTG: C25.1, IC2.A2 (IN_1), IC2.B2 (IN_2), R20.1, U6.23 (PMID)
VREFO: U1.19 (AVREF), U1.20 (BVREF), U1.21 (VREFO)
VSYS: C24.1, C26.1, L3.2, Q1.2 (S), R5.1, TP1.1, U6.15 (SYS), U6.16 (SYS)
