bismarx-v1/GPS-Compass/_code/_Final/GPS-Compass_main/include/SYSTEM_STATE.h

#ifndef SYSTEM_STATE_H
#define SYSTEM_STATE_H

//Code edited with the help of AI 2026-03-05

struct HardwareData {
    float vbat = 0;
    float ichg = 0;
    float temp = 0;
    bool webServerEnabled = false;
    bool lastButtonState = HIGH; // Moved here
};

struct UIState {
    unsigned long lastNorthToggle = 0;
    const unsigned long NORTH_BLINK_INTERVAL = 500;
    bool northLedState = true;
};

struct Position {
    float lat = 0;
    float lon = 0;
};

struct MonitorState {
    char mode = 'e';
    unsigned long lastPrint = 0;
    const unsigned long INTERVAL = 3000;
};

// Blink Control
bool triggerBlink = false;
int blinkStep = 0;           // 3 blinks = 6 state changes (ON-OFF-ON-OFF-ON-OFF)
unsigned long lastBlinkStep = 0;
const int BLINK_DURATION = 150; // ms per blink state

// Declarations (Promises to the compiler)
extern HardwareData sys;
extern Position target_position;
extern MonitorState mon;
extern UIState ui;

#endif
