bismarx-v1/GPS-Compass/_code/_Final/GPS-Compass_Webserver/src/main.cpp

#include <WiFi.h>
#include <Arduino.h>
#include "webpage.h"

//WiFi Access Point credentials
const char* ssid     = "GPS-Compass";
const char* password = "bismarx123";

float lat, lon;

WiFiServer server(80);

const int LED_PIN = 2;

void setup() {
  Serial.begin(115200);
  delay(2000);
  Serial.println("Booting");

  pinMode(LED_PIN, OUTPUT);
  digitalWrite(LED_PIN, LOW); //sets the LED off on boot
  WiFi.softAP(ssid, password); //this thingy creates the access point

  Serial.print("AP IP address: ");
  Serial.println(WiFi.softAPIP()); //this thingy prints IP adress

  server.begin();
}

void parseCoords(const char* request, float& lat, float& lon) {
  
    lat = 0.0f;
    lon = 0.0f;

    const char* latPointer = strstr(request, "lat=");
    const char* lonPointer = strstr(request, "lon=");
    if (latPointer) {
        latPointer += 4;                // skip "lat="
        lat = strtof(latPointer, nullptr);
    }

    if (lonPointer) {
        lonPointer += 4;                // skip "lon="
        lon = strtof(lonPointer, nullptr);
    }
}

void loop() {
  WiFiClient client = server.available();

  if (!client) return;

  String request = "";

  while (client.connected()) {
    if (client.available()) {
      char c = client.read();
      request += c;
      if (c == '\n') break;   // First line is enough
    }
  }

  /* ===================== LED CONTROL ===================== */
  if (request.indexOf("GET /led?state=1") >= 0) {
    digitalWrite(LED_PIN, HIGH);
    Serial.println("LED ON");
  }
  if (request.indexOf("GET /led?state=0") >= 0) {
    digitalWrite(LED_PIN, LOW);
    Serial.println("LED OFF");
  }

  // Only parse and print coordinates when the /coords endpoint is requested
  if (request.indexOf("GET /coords?") >= 0) {
    parseCoords(request.c_str(), lat, lon);
    Serial.println("Received Coordinates:");
    Serial.print("Latitude: ");
    Serial.println(lat, 4);

    Serial.print("Longitude: ");
    Serial.println(lon, 4);
  }
  /* ===================== HTTP RESPONSE ===================== */
  client.println("HTTP/1.1 200 OK");
  client.println("Content-Type: text/html; charset=UTF-8");
  client.println("Connection: close");
  client.println();
  client.println(webpage);


  client.stop();
}
