bismarx-v1/GPS-Compass/(commit log)

2025-07-18 Schematic update
    [CONNECTIVITY.kicad_sch, DEBUG.kicad_sch, GNSS.kicad_sch, GPS-Compass.kicad_pcb, GPS-Compass.kicad_sch, MCU.kicad_sch, MECHANICAL.kicad_sch, POINTER.kicad_sch]
2025-07-25 gps upd
    [DEBUG.kicad_sch, DRAWING.kicad_sch, GNSS.kicad_sch, GPS-Compass-casing.0004.ipt, GPS-Compass-casing.0005.ipt, GPS-Compass-casing.ipt, GPS-Compass.kicad_pcb, GPS-Compass.kicad_sch]
2025-07-29 pcb update
    [GPS-Compass.kicad_pcb]
2025-07-30 Finished PCB layout on edgecuts
    [GPS-Compass.kicad_pcb, PCB_layout-BodySketch.dxf, PCB_layout.FCStd]
2025-08-06 Buzzer footprint edit
2025-08-12 footprint for different project
2025-08-17 GNSS layout
    [DEBUG.kicad_sch, GNSS.kicad_sch, GPS-Compass.kicad_pcb, GPS-Compass.kicad_sch, GPS-Compass_GNSS.kicad_pcb, GPS-Compass_GNSS.kicad_sch, MCU.kicad_sch, MECHANICAL.kicad_sch]
2025-08-19 GNSS update
    [GPS-Compass_GNSS.kicad_pcb, GPS-Compass_GNSS.kicad_sch]
2025-08-21 gnss module
    [GPS-Compass_GNSS.kicad_pcb, GPS-Compass_GNSS.kicad_sch]
2025-08-24 GNSS and Mian ocb
    [GPS-Compass.kicad_pcb, GPS-Compass_7seg.kicad_pcb, GPS-Compass_GNSS.kicad_pcb, GPS-Compass_GNSS.kicad_sch, PCB_layout.FCStd]
2025-08-24 soldermask via fencing
    [GPS-Compass_GNSS.kicad_pcb, GPS-Compass_GNSS.kicad_sch, PCB_layout-BodySketch.dxf, PCB_layout.FCStd]
2025-08-26 changed socket to header for breadboard pluggablity
    [GPS-Compass_GNSS.kicad_pcb, GPS-Compass_GNSS.kicad_sch]
2025-08-28 schematric remake
    [CONNECTIVITY.kicad_sch, DEBUG.kicad_sch, DRAWING.kicad_sch, GPS-Compass.kicad_pcb, GPS-Compass.kicad_sch, GPS-Compass_GNSS.kicad_pcb, GPS-Compass_GNSS.kicad_sch, MCU.kicad_sch]
2025-08-29 schematic remake
    [GPS-Compass.kicad_pcb, GPS-Compass.kicad_sch]
2025-08-30 new pcb
    [GPS-Compass.kicad_sch, GPS-Compass_UI.kicad_pcb, GPS-Compass_UI.kicad_sch]
2025-09-01 UI layout and routing
    [GPS-Compass.kicad_sch, GPS-Compass_7seg.kicad_pcb, GPS-Compass_7seg.kicad_sch, GPS-Compass_UI.kicad_pcb, GPS-Compass_UI.kicad_sch, PCB_layout-BodySketch.dxf, PCB_layout.FCStd]
2025-09-02 GPS Compass - schematic
    [DRAWING.kicad_sch, GPS-Compass.kicad_sch, GPS-Compass_7seg.kicad_sch, GPS-Compass_GNSS.kicad_pcb, GPS-Compass_UI.kicad_pcb, GPS-Compass_UI.kicad_sch]
2025-09-02 layout updates
    [DRAWING.kicad_sch, GPS-Compass.kicad_sch]
2025-09-09 will be remaking the charger probably
    [GPS-Compass.kicad_sch, PCB_layout-BodySketch.dxf, PCB_layout.FCStd]
2025-09-10 new IC charger
    [DRAWING.kicad_sch, GPS-Compass.kicad_pcb, GPS-Compass.kicad_sch]
2025-09-10 new usb charger
    [GPS-Compass.kicad_pcb, GPS-Compass.kicad_sch]
2025-09-11 UI changes
    [DRAWING.kicad_sch, GPS-Compass.kicad_pcb, GPS-Compass.kicad_sch, GPS-Compass_UI.kicad_pcb, GPS-Compass_UI.kicad_sch]
2025-09-12 no chsanges
    [DRAWING.kicad_sch, GPS-Compass.kicad_sch]
2025-09-18 im to tired to write this shi
    [GPS-Compass.kicad_pcb, GPS-Compass.kicad_sch]
2025-09-19 cannot bother
    [GPS-Compass.kicad_pcb, GPS-Compass.kicad_sch]
2025-09-22 i think im depressed again
    [DRAWING.kicad_sch, GPS-Compass.kicad_pcb, GPS-Compass.kicad_sch, GPS-Compass_GNSS.kicad_pcb, GPS-Compass_UI.kicad_pcb, GPS-Compass_UI.kicad_sch]
2025-09-27 changes s
    [GPS-Compass.kicad_pcb, GPS-Compass.kicad_sch, GPS-Compass_7seg.kicad_pcb, GPS-Compass_7seg.kicad_sch, PCB_layout.FCStd]
2025-09-28 pcb updates
    [GPS-Compass.kicad_sch, GPS-Compass_GNSS.kicad_pcb, PCB_layout.FCStd]
2025-09-29 UI PCB
    [GPS-Compass_UI.kicad_pcb, PCB_layout.FCStd]
2025-10-01 UI board updates
    [GPS-Compass_UI.kicad_pcb, GPS-Compass_UI.kicad_sch, PCB_layout-BodySketch.dxf, PCB_layout.FCStd]
2025-10-11 To do list updated
    [GPS-Compass.kicad_sch]
2025-10-19 schematic updaete
2025-10-27 arrow pcb update
    [GPS-Compass_Arrow.kicad_pcb, GPS-Compass_Arrow.kicad_sch]
2025-11-03 arrow pcb
    [GPS-Compass_Arrow.kicad_pcb, GPS-Compass_Arrow.kicad_sch, PCB_layout-BodySketch.dxf, PCB_layout.FCStd]
2025-11-05 arrow pcp updates
    [GPS-Compass_Arrow.kicad_pcb, GPS-Compass_Arrow.kicad_sch]
2025-11-06 arrowpcb update
    [GPS-Compass_Arrow.kicad_pcb, GPS-Compass_Arrow.kicad_sch]
2025-11-06 main pcb update
2025-11-07 main pcb and arrow updatws
    [GPS-Compass_Arrow.kicad_pcb, GPS-Compass_Arrow.kicad_sch]
2025-11-09 updates on different boards
    [GPS-Compass_Arrow.kicad_pcb, GPS-Compass_GNSS.kicad_pcb, GPS-Compass_GNSS.kicad_sch, GPS-Compass_UI.kicad_pcb, GPS-Compass_UI.kicad_sch, PCB_layout-BodySketch.dxf, PCB_layout.FCStd]
2025-11-11 3D model
    [GPS-Compass_GNSS.kicad_pcb, GPS-Compass_box.0001.ipt, GPS-Compass_box.ipt]
2025-11-11 folder reloaction
    [GPS-Compass_box.0001.ipt, GPS-Compass_box.ipt, PCB_layout-BodySketch.3mf, PCB_layout-BodySketch.dxf, PCB_layout.FCStd]
2025-11-11 3d model update
    [GPS-Compass_GNSS.kicad_pcb, GPS-Compass_UI.kicad_pcb, GPS-Compass_box.0001.ipt, GPS-Compass_box.0003.ipt, GPS-Compass_box.ipt]
2025-11-13 Shift register code
    [GPS-Compass_box.0004.ipt, GPS-Compass_box.0005.ipt, GPS-Compass_box.ipt]
2025-11-17 bpx update and new top part started
    [GPS-Compass_Arrow.kicad_pcb, GPS-Compass_box.0006.ipt, GPS-Compass_box.0007.ipt, GPS-Compass_box.ipt, GPS-Compass_top.0001.ipt, GPS-Compass_top.ipt]
2025-11-18 3D updates
    [GPS-Compass_Arrow.kicad_pcb, GPS-Compass_box.0007.ipt, GPS-Compass_box.0008.ipt, GPS-Compass_box.ipt, GPS-Compass_top.0001.ipt, GPS-Compass_top.0004.ipt, GPS-Compass_top.ipt]
2025-11-19 main pcb updates
2025-11-19 generated step files
    [GPS-Compass_Arrow.kicad_pcb, GPS-Compass_GNSS.step, GPS-Compass_UI.kicad_pcb, GPS-Compass_UI.step]
2025-11-19 3d and PCB
    [1S-8S part1.ipt, 1S-8S part10.ipt, 1S-8S part11.ipt, 1S-8S part12.ipt, 1S-8S part13.ipt, 1S-8S part14.ipt, 1S-8S part15.ipt, 1S-8S part16.ipt]
2025-11-20 PCB and 3D updates
    [GPS-Compass_UI.kicad_pcb, GPS-Compass_assembly.0014.iam, GPS-Compass_assembly.0020.iam, GPS-Compass_assembly.iam, GPS-Compass_box.0012.ipt, GPS-Compass_box.0014.ipt, GPS-Compass_box.ipt, PCB_layout.FCStd]
2025-11-27 new renders and 3d updat4ws
    [Copper Shell LED Indicator Light KL0624.SLDPRT, Copper Shell LED Indicator Light KL0624.ipt, GPS-Compass_GNSS.kicad_pcb, GPS-Compass_GNSS.kicad_sch, GPS-Compass_box.0019.ipt, GPS-Compass_box.0022.ipt, GPS-Compass_box.ipt, GPS-Compass_name.0002.ipt]
2025-12-01 production updates
    [GPS-Compass_Arrow.kicad_pcb, GPS-Compass_GNSS.kicad_pcb, GPS-Compass_UI.kicad_pcb, GPS-Compass_top.0011.ipt, GPS-Compass_top.0012.ipt, GPS-Compass_top.ipt, antena.0001.ipt, antena.SLDPRT]
2025-12-03 moved files
    [SR_with_latch_example.circ]
2025-12-05 BOM update
    [GPS-Compass.kicad_sch, GPS-Compass.xlsx, GPS-Compass_Arrow_BOM.xlsx, GPS-Compass_BOM.xlsx, GPS-Compass_GNSS.kicad_sch, GPS-Compass_GNSS_BOM.xlsx, GPS-Compass_Main_BOM.xlsx, SUMEC_MK_V.xlsx]
2025-12-09 pls dont break
    [GPS-Compass.kicad_sch, GPS-Compass_Arrow_BOM.xlsx, GPS-Compass_Arrow_MOUSER.xls, GPS-Compass_GNSS.kicad_pcb, GPS-Compass_GNSS_BOM.xlsx, GPS-Compass_GNSS_MOUSER.xls, GPS-Compass_Main_BOM.xlsx, GPS-Compass_Main_MOUSER.xls]
2025-12-09 new renders
    [GPS-Compass_Arrow.kicad_pcb, GPS-Compass_GNSS.kicad_pcb, GPS-Compass_box.0026.ipt, GPS-Compass_box.0027.ipt, GPS-Compass_box.ipt]
2025-12-11 arrow pcb new desing
    [GPS-Compass_Arrow.kicad_pcb]
2025-12-11 lots of updates
    [GPS-Compass_Arrow.kicad_pcb, GPS-Compass_GNSS.kicad_pcb]
2025-12-20 cleanup of stuff
    [Batton001.ipt, CONNECTIVITY.kicad_sch, Copper Shell LED Indicator Light KL0624.SLDPRT, Copper Shell LED Indicator Light KL0624.ipt, DEBUG.kicad_sch, DODGE INSERT M3X4(D5-Dill4.8).SLDPRT, DODGE INSERT M3X4(D5-Dill4.8).ipt, DRAWING.kicad_sch]
2025-12-30 GPIO map and QR code for the assembly
    [GPS-Compass_box.0032.ipt, GPS-Compass_box.0034.ipt, GPS-Compass_box.ipt, combined-1767114910597.ipt]
2026-01-08 renders, code
    [GPS-Compass.kicad_sch]
2026-01-09 af wd
    [GPS-Compass.kicad_sch, GPS-Compass_box.0034.ipt, GPS-Compass_box.0035.ipt, GPS-Compass_box.ipt, combined-1767114910597.ipt]
2026-01-13 new code update
    [GPS-Compass_Arrow.kicad_pcb]
2026-01-15 charger config update
2026-01-17 CODE 3D
    [GPS-Compass_box.0035.ipt, GPS-Compass_box.0037.ipt, GPS-Compass_box.ipt]
2026-01-18 3D update
    [GPS-Compass_box.0041.ipt, GPS-Compass_box.0042.ipt, GPS-Compass_box.ipt, GPS-Compass_top.0019.ipt, GPS-Compass_top.0020.ipt, GPS-Compass_top.ipt]
2026-01-20 3d update
    hopefully final
    [GPS-Compass_box.0043.ipt, GPS-Compass_box.0045.ipt, GPS-Compass_box.ipt, GPS-Compass_top.0021.ipt, GPS-Compass_top.0022.ipt, GPS-Compass_top.ipt]
2026-02-02 I2C scanner
2026-02-02 IMU test
    [GPS-Compass.kicad_sch]
2026-02-15 Code update, schematic plots, text update
    [GPS-Compass.kicad_sch, GPS-Compass_Arrow.kicad_sch, GPS-Compass_GNSS.kicad_sch, GPS-Compass_GNSS_BOM.xlsx, GPS-Compass_Main_BOM.xlsx]
2026-02-19 I2C GNSS update
    [GPS-Compass.kicad_sch]
2026-02-20 IMU visualizer
    [cube.obj]
2026-02-20 IMU viz
    [model.obj]
2026-02-23 code updates
    [GPS-Compass_Arrow.kicad_pcb, cube.obj, model.obj]
2026-03-01 IMU changed to quaternion
2026-03-01 moved in different folder
    [Batton001.ipt, CONNECTIVITY.kicad_sch, Copper Shell LED Indicator Light KL0624.0001.ipt, Copper Shell LED Indicator Light KL0624.SLDPRT, Copper Shell LED Indicator Light KL0624.ipt, DEBUG.kicad_sch, DODGE INSERT M3X4(D5-Dill4.8).SLDPRT, DODGE INSERT M3X4(D5-Dill4.8).ipt]
2026-03-05 IMU update
2026-03-06 final edits before handing in
    [Batton001.ipt, CONNECTIVITY.kicad_sch, Copper Shell LED Indicator Light KL0624.0001.ipt, Copper Shell LED Indicator Light KL0624.SLDPRT, Copper Shell LED Indicator Light KL0624.ipt, DEBUG.kicad_sch, DODGE INSERT M3X4(D5-Dill4.8).SLDPRT, DODGE INSERT M3X4(D5-Dill4.8).ipt]
2026-03-29 new 3d updates for user manual
    [GPS-Compass_manua_exportl.dwg, GPS-Compass_manual_buttons.dwg, GPS-Compass_manual_usb.dwg]
2026-04-15 renders, model updates, presentation
    [Copper Shell LED Indicator Light KL0624.0001.ipt, Copper Shell LED Indicator Light KL0624.0002.ipt, Copper Shell LED Indicator Light KL0624.ipt, GPS-Compass_top.0025.ipt, GPS-Compass_top.0028.ipt, GPS-Compass_top.ipt, antena.0001.ipt, antena.0002.ipt]
2026-05-06 New IMU visualisation code
    [DRAWING.kicad_sch, GPS-Compass.kicad_sch]
2026-08-19 added DMP folder
    I will sort it out later, most definitely
    [GPS-Compass.kicad_pcb, GPS-Compass.kicad_sch, GPS-Compass_UI.kicad_pcb, popovsa22_vykaz.xlsx]
2026-08-27 minor cleanup of files
    [CONNECTIVITY.kicad_sch, DEBUG.kicad_sch, GPS-Compass.kicad_pcb, GPS-Compass.kicad_sch, GPS-Compass_UI.step, MCU.kicad_sch, MECHANICAL.kicad_sch, POINTER.kicad_sch]
