bismarx-v1/GPS-Compass/_media/Project_pictures/outside.jpg

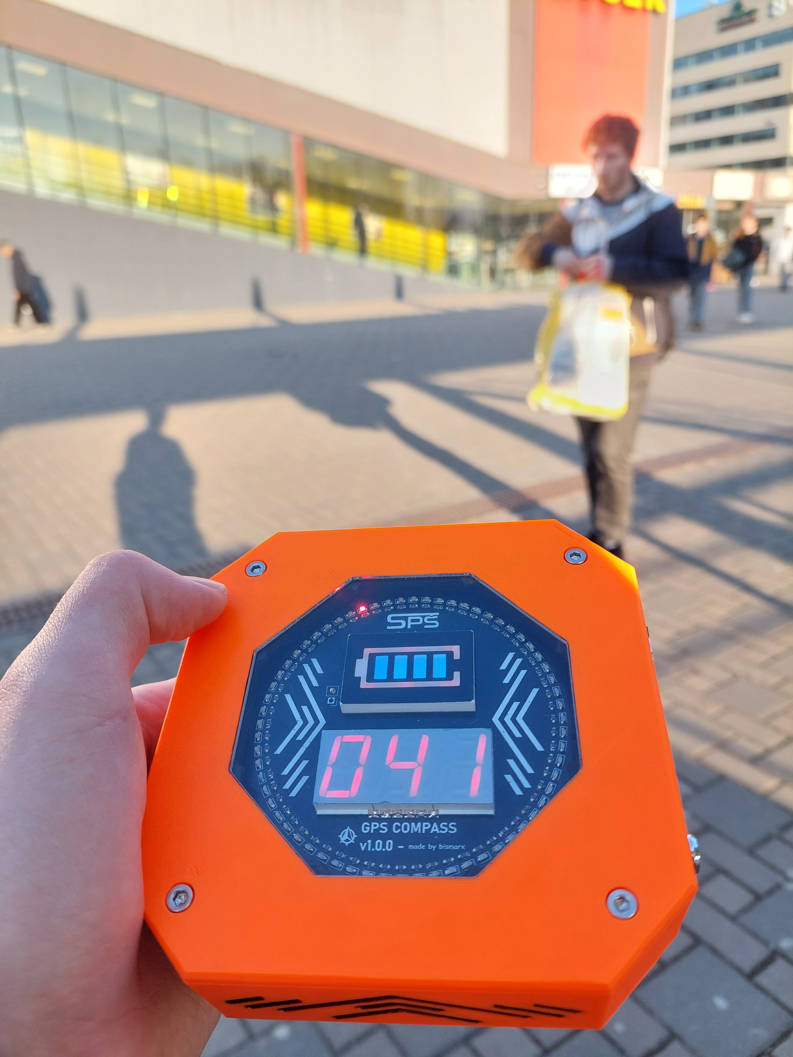
_media/Project_pictures/outside.jpg
